dkittell/robotics-code-library/CAD/FTC-FRC/Thingiverse/NotUsing/Aluminiumprofile_Slider___linear_guide_2572864/images/nut8_60x30_100.jpg

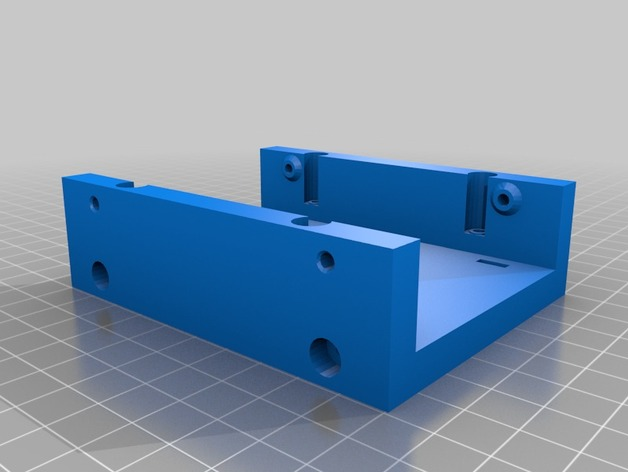
CAD/FTC-FRC/Thingiverse/NotUsing/Aluminiumprofile_Slider___linear_guide_2572864/images/nut8_60x30_100.jpg
