dkittell/robotics-code-library/README.md

# robotics-code-library
Library of code from various years of projects.
