dkittell/robotics-code-library/CAD/FRC/stl/FRC Air Tank Mount - 685037/README.txt

FRC Air Tank Mount by team375 on Thingiverse: https://www.thingiverse.com/thing:685037
