dkittell/robotics-code-library/CAD/FTC-FRC/Thingiverse/NotUsing/8020-1010_M5_T-Nut_2125093/README.txt

8020-1010 M5 T-Nut by dsl145 on Thingiverse: https://www.thingiverse.com/thing:2125093
