dkittell/robotics-code-library/CAD/FTC-FRC/Thingiverse/NotUsing/8020_15-series_bracket_collection_3669194/README.txt

8020 15-series bracket collection by charmed_electron on Thingiverse: https://www.thingiverse.com/thing:3669194
