dkittell/robotics-code-library/CAD/FTC-FRC/Thingiverse/NotUsing/M3_screw_8020_1010_t-slot_109272/README.txt

M3 screw 8020 1010 t-slot by LorenIPSVM on Thingiverse: https://www.thingiverse.com/thing:109272
