dkittell/robotics-code-library/CAD/FTC-FRC/Thingiverse/NotUsing/Parametric_8020_cable_clip_134506/README.txt

Parametric 8020 cable clip by mgx on Thingiverse: https://www.thingiverse.com/thing:134506
