dkittell/robotics-code-library/CAD/FTC-FRC/Thingiverse/Using/8020_Linear_Bearing_1905754/README.txt

8020 Linear Bearing by melwade on Thingiverse: https://www.thingiverse.com/thing:1905754
