dkittell/robotics-code-library/OtherTeams/FRC3535/Java/2021/DriverStation/PowerShell/README.md

# 2021 - Driver Station - PowerShell

## Firewall.ps1
This script has snippets to make it easier to disable the firewall completely or to open ports per the manual.

## FRCTest.ps1
Connect to the robot then run this script to test connectivity to the LimeLight
