dkittell/robotics-code-library/OtherTeams/FRC3535/Java/2021/DriverStation/SmartDashboard/README.md

# 2021 - Driver Station - Smart Dashboard
