dkittell/robotics-code-library/OtherTeams/FRC3535/Java/2021/RobotCode/src/main/java/frc/robot/subsystems/RobotGyro.md

# Robot Subsystems - Gyroscope Documentation
