dkittell/robotics-code-library/CAD/FRC/stl/frc-reefscape-mini-field-model_files/1152199-frc-reefscape-mini-field-b32ba041-0827-4db9-b9d2-5b79e0f91ed6.pdf

## FRC Reefscape Mini Field

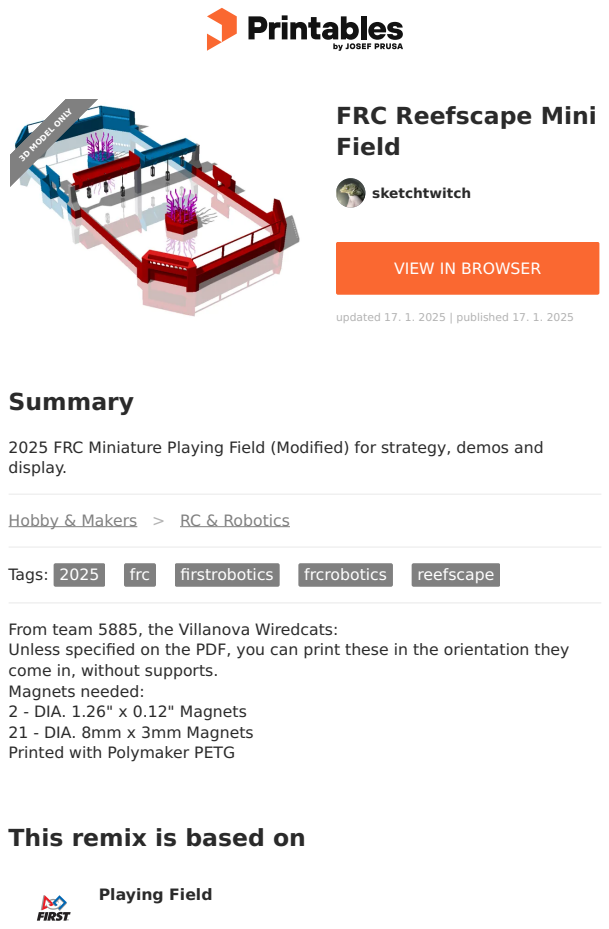
[picture p3: page 1]
Summary; Tags:; frc; firstrobotics; frcrobotics; reefscape; Playing Field; sketchtwitch; updated 17. 1. 2025 | published 17. 1. 2025; 3D MODEL ONLY

VIEW IN BROWSER (https://printables.com/model/1152199-frc-reefscape-mini-field)

2025 FRC Miniature Playing Field (Modified) for strategy, demos and
display.

Hobby & Makers (https://printables.com/model?categoryId=48) > RC & Robotics (https://printables.com/model?categoryId=64)

From team 5885, the Villanova Wiredcats:
Unless specified on the PDF, you can print these in the orientation they
come in, without supports.
Magnets needed:
2 - DIA. 1.26" x 0.12" Magnets
21 - DIA. 8mm x 3mm Magnets
Printed with Polymaker PETG

This remix is based on

## Model files

center-post.stl

plain-wall.stl

reef-structure.stl

deep-climb.stl

shallow-climb.stl

processor-wall.stl

driver-station-top.stl

cage.stl

reef-base.stl

## Other files

## License

This work is licensed under a
Creative Commons (4.0 International License)

Attribution (http://creativecommons.org/licenses/by/4.0/)

outer-post.stl

driver-human-station.stl

barge.stl

2025frc-fullfield.stp

algae.step

coral.stp

frc-2025-3dp-field-parts-bom.pdf

✖ | Sharing without ATTRIBUTION
✔ | Remix Culture allowed
✔ | Commercial Use
✔ | Free Cultural Works
✔ | Meets Open Definition
