dkittell/robotics-code-library/CAD/Fusion3/Documentation/Fusion3 730 Day (2 Year) Warranty (International - excluding US & Canada).pdf

### Fusion3 730 Day (2 Year) Limited Warranty (International – excluding US & Canada)

Fusion3 Design (“Fusion3”) manufactures its hardware products from parts and components that are new or equivalent to new in accordance with industry-standard practices. Fusion3 warrants that the hardware products it manufactures will be free from defects in materials and workmanship. The limited warranty term is 730-days beginning on the date of invoice, as further described in the following text.

Damage due to shipping the products to you is covered under this limited warranty, but only when Fusion3 is shipping the item under its own account. The buyer or its agents are responsible for any damage for orders that are ‘picked up’ from Fusion3 using your own method of shipment, including employee vehicle or under the buyer or its agent’s own shipping accounts.

Otherwise, this limited warranty does not cover damage due to external causes, including accident, abuse, misuse, problems with electrical power, servicing not authorized by Fusion3, usage not in accordance with product instructions, failure to perform required preventive maintenance, and problems caused by use of parts and components not supplied by Fusion3.

Due to wide variations in quality and performance of 3rd party filaments, customer agrees to only use certified materials supplies sold / provided by Fusion3 or Fusion3 approved 3rd parties as designated at (http://www.fusion3design.com/). Failure to use approved supplies may void this Limited Warranty at Fusion3’s discretion.

This limited warranty does not cover any items that are in one or more of the following categories: software; external devices (except as specifically noted); accessories or parts added to a Fusion3 system after the system is shipped from Fusion3; accessories or parts added to a Fusion3 system through Fusion3's system integration department; accessories or parts that are not installed in the Fusion3 factory.

During the seven-hundred and thirty (730) day period beginning on the invoice date, Fusion3 will provide replacement parts or in the event of complete failure, replace products covered under this limited warranty that are returned to Fusion3's facility. To request limited warranty service, you must contact Fusion3's Customer Technical Support within the limited warranty period. Refer to the chapter titled "Getting Help" or "Contacting Fusion3" in your documentation to find the appropriate telephone number or email address for obtaining customer assistance. While contacting Fusion3’s Customer Technical Support, you must assist our representatives in diagnosing the nature of the problems you have encountered.

If limited warranty repair of a component(s) is/are warranted, Fusion3 will issue a Return Material Authorization. You must ship the component(s) back to Fusion3, prepay shipping charges, and insure the shipment or accept the risk of loss or damage during shipment. Fusion3 will ship the repaired or replacement components to you freight prepaid to your address, where applicable.

This limited warranty does not cover replacement of the entire printer, due to the excessive cost and time. If your 3D printer is inoperable and you think it may require repair and/or replacement, please contact Fusion3 Technical Support to discuss youroptions.

THIS LIMITED WARRANTY GIVES YOU SPECIFIC LEGAL RIGHTS, AND YOU MAY ALSO HAVE OTHER RIGHTS THAT VARY FROM STATE TO STATE (OR JURISDICTION TO JURISDICTION). FUSION3'S RESPONSIBILITY FOR MALFUNCTIONS AND DEFECTS IN HARDWARE IS LIMITED TO REPAIR AND REPLACEMENT AS SET FORTH IN THIS LIMITED WARRANTY STATEMENT. ALL EXPRESS AND IMPLIED WARRANTIES FOR THE PRODUCT,

INCLUDING BUT NOT LIMITED TO ANY IMPLIED WARRANTIES OF AND CONDITIONS OF MERCHANTABILITY AND FITNESS FOR A PARTICULAR PURPOSE, ARE LIMITED IN DURATION TO THE LIMITED WARRANTY PERIOD SET FORTH ABOVE AND NO WARRANTIES, WHETHER EXPRESS OR IMPLIED, WILL APPLY AFTER SUCH PERIOD. SOME STATES (OR JURISDICTIONS) DO NOT ALLOW LIMITATIONS ON HOW LONG AN IMPLIED WARRANTY LASTS, SO THE ABOVE LIMITATION MAY NOT APPLY TO YOU.

FUSION3 DOES NOT ACCEPT LIABILITY BEYOND THE REMEDIES SET FORTH IN THIS LIMITED WARRANTY STATEMENT OR LIABILITY FOR INCIDENTAL OR CONSEQUENTIAL DAMAGES, INCLUDING WITHOUT LIMITATION ANY LIABILITY FOR PRODUCTS NOT BEING AVAILABLE FOR USE OR FOR LOST DATA OR SOFTWARE. SOME STATES (OR JURISDICTIONS) DO NOT ALLOW THE EXCLUSION OR LIMITATION OF INCIDENTAL OR CONSEQUENTIAL DAMAGES, SO THE ABOVE EXCLUSION OR LIMITATION MAY NOT APPLY TO YOU.

These provisions apply to Fusion3's 730-day limited warranty only. For provisions of any on-site service contract covering your system, refer to the separate on-site service contract that you will receive.
