dkittell/robotics-code-library/CAD/FLL/First Lego League/images/5d23d9d94773eebba6f74a4968ead99a.png

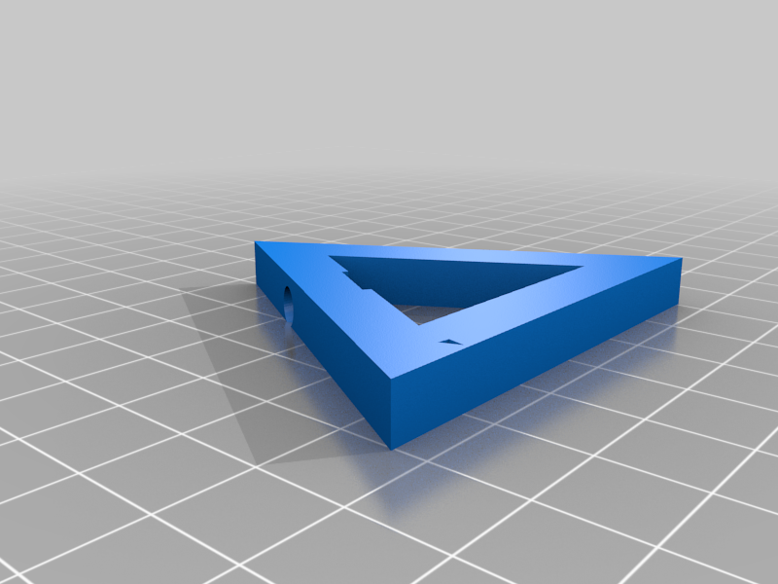
CAD/FLL/First Lego League/images/5d23d9d94773eebba6f74a4968ead99a.png
