dkittell/robotics-code-library/CAD/FLL/First Lego League/images/5281b6386f19d4964084c459d251a975.png

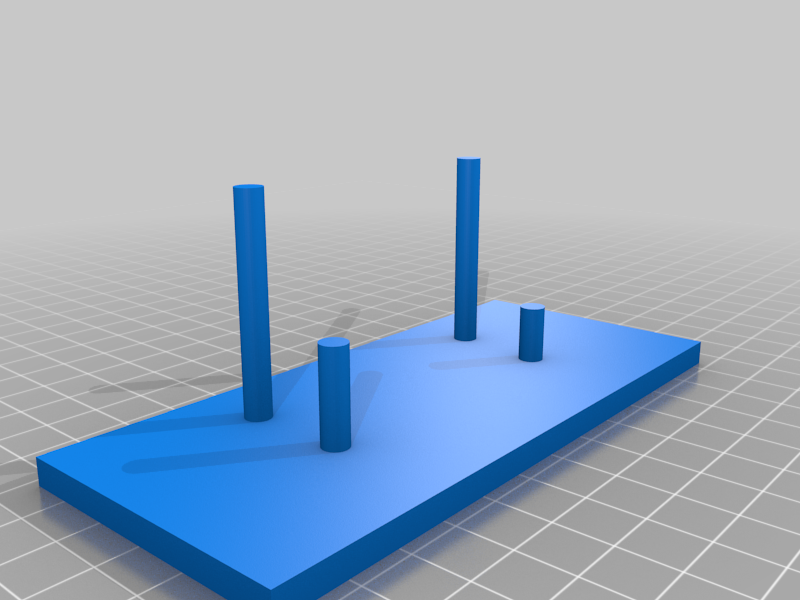
CAD/FLL/First Lego League/images/5281b6386f19d4964084c459d251a975.png
