dkittell/robotics-code-library/CAD/FLL/First Lego League/images/9974fa4f326412b617aa970d340b4837.png

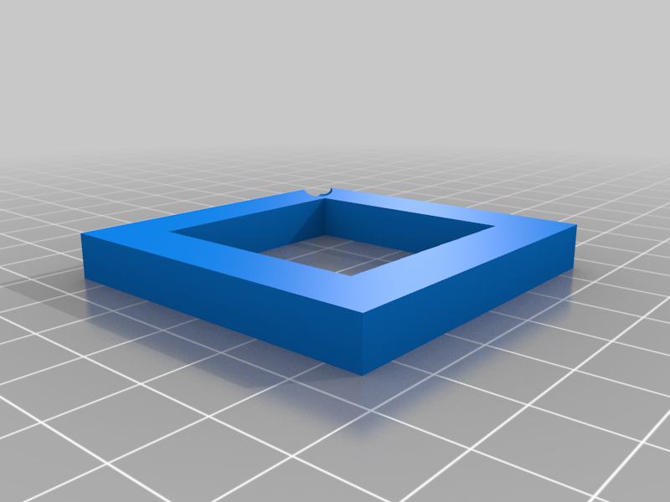
CAD/FLL/First Lego League/images/9974fa4f326412b617aa970d340b4837.png
