dkittell/robotics-code-library/CAD/FLL/First Lego League/images/85277ac9e323428b7418d7512f78a58d.png

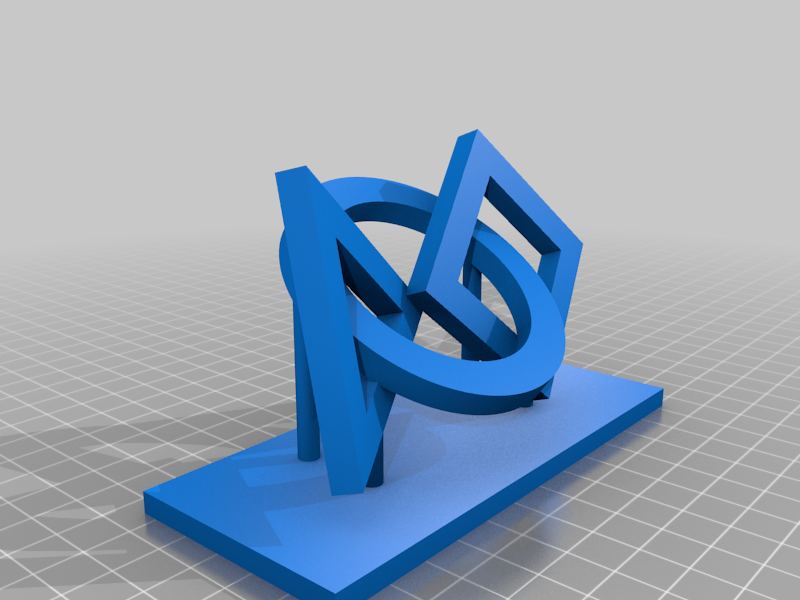
CAD/FLL/First Lego League/images/85277ac9e323428b7418d7512f78a58d.png
