dkittell/robotics-code-library/CAD/FLL/First Lego League/images/ab05e862658e3efc641332ba58ae61dd.png

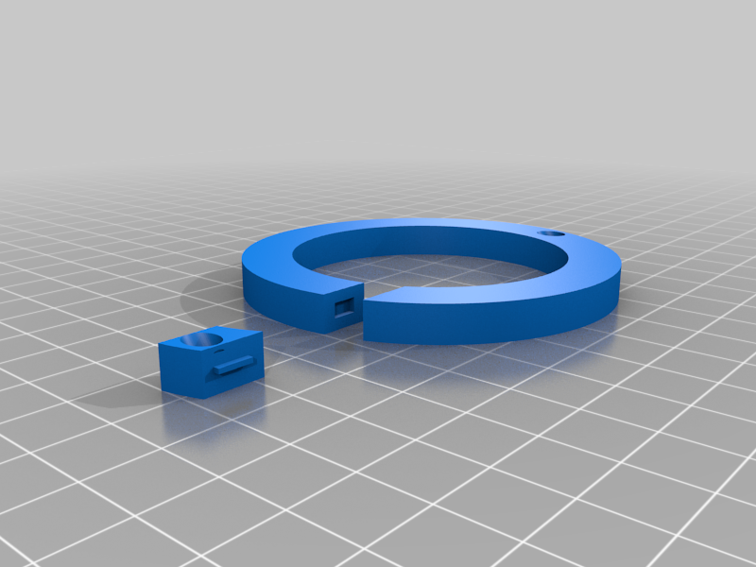
CAD/FLL/First Lego League/images/ab05e862658e3efc641332ba58ae61dd.png
