dkittell/robotics-code-library/CAD/FLL/First Lego League/images/FLL-3D.png

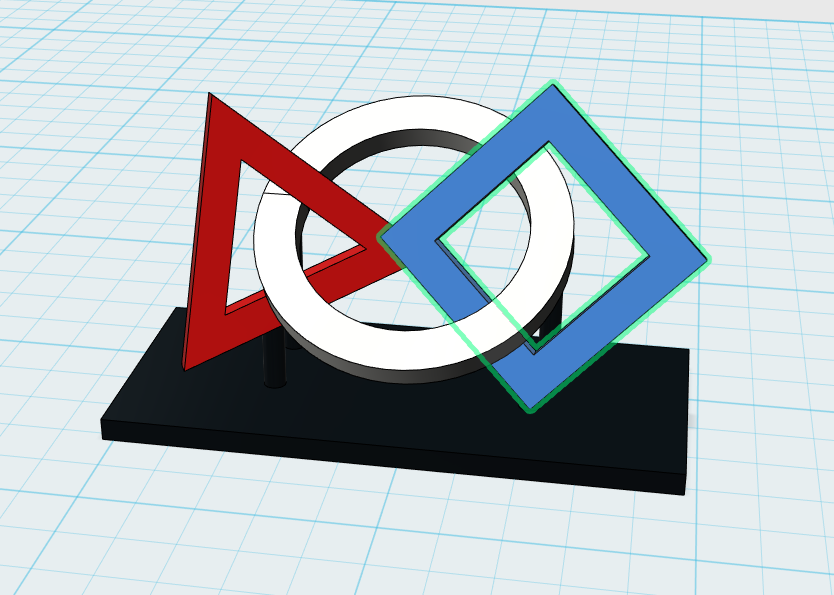
CAD/FLL/First Lego League/images/FLL-3D.png
