dkittell/robotics-code-library/CAD/FRC/stl/FRC Air Tank Mount - 685037/images/IMG_3710.JPG

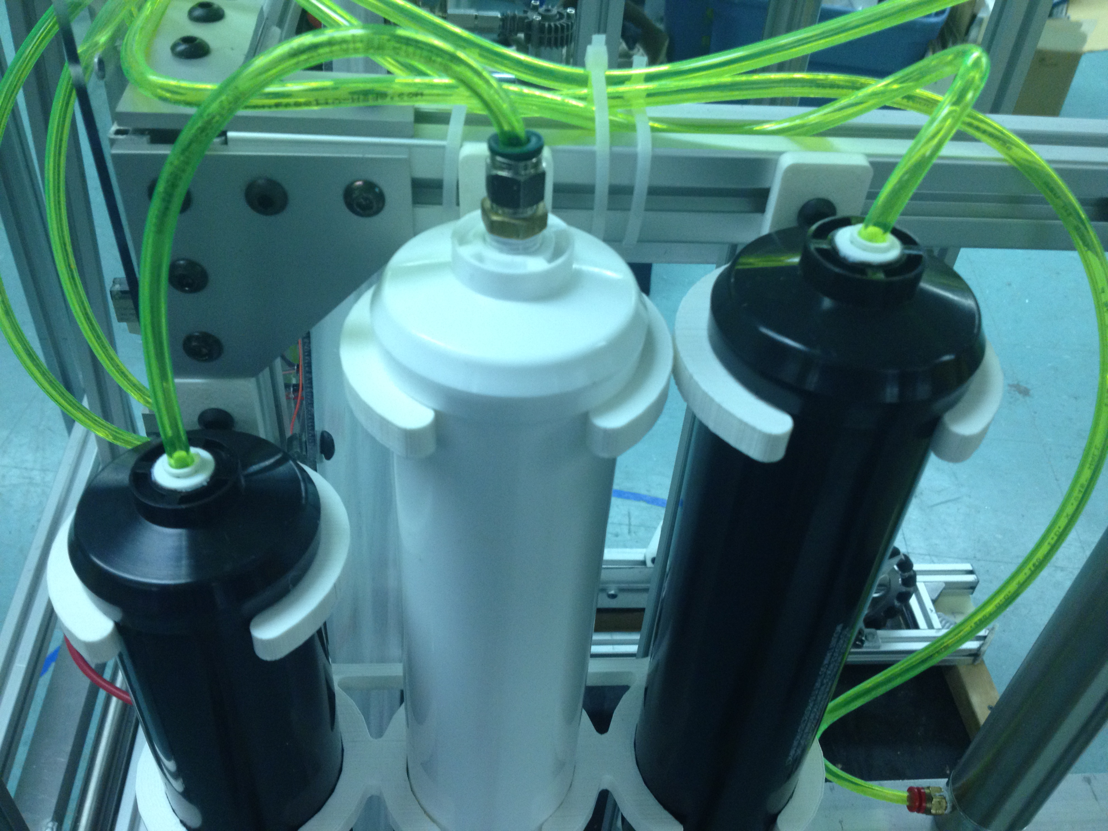
CAD/FRC/stl/FRC Air Tank Mount - 685037/images/IMG_3710.JPG
