dkittell/robotics-code-library/CAD/FRC/stl/FRC Air Tank Mount - 685037/images/Tank_Mount_Triple.png

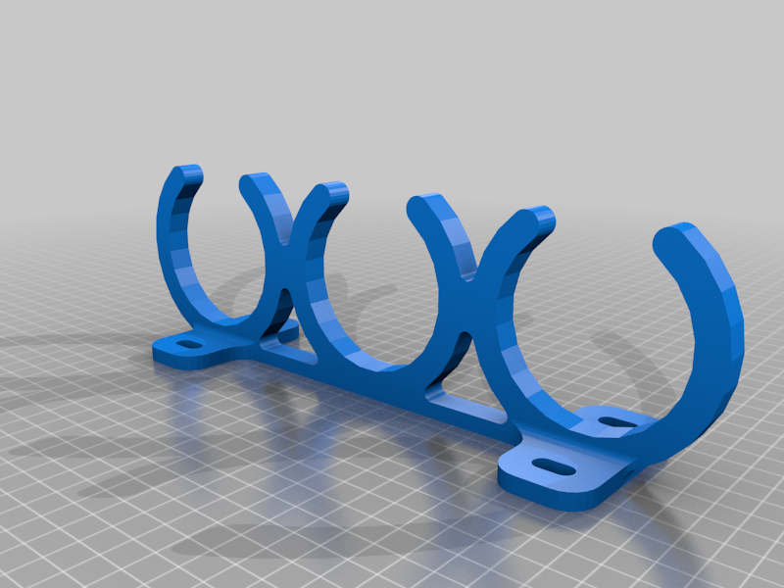
CAD/FRC/stl/FRC Air Tank Mount - 685037/images/Tank_Mount_Triple.png
