dkittell/robotics-code-library/CAD/FRC/stl/Frc Breaker Shroud V2 - 6515696/images/6f026f2f-a37d-400d-a171-c4336e513012.png

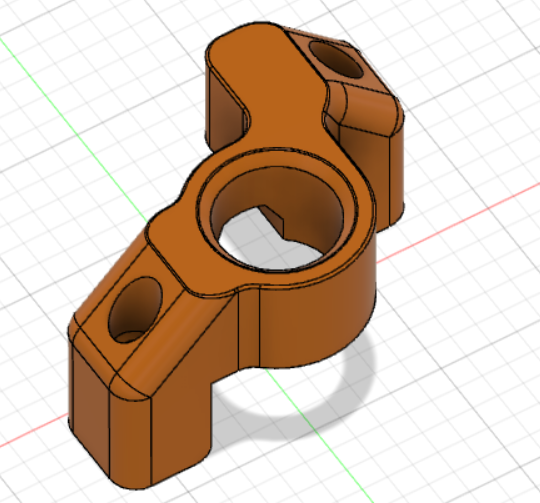
CAD/FRC/stl/Frc Breaker Shroud V2 - 6515696/images/6f026f2f-a37d-400d-a171-c4336e513012.png
