dkittell/robotics-code-library/CAD/FRC/stl/Frc Breaker Shroud V2 - 6515696/images/30ba9aaa-a176-4fdd-935f-7f784fa1dd0f.png

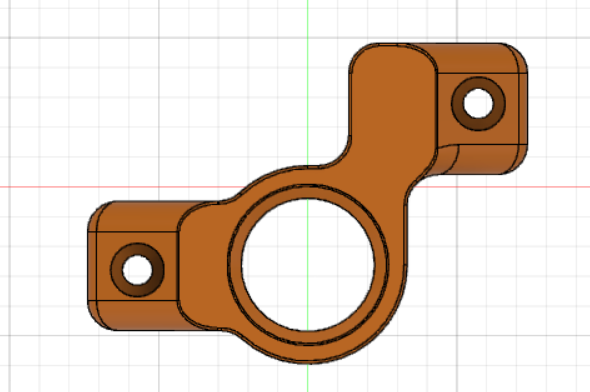
CAD/FRC/stl/Frc Breaker Shroud V2 - 6515696/images/30ba9aaa-a176-4fdd-935f-7f784fa1dd0f.png
