dkittell/robotics-code-library/CAD/FRC/stl/Frc Breaker Shroud V2 - 6515696/images/c0bd5061-7573-4192-95d4-70345174beeb.png

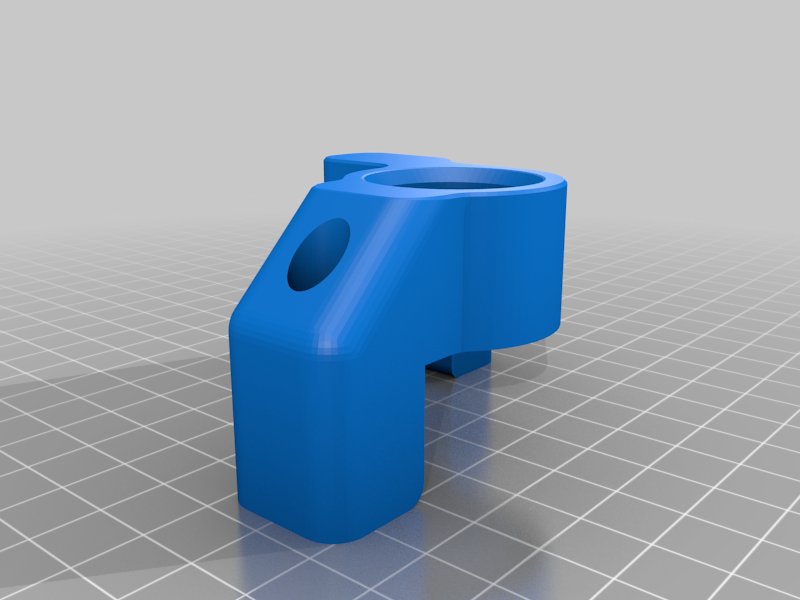
CAD/FRC/stl/Frc Breaker Shroud V2 - 6515696/images/c0bd5061-7573-4192-95d4-70345174beeb.png
