dkittell/robotics-code-library/CAD/FRC/stl/Frc Breaker Shroud V2 - 6515696/images/df26487e-1ffa-40cd-b413-dfab75303f88.png

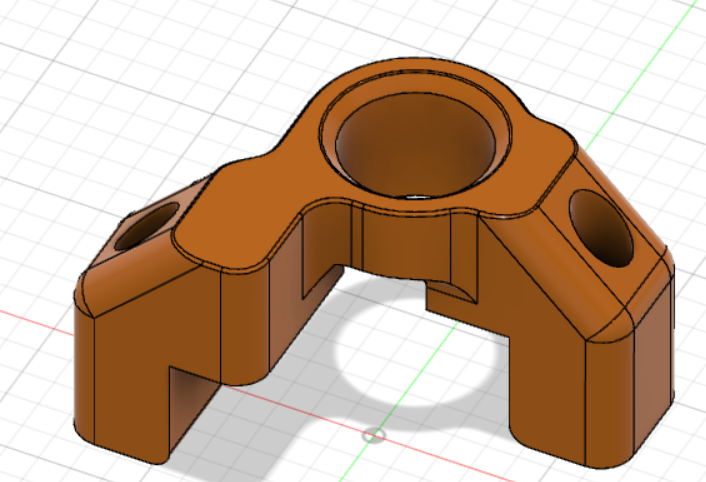
CAD/FRC/stl/Frc Breaker Shroud V2 - 6515696/images/df26487e-1ffa-40cd-b413-dfab75303f88.png
