dkittell/robotics-code-library/CAD/FTC-FRC/GrabCAD/NotUsing/ftc-hanging-mechanism-1.snapshot.1/Linear Actuator2.jpg

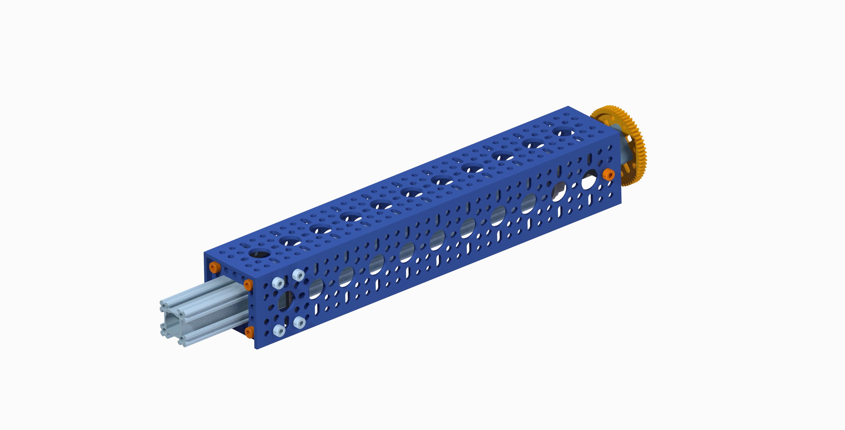
CAD/FTC-FRC/GrabCAD/NotUsing/ftc-hanging-mechanism-1.snapshot.1/Linear Actuator2.jpg
