dkittell/robotics-code-library/CAD/FTC-FRC/GrabCAD/NotUsing/linear-belt-slider-2gt-1.snapshot.2/Cattura5.PNG

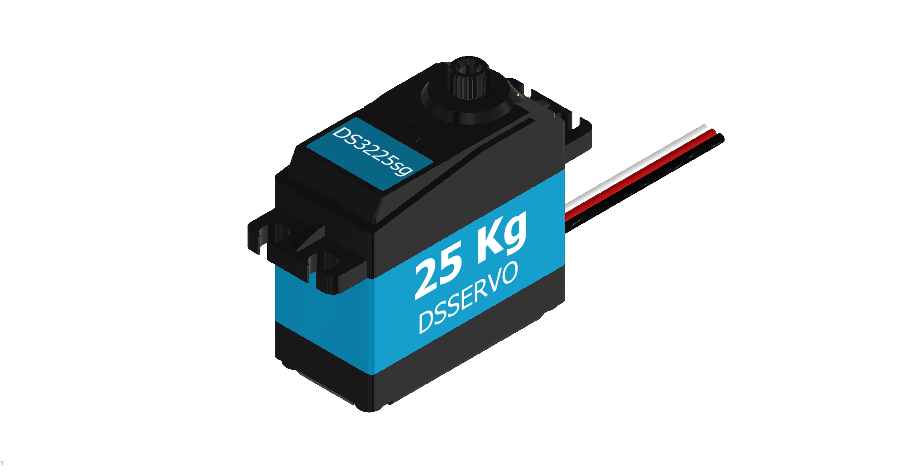
CAD/FTC-FRC/GrabCAD/NotUsing/linear-belt-slider-2gt-1.snapshot.2/Cattura5.PNG
