dkittell/robotics-code-library/CAD/FTC-FRC/Thingiverse/NotUsing/8020-1010_M5_T-Nut_2125093/images/44d64007e2b00da8af8de5ab1d44dde8.JPG

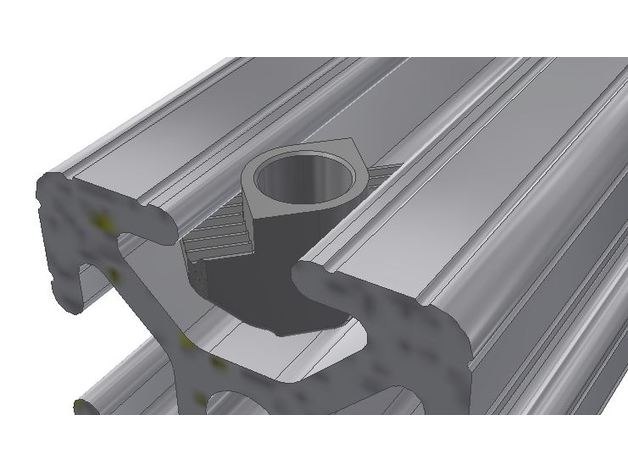
CAD/FTC-FRC/Thingiverse/NotUsing/8020-1010_M5_T-Nut_2125093/images/44d64007e2b00da8af8de5ab1d44dde8.JPG
