dkittell/robotics-code-library/CAD/FTC-FRC/Thingiverse/NotUsing/8020-1010_M5_T-Nut_2125093/images/70d130d58ec38eb446afbb33c705d904.JPG

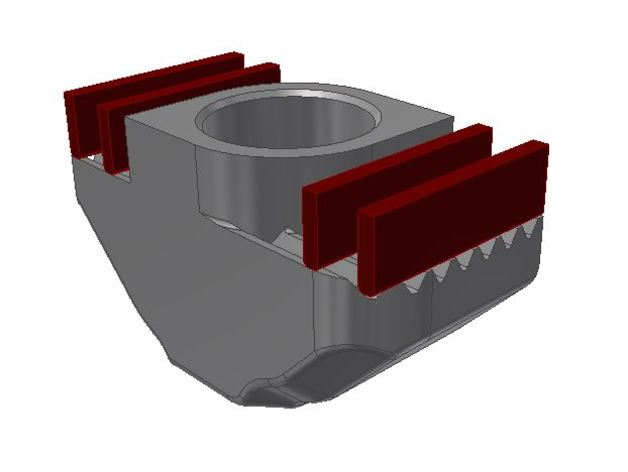
CAD/FTC-FRC/Thingiverse/NotUsing/8020-1010_M5_T-Nut_2125093/images/70d130d58ec38eb446afbb33c705d904.JPG
