dkittell/robotics-code-library/CAD/FTC-FRC/Thingiverse/NotUsing/8020-1010_M5_T-Nut_2125093/images/c87f8d69f561422b637c0812f996990a.JPG

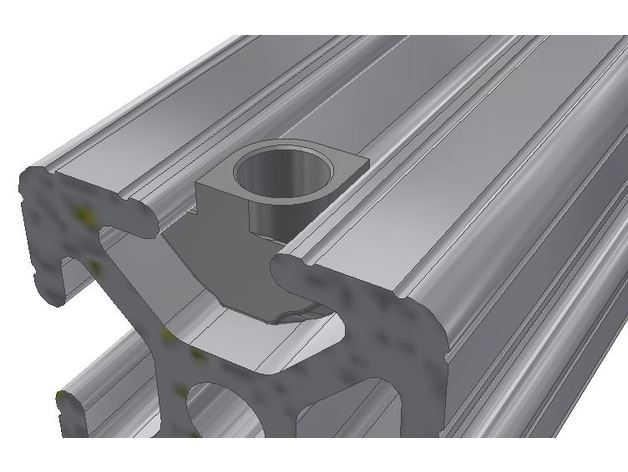
CAD/FTC-FRC/Thingiverse/NotUsing/8020-1010_M5_T-Nut_2125093/images/c87f8d69f561422b637c0812f996990a.JPG
