dkittell/robotics-code-library/CAD/FTC-FRC/Thingiverse/NotUsing/8020-1010_M5_T-Nut_2125093/images/fac44cfc86bc34edb703755a5642ca65.JPG

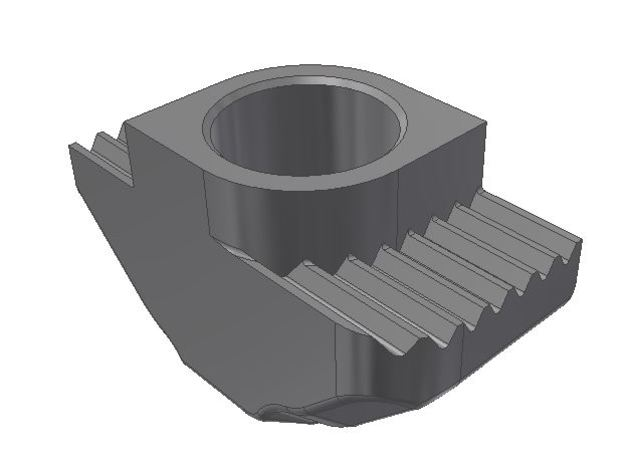
CAD/FTC-FRC/Thingiverse/NotUsing/8020-1010_M5_T-Nut_2125093/images/fac44cfc86bc34edb703755a5642ca65.JPG
