dkittell/robotics-code-library/CAD/FTC-FRC/Thingiverse/NotUsing/8020-1010_M5_T-Nut_2125093/images/T-Nut.jpg

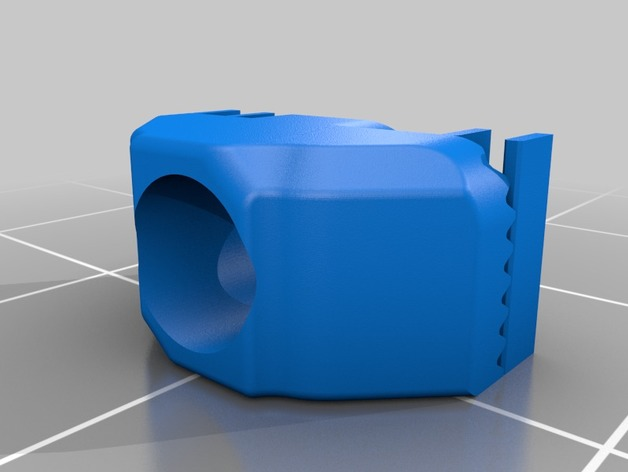
CAD/FTC-FRC/Thingiverse/NotUsing/8020-1010_M5_T-Nut_2125093/images/T-Nut.jpg
