dkittell/robotics-code-library/CAD/FTC-FRC/Thingiverse/NotUsing/8020_15-series_bracket_collection_3669194/images/8020_15-series_2-hole_T-nut_1_4-20_tap.jpg

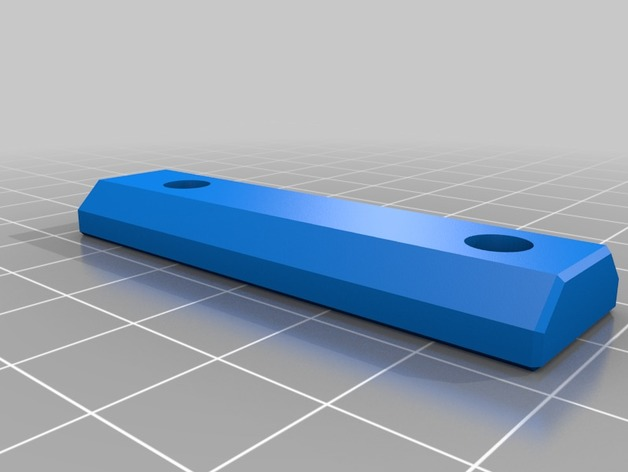
CAD/FTC-FRC/Thingiverse/NotUsing/8020_15-series_bracket_collection_3669194/images/8020_15-series_2-hole_T-nut_1_4-20_tap.jpg
