dkittell/robotics-code-library/CAD/FTC-FRC/Thingiverse/NotUsing/8020_15-series_bracket_collection_3669194/images/8020_4302_2-hole_corner_bracket.jpg

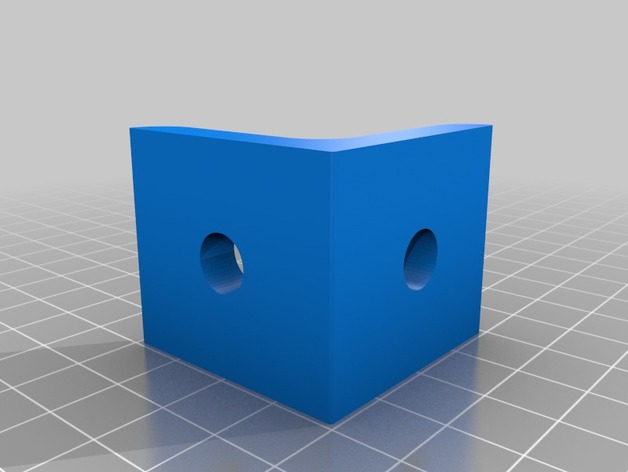
CAD/FTC-FRC/Thingiverse/NotUsing/8020_15-series_bracket_collection_3669194/images/8020_4302_2-hole_corner_bracket.jpg
