dkittell/robotics-code-library/CAD/FTC-FRC/Thingiverse/NotUsing/8020_1515_bar_3663471/images/8020_1515_1in.jpg

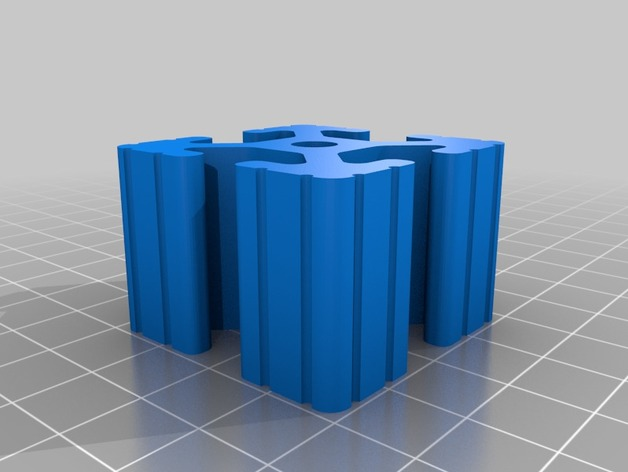
CAD/FTC-FRC/Thingiverse/NotUsing/8020_1515_bar_3663471/images/8020_1515_1in.jpg
