dkittell/robotics-code-library/CAD/FTC-FRC/Thingiverse/NotUsing/8020_1515_bar_3663471/images/103701b55f6ffdc8077760f1c2976403.jpg

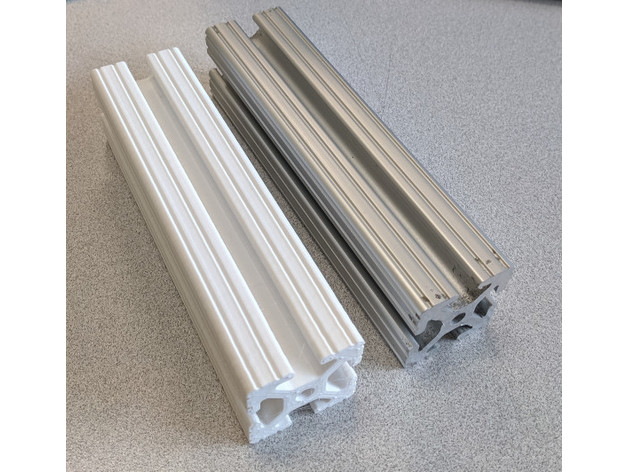
CAD/FTC-FRC/Thingiverse/NotUsing/8020_1515_bar_3663471/images/103701b55f6ffdc8077760f1c2976403.jpg
