dkittell/robotics-code-library/CAD/FTC-FRC/Thingiverse/NotUsing/Adjustable_2020_PTFE_Slider_1721338/images/6ae47d87494f0d213c3a8c3767289d0c.JPG

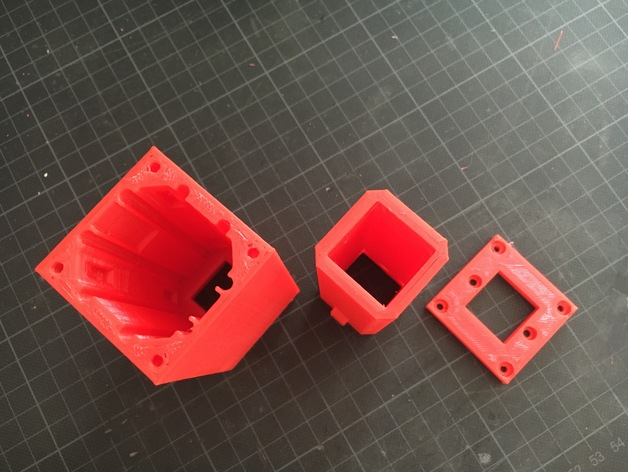
CAD/FTC-FRC/Thingiverse/NotUsing/Adjustable_2020_PTFE_Slider_1721338/images/6ae47d87494f0d213c3a8c3767289d0c.JPG
