dkittell/robotics-code-library/CAD/FTC-FRC/Thingiverse/NotUsing/Adjustable_2020_PTFE_Slider_1721338/images/6c0c1f076c5430cb3cd3e4b6a44aee47.JPG

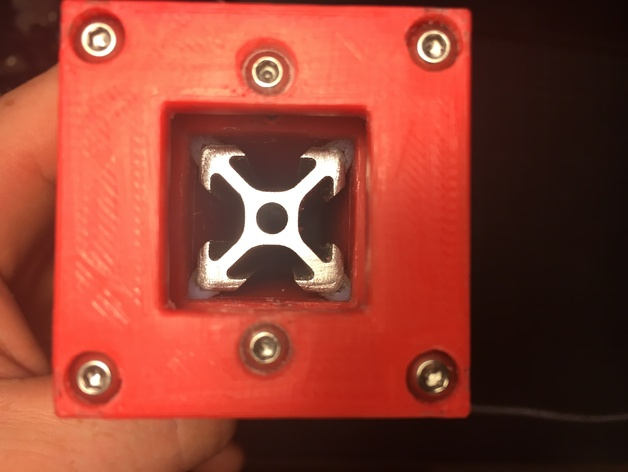
CAD/FTC-FRC/Thingiverse/NotUsing/Adjustable_2020_PTFE_Slider_1721338/images/6c0c1f076c5430cb3cd3e4b6a44aee47.JPG
