dkittell/robotics-code-library/CAD/FTC-FRC/Thingiverse/NotUsing/Adjustable_2020_PTFE_Slider_1721338/images/58a619c154c79a5835e57646d32341c2.JPG

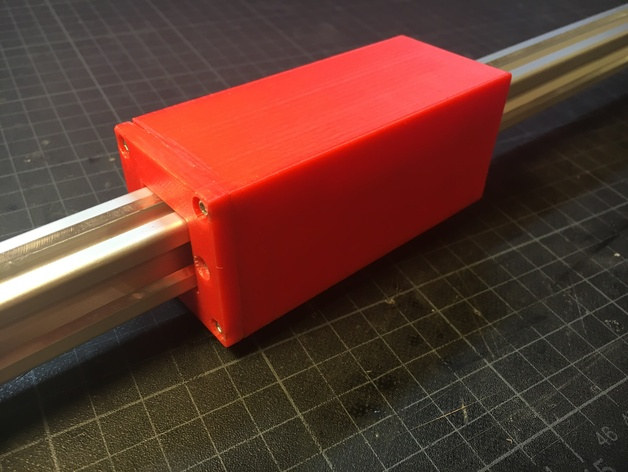
CAD/FTC-FRC/Thingiverse/NotUsing/Adjustable_2020_PTFE_Slider_1721338/images/58a619c154c79a5835e57646d32341c2.JPG
