dkittell/robotics-code-library/CAD/FTC-FRC/Thingiverse/NotUsing/Adjustable_2020_PTFE_Slider_1721338/images/2020_Adj._Slider_Body.jpg

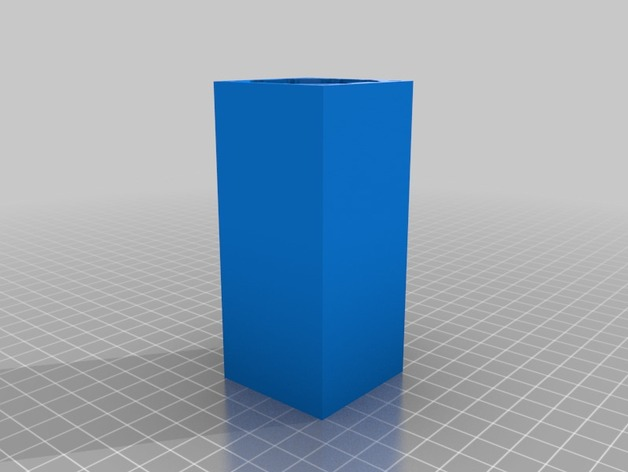
CAD/FTC-FRC/Thingiverse/NotUsing/Adjustable_2020_PTFE_Slider_1721338/images/2020_Adj._Slider_Body.jpg
