dkittell/robotics-code-library/CAD/FTC-FRC/Thingiverse/NotUsing/Adjustable_2020_PTFE_Slider_1721338/images/9581af6f71dcad13848133bcf8244c9f.JPG

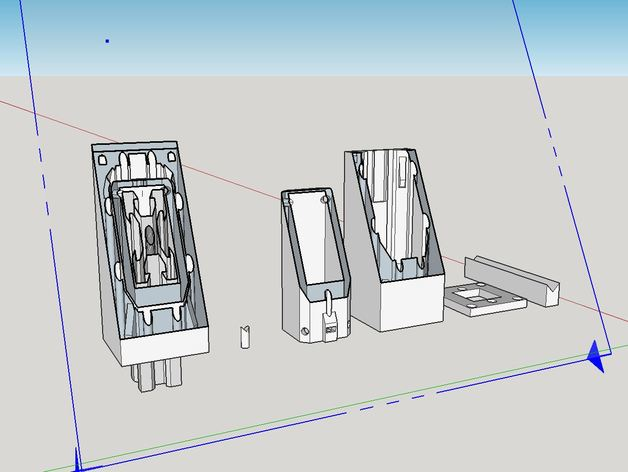
CAD/FTC-FRC/Thingiverse/NotUsing/Adjustable_2020_PTFE_Slider_1721338/images/9581af6f71dcad13848133bcf8244c9f.JPG
