dkittell/robotics-code-library/CAD/FTC-FRC/Thingiverse/NotUsing/Adjustable_2020_PTFE_Slider_1721338/images/c2787cb6a22ec8be3afefe8b3c8b1c9d.JPG

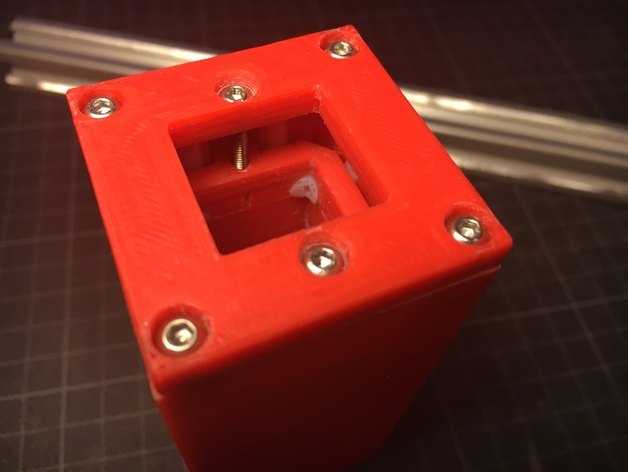
CAD/FTC-FRC/Thingiverse/NotUsing/Adjustable_2020_PTFE_Slider_1721338/images/c2787cb6a22ec8be3afefe8b3c8b1c9d.JPG
