dkittell/robotics-code-library/CAD/FTC-FRC/Thingiverse/NotUsing/M3_screw_8020_1010_t-slot_109272/images/tslot_profile_2.jpg

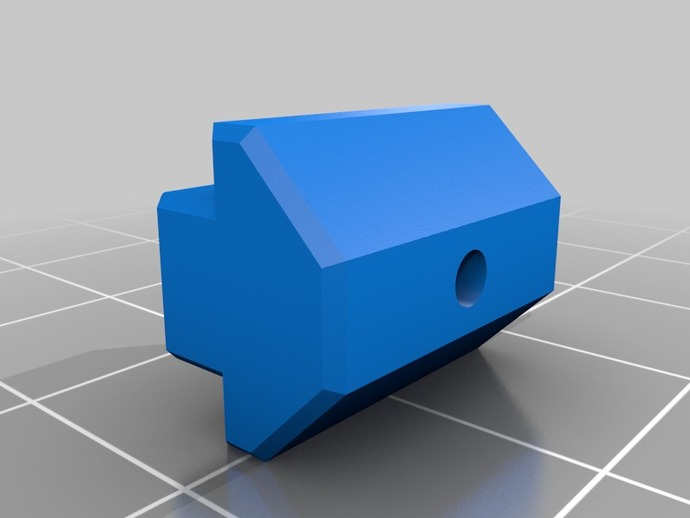
CAD/FTC-FRC/Thingiverse/NotUsing/M3_screw_8020_1010_t-slot_109272/images/tslot_profile_2.jpg
