dkittell/robotics-code-library/CAD/FTC-FRC/Thingiverse/NotUsing/Parametric_8020_cable_clip_134506/images/8020_cable_cover.jpg

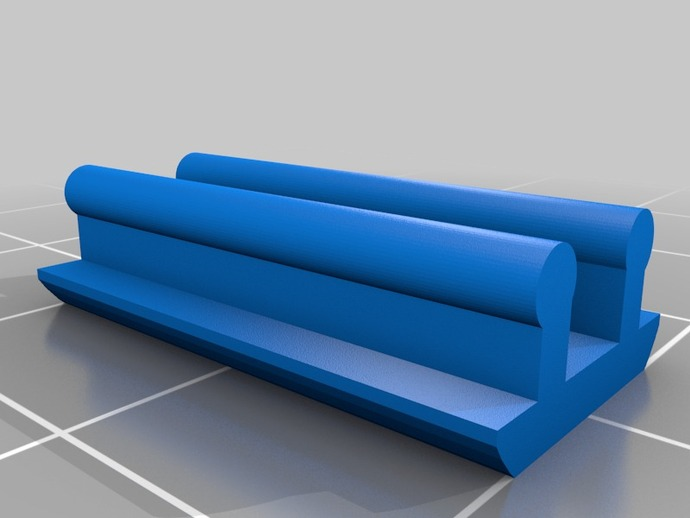
CAD/FTC-FRC/Thingiverse/NotUsing/Parametric_8020_cable_clip_134506/images/8020_cable_cover.jpg
