dkittell/robotics-code-library/CAD/FTC-FRC/Thingiverse/NotUsing/Parametric_8020_cable_clip_134506/images/_MG_9214.jpg

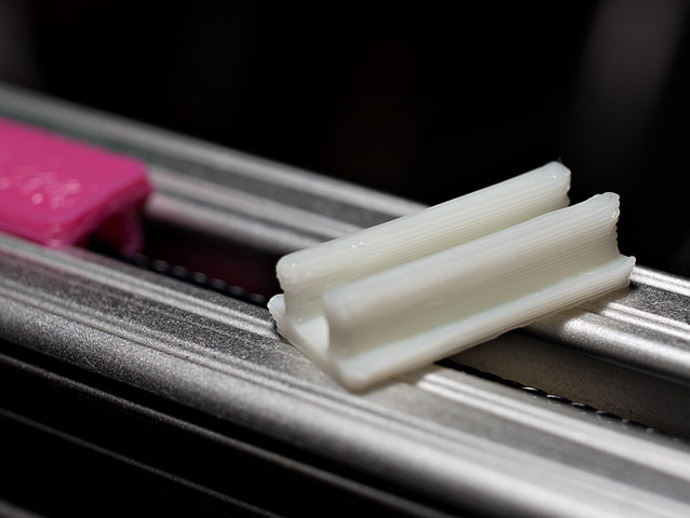
CAD/FTC-FRC/Thingiverse/NotUsing/Parametric_8020_cable_clip_134506/images/_MG_9214.jpg
