dkittell/robotics-code-library/CAD/FTC-FRC/Thingiverse/NotUsing/Snap-in_Spool_Holder_for_8020__604530/images/_MG_2045.jpg

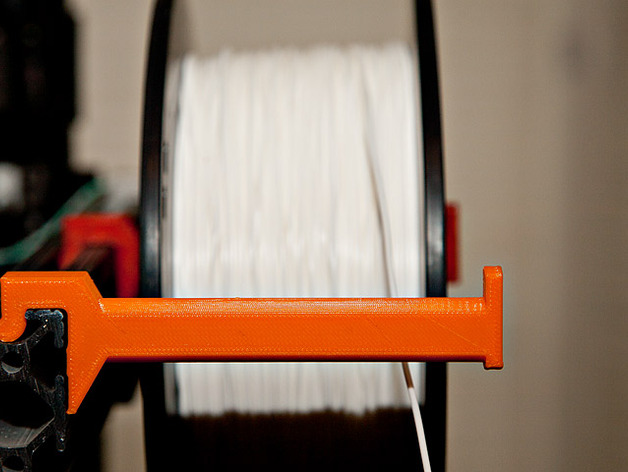
CAD/FTC-FRC/Thingiverse/NotUsing/Snap-in_Spool_Holder_for_8020__604530/images/_MG_2045.jpg
