dkittell/robotics-code-library/CAD/FTC-FRC/Thingiverse/Using/8020_Linear_Bearing_1905754/images/4dc14e7df4de29eaa03d17af7f6bb963.jpg

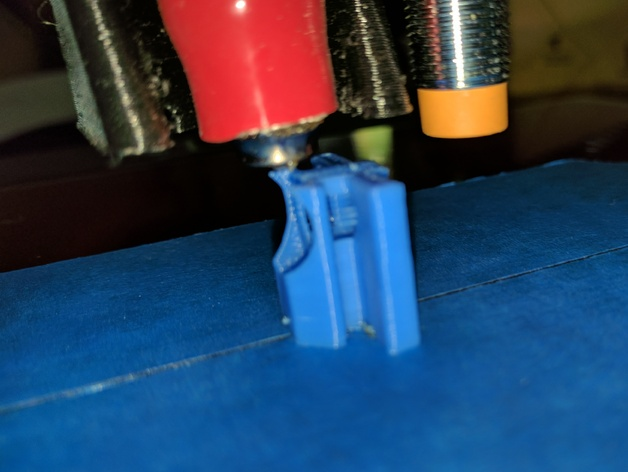
CAD/FTC-FRC/Thingiverse/Using/8020_Linear_Bearing_1905754/images/4dc14e7df4de29eaa03d17af7f6bb963.jpg
