dkittell/robotics-code-library/CAD/FTC-FRC/Thingiverse/Using/8020_Linear_Bearing_1905754/images/25bd65da722becac48c226834ec730f9.jpg

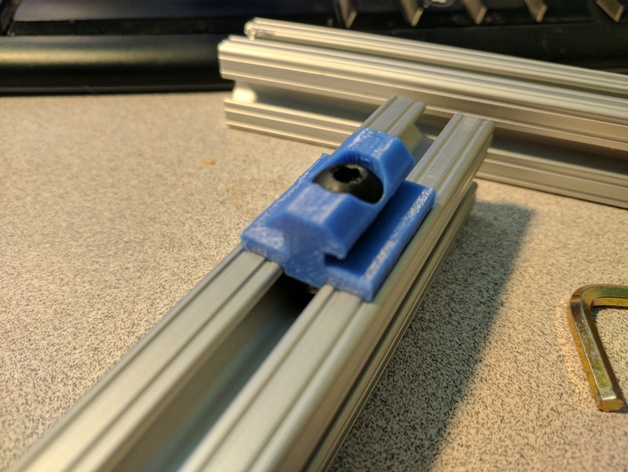
CAD/FTC-FRC/Thingiverse/Using/8020_Linear_Bearing_1905754/images/25bd65da722becac48c226834ec730f9.jpg
