dkittell/robotics-code-library/CAD/FTC-FRC/Thingiverse/Using/8020_Linear_Bearing_1905754/images/610ae7847e2564625efd09eab077c368.jpg

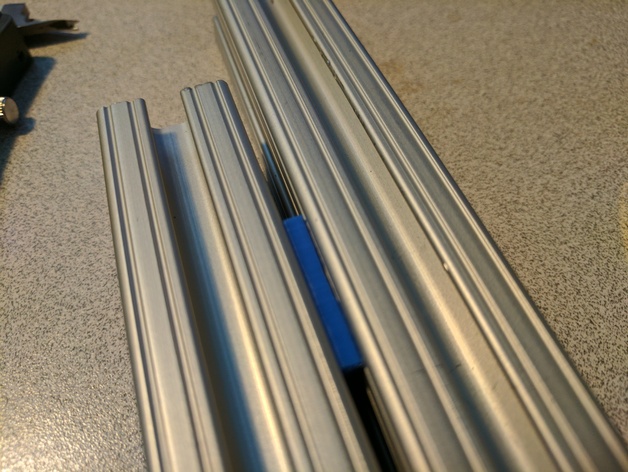
CAD/FTC-FRC/Thingiverse/Using/8020_Linear_Bearing_1905754/images/610ae7847e2564625efd09eab077c368.jpg
