dkittell/robotics-code-library/CAD/FTC-FRC/Thingiverse/Using/8020_Linear_Bearing_1905754/images/607906f5f797d9295f83f39d39363275.jpg

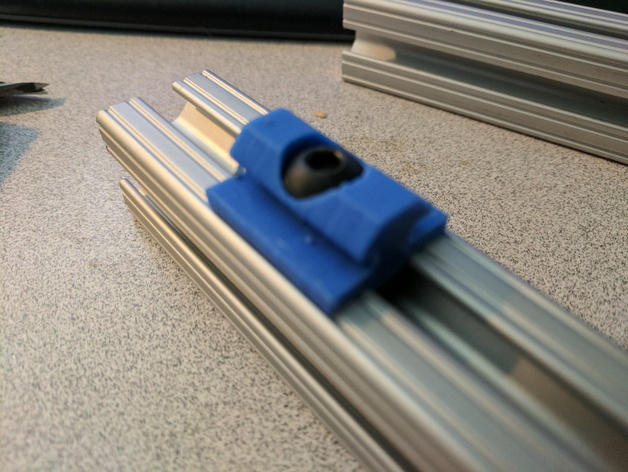
CAD/FTC-FRC/Thingiverse/Using/8020_Linear_Bearing_1905754/images/607906f5f797d9295f83f39d39363275.jpg
