dkittell/robotics-code-library/CAD/FTC-FRC/Thingiverse/Using/8020_Linear_Bearing_1905754/images/ae649a4cd68434b1f316651b4a3b1a8d.jpg

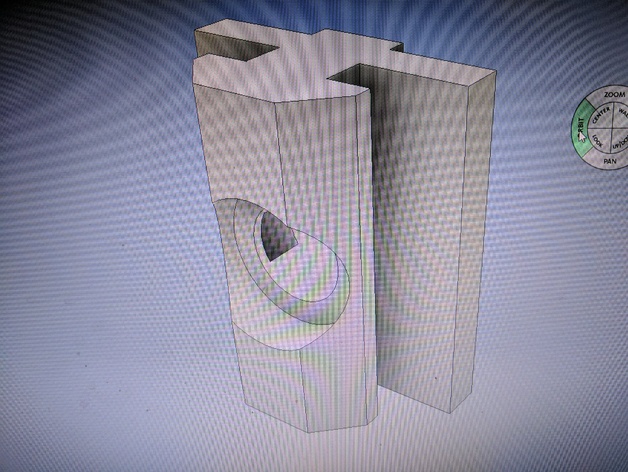
CAD/FTC-FRC/Thingiverse/Using/8020_Linear_Bearing_1905754/images/ae649a4cd68434b1f316651b4a3b1a8d.jpg
