dkittell/robotics-code-library/FRC/Cura_Profiles/MACHINE SETTINGS.jpg

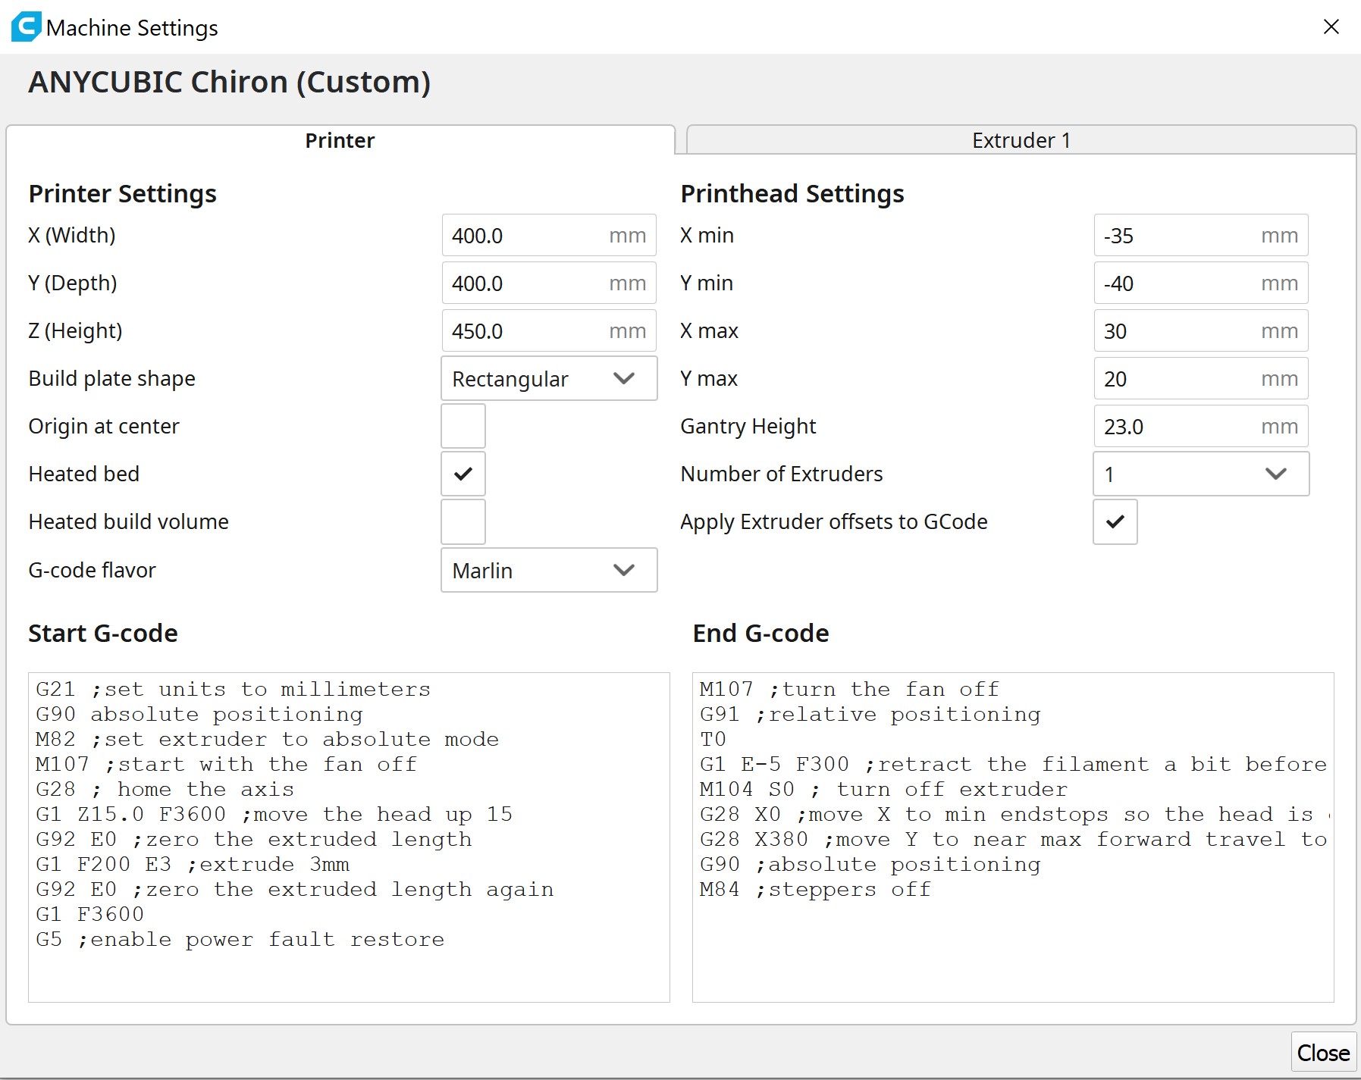
FRC/Cura_Profiles/MACHINE SETTINGS.jpg
