dkittell/robotics-code-library/FTC/2021/Block/Auton/5Motors1Servo.png

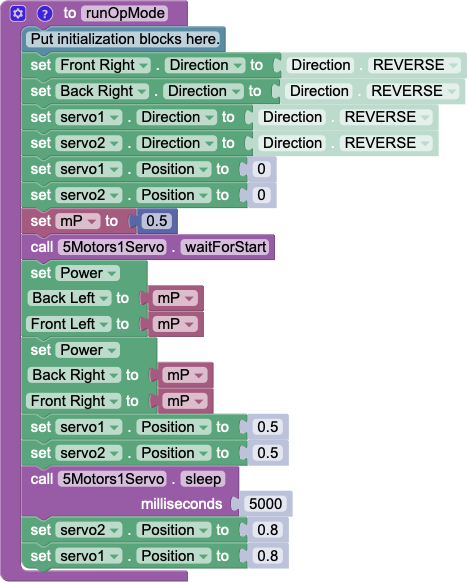
FTC/2021/Block/Auton/5Motors1Servo.png
