dkittell/robotics-code-library/FTC/2021/Block/Auton/5Motors2Servos.png

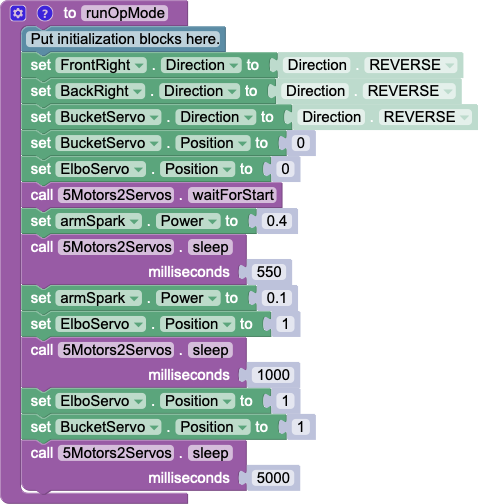
FTC/2021/Block/Auton/5Motors2Servos.png
