dkittell/robotics-code-library/FTC/2021/Block/Auton/Auton-Red-Warehouse.png

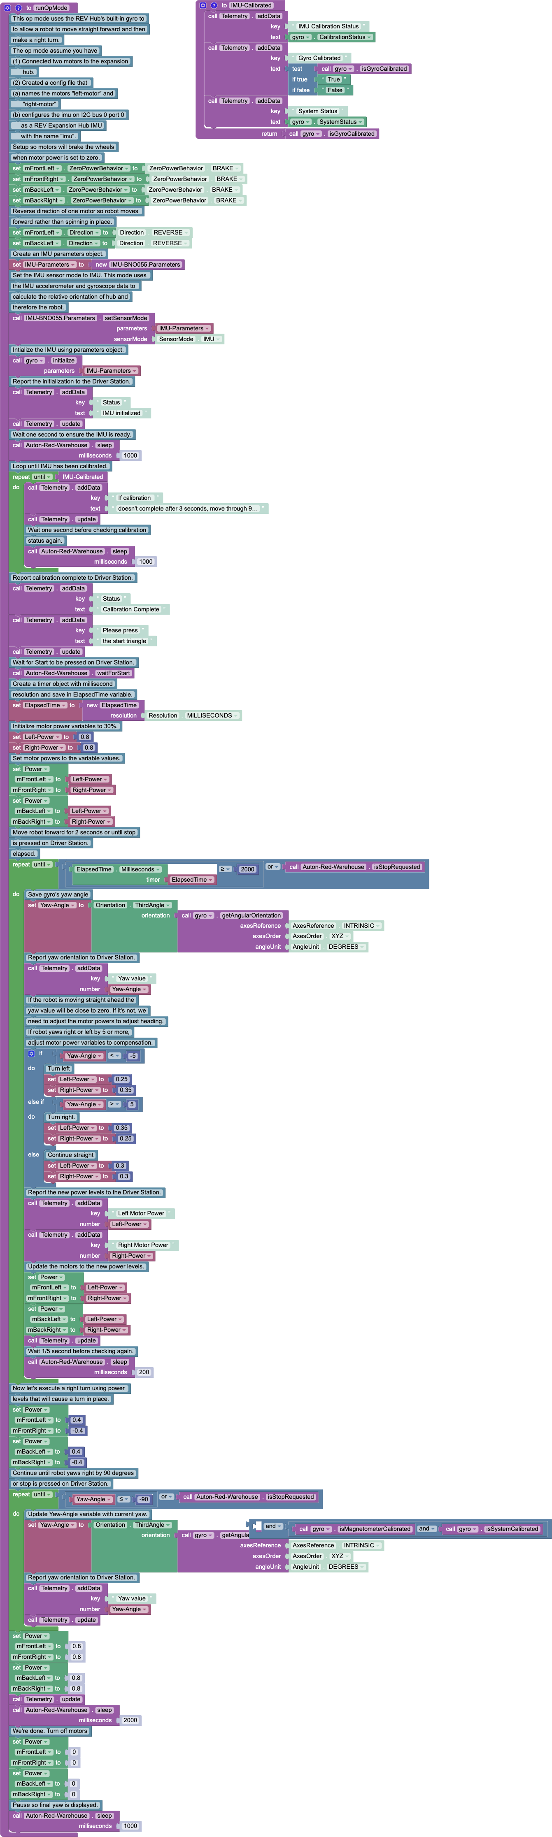
FTC/2021/Block/Auton/Auton-Red-Warehouse.png
