dkittell/robotics-code-library/FTC/2021/Block/Auton/David - Encoder Count Drive.png

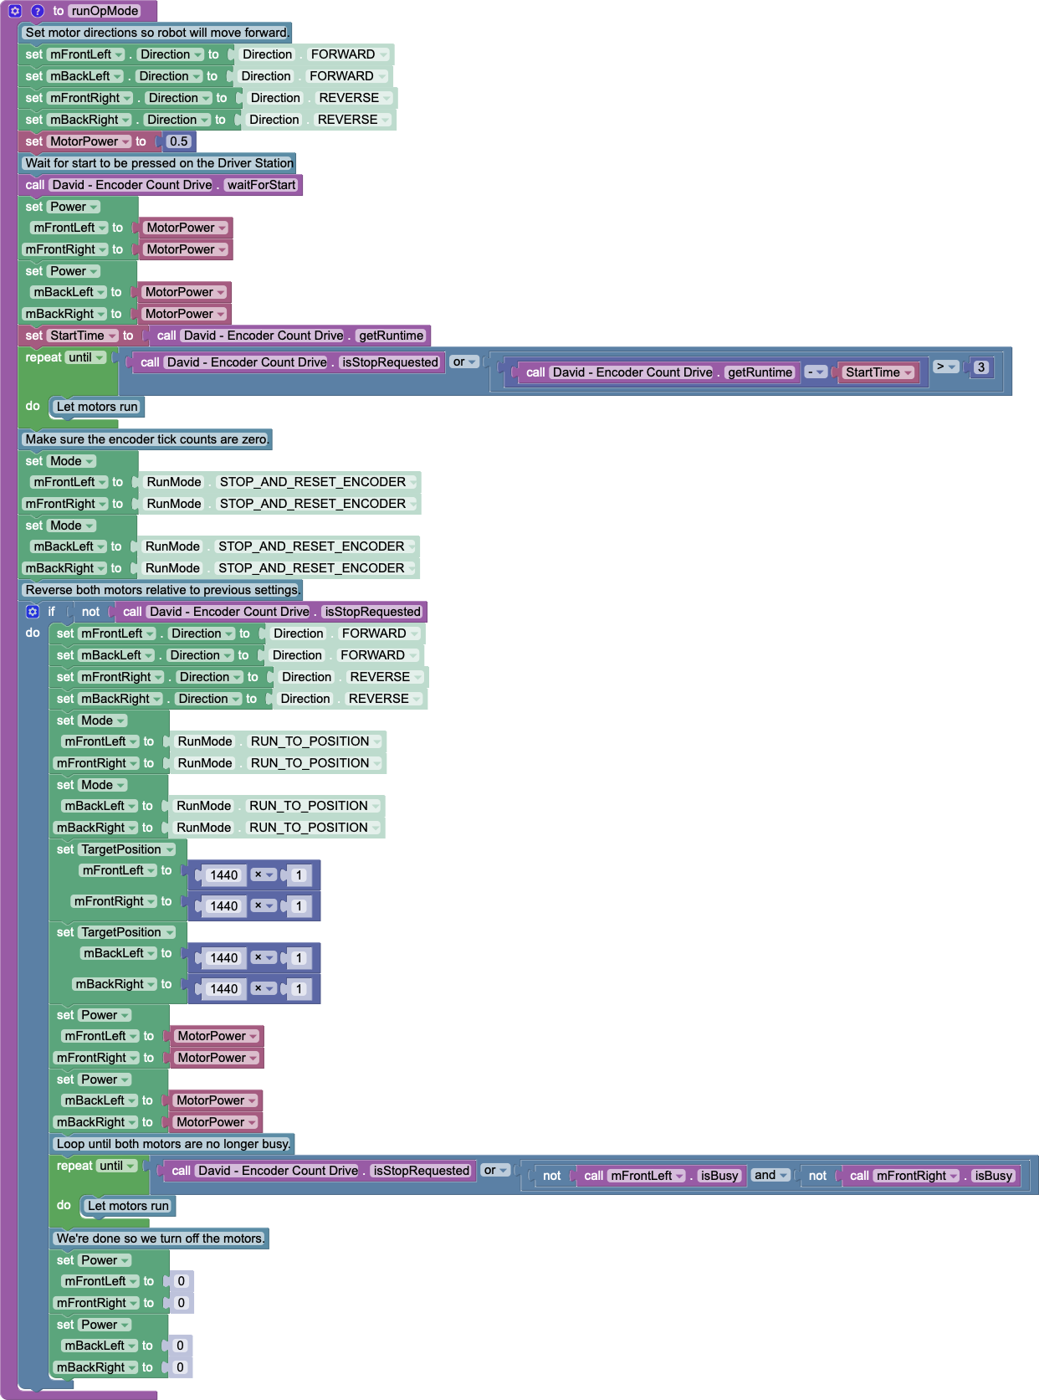
FTC/2021/Block/Auton/David - Encoder Count Drive.png
