dkittell/robotics-code-library/FTC/2021/Block/Auton/EncoderDrive.png

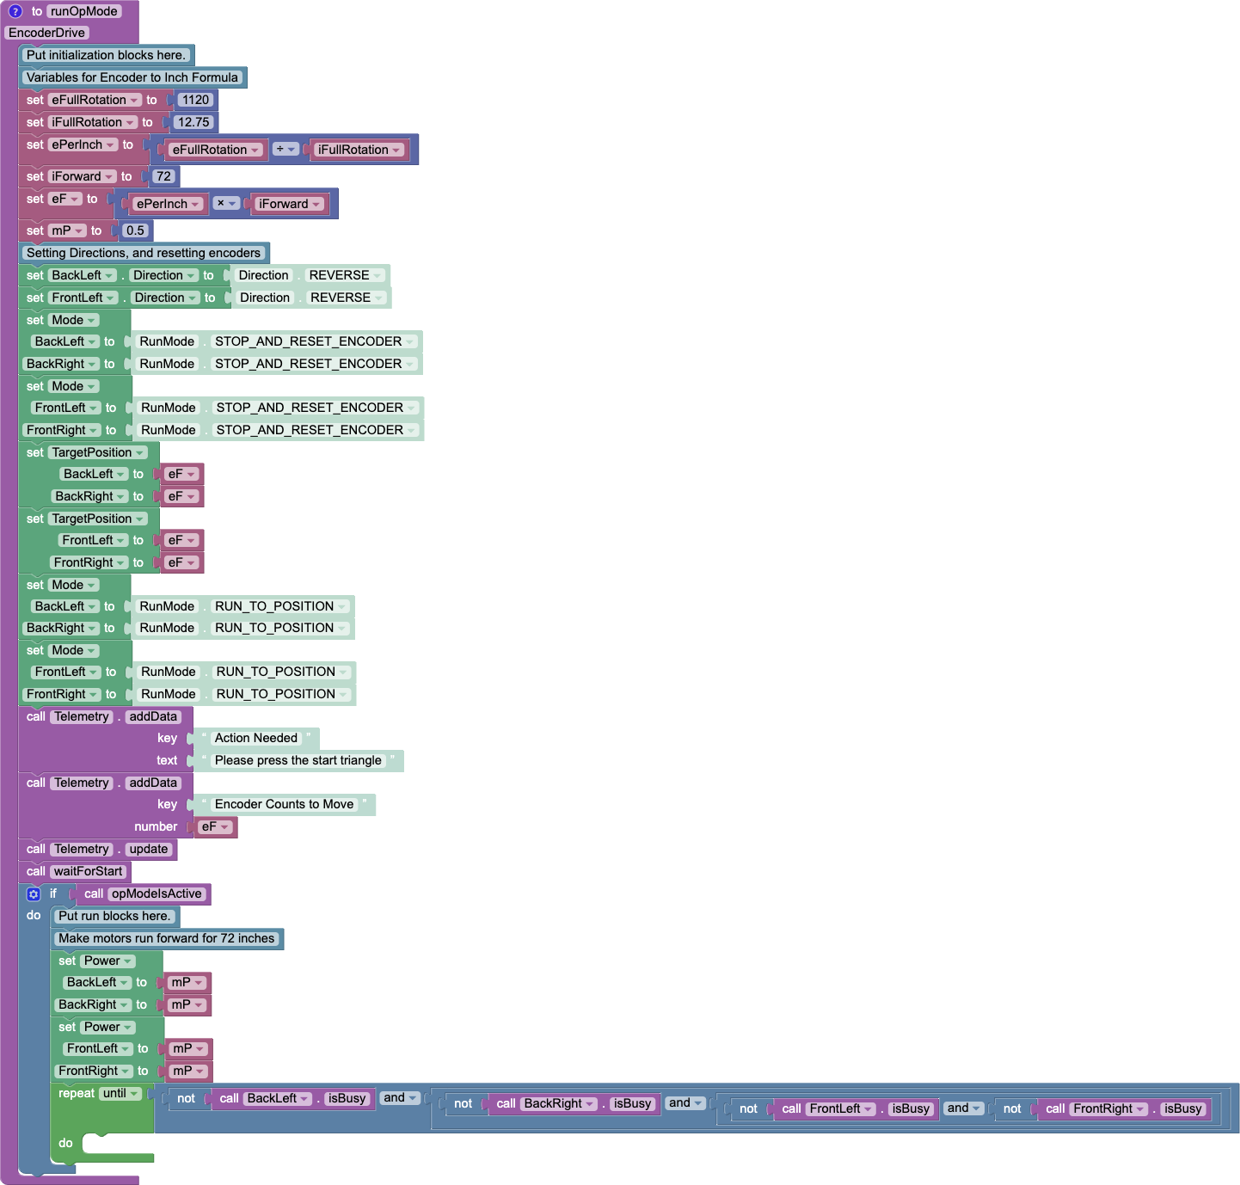
FTC/2021/Block/Auton/EncoderDrive.png
