dkittell/robotics-code-library/FTC/2021/Block/Auton/GyroYouTubeExample.png

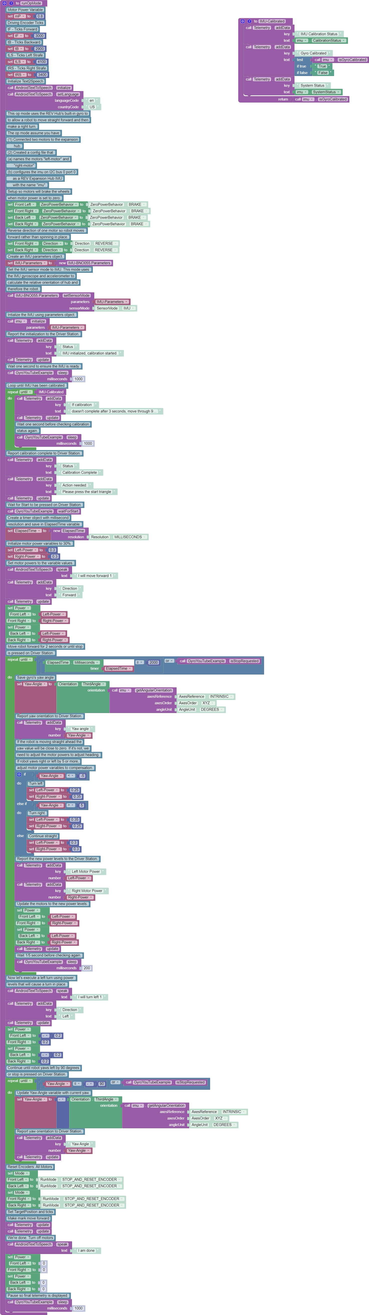
FTC/2021/Block/Auton/GyroYouTubeExample.png
