dkittell/robotics-code-library/FTC/2021/Block/Auton/Mark Auton Square.png

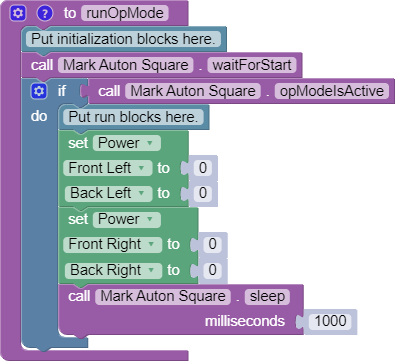
FTC/2021/Block/Auton/Mark Auton Square.png
