dkittell/robotics-code-library/FTC/2021/Block/Auton/Mark_M Closed Loop.png

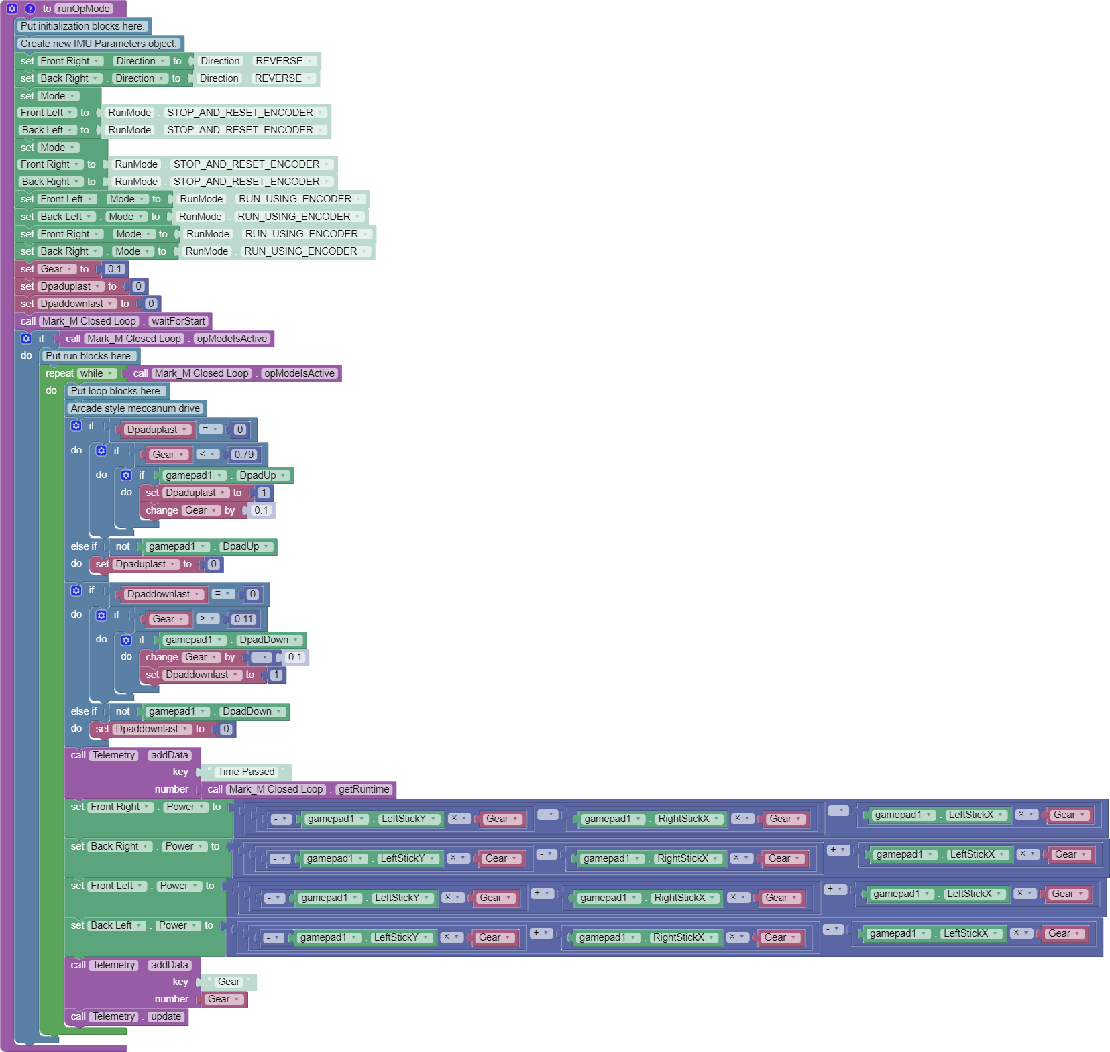
FTC/2021/Block/Auton/Mark_M Closed Loop.png
