dkittell/robotics-code-library/FTC/2021/Block/Auton/Mark_M..png

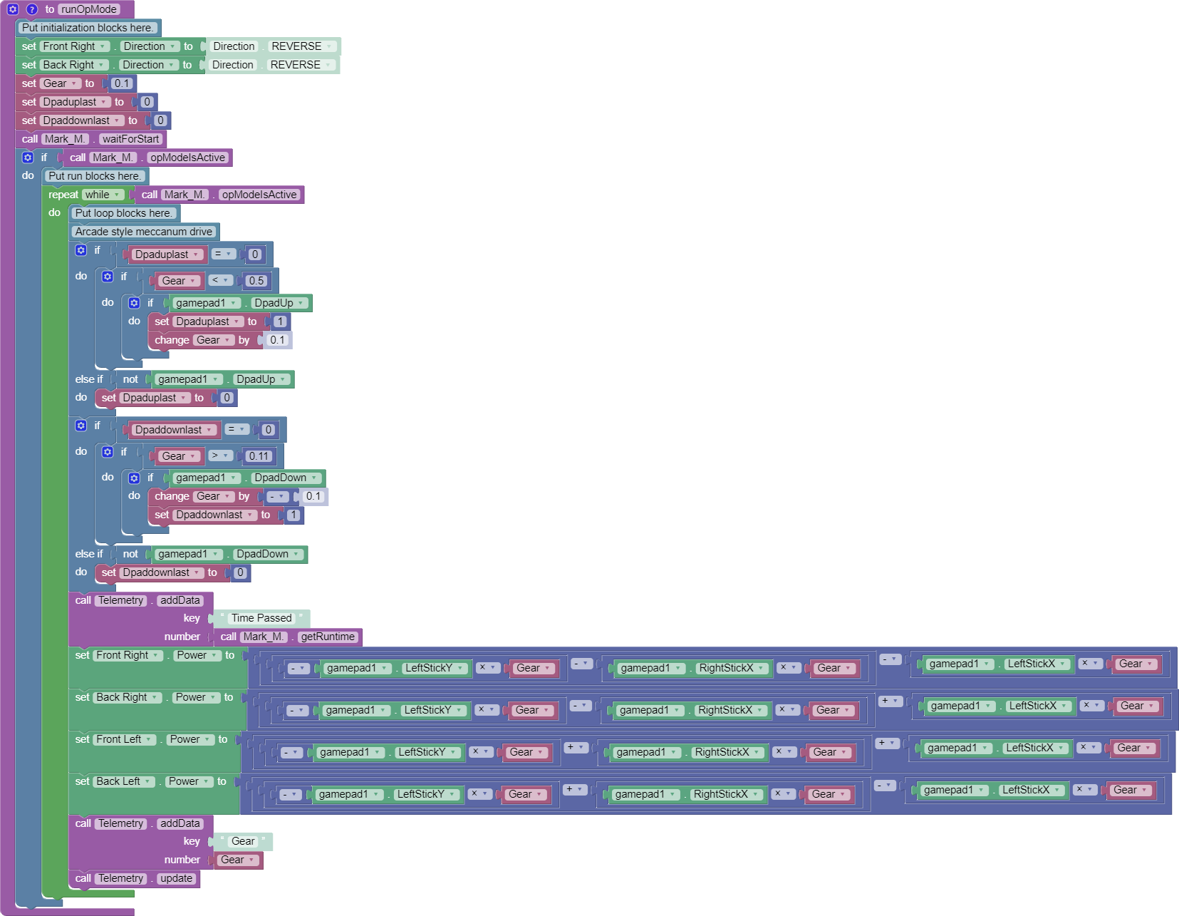
FTC/2021/Block/Auton/Mark_M..png
