dkittell/robotics-code-library/FTC/2021/Block/Auton/SAMPLE - DriveForwardBackWithEncodersFixed.png

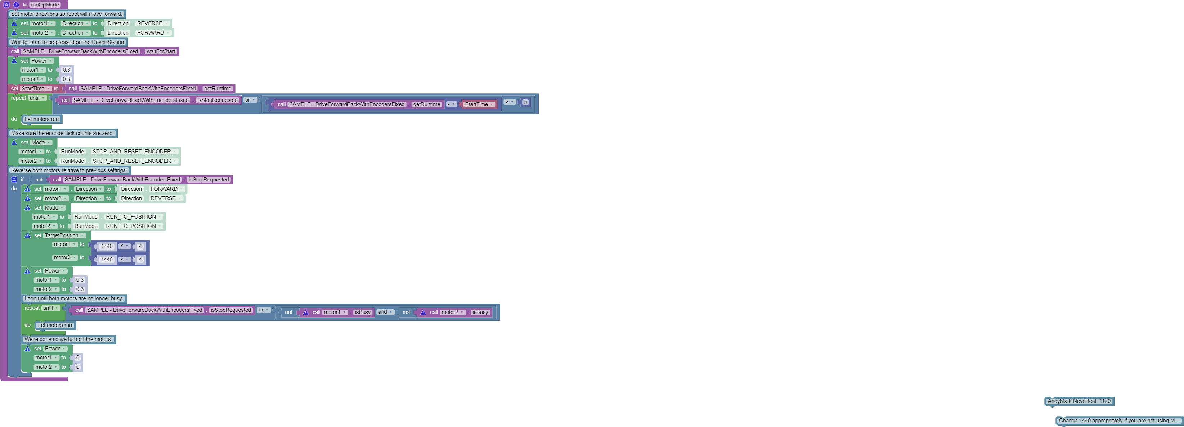
FTC/2021/Block/Auton/SAMPLE - DriveForwardBackWithEncodersFixed.png
