dkittell/robotics-code-library/FTC/2021/Block/Auton/SAMPLE - GyroYouTube.png

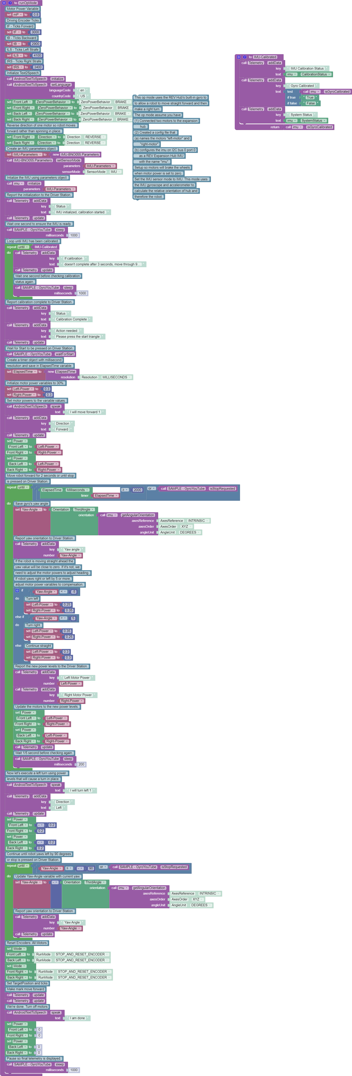
FTC/2021/Block/Auton/SAMPLE - GyroYouTube.png
