dkittell/robotics-code-library/FTC/2021/Block/Auton/SAMPLE - ParallelProgramming.png

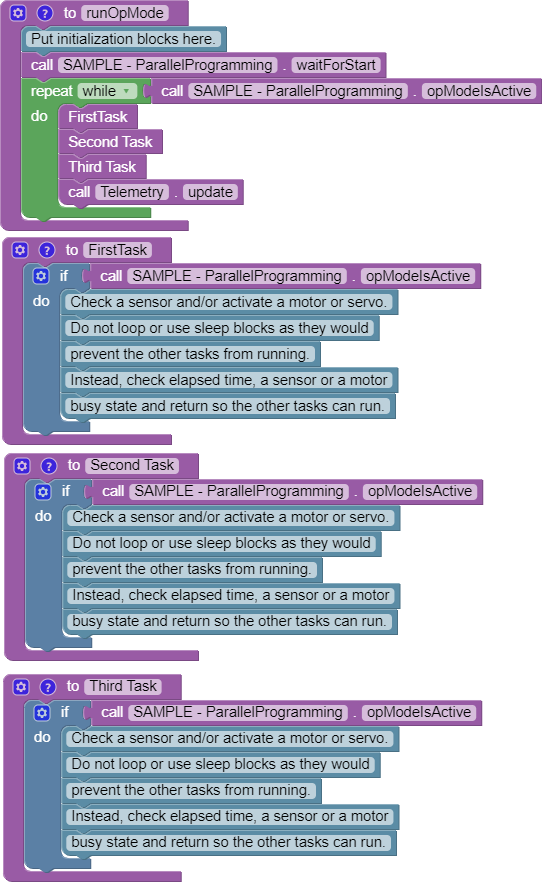
FTC/2021/Block/Auton/SAMPLE - ParallelProgramming.png
