dkittell/robotics-code-library/FTC/2021/Block/Auton/SAMPLE - REV-Gyro-Nav-Full.png

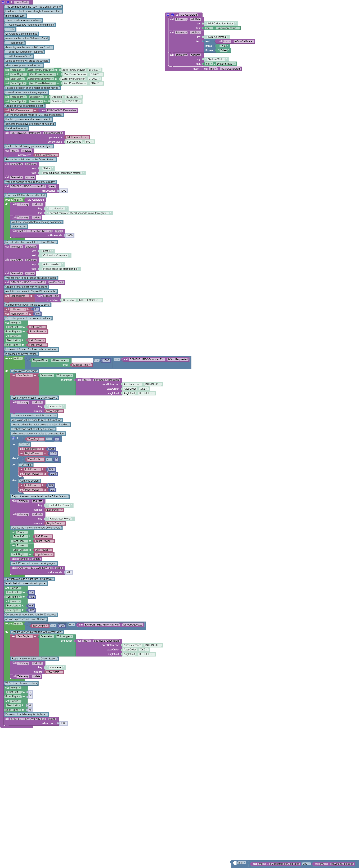
FTC/2021/Block/Auton/SAMPLE - REV-Gyro-Nav-Full.png
