dkittell/robotics-code-library/FTC/2021/Block/Auton/SAMPLE - Use Encoders.png

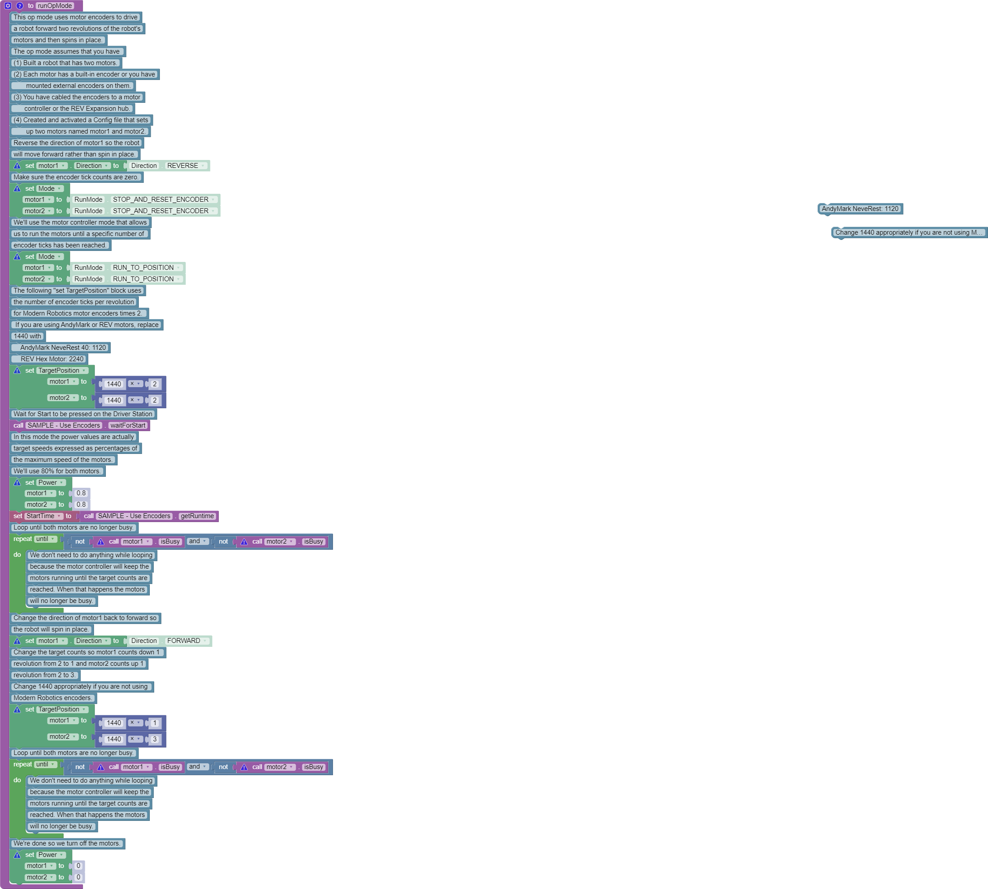
FTC/2021/Block/Auton/SAMPLE - Use Encoders.png
