dkittell/robotics-code-library/FTC/2021/Block/Auton/TankColorSensorCode_Joe.png

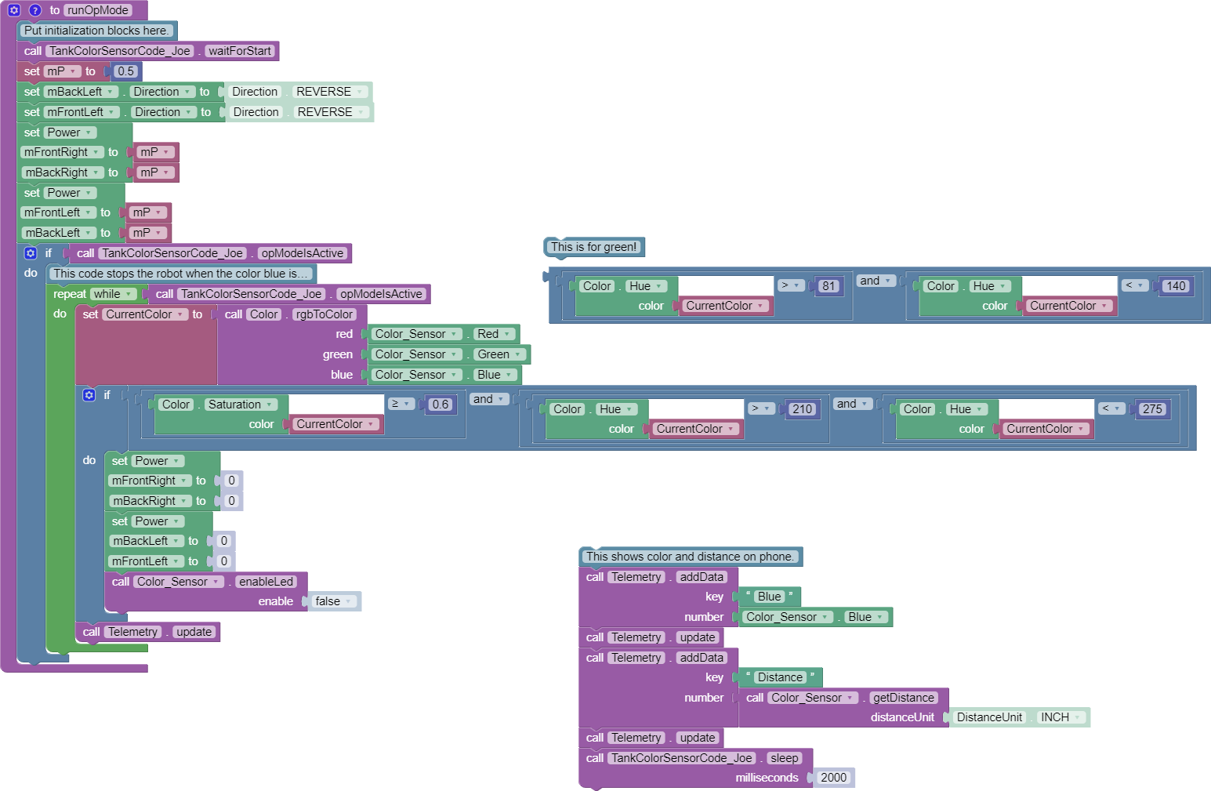
FTC/2021/Block/Auton/TankColorSensorCode_Joe.png
