dkittell/robotics-code-library/FTC/2021/Block/Auton/WebCamBlock.png

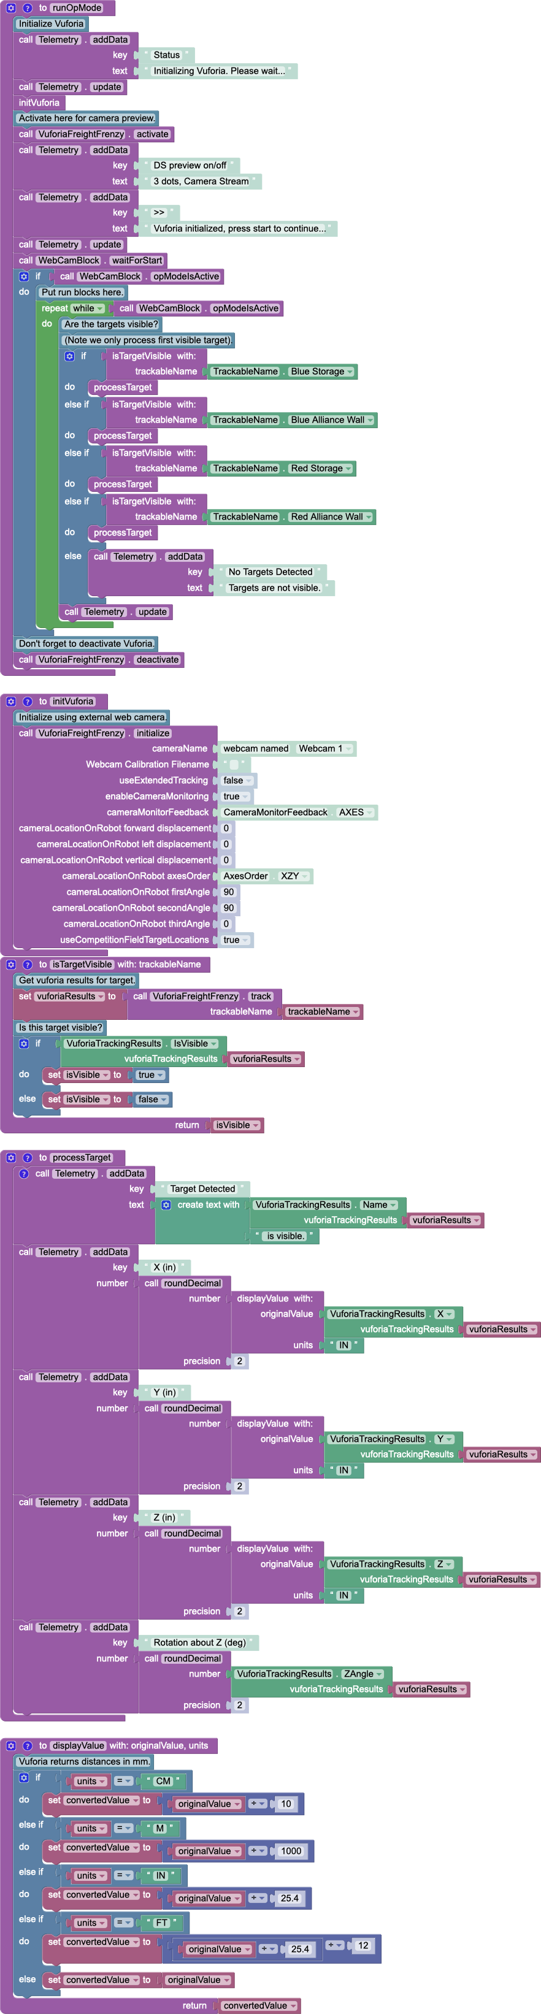
FTC/2021/Block/Auton/WebCamBlock.png
