dkittell/robotics-code-library/FTC/2021/Block/Auton/WheelDirection.png

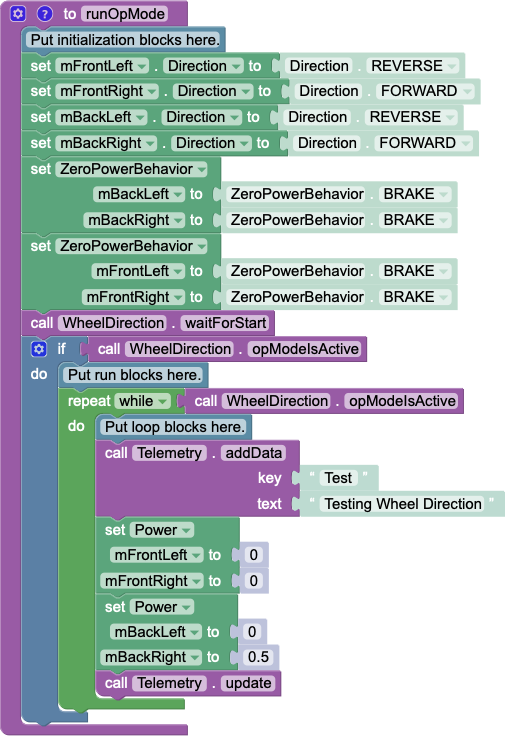
FTC/2021/Block/Auton/WheelDirection.png
