dkittell/robotics-code-library/FTC/2021/Images/Expansion_Hub_Three__36297.1525989036.png

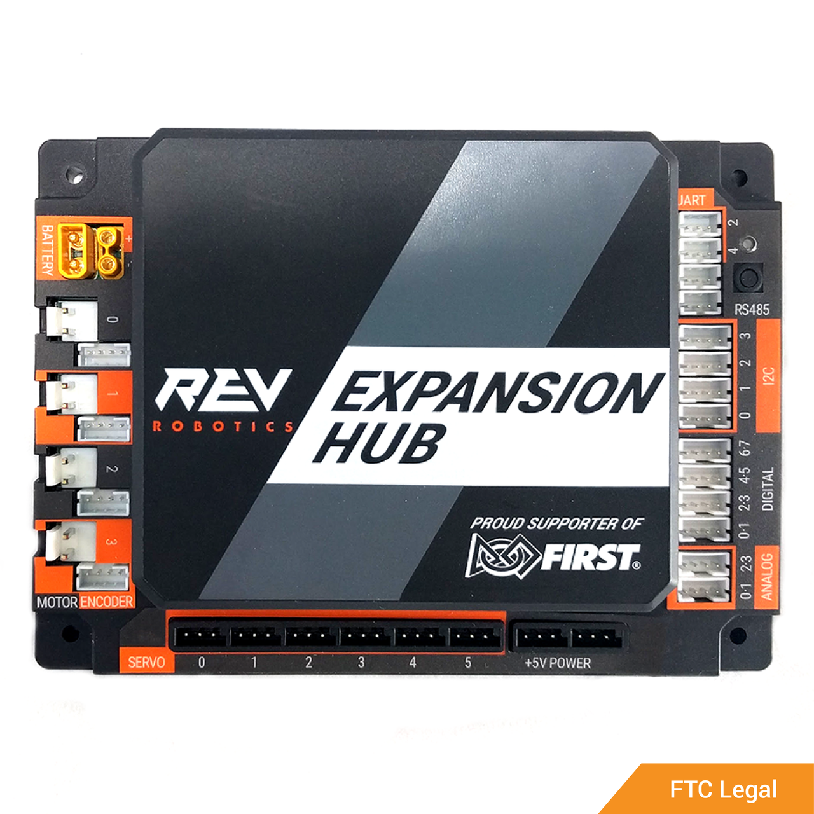
FTC/2021/Images/Expansion_Hub_Three__36297.1525989036.png
