dkittell/robotics-code-library/FTC/2023/7065/Block/Diagnostic/ColorDistance_Sample.png

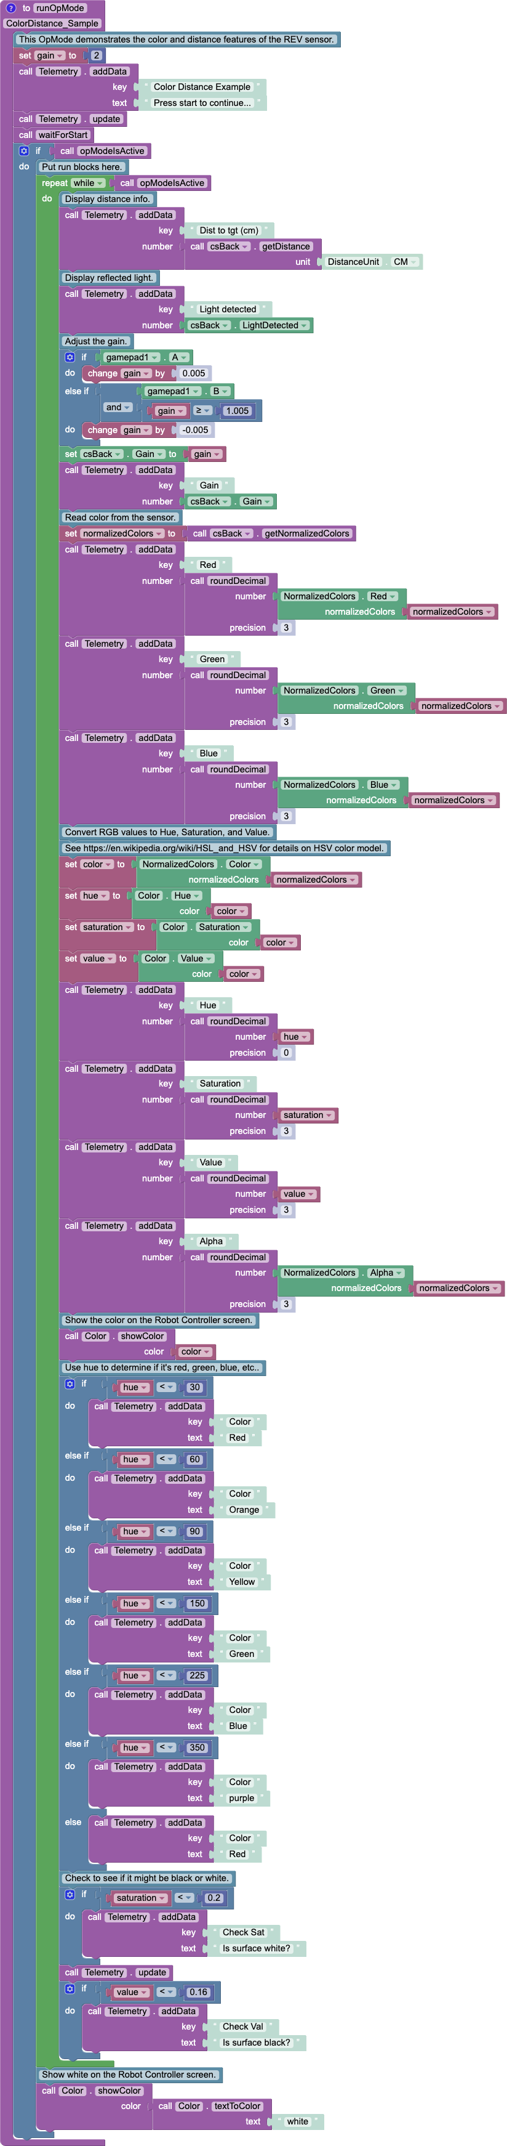
FTC/2023/7065/Block/Diagnostic/ColorDistance_Sample.png
