dkittell/robotics-code-library/FTC/2023/7065/Block/Diagnostic/PivotMotor_Encoder.png

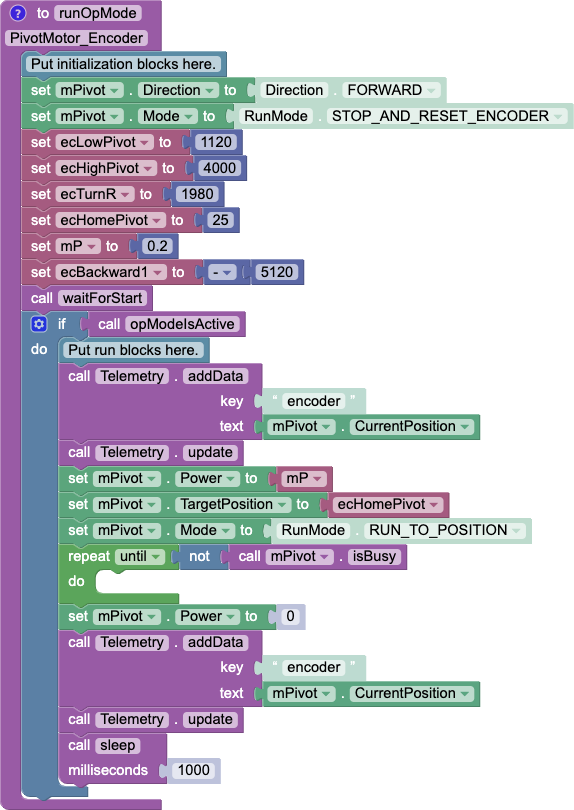
FTC/2023/7065/Block/Diagnostic/PivotMotor_Encoder.png
