dkittell/robotics-code-library/FTC/2023/7065/Block/Diagnostic/Tank/ColorDistance.png

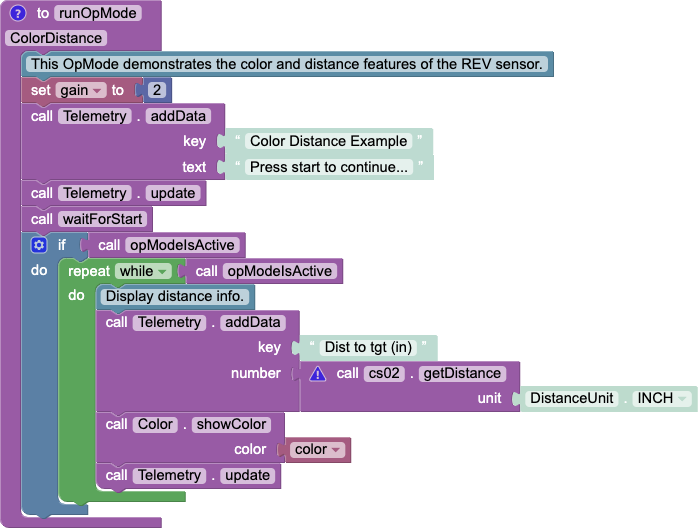
FTC/2023/7065/Block/Diagnostic/Tank/ColorDistance.png
