dkittell/robotics-code-library/FTC/2023/7065/Java/Auton/Scooter/Autonomous-2.png

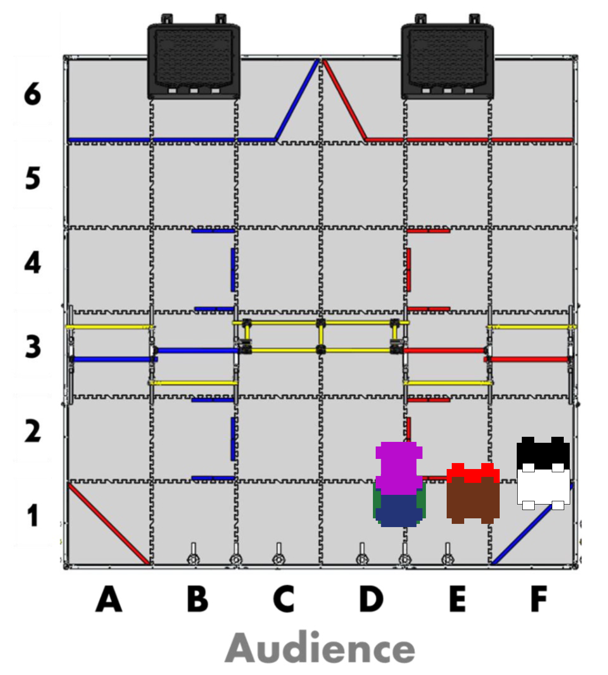
FTC/2023/7065/Java/Auton/Scooter/Autonomous-2.png
