dkittell/robotics-code-library/FTC/2023/19436/blocks/2021starterbotblocks.png

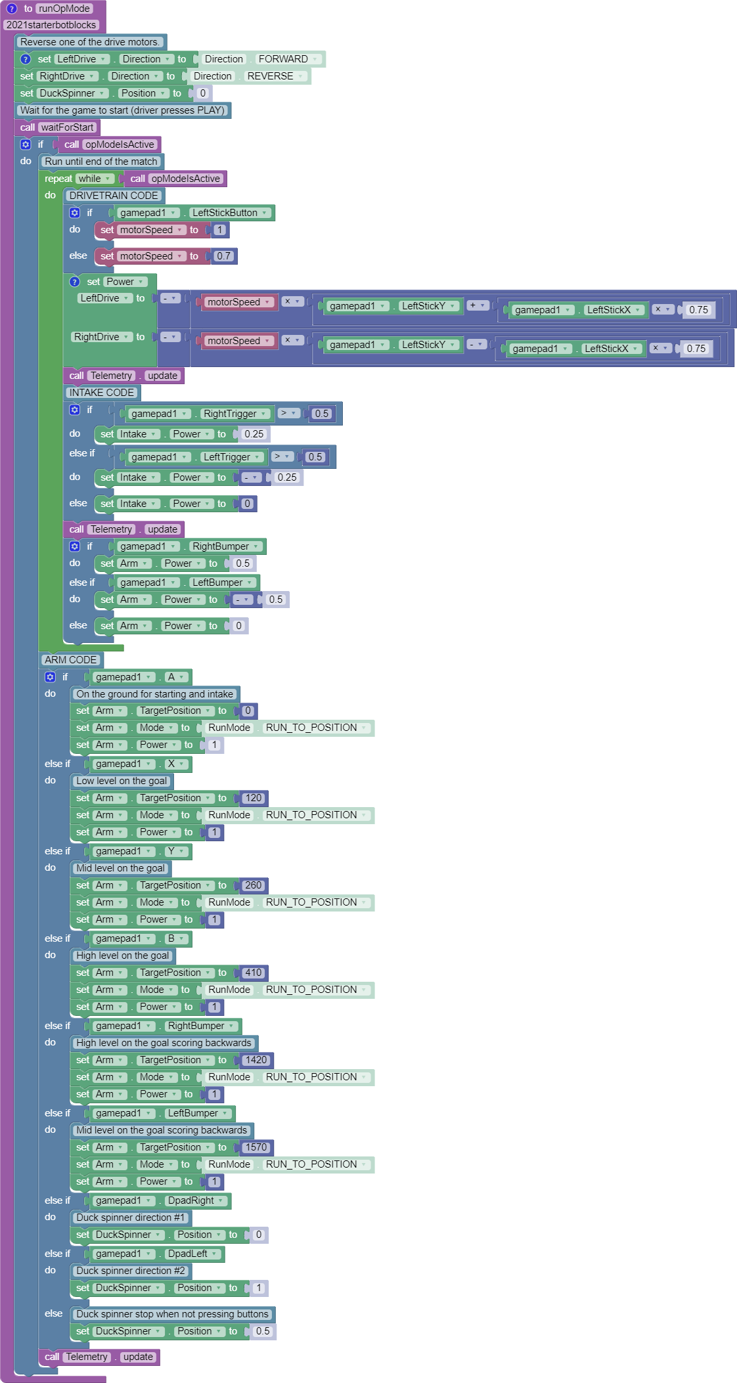
FTC/2023/19436/blocks/2021starterbotblocks.png
