dkittell/robotics-code-library/FTC/2023/19436/blocks/2022 ironbot 1 auton.png

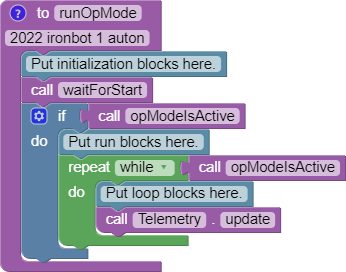
FTC/2023/19436/blocks/2022 ironbot 1 auton.png
