dkittell/robotics-code-library/FTC/2023/19436/blocks/color sensor wat u doin.png

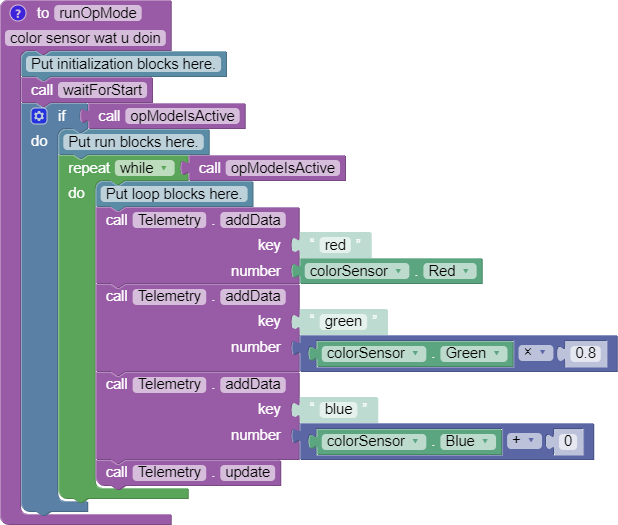
FTC/2023/19436/blocks/color sensor wat u doin.png
