dkittell/robotics-code-library/FTC/2023/19436/blocks/Driver Code.png

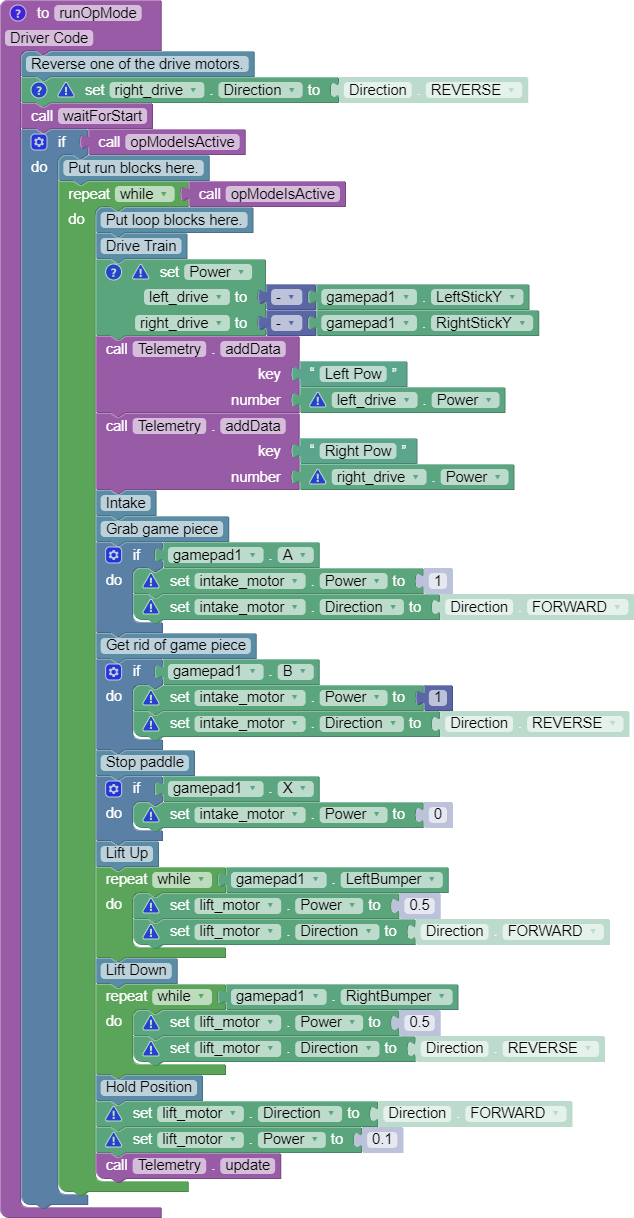
FTC/2023/19436/blocks/Driver Code.png
