dkittell/robotics-code-library/FTC/2023/22364/blocks/2022-2023 auton.png

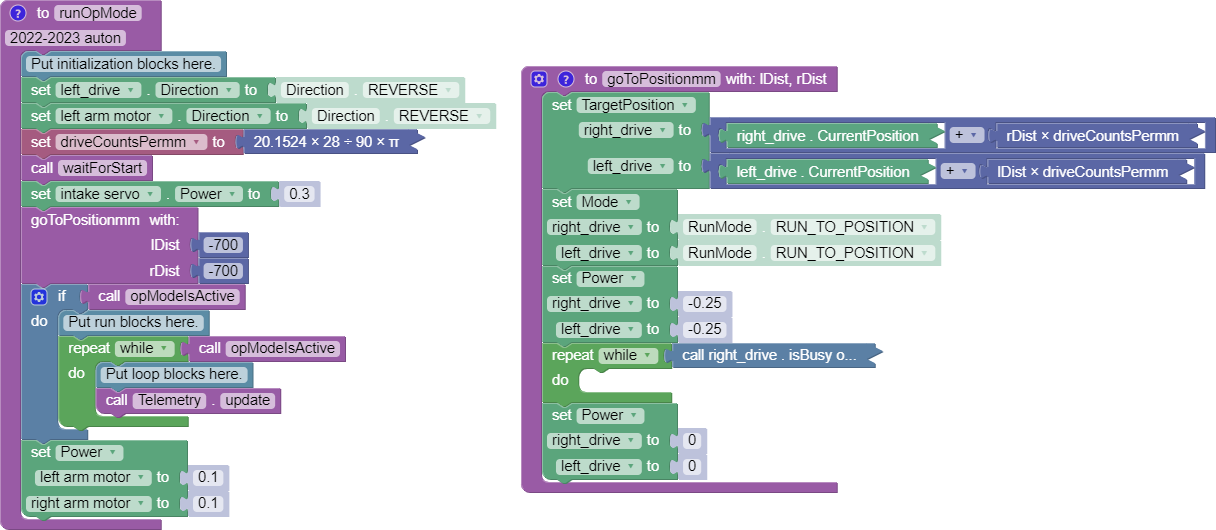
FTC/2023/22364/blocks/2022-2023 auton.png
