dkittell/robotics-code-library/FTC/2023/22364/blocks/POWERPLAY-Starter-Bot-Teleop.png

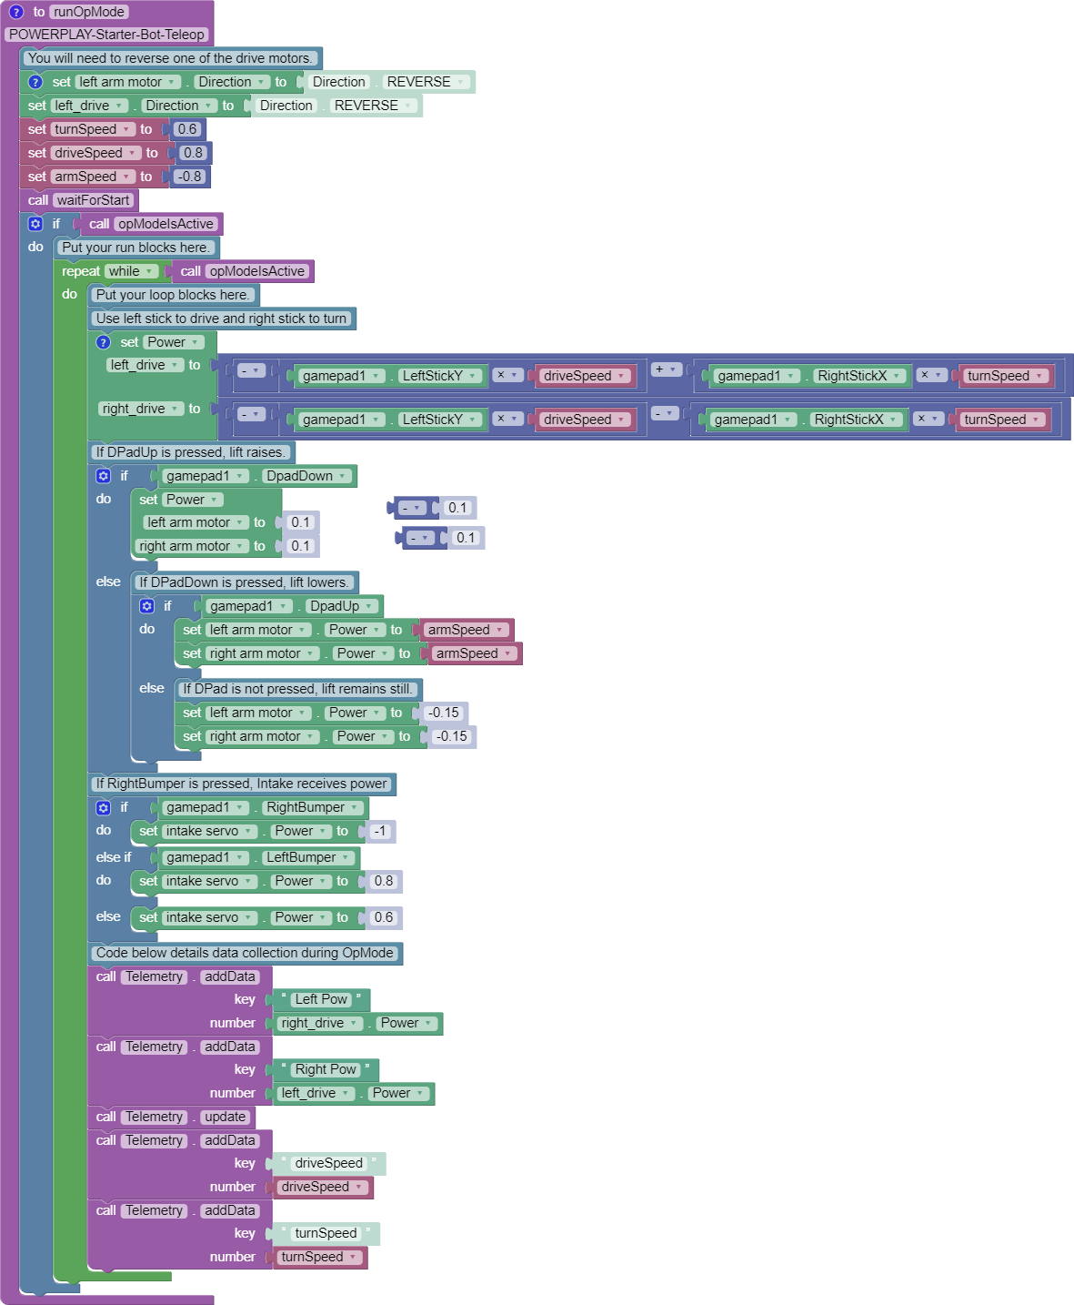
FTC/2023/22364/blocks/POWERPLAY-Starter-Bot-Teleop.png
