dkittell/robotics-code-library/FTC/2023/22364/blocks/teaching logan.png

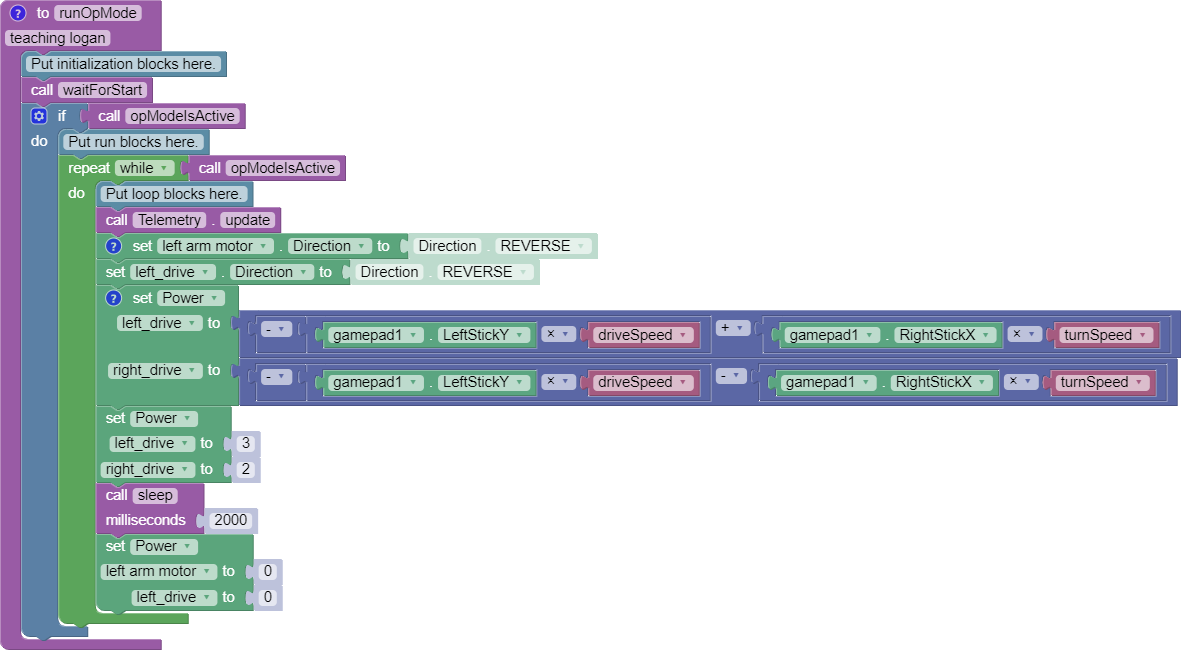
FTC/2023/22364/blocks/teaching logan.png
