dkittell/robotics-code-library/FTC/2024/Block/Billy-Telop-ArcadeDrive.png

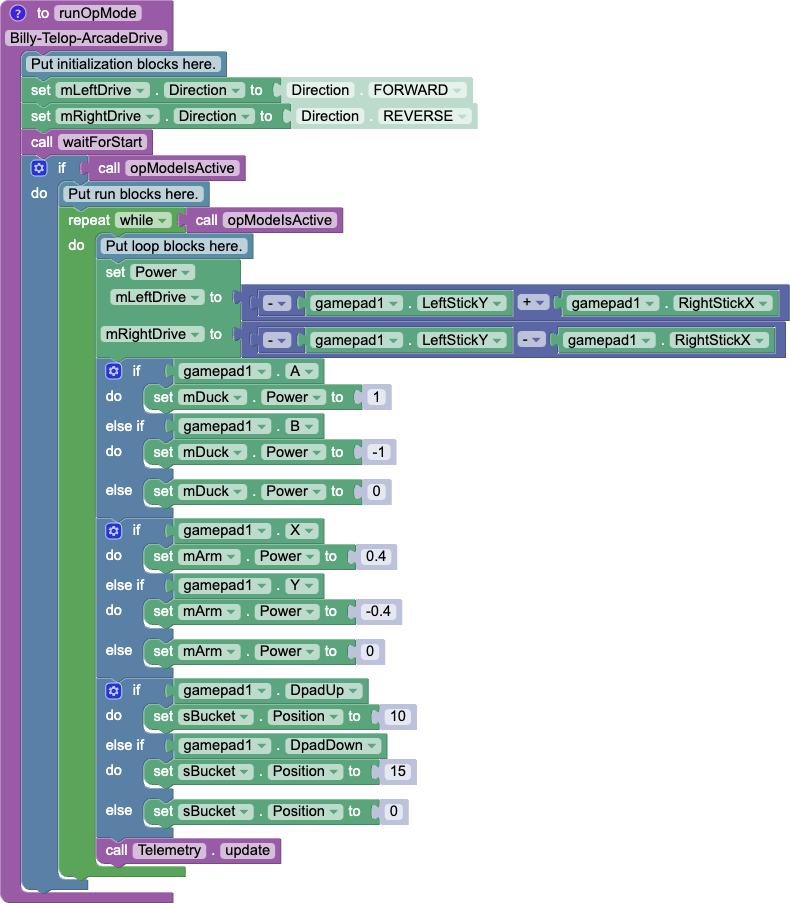
FTC/2024/Block/Billy-Telop-ArcadeDrive.png
