dkittell/robotics-code-library/FTC/2024/Block/Billy-Telop-TankDrive.png

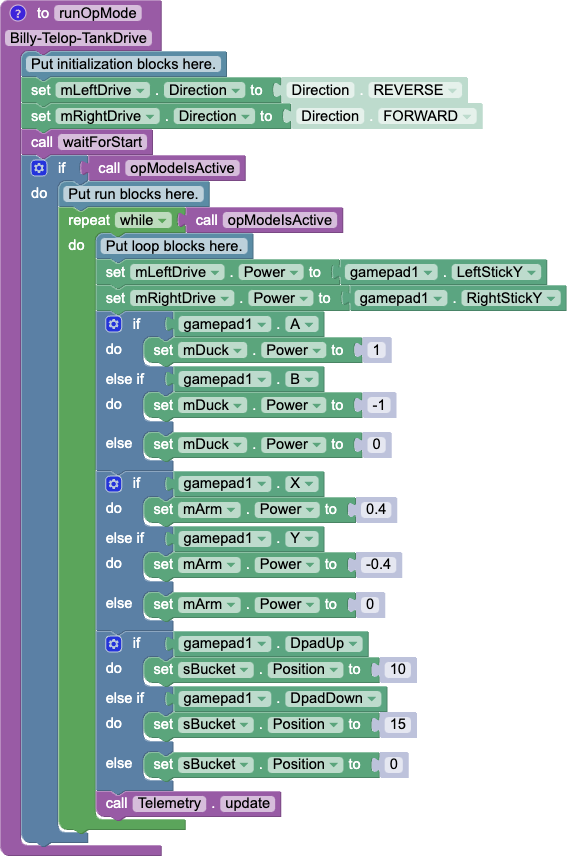
FTC/2024/Block/Billy-Telop-TankDrive.png
