dkittell/robotics-code-library/FTC/2024/Block/Phil-Talks.png

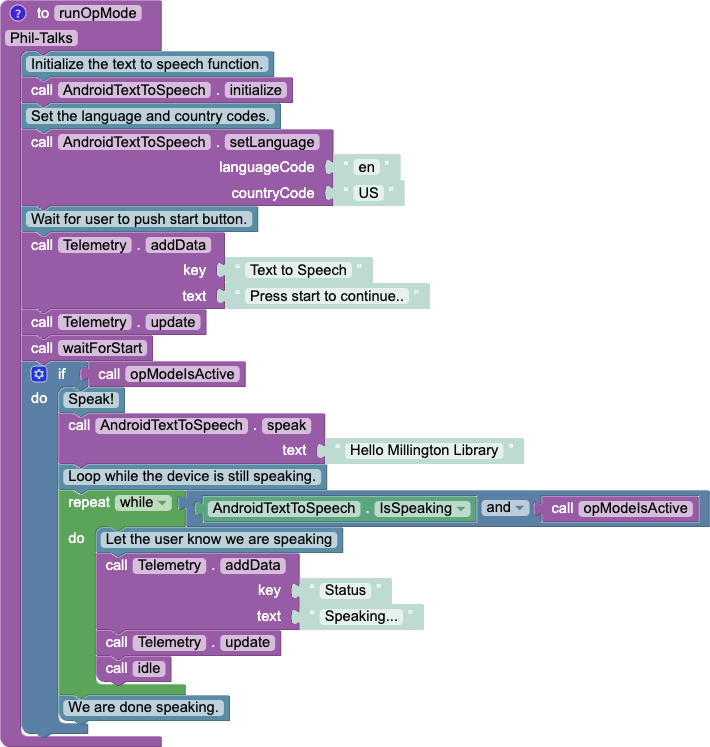
FTC/2024/Block/Phil-Talks.png
