dkittell/robotics-code-library/FTC/2024/Block/Phil-Telop-Drive.png

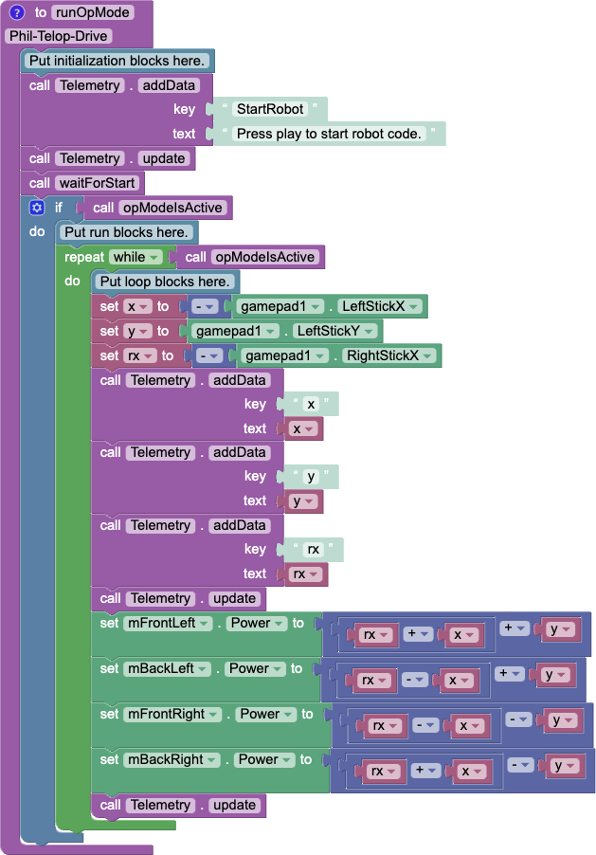
FTC/2024/Block/Phil-Telop-Drive.png
