dkittell/robotics-code-library/FTC/David - Encoder Count Drive.png

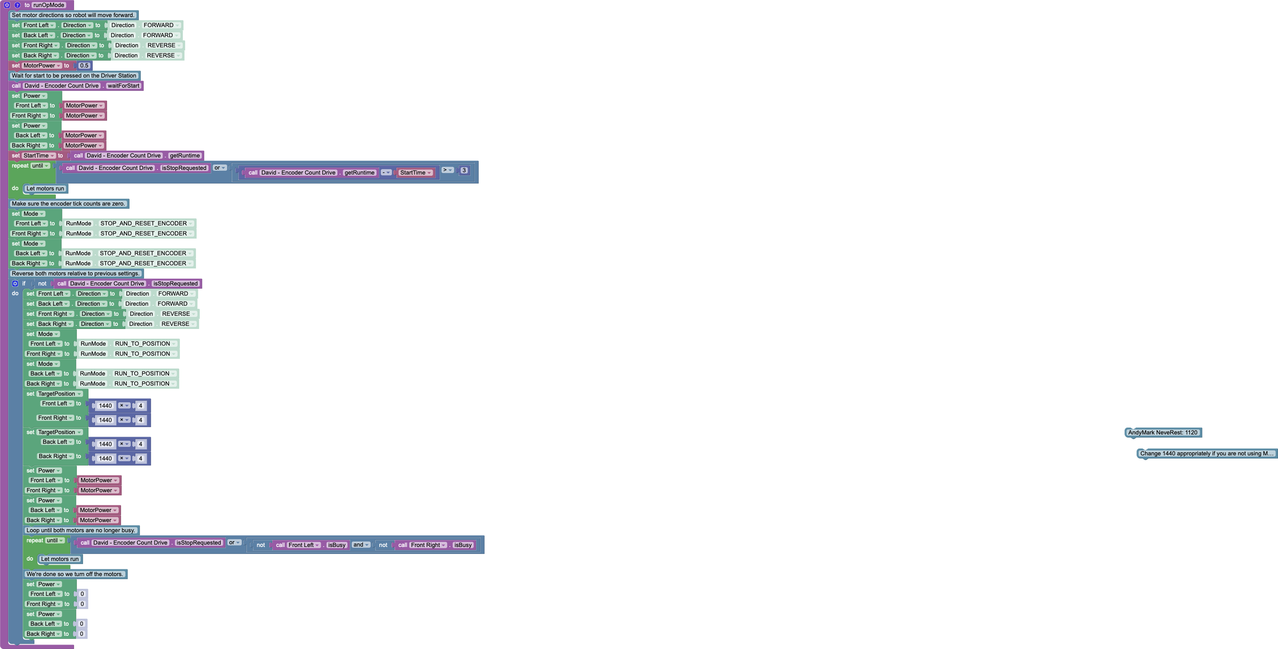
FTC/David - Encoder Count Drive.png
