dkittell/robotics-code-library/OtherTeams/FRC3535/artwork/FRC3535.png

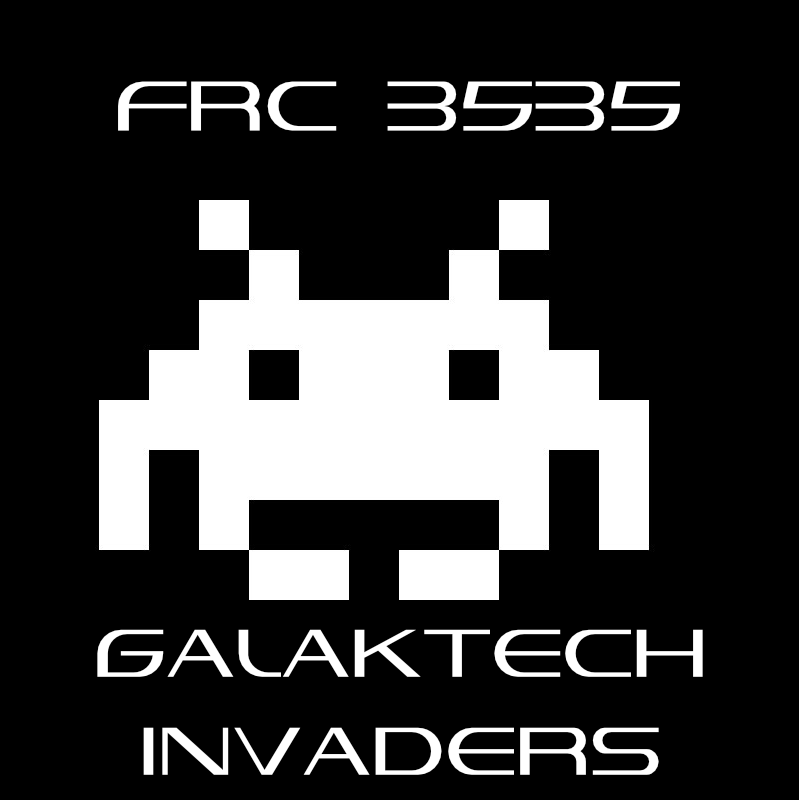
OtherTeams/FRC3535/artwork/FRC3535.png
