dkittell/robotics-code-library/OtherTeams/FRC3535/artwork/FRC3535_400x400.jpeg

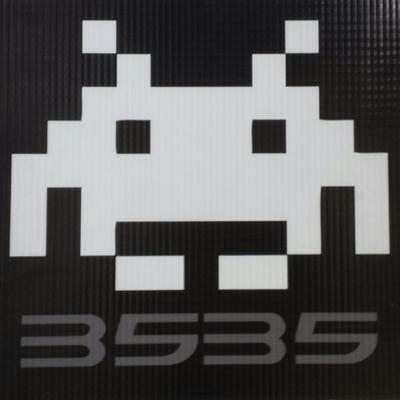
OtherTeams/FRC3535/artwork/FRC3535_400x400.jpeg
