dkittell/robotics-code-library/OtherTeams/FRC3535/artwork/invader-2400px.png

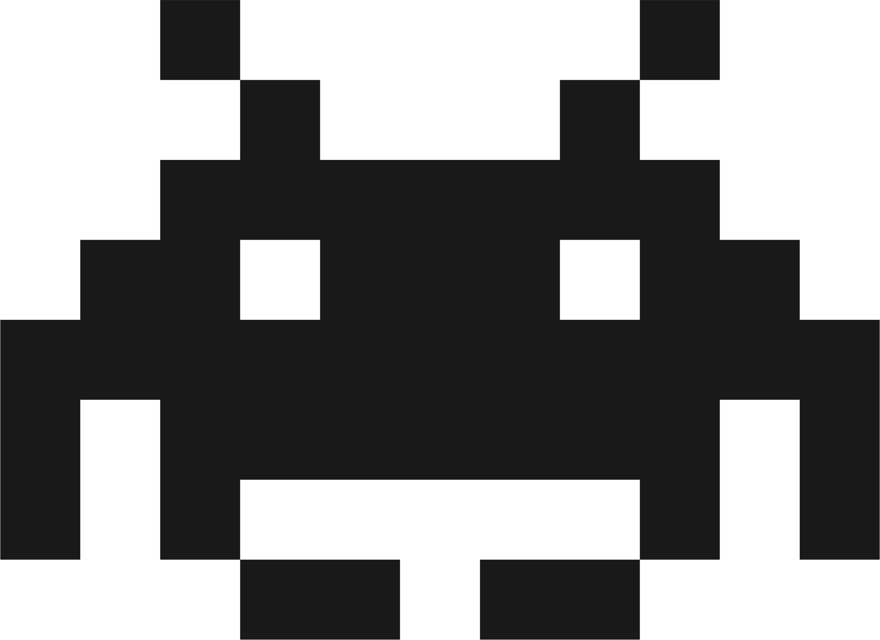
OtherTeams/FRC3535/artwork/invader-2400px.png
