dkittell/robotics-code-library/OtherTeams/FRC3535/artwork/invader_bw.jpg

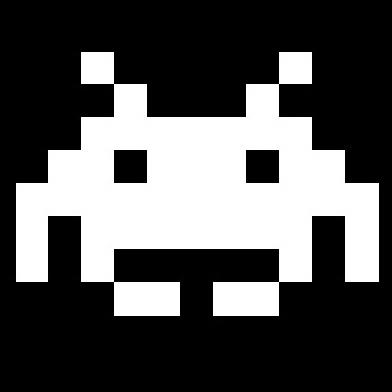
OtherTeams/FRC3535/artwork/invader_bw.jpg
