dkittell/robotics-code-library/OtherTeams/FRC3535/artwork/YouTubeCover.jpg

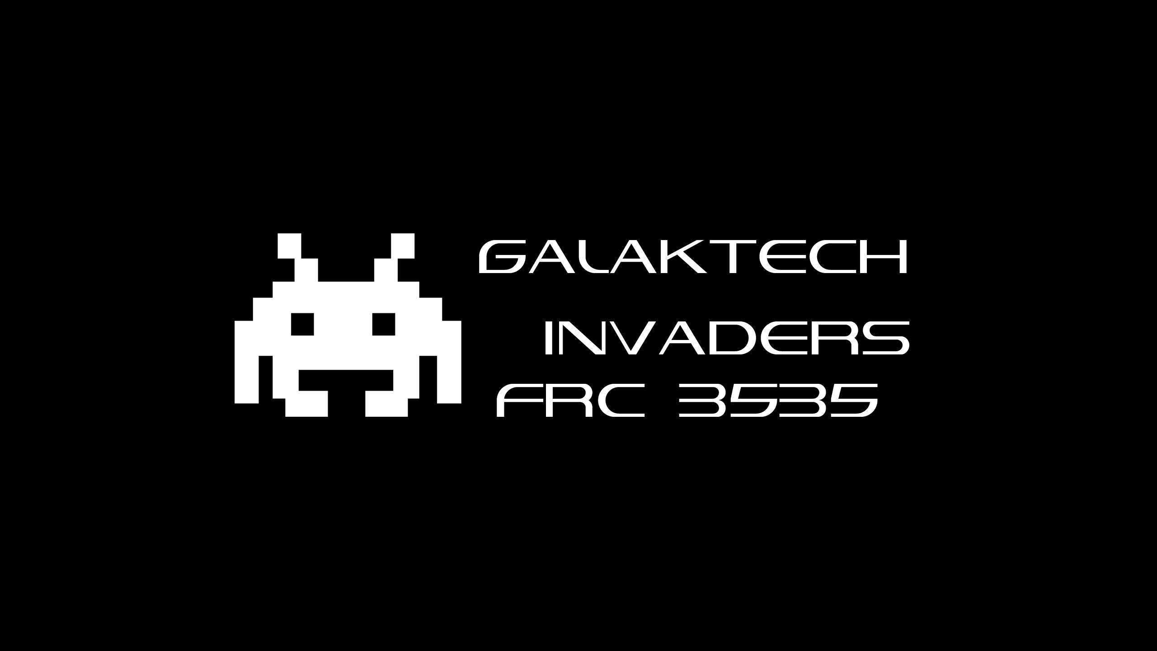
OtherTeams/FRC3535/artwork/YouTubeCover.jpg
