dkittell/robotics-code-library/CAD/FRC/Graham/Solidworks Assembled/SwerveDrive Assembly.SLDASM

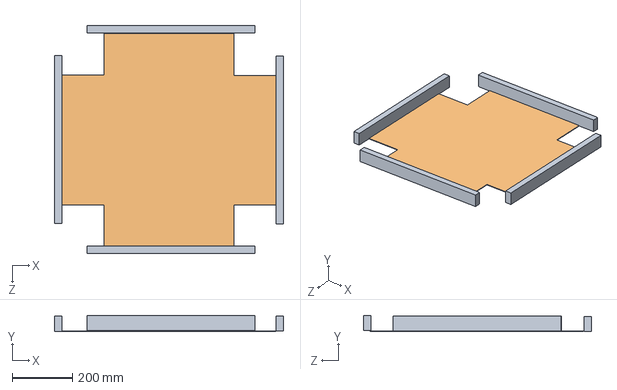
[picture p113: CAD file, 2025-03-22]
CAD/FRC/Graham/Solidworks Assembled/SwerveDrive Assembly.SLDASM
761.8 x 53.6 x 757.8 mm
Swerve Drive Bellypan
22x2x1 Beam x 4
