dkittell/robotics-code-library/CAD/FLL/First Lego League/files/assembled-do-not-print.stl

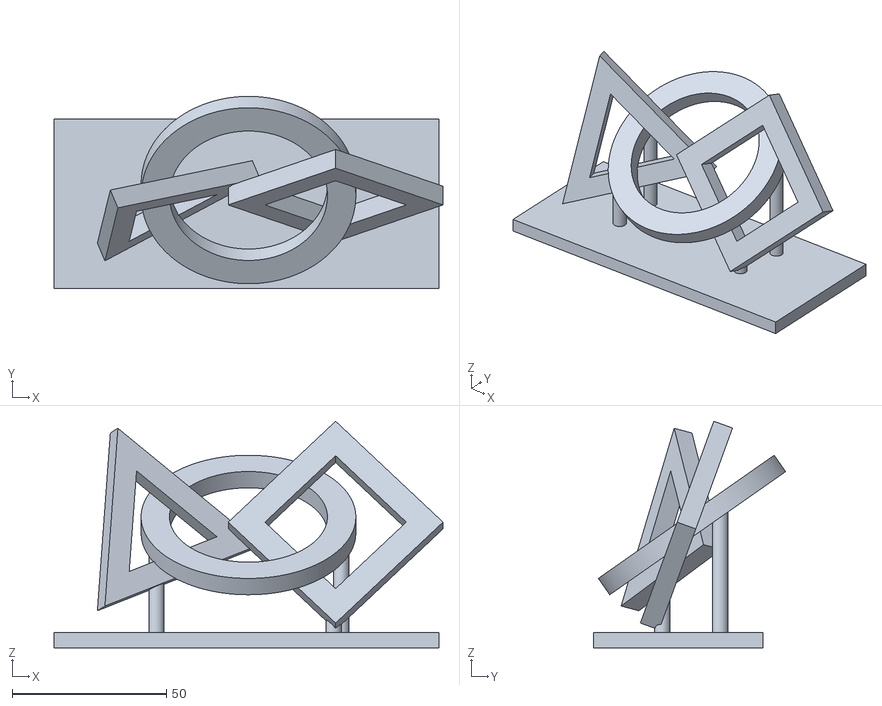
[picture p114: CAD file, 2025-03-22]
CAD/FLL/First Lego League/files/assembled-do-not-print.stl
126.3 x 62.4 x 73.5
