dkittell/robotics-code-library/CAD/FLL/First Lego League/files/triangle.stl

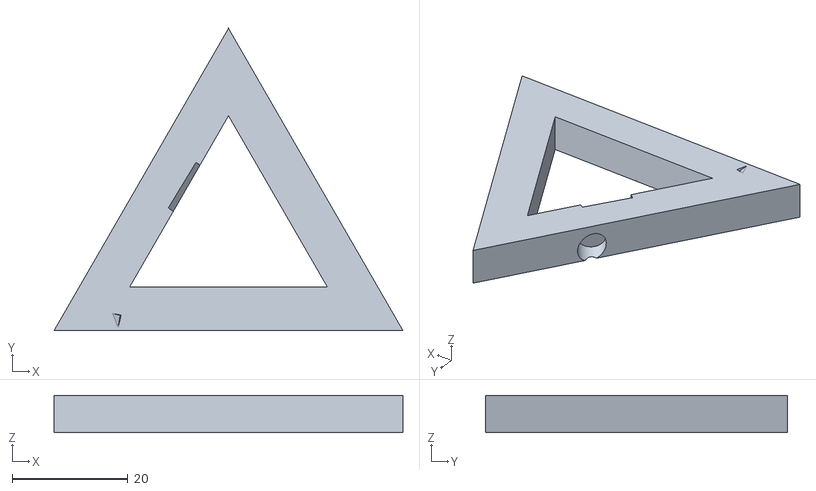
[picture p115: CAD file, 2025-03-22]
CAD/FLL/First Lego League/files/triangle.stl
60.4 x 52.3 x 6.47
