dkittell/robotics-code-library/CAD/FRC/3mf/FF_Original_Base.3mf

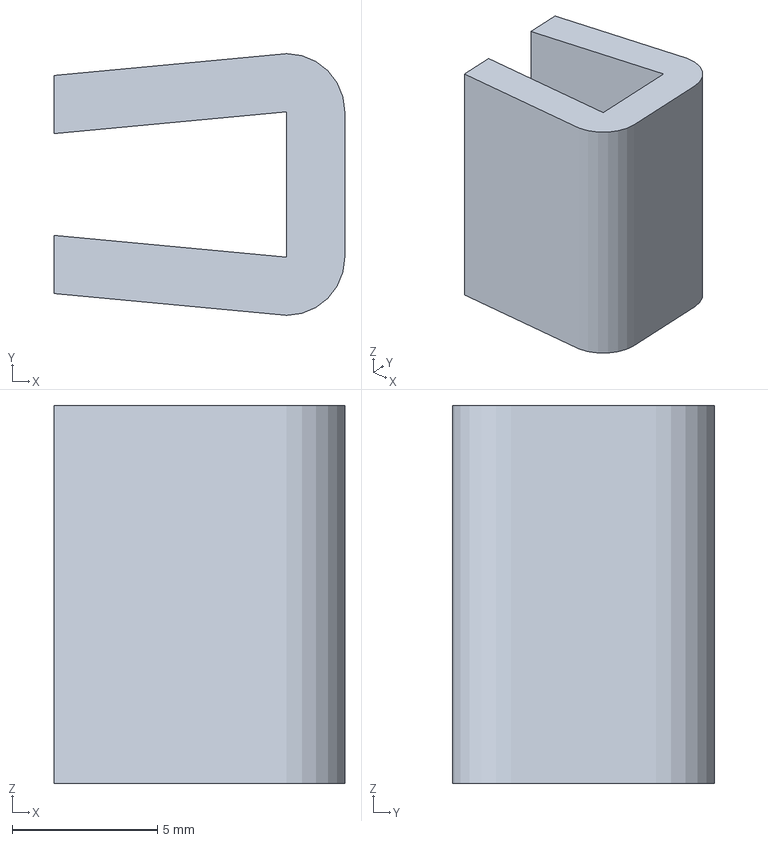
[picture p116: CAD file, 2025-03-22]
CAD/FRC/3mf/FF_Original_Base.3mf
10.0 x 9.00 x 13.0 mm
