dkittell/robotics-code-library/CAD/FRC/Gabe/part.STL

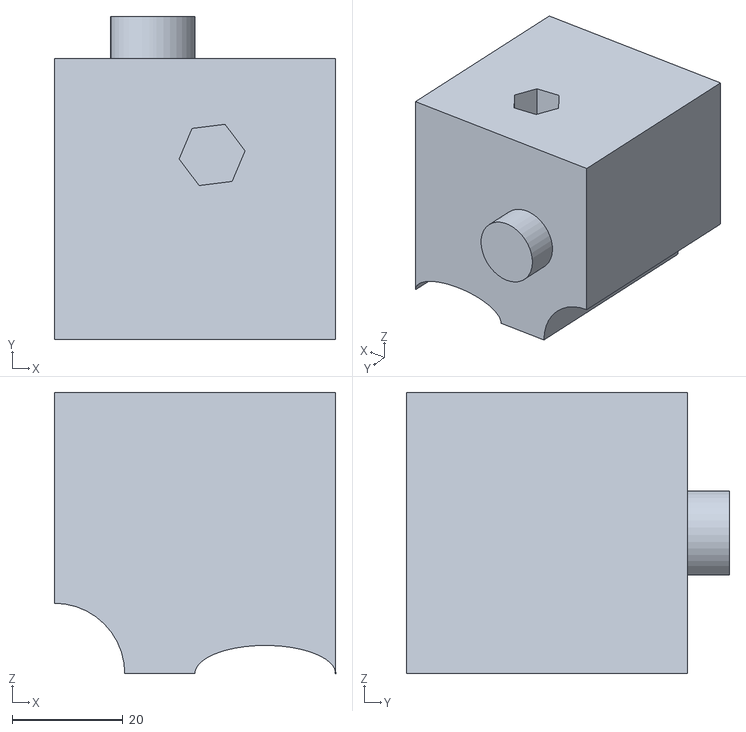
[picture p117: CAD file, 2025-03-22]
CAD/FRC/Gabe/part.STL
50.8 x 58.4 x 50.8
