dkittell/robotics-code-library/CAD/FRC/Graham/Solidworks Parts/22x2x1 Beam.SLDPRT

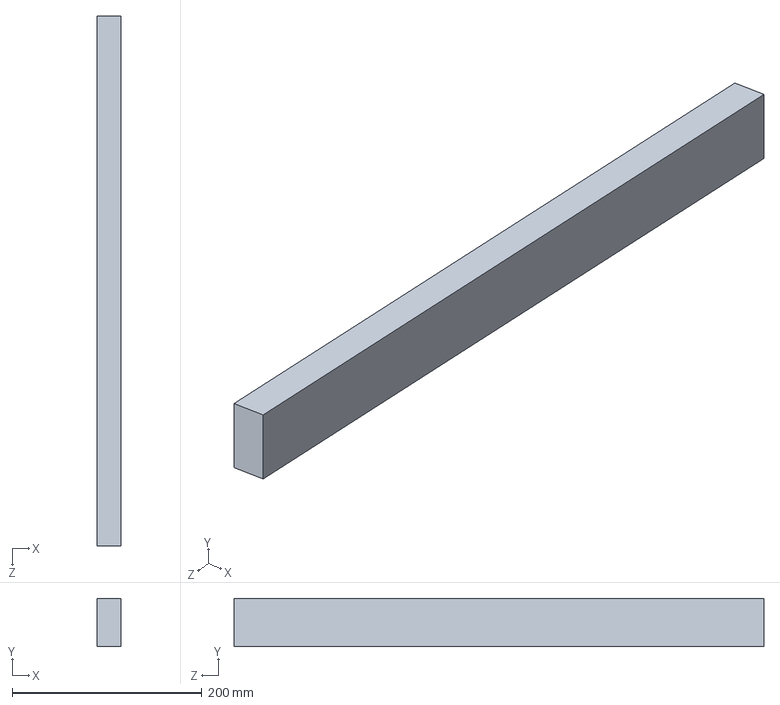
[picture p118: CAD file, 2025-03-22]
CAD/FRC/Graham/Solidworks Parts/22x2x1 Beam.SLDPRT
25.4 x 50.8 x 558.8 mm
