dkittell/robotics-code-library/CAD/FRC/Graham/Solidworks Parts/Bellypans/Swerve Drive Bellypan.SLDPRT

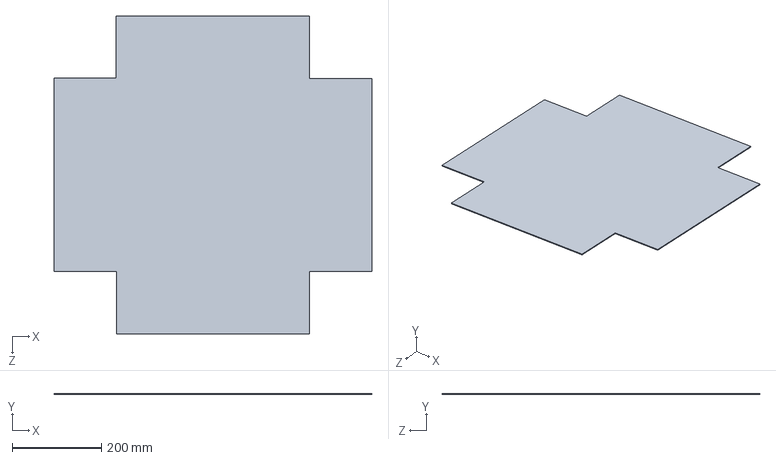
[picture p119: CAD file, 2025-03-22]
CAD/FRC/Graham/Solidworks Parts/Bellypans/Swerve Drive Bellypan.SLDPRT
711.2 x 2.25 x 711.2 mm
