dkittell/robotics-code-library/CAD/FRC/Isaiah/2024 robot idea 2.0.SLDPRT

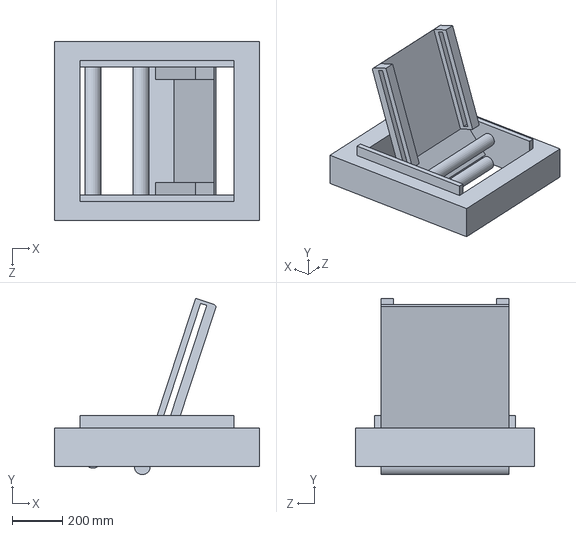
[picture p120: CAD file, 2025-03-22]
CAD/FRC/Isaiah/2024 robot idea 2.0.SLDPRT
812.8 x 698.9 x 711.2 mm
