dkittell/robotics-code-library/CAD/FRC/Liz/Assem1.sparkbox-Part2-1.STL

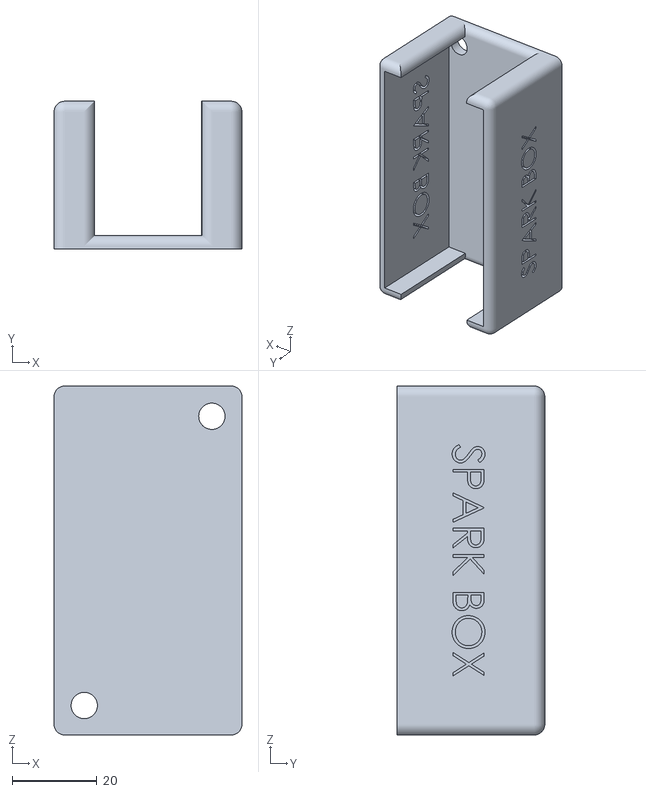
[picture p121: CAD file, 2025-03-22]
CAD/FRC/Liz/Assem1.sparkbox-Part2-1.STL
44.5 x 34.9 x 82.6
