dkittell/robotics-code-library/CAD/FRC/solidworks/swerve block.SLDPRT

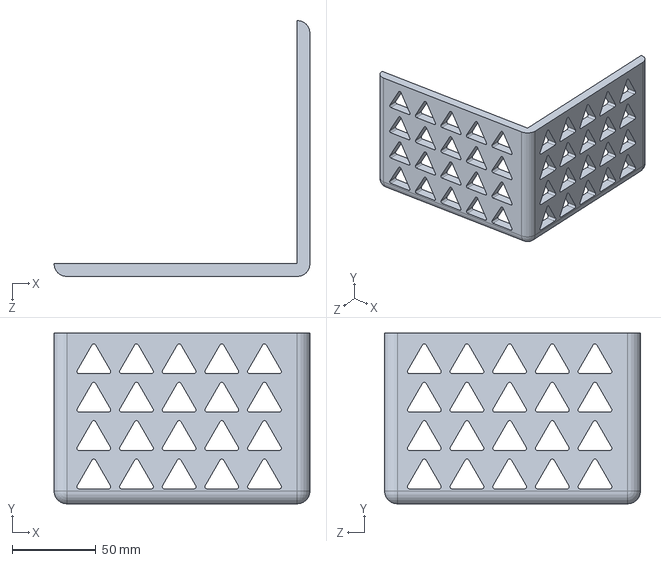
[picture p122: CAD file, 2025-03-22]
CAD/FRC/solidworks/swerve block.SLDPRT
152.4 x 101.6 x 152.4 mm
