dkittell/robotics-code-library/CAD/FRC/step/am-120AShield_AM.STEP

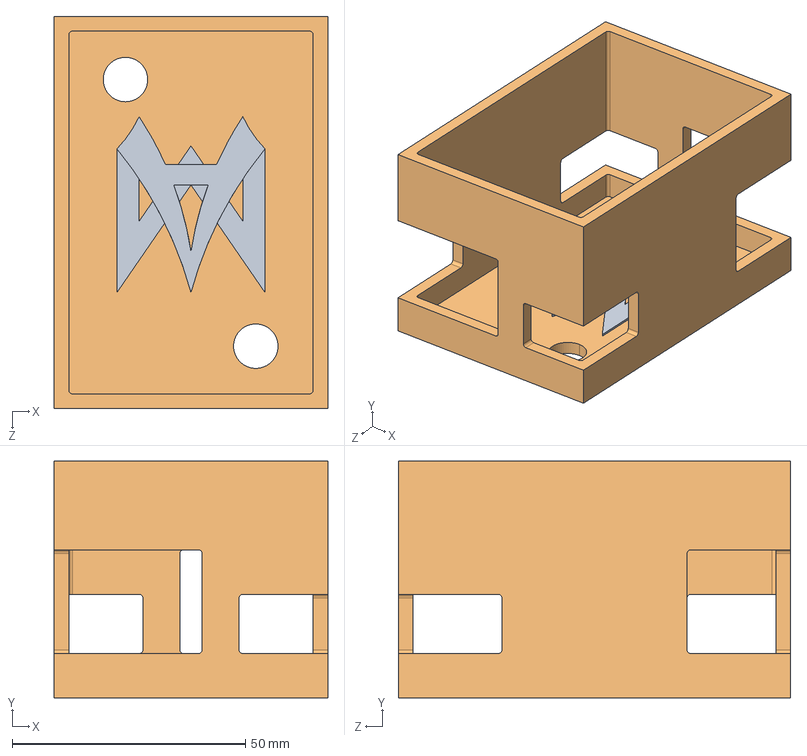
[picture p123: CAD file, 2025-03-22]
CAD/FRC/step/am-120AShield_AM.STEP
58.7 x 50.8 x 84.1 mm
