dkittell/robotics-code-library/CAD/FRC/stl/FRC Air Tank Mount - 685037/files/Tank_Mount_Triple.stl

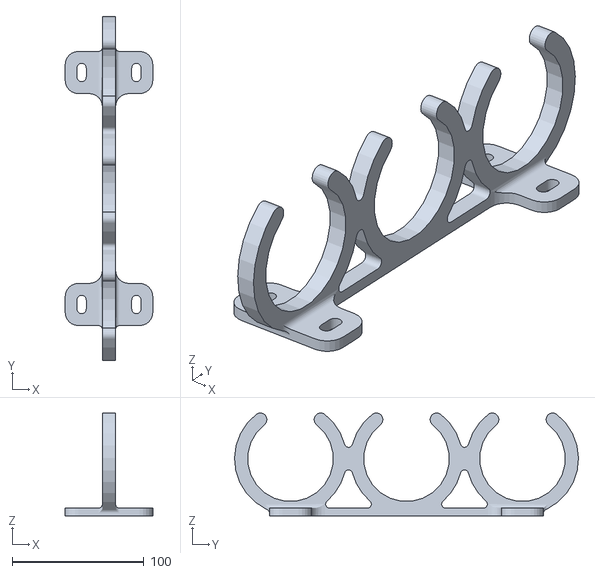
[picture p124: CAD file, 2025-03-22]
CAD/FRC/stl/FRC Air Tank Mount - 685037/files/Tank_Mount_Triple.stl
66.5 x 261.0 x 78.1
