dkittell/robotics-code-library/CAD/FRC/stl/Frc Breaker Shroud V2 - 6515696/files/Breaker_shroud_v2_bigger_set-ins.stl

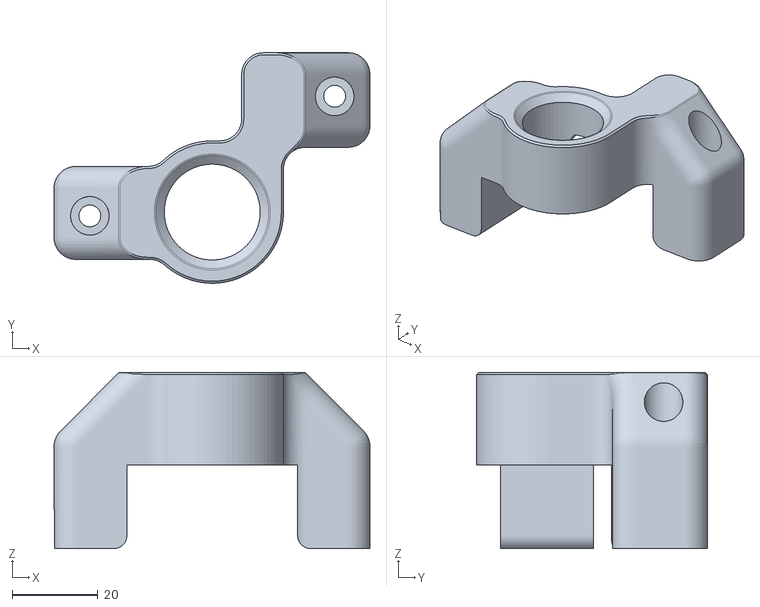
[picture p125: CAD file, 2025-03-22]
CAD/FRC/stl/Frc Breaker Shroud V2 - 6515696/files/Breaker_shroud_v2_bigger_set-ins.stl
73.8 x 53.8 x 41.1
