dkittell/robotics-code-library/CAD/FRC/stl/frc-reefscape-mini-field-model_files/barge.stl

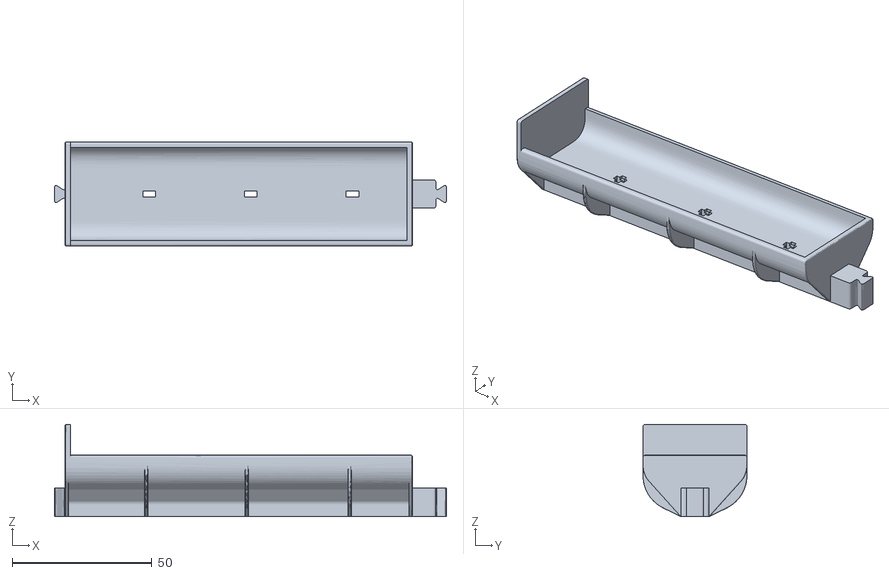
[picture p126: CAD file, 2025-03-22]
CAD/FRC/stl/frc-reefscape-mini-field-model_files/barge.stl
140.3 x 37.3 x 33.0
