dkittell/robotics-code-library/CAD/FRC/stl/FrontV4.stl

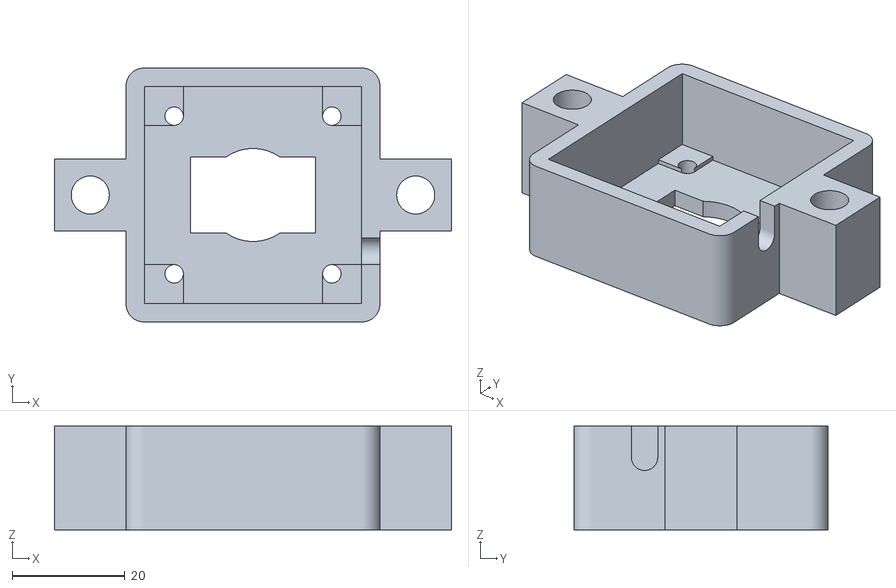
[picture p127: CAD file, 2025-03-22]
CAD/FRC/stl/FrontV4.stl
70.5 x 45.1 x 18.4
