dkittell/robotics-code-library/CAD/FRC/wheel2.0.AMF

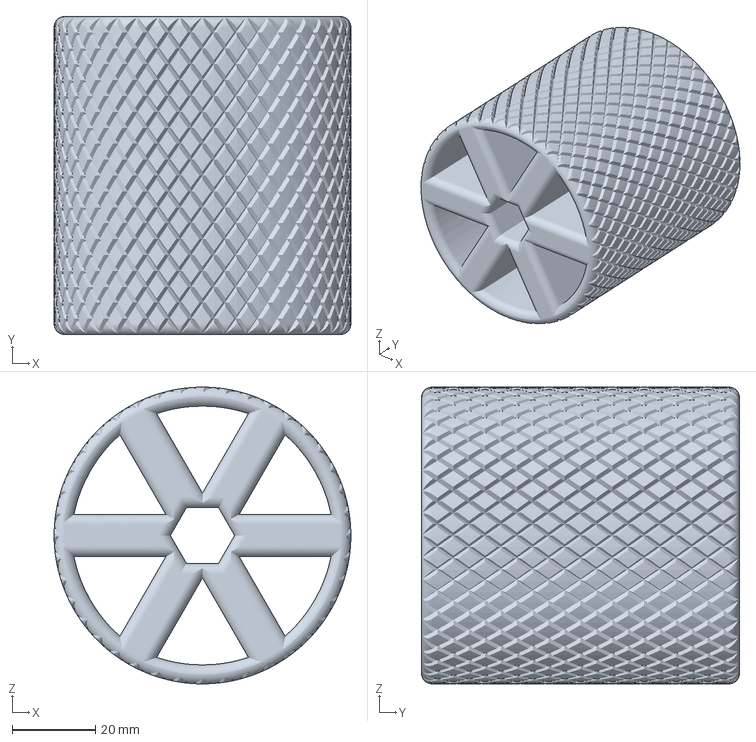
[picture p128: CAD file, 2025-03-22]
CAD/FRC/wheel2.0.AMF
71.1 x 76.2 x 71.1 mm
