dkittell/robotics-code-library/CAD/FTC-FRC/team_prop_big_basse_amr_down_right_numbers.stl

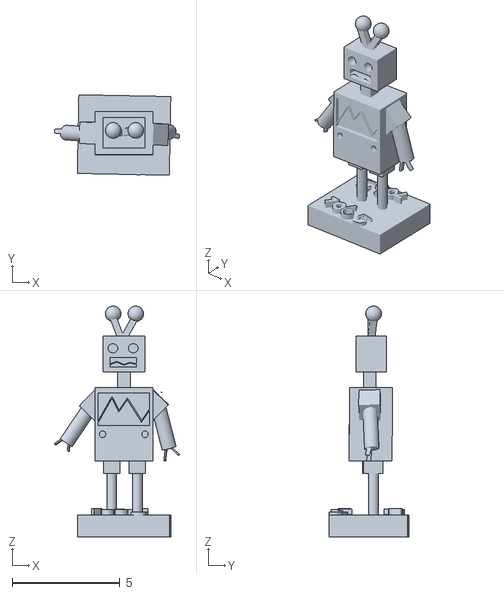
[picture p129: CAD file, 2025-03-22]
CAD/FTC-FRC/team_prop_big_basse_amr_down_right_numbers.stl
5.83 x 3.74 x 10.7
