dkittell/robotics-code-library/CAD/FTC-FRC/Thingiverse/Linear_Servo_Actuators_3170748/files/Pusher_100mm_Long.STL

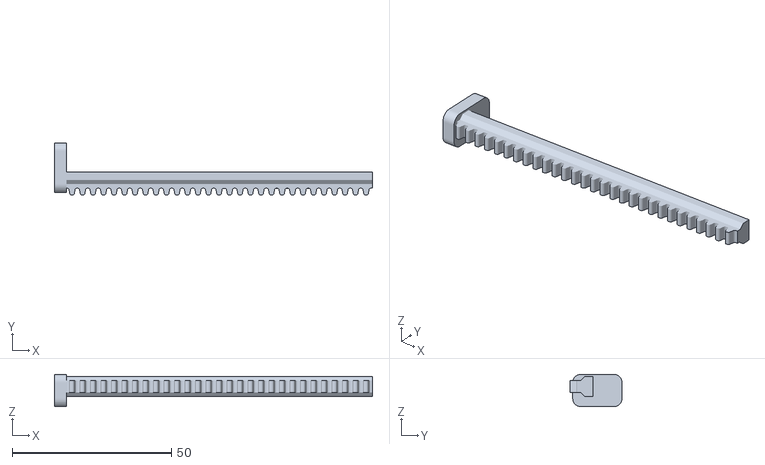
[picture p130: CAD file, 2025-03-22]
CAD/FTC-FRC/Thingiverse/Linear_Servo_Actuators_3170748/files/Pusher_100mm_Long.STL
100.0 x 16.3 x 10.2
