dkittell/robotics-code-library/CAD/FTC-FRC/Thingiverse/Linear_Servo_Actuators_3170748/files/Step Files- DIY Linear Servo/Pinion Gear, Mini Version.STEP

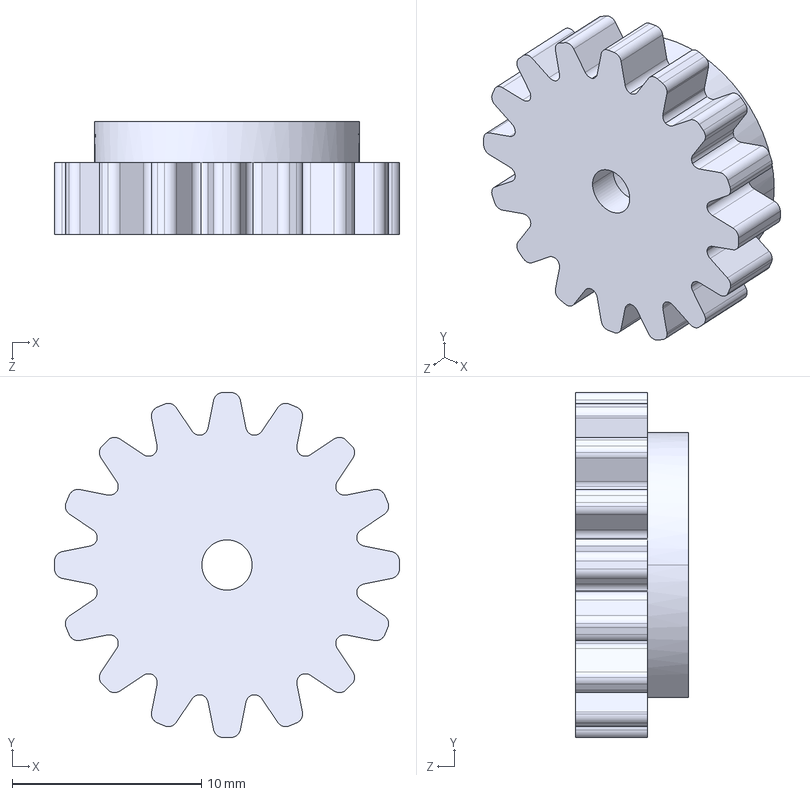
[picture p131: CAD file, 2025-03-22]
CAD/FTC-FRC/Thingiverse/Linear_Servo_Actuators_3170748/files/Step Files- DIY Linear Servo/Pinion Gear, Mini Version.STEP
18.2 x 18.2 x 5.97 mm
