dkittell/robotics-code-library/CAD/FTC-FRC/Thingiverse/NotUsing/8020_1515_bar_3663471/files/8020_1515_1in.stl

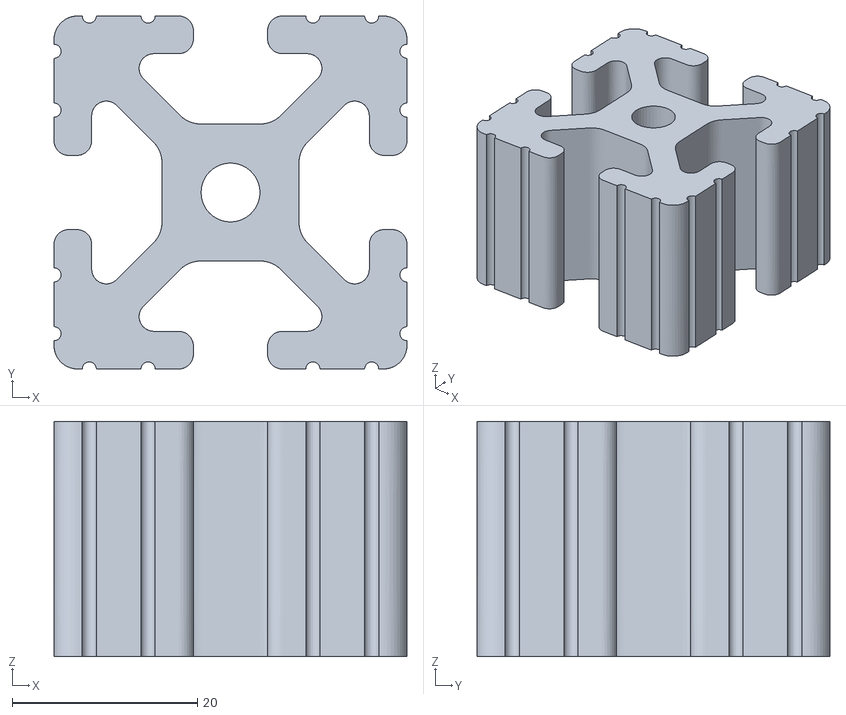
[picture p132: CAD file, 2025-03-22]
CAD/FTC-FRC/Thingiverse/NotUsing/8020_1515_bar_3663471/files/8020_1515_1in.stl
38.1 x 38.1 x 25.4
