dkittell/robotics-code-library/CAD/FTC-FRC/Thingiverse/NotUsing/Adjustable_2020_PTFE_Slider_1721338/files/2020_Adj._Slider_Inner.stl

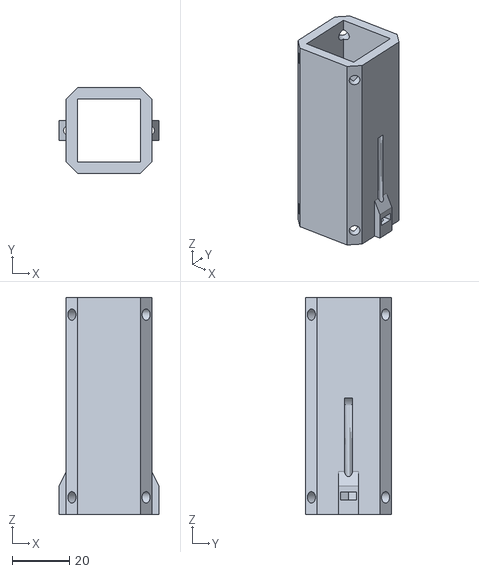
[picture p133: CAD file, 2025-03-22]
CAD/FTC-FRC/Thingiverse/NotUsing/Adjustable_2020_PTFE_Slider_1721338/files/2020_Adj._Slider_Inner.stl
35.0 x 30.0 x 76.0
