dkittell/robotics-code-library/CAD/FTC-FRC/Thingiverse/NotUsing/Aluminiumprofile_Slider___linear_guide_2572864/files/nut10_40_80.stl

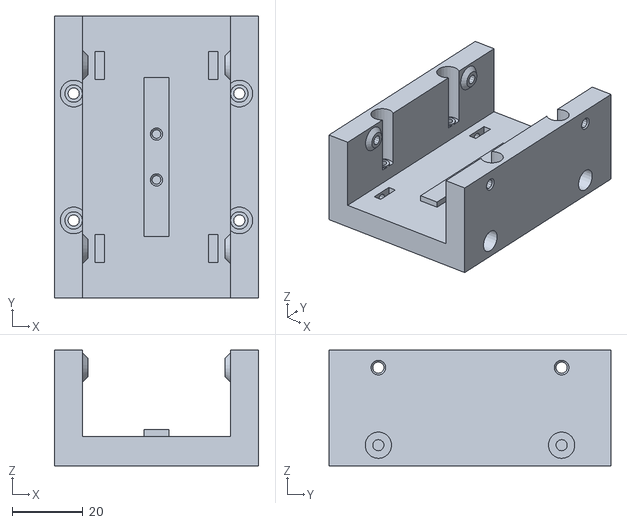
[picture p134: CAD file, 2025-03-22]
CAD/FTC-FRC/Thingiverse/NotUsing/Aluminiumprofile_Slider___linear_guide_2572864/files/nut10_40_80.stl
58.0 x 80.0 x 32.9
