dkittell/robotics-code-library/CAD/FTC-FRC/Thingiverse/NotUsing/Parametric_8020_cable_clip_134506/files/8020_cable_cover.stl

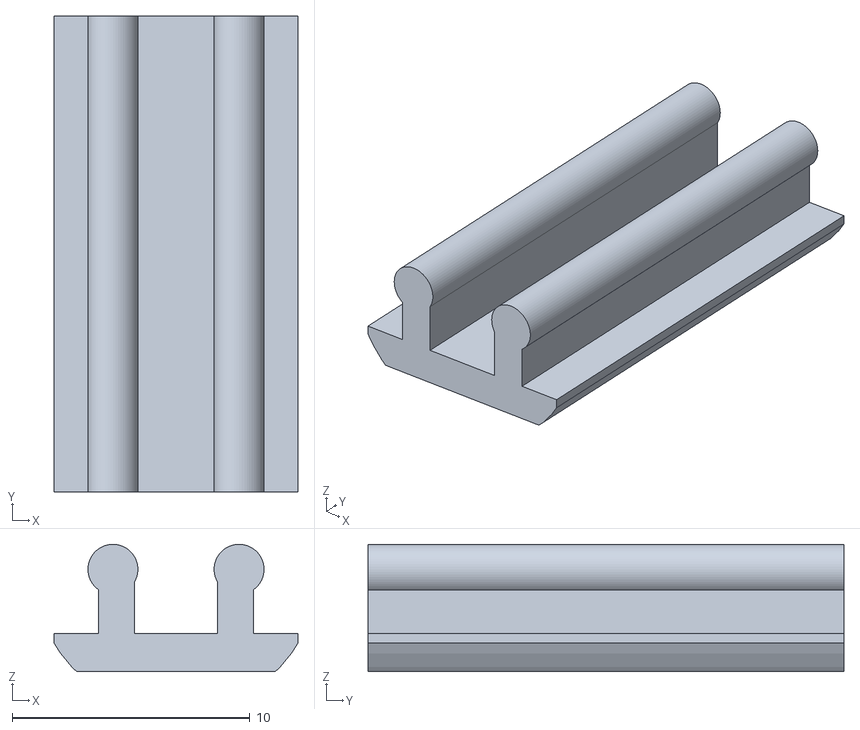
[picture p135: CAD file, 2025-03-22]
CAD/FTC-FRC/Thingiverse/NotUsing/Parametric_8020_cable_clip_134506/files/8020_cable_cover.stl
10.2 x 20.0 x 5.35
