dkittell/robotics-code-library/CAD/FTC-FRC/Thingiverse/NotUsing/Snap-in_Spool_Holder_for_8020__604530/files/extrusion_spool_holder.stl

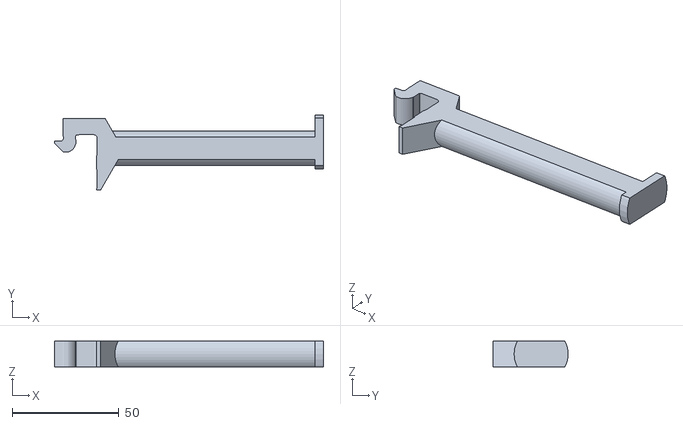
[picture p136: CAD file, 2025-03-22]
CAD/FTC-FRC/Thingiverse/NotUsing/Snap-in_Spool_Holder_for_8020__604530/files/extrusion_spool_holder.stl
126.2 x 35.4 x 12.0
