dkittell/robotics-code-library/CAD/FTC-FRC/Thingiverse/Using/8020_Linear_Bearing_1905754/files/LinearBearing.stl

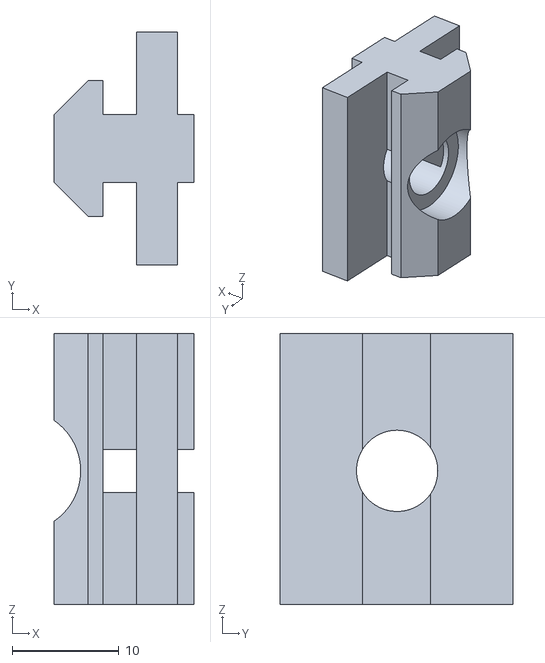
[picture p137: CAD file, 2025-03-22]
CAD/FTC-FRC/Thingiverse/Using/8020_Linear_Bearing_1905754/files/LinearBearing.stl
13.1 x 21.8 x 25.4
