dkittell/robotics-code-library/CAD/Fusion3/STL & Factory Files/Dropped spool holder 024 - R4.STL

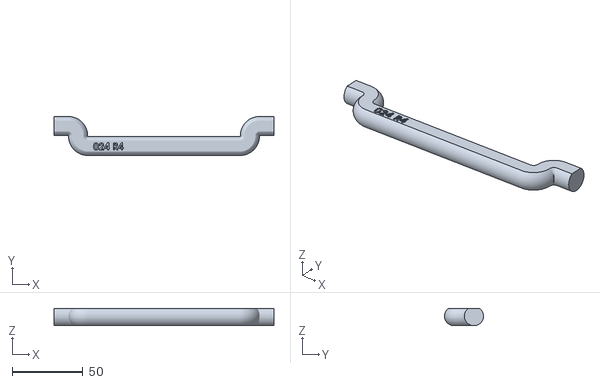
[picture p139: CAD file, 2025-03-22]
CAD/Fusion3/STL & Factory Files/Dropped spool holder 024 - R4.STL
155.0 x 27.5 x 12.3
