dkittell/robotics-code-library/FTC/2022/CONE_EOAT v2.STL

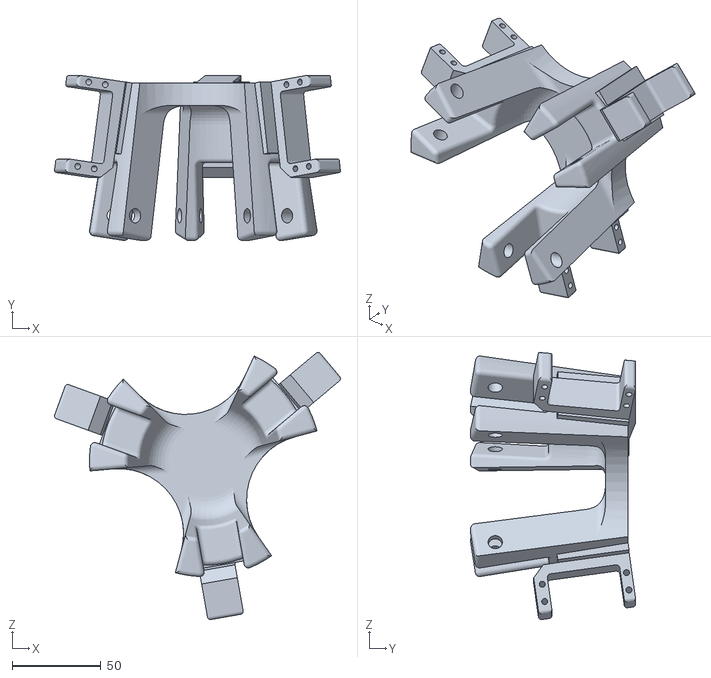
[picture p140: CAD file, 2025-03-22]
FTC/2022/CONE_EOAT v2.STL
161.4 x 93.1 x 150.8
