dkittell/robotics-code-library/CAD/FLL/First Lego League/files/square.stl

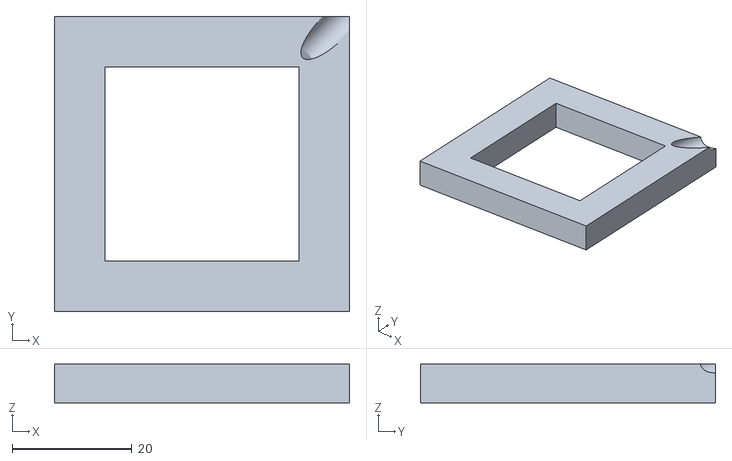
[picture p141: CAD file, 2025-03-22]
CAD/FLL/First Lego League/files/square.stl
49.3 x 49.3 x 6.47
