dkittell/robotics-code-library/CAD/FRC/3mf/FF_cableclip-large.3mf

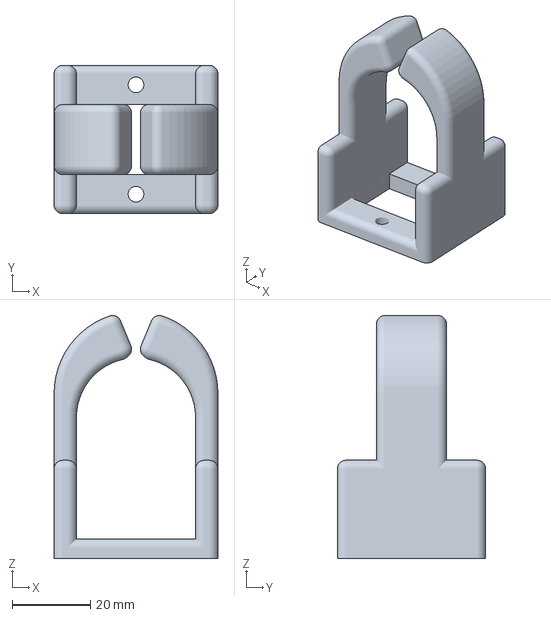
[picture p142: CAD file, 2025-03-22]
CAD/FRC/3mf/FF_cableclip-large.3mf
42.0 x 38.0 x 62.2 mm
