dkittell/robotics-code-library/CAD/FRC/Isaiah/baering chassis.SLDPRT

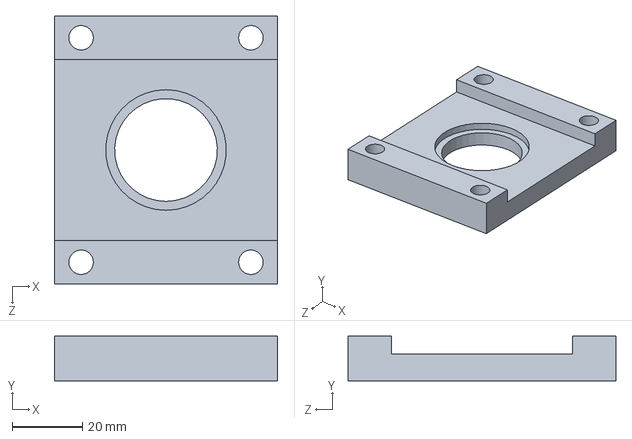
[picture p143: CAD file, 2025-03-22]
CAD/FRC/Isaiah/baering chassis.SLDPRT
63.5 x 12.7 x 76.2 mm
