dkittell/robotics-code-library/CAD/FRC/Liz/ralliht.0.01.STL

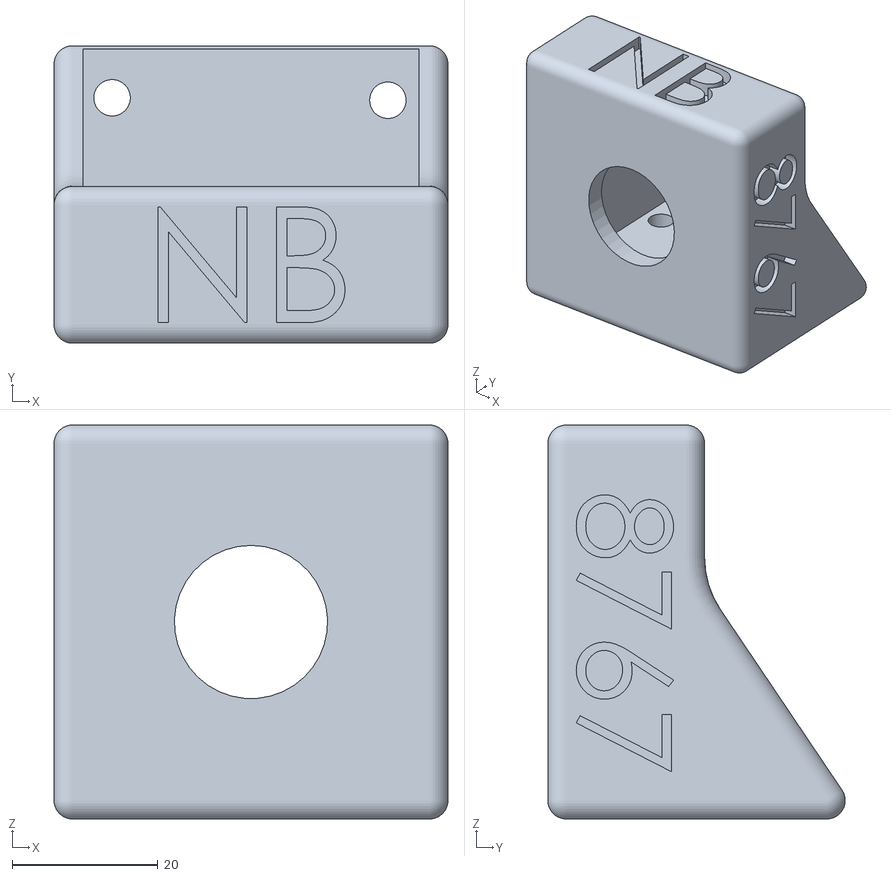
[picture p144: CAD file, 2025-03-22]
CAD/FRC/Liz/ralliht.0.01.STL
54.0 x 40.8 x 54.0
