dkittell/robotics-code-library/CAD/FRC/solidworks/tpuwheele.SLDPRT

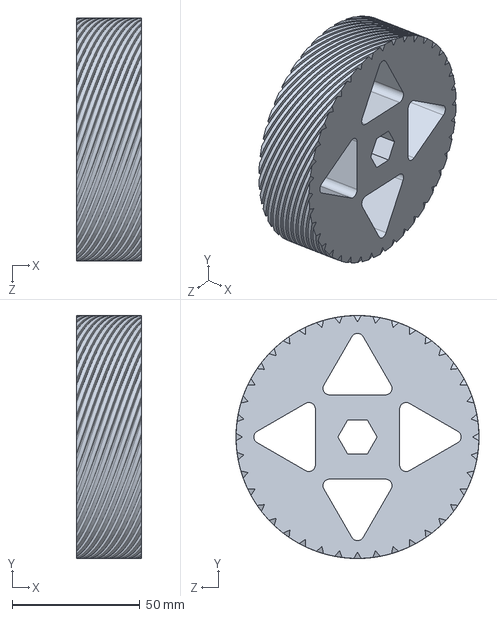
[picture p145: CAD file, 2025-03-22]
CAD/FRC/solidworks/tpuwheele.SLDPRT
25.4 x 95.2 x 95.2 mm
