dkittell/robotics-code-library/CAD/FRC/step/am-0588_short 8mm 500 Hex Adapter Shaft 500 long.STEP

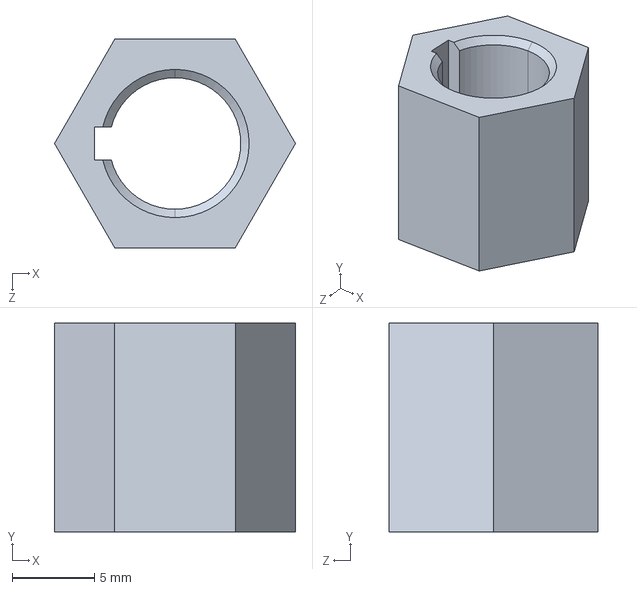
[picture p146: CAD file, 2025-03-22]
CAD/FRC/step/am-0588_short 8mm 500 Hex Adapter Shaft 500 long.STEP
14.7 x 12.7 x 12.7 mm
