dkittell/robotics-code-library/CAD/FRC/stl/BackV3.stl

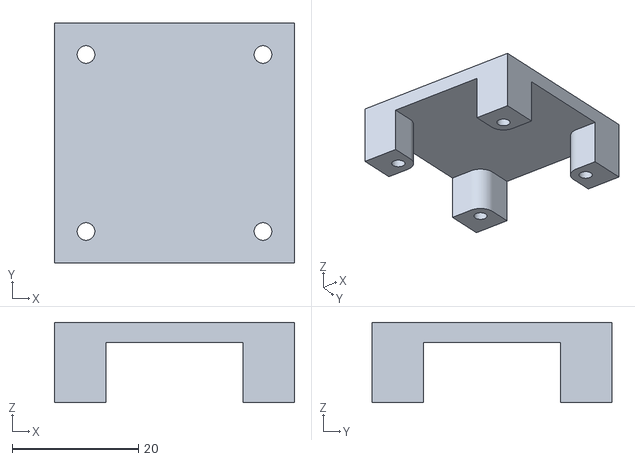
[picture p147: CAD file, 2025-03-22]
CAD/FRC/stl/BackV3.stl
38.0 x 38.0 x 12.7
