dkittell/robotics-code-library/CAD/FRC/stl/FRC Air Tank Mount - 685037/files/Tank_Mount_holes.stl

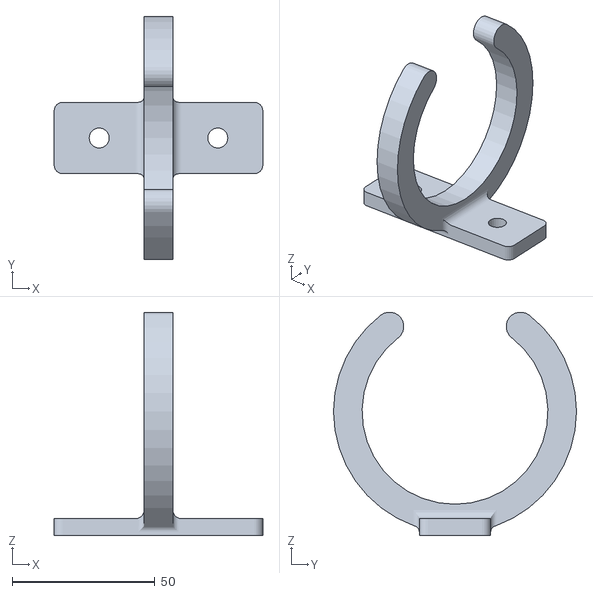
[picture p148: CAD file, 2025-03-22]
CAD/FRC/stl/FRC Air Tank Mount - 685037/files/Tank_Mount_holes.stl
73.0 x 85.0 x 78.1
