dkittell/robotics-code-library/CAD/FRC/stl/Frc Breaker Shroud V2 - 6515696/files/Breaker+shroud+v2.stl

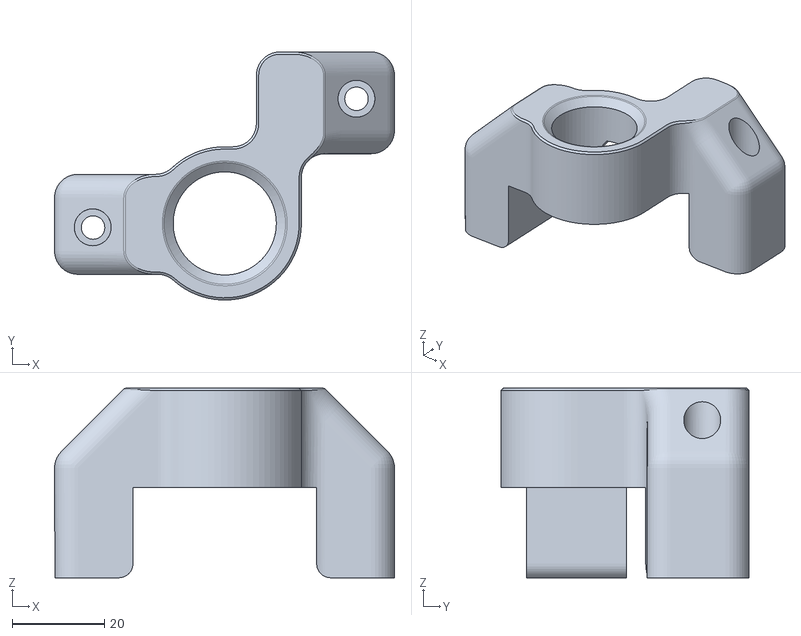
[picture p149: CAD file, 2025-03-22]
CAD/FRC/stl/Frc Breaker Shroud V2 - 6515696/files/Breaker+shroud+v2.stl
73.8 x 53.8 x 41.1
