dkittell/robotics-code-library/CAD/FRC/stl/frc-reefscape-mini-field-model_files/shallow-climb.stl

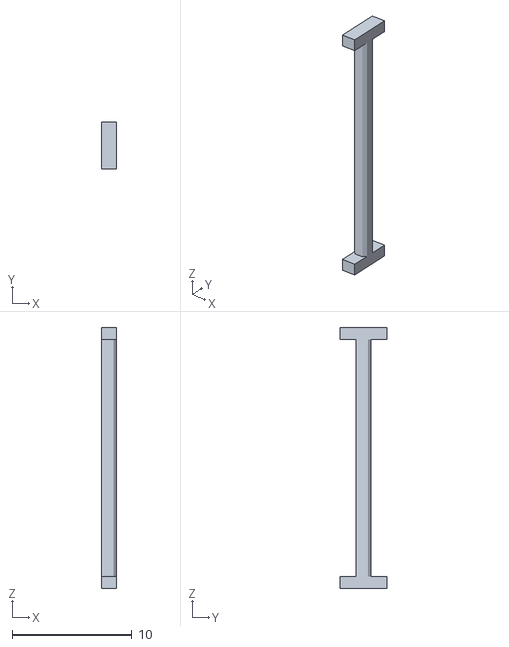
[picture p150: CAD file, 2025-03-22]
CAD/FRC/stl/frc-reefscape-mini-field-model_files/shallow-climb.stl
1.25 x 3.90 x 21.8
