dkittell/robotics-code-library/CAD/FTC-FRC/Thingiverse/Linear_Servo_Actuators_3170748/files/Step Files- DIY Linear Servo/Pusher, 75mm Long.STEP

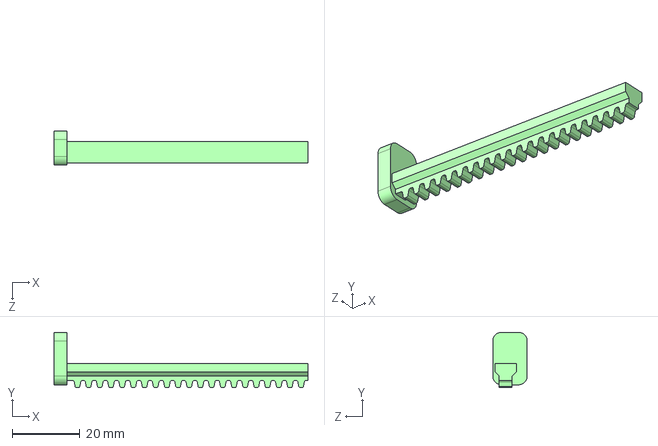
[picture p151: CAD file, 2025-03-22]
CAD/FTC-FRC/Thingiverse/Linear_Servo_Actuators_3170748/files/Step Files- DIY Linear Servo/Pusher, 75mm Long.STEP
75.0 x 16.3 x 10.2 mm
