dkittell/robotics-code-library/CAD/FTC-FRC/Thingiverse/NotUsing/8020_15-series_bracket_collection_3669194/files/8020_4332_2-hole_gusseted_inside_corner_bracket.stl

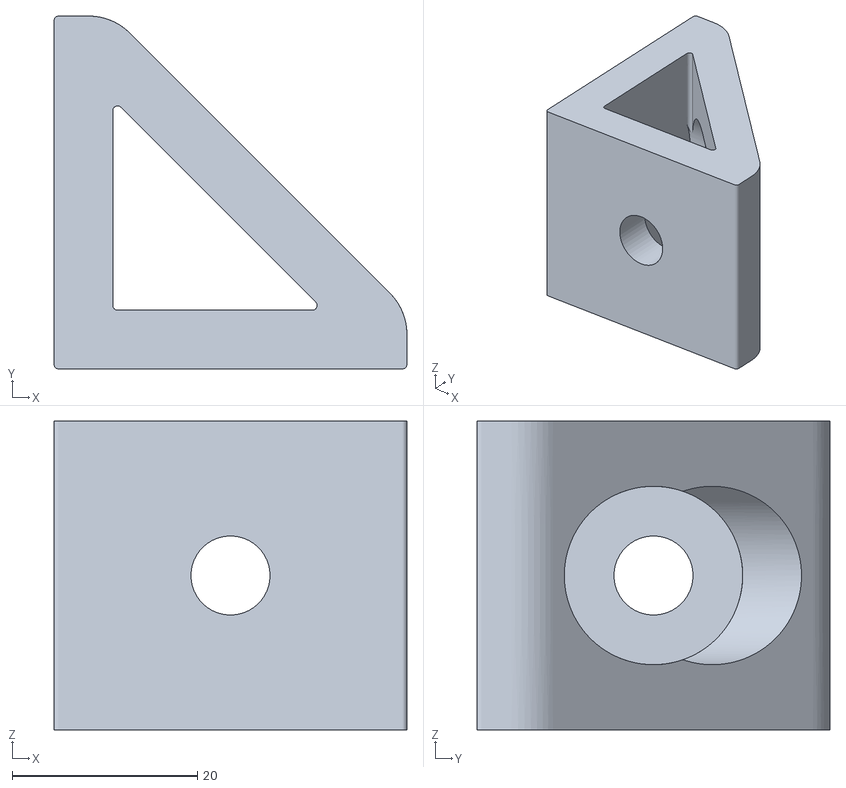
[picture p152: CAD file, 2025-03-22]
CAD/FTC-FRC/Thingiverse/NotUsing/8020_15-series_bracket_collection_3669194/files/8020_4332_2-hole_gusseted_inside_corner_bracket.stl
38.1 x 38.1 x 33.3
