dkittell/robotics-code-library/CAD/FTC-FRC/Thingiverse/NotUsing/Adjustable_2020_PTFE_Slider_1721338/files/2020_Adj._Slider_Body.stl

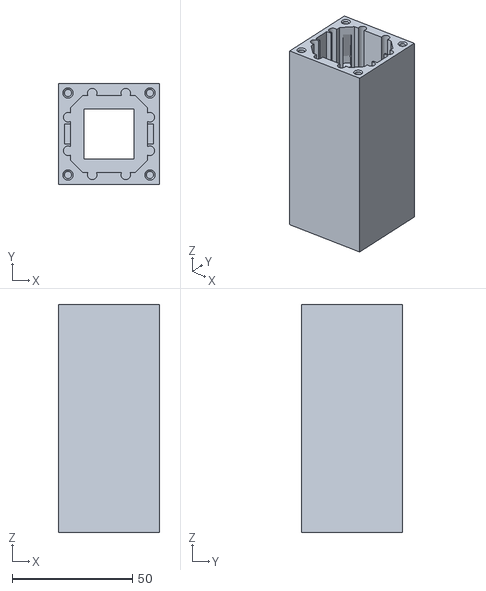
[picture p153: CAD file, 2025-03-22]
CAD/FTC-FRC/Thingiverse/NotUsing/Adjustable_2020_PTFE_Slider_1721338/files/2020_Adj._Slider_Body.stl
42.0 x 42.0 x 95.0
