dkittell/robotics-code-library/CAD/FTC/Battery_Holder.stl

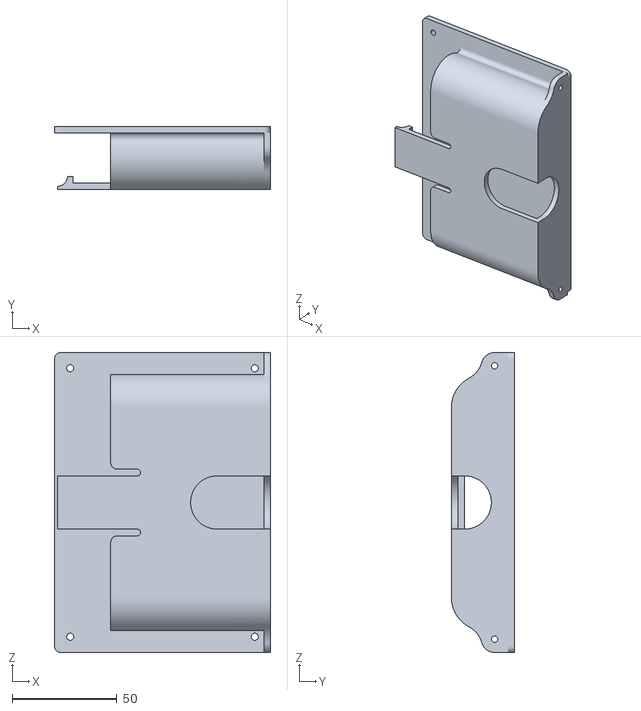
[picture p155: CAD file, 2025-03-22]
CAD/FTC/Battery_Holder.stl
103.0 x 30.2 x 143.0
