dkittell/robotics-code-library/FTC/2022/am-4018_Stone.STEP

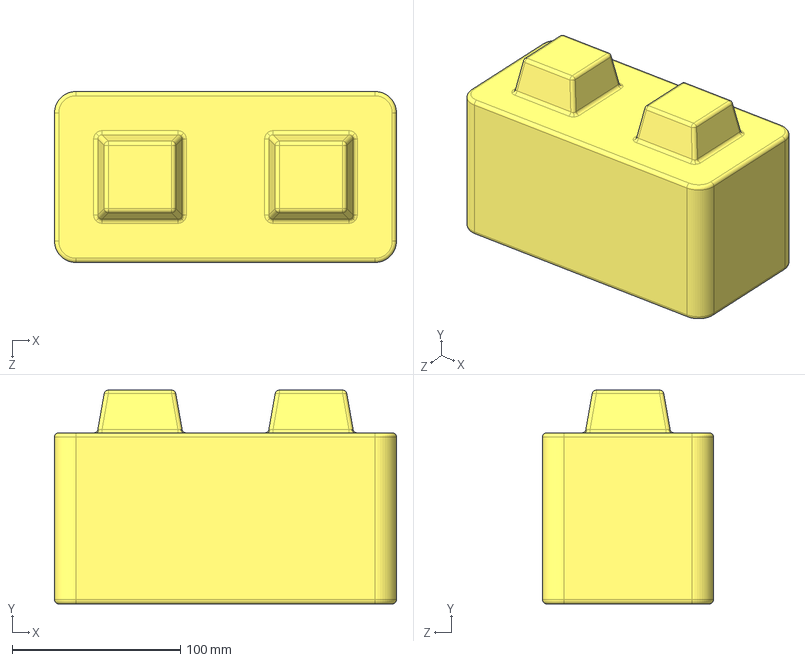
[picture p156: CAD file, 2025-03-22]
FTC/2022/am-4018_Stone.STEP
203.2 x 127.0 x 101.6 mm
