dkittell/robotics-code-library/CAD/FLL/First Lego League/files/circle.stl

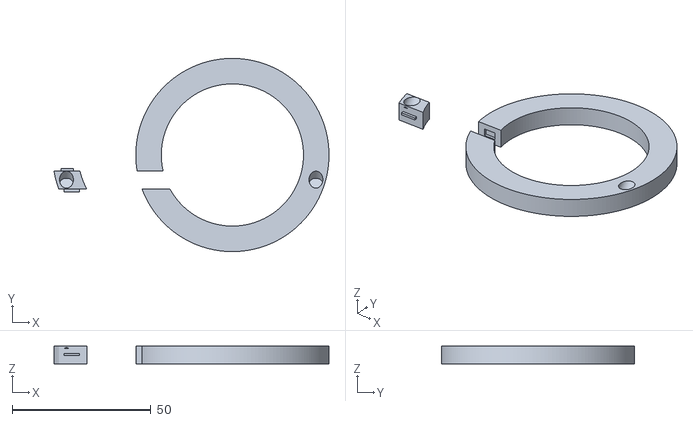
[picture p157: CAD file, 2025-03-22]
CAD/FLL/First Lego League/files/circle.stl
99.2 x 69.7 x 6.47
