dkittell/robotics-code-library/CAD/FRC/3mf/FF_RoboRioExtraPinPlug.3mf

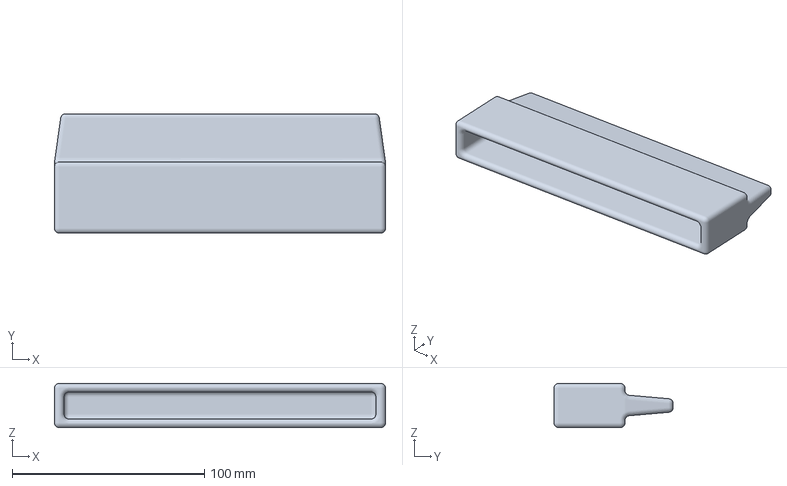
[picture p158: CAD file, 2025-03-22]
CAD/FRC/3mf/FF_RoboRioExtraPinPlug.3mf
172.0 x 62.0 x 23.0 mm
