dkittell/robotics-code-library/CAD/FRC/Isaiah/2024 robot idea.SLDPRT

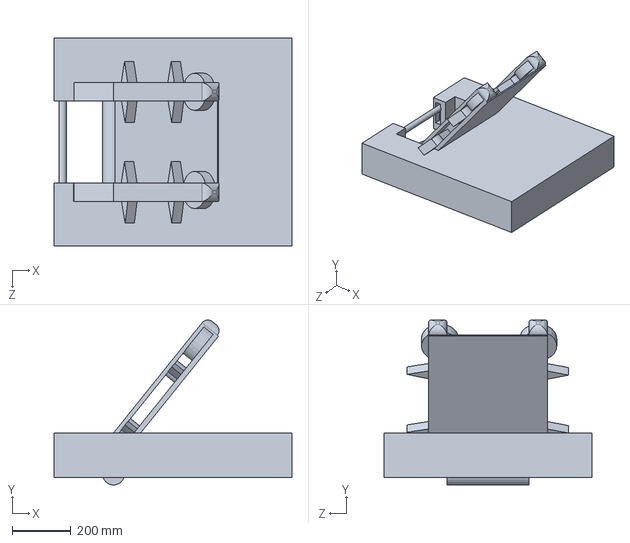
[picture p159: CAD file, 2025-03-22]
CAD/FRC/Isaiah/2024 robot idea.SLDPRT
812.8 x 563.4 x 711.2 mm
