dkittell/robotics-code-library/CAD/FRC/solidworks/twopartcoller.SLDPRT

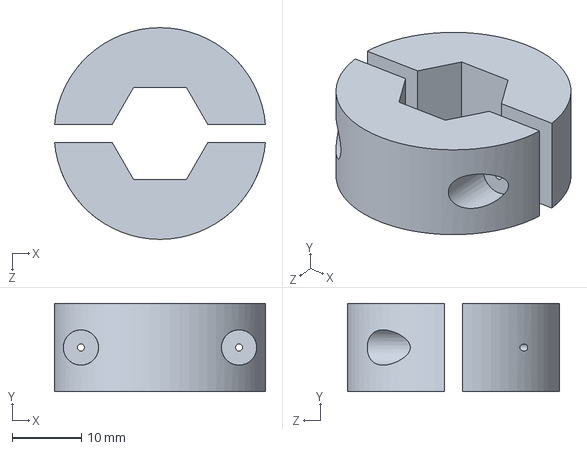
[picture p160: CAD file, 2025-03-22]
CAD/FRC/solidworks/twopartcoller.SLDPRT
30.4 x 12.7 x 30.5 mm
