dkittell/robotics-code-library/CAD/FRC/step/RSL Bracket - 8711.step

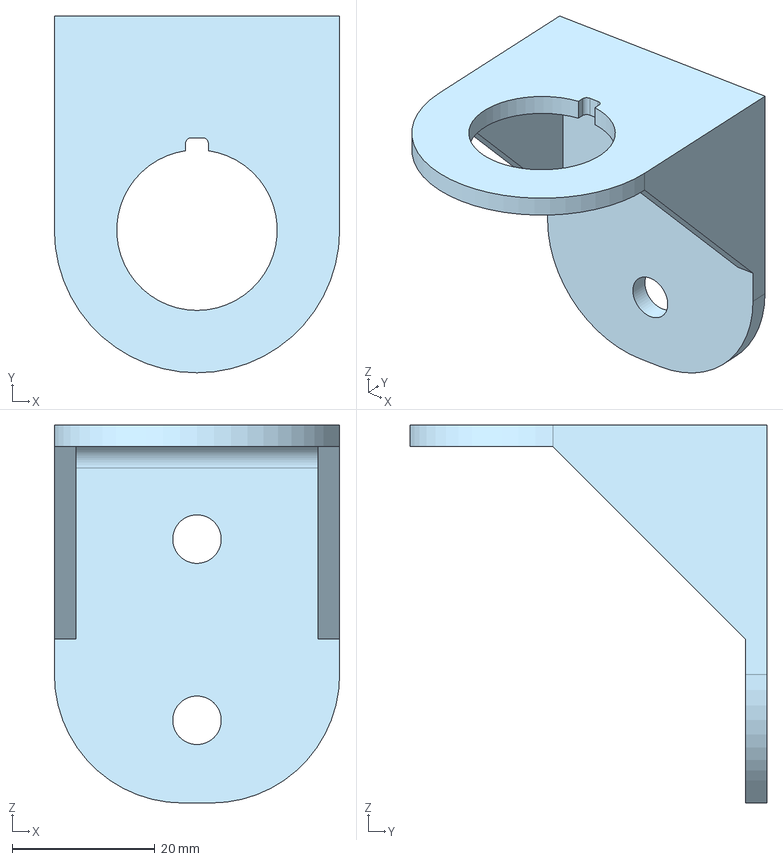
[picture p161: CAD file, 2025-03-22]
CAD/FRC/step/RSL Bracket - 8711.step
40.0 x 50.0 x 53.0 mm
