dkittell/robotics-code-library/CAD/FRC/stl/elevatorShim2.stl

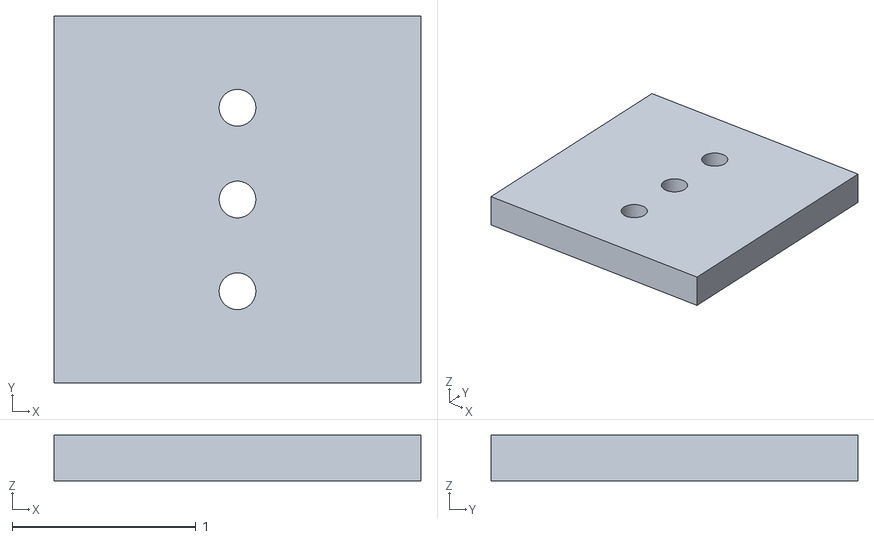
[picture p162: CAD file, 2025-03-22]
CAD/FRC/stl/elevatorShim2.stl
2.00 x 2.00 x 0.25
