dkittell/robotics-code-library/CAD/FRC/stl/frc-reefscape-mini-field-model_files/center-post.stl

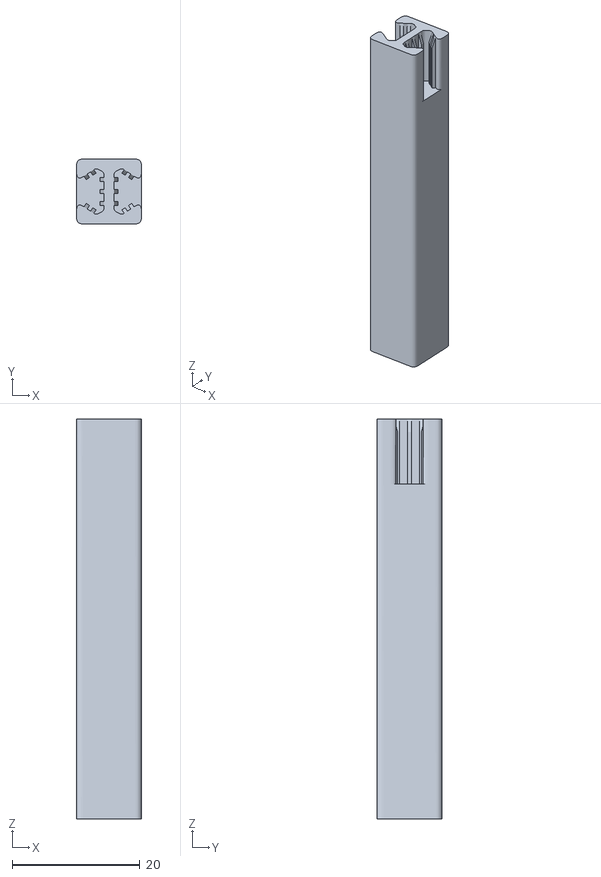
[picture p163: CAD file, 2025-03-22]
CAD/FRC/stl/frc-reefscape-mini-field-model_files/center-post.stl
10.2 x 10.2 x 62.7
