dkittell/robotics-code-library/CAD/FTC-FRC/Thingiverse/Linear_Servo_Actuators_3170748/files/Step Files- DIY Linear Servo/Pinion Gear, Large Version.STEP

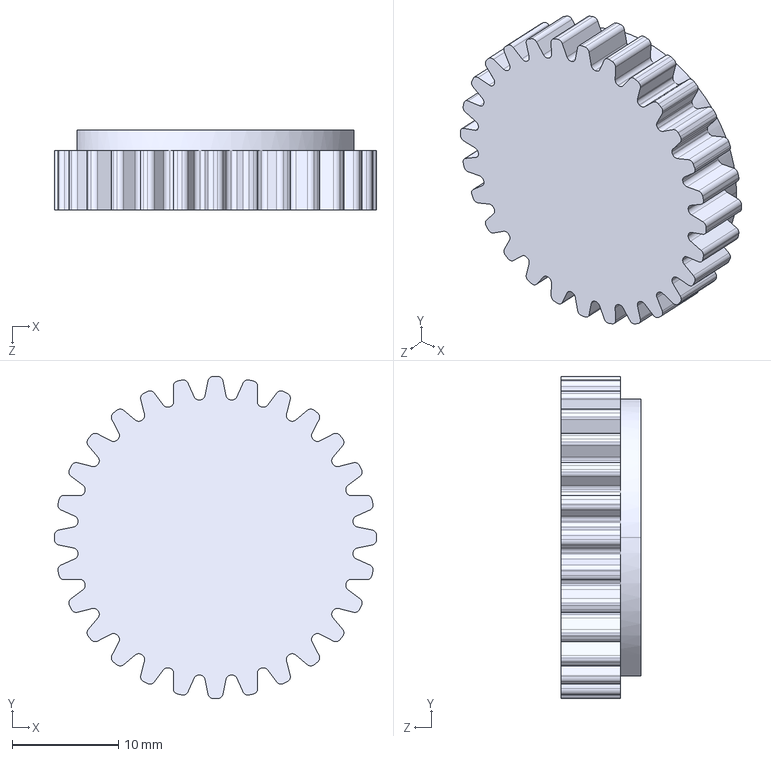
[picture p164: CAD file, 2025-03-22]
CAD/FTC-FRC/Thingiverse/Linear_Servo_Actuators_3170748/files/Step Files- DIY Linear Servo/Pinion Gear, Large Version.STEP
30.2 x 30.2 x 7.51 mm
