dkittell/robotics-code-library/CAD/FTC-FRC/Thingiverse/NotUsing/Aluminiumprofile_Slider___linear_guide_2572864/files/nut8_30_80.stl

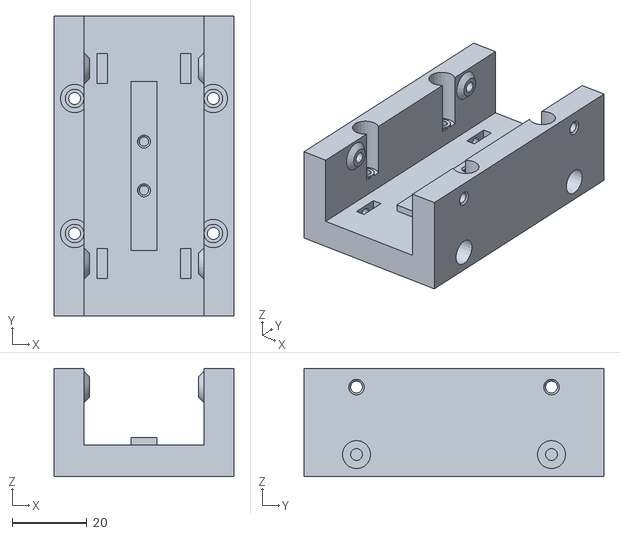
[picture p167: CAD file, 2025-03-22]
CAD/FTC-FRC/Thingiverse/NotUsing/Aluminiumprofile_Slider___linear_guide_2572864/files/nut8_30_80.stl
48.0 x 80.0 x 28.9
