dkittell/robotics-code-library/CAD/FTC/Battery_Holder_Side_Load.stl

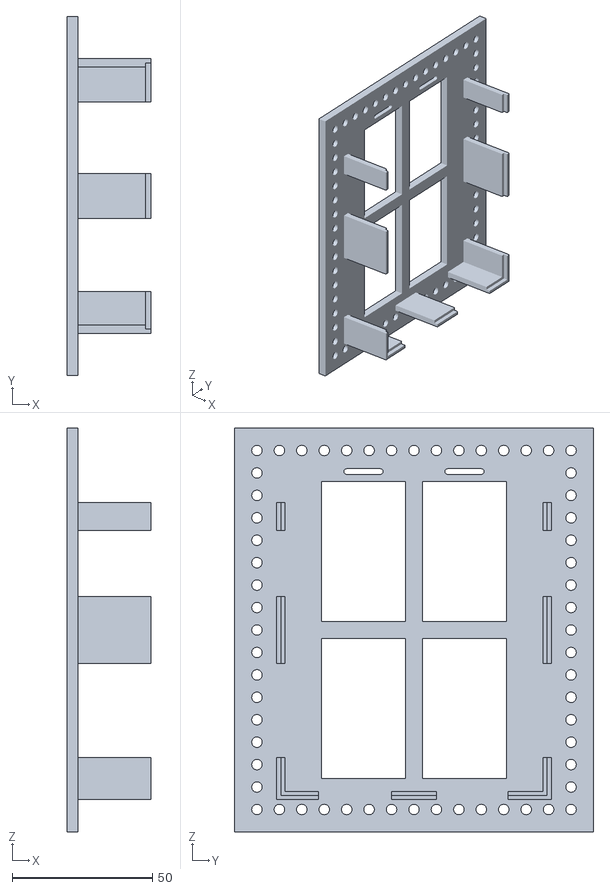
[picture p168: CAD file, 2025-03-22]
CAD/FTC/Battery_Holder_Side_Load.stl
30.0 x 128.0 x 144.0
