dkittell/robotics-code-library/CAD/FRC/3mf/pillow blocks elevator.3mf

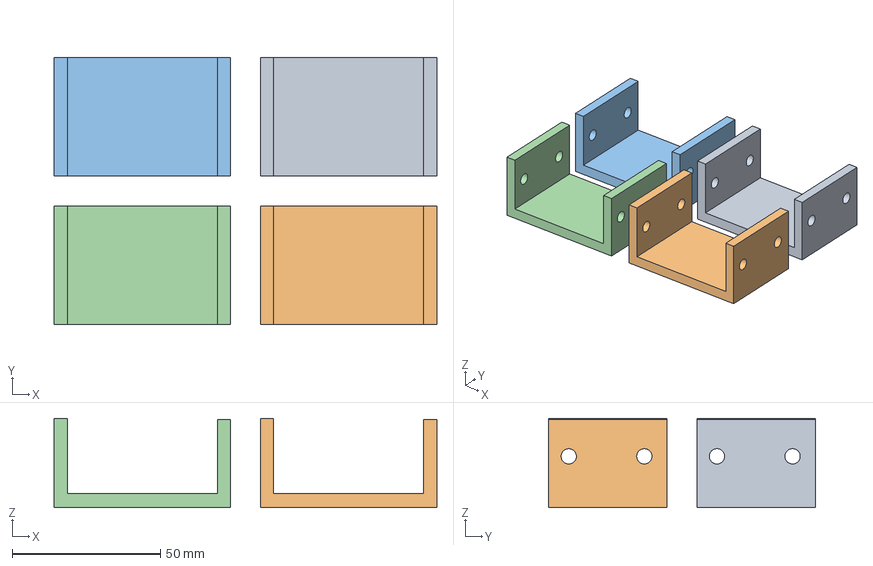
[picture p169: CAD file, 2025-03-22]
CAD/FRC/3mf/pillow blocks elevator.3mf
129.2 x 90.0 x 30.1 mm
Untitled.stl x 4
