dkittell/robotics-code-library/CAD/FRC/Isaiah/intake wheel test.SLDPRT

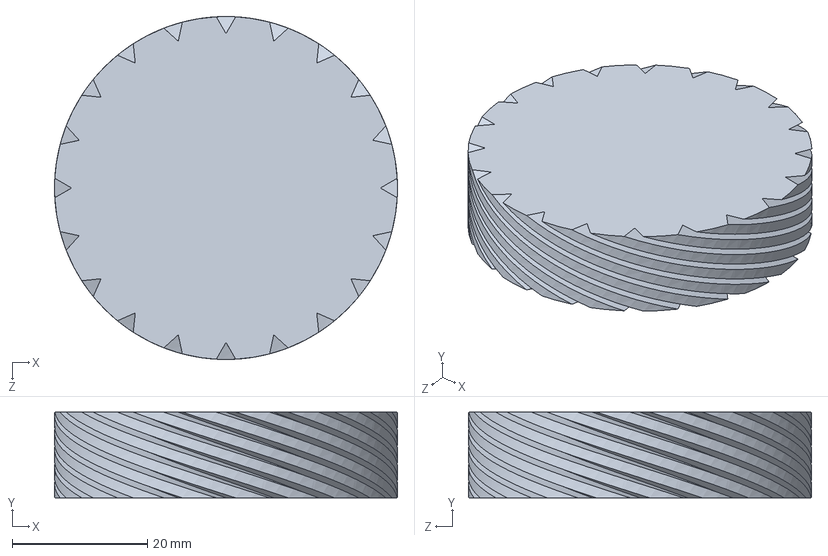
[picture p170: CAD file, 2025-03-22]
CAD/FRC/Isaiah/intake wheel test.SLDPRT
50.8 x 12.7 x 50.8 mm
