dkittell/robotics-code-library/CAD/FRC/Liz/horse8767.STL

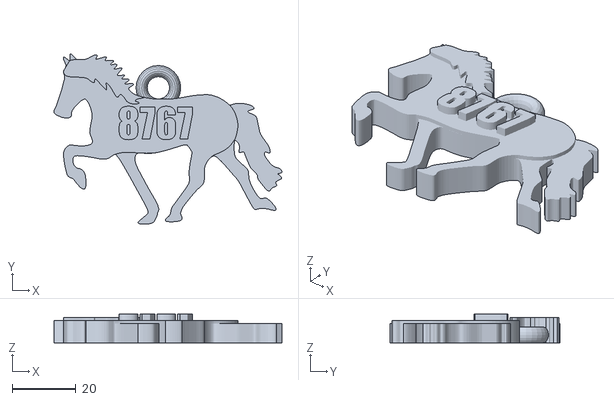
[picture p171: CAD file, 2025-03-22]
CAD/FRC/Liz/horse8767.STL
71.4 x 53.4 x 9.00
