dkittell/robotics-code-library/CAD/FRC/solidworks/shooterpanel1.0.SLDPRT

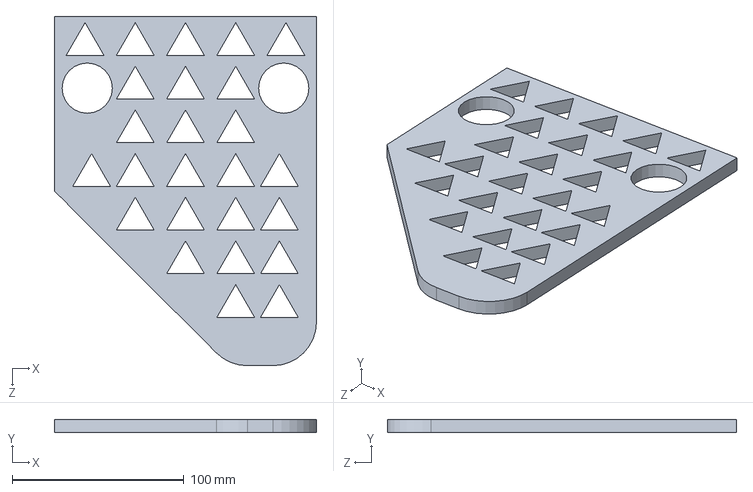
[picture p172: CAD file, 2025-03-22]
CAD/FRC/solidworks/shooterpanel1.0.SLDPRT
152.4 x 7.62 x 203.2 mm
