dkittell/robotics-code-library/CAD/FRC/step/3DPrintedBracketforOpenMeshRadio.STEP

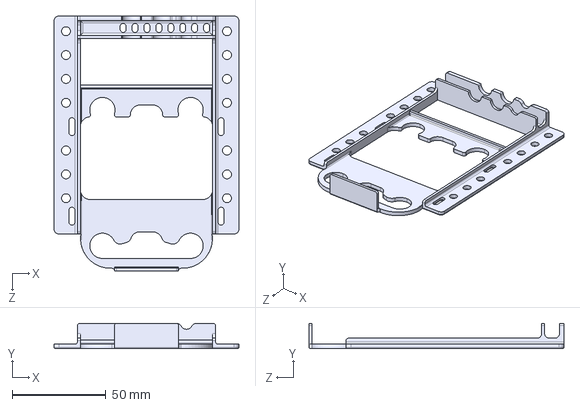
[picture p173: CAD file, 2025-03-22]
CAD/FRC/step/3DPrintedBracketforOpenMeshRadio.STEP
98.4 x 13.5 x 135.7 mm
