dkittell/robotics-code-library/CAD/FRC/stl/frc-reefscape-mini-field-model_files/reef-base.stl

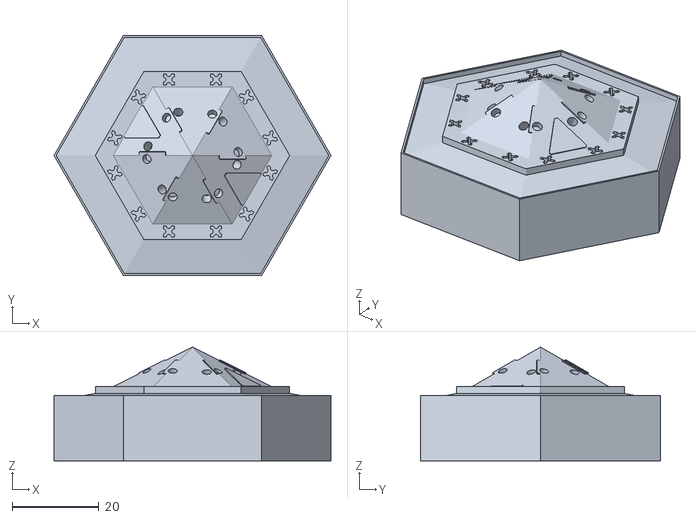
[picture p174: CAD file, 2025-03-22]
CAD/FRC/stl/frc-reefscape-mini-field-model_files/reef-base.stl
64.0 x 55.4 x 26.3
