dkittell/robotics-code-library/CAD/FTC-FRC/Thingiverse/Linear_Servo_Actuators_3170748/files/Motor_Bracket_Mini_Version.STL

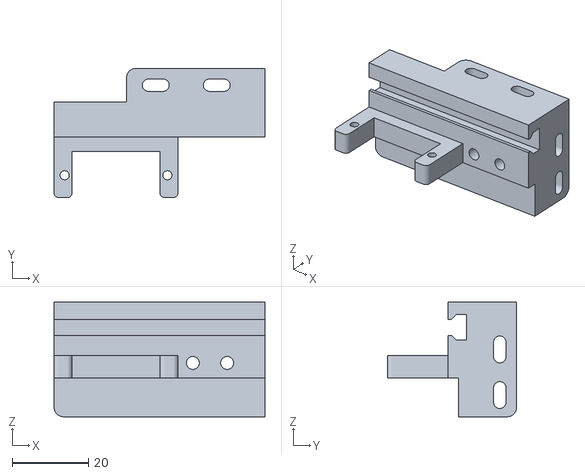
[picture p175: CAD file, 2025-03-22]
CAD/FTC-FRC/Thingiverse/Linear_Servo_Actuators_3170748/files/Motor_Bracket_Mini_Version.STL
55.5 x 34.0 x 30.1
