dkittell/robotics-code-library/CAD/FTC-FRC/Thingiverse/NotUsing/Adjustable_2020_PTFE_Slider_1721338/files/2020_Adj._Slider_Cutter.stl

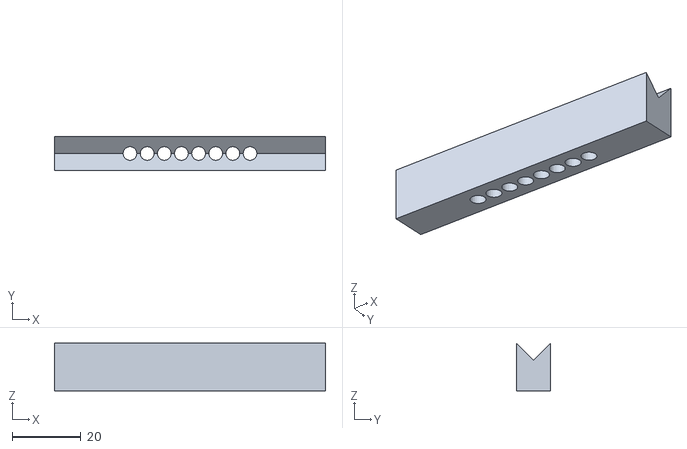
[picture p177: CAD file, 2025-03-22]
CAD/FTC-FRC/Thingiverse/NotUsing/Adjustable_2020_PTFE_Slider_1721338/files/2020_Adj._Slider_Cutter.stl
79.0 x 10.00 x 14.0
