dkittell/robotics-code-library/CAD/FTC-FRC/Thingiverse/NotUsing/Aluminiumprofile_Slider___linear_guide_2572864/files/nut8_40_60.stl

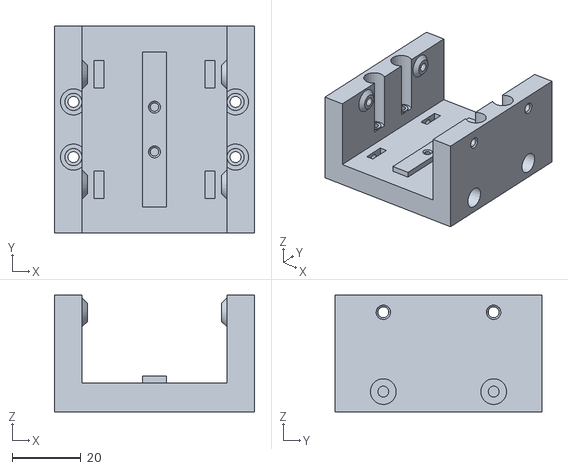
[picture p178: CAD file, 2025-03-22]
CAD/FTC-FRC/Thingiverse/NotUsing/Aluminiumprofile_Slider___linear_guide_2572864/files/nut8_40_60.stl
58.0 x 60.0 x 33.9
