dkittell/robotics-code-library/CAD/FTC/minn_Bill_2.stl

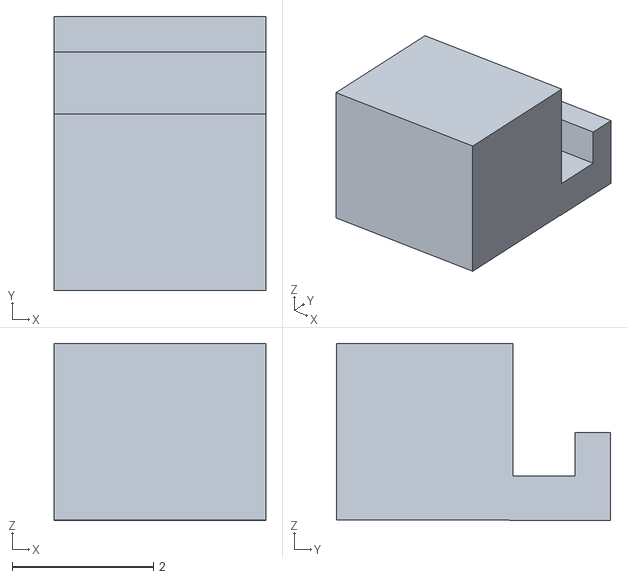
[picture p179: CAD file, 2025-03-22]
CAD/FTC/minn_Bill_2.stl
3.00 x 3.88 x 2.51
