dkittell/robotics-code-library/CAD/FLL/First Lego League/files/support.stl

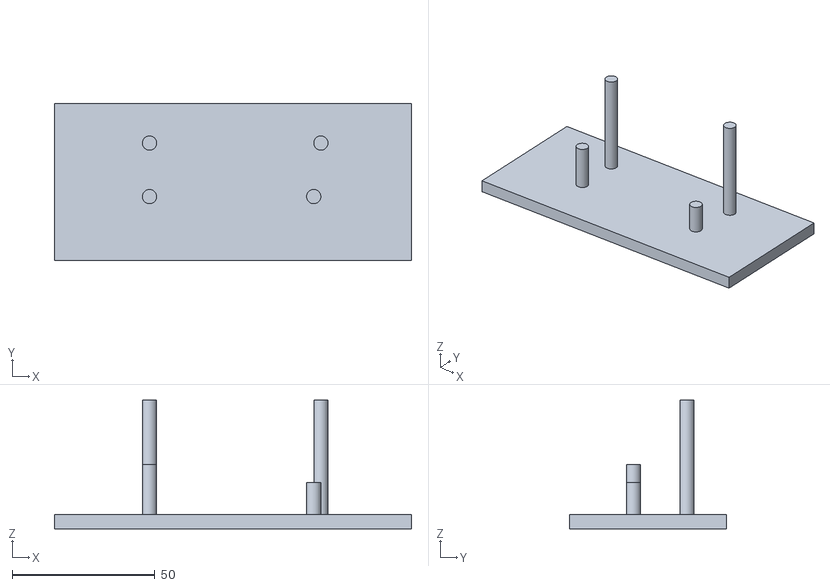
[picture p180: CAD file, 2025-03-22]
CAD/FLL/First Lego League/files/support.stl
125.0 x 55.0 x 45.0
