dkittell/robotics-code-library/CAD/FRC/3mf/FF_Improved_Base.3mf

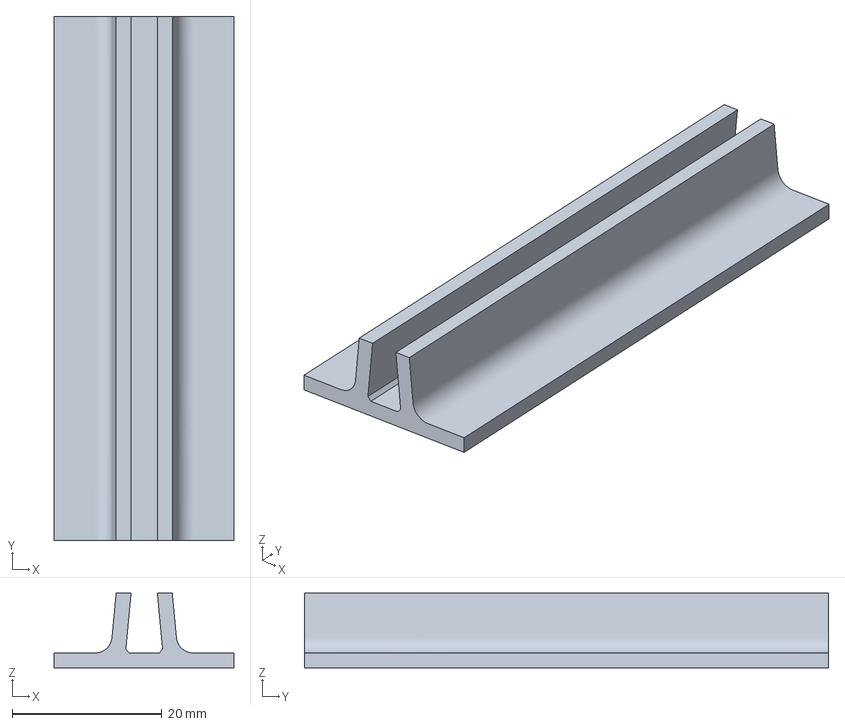
[picture p181: CAD file, 2025-03-22]
CAD/FRC/3mf/FF_Improved_Base.3mf
24.0 x 70.0 x 10.0 mm
