dkittell/robotics-code-library/CAD/FRC/Isaiah/arm.STL

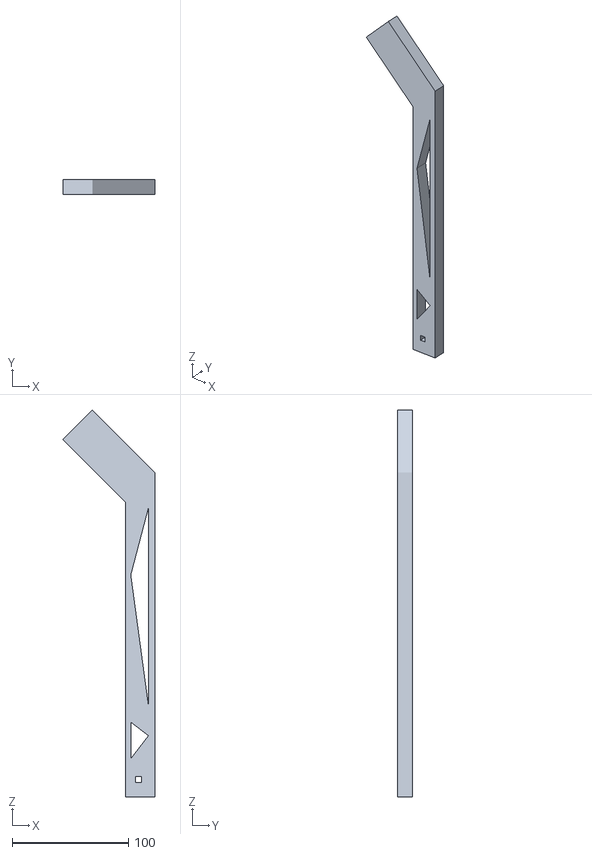
[picture p182: CAD file, 2025-03-22]
CAD/FRC/Isaiah/arm.STL
79.3 x 12.7 x 333.3
