dkittell/robotics-code-library/CAD/FRC/Liz/SPARKBOX.STL

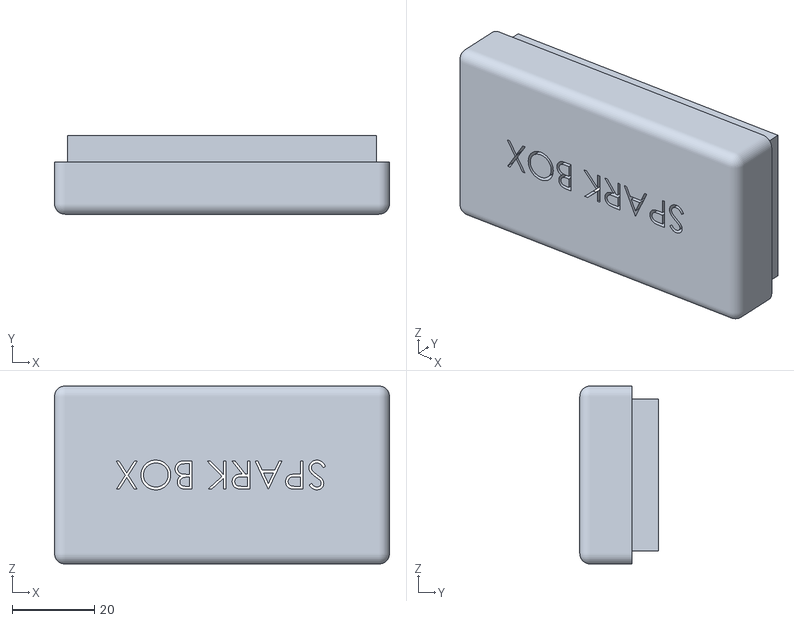
[picture p183: CAD file, 2025-03-22]
CAD/FRC/Liz/SPARKBOX.STL
81.3 x 19.1 x 43.2
