dkittell/robotics-code-library/CAD/FRC/solidworks/wheel3.0.SLDPRT

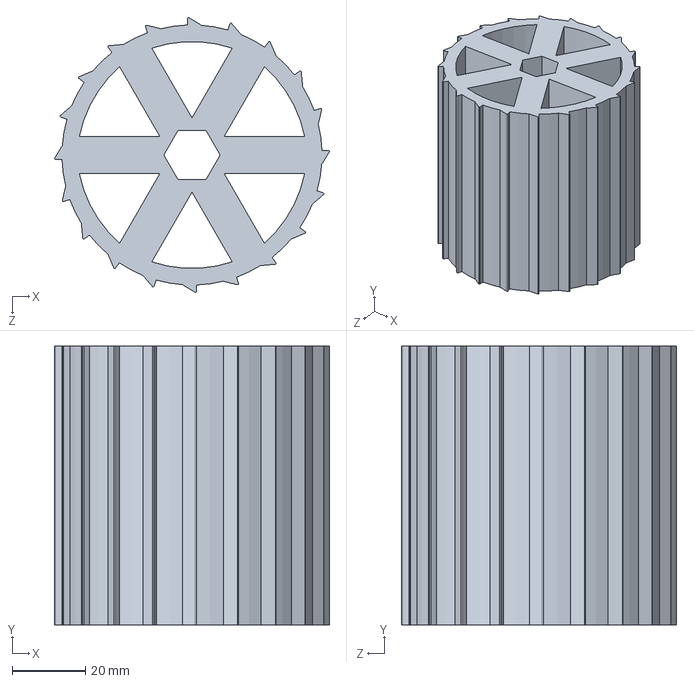
[picture p184: CAD file, 2025-03-22]
CAD/FRC/solidworks/wheel3.0.SLDPRT
75.2 x 76.2 x 75.2 mm
