dkittell/robotics-code-library/CAD/FRC/step/am-1526 500Hex HD Collar Clamp.STEP

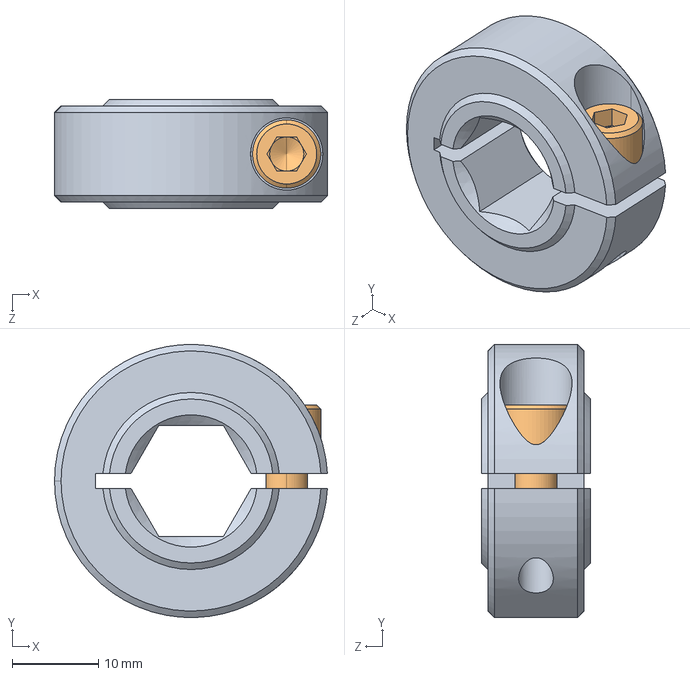
[picture p185: CAD file, 2025-03-22]
CAD/FRC/step/am-1526 500Hex HD Collar Clamp.STEP
31.7 x 31.7 x 12.7 mm
am-1238a 500Hex Collar Clamp Body
10-32x0500_shcs_HX-SHCS 0.19-32x1.375x1-C
