dkittell/robotics-code-library/CAD/FRC/stl/frc-reefscape-mini-field-model_files/driver-station-top.stl

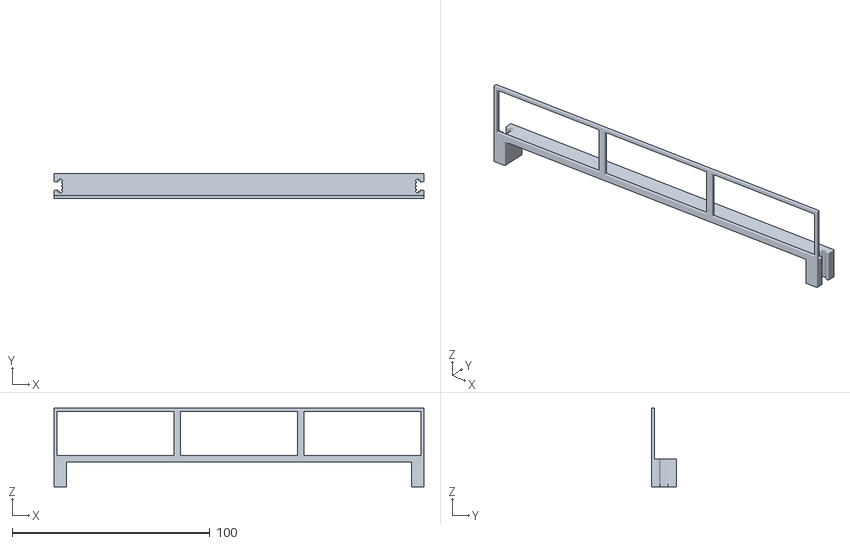
[picture p186: CAD file, 2025-03-22]
CAD/FRC/stl/frc-reefscape-mini-field-model_files/driver-station-top.stl
187.3 x 12.6 x 39.9
