dkittell/robotics-code-library/CAD/FTC-FRC/Thingiverse/NotUsing/Aluminiumprofile_Slider___linear_guide_2572864/files/nut8_30_100.stl

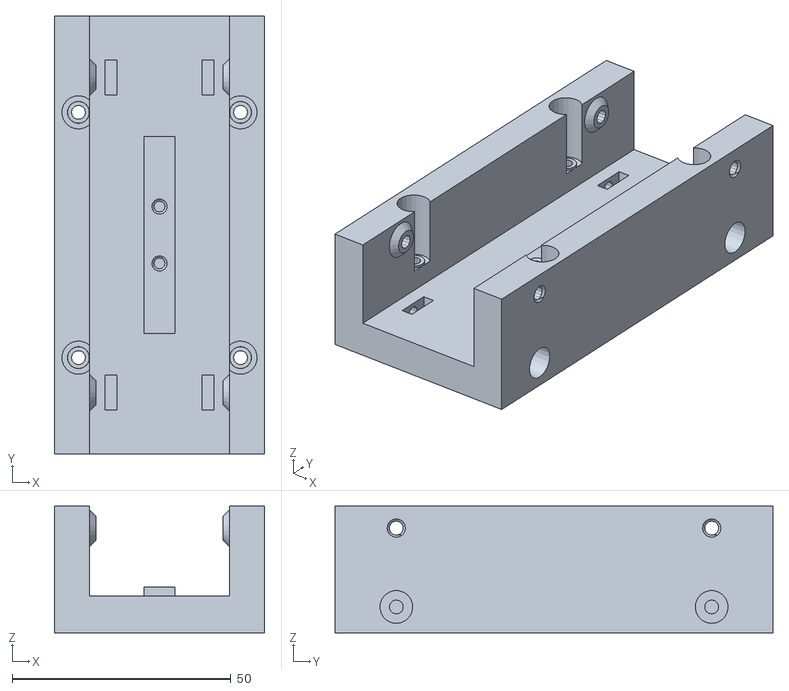
[picture p188: CAD file, 2025-03-22]
CAD/FTC-FRC/Thingiverse/NotUsing/Aluminiumprofile_Slider___linear_guide_2572864/files/nut8_30_100.stl
48.0 x 100.0 x 28.9
