dkittell/robotics-code-library/CAD/FTC/minn_Bill.stl

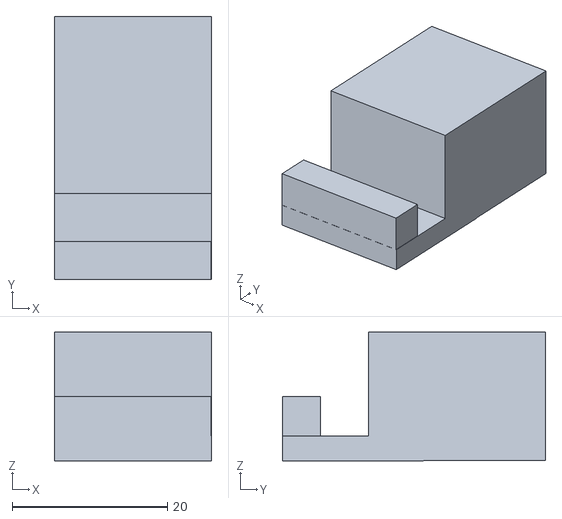
[picture p189: CAD file, 2025-03-22]
CAD/FTC/minn_Bill.stl
20.3 x 34.0 x 16.6
