dkittell/robotics-code-library/CAD/FRC/3mf/FF_Spark_Max_Mounting_Bracket.3mf

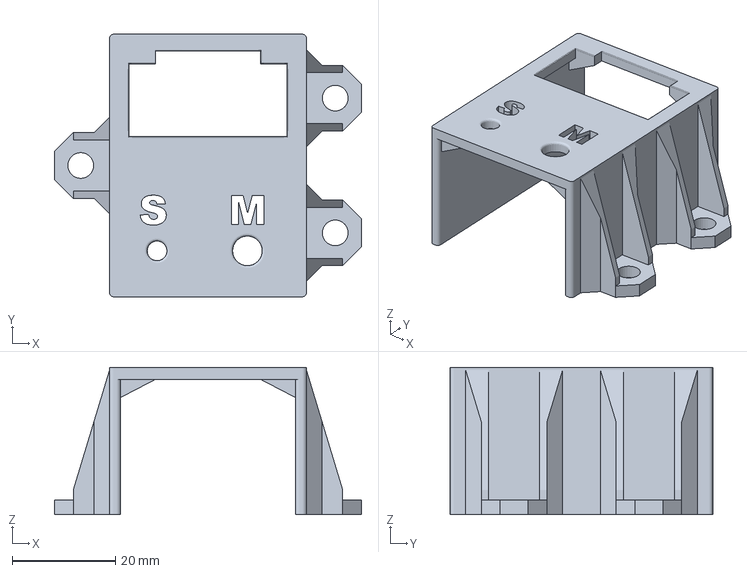
[picture p190: CAD file, 2025-03-22]
CAD/FRC/3mf/FF_Spark_Max_Mounting_Bracket.3mf
59.4 x 50.8 x 28.4 mm
