dkittell/robotics-code-library/CAD/FRC/Isaiah/SLIDE PLATE.SLDPRT

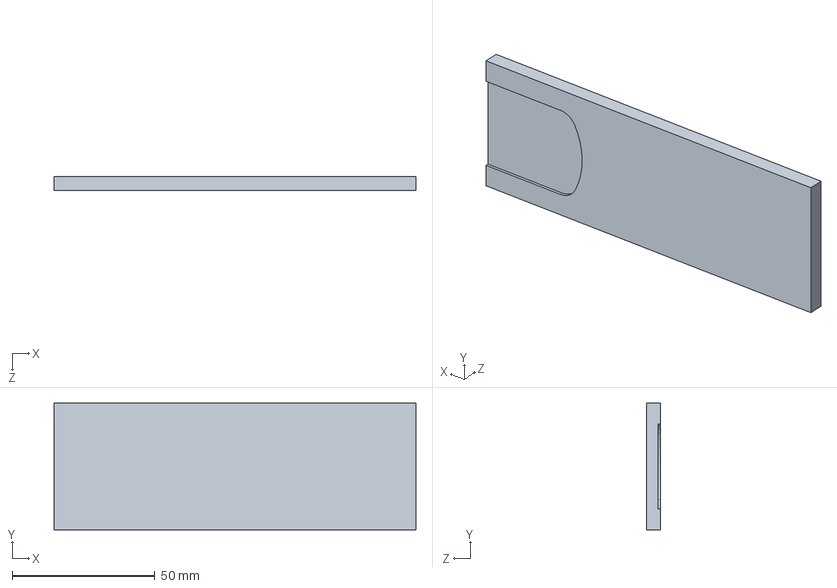
[picture p191: CAD file, 2025-03-22]
CAD/FRC/Isaiah/SLIDE PLATE.SLDPRT
127.0 x 44.5 x 5.08 mm
