dkittell/robotics-code-library/CAD/FRC/solidworks/shooterwheel.SLDPRT

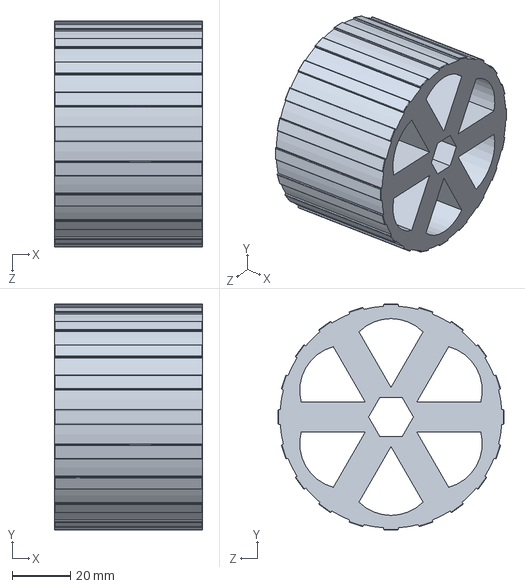
[picture p192: CAD file, 2025-03-22]
CAD/FRC/solidworks/shooterwheel.SLDPRT
50.8 x 77.6 x 77.6 mm
