dkittell/robotics-code-library/CAD/FRC/step/am-2986 FR8ZZ Hex Bearing.STEP

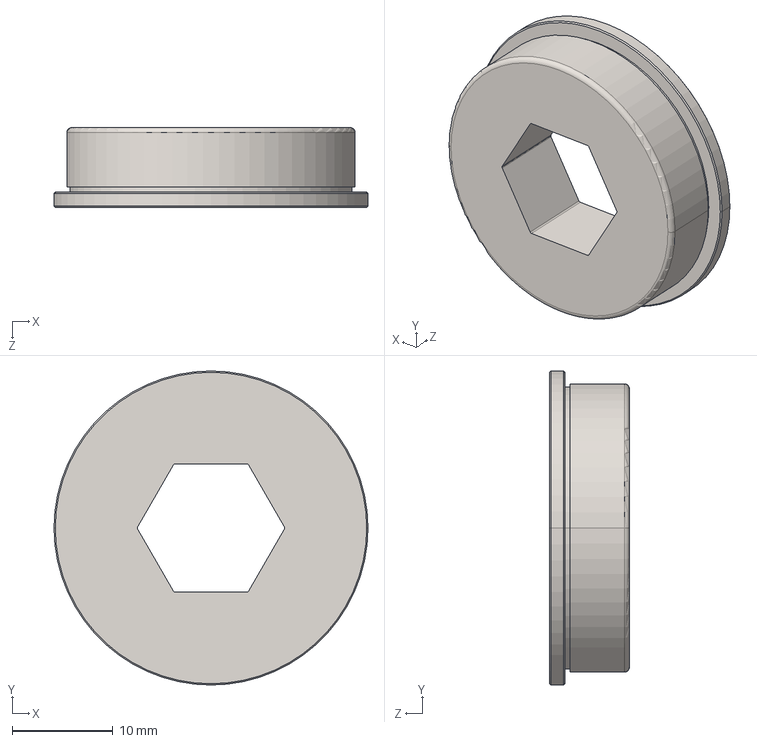
[picture p193: CAD file, 2025-03-22]
CAD/FRC/step/am-2986 FR8ZZ Hex Bearing.STEP
31.1 x 31.1 x 7.93 mm
