dkittell/robotics-code-library/CAD/FRC/stl/frc-reefscape-mini-field-model_files/plain-wall.stl

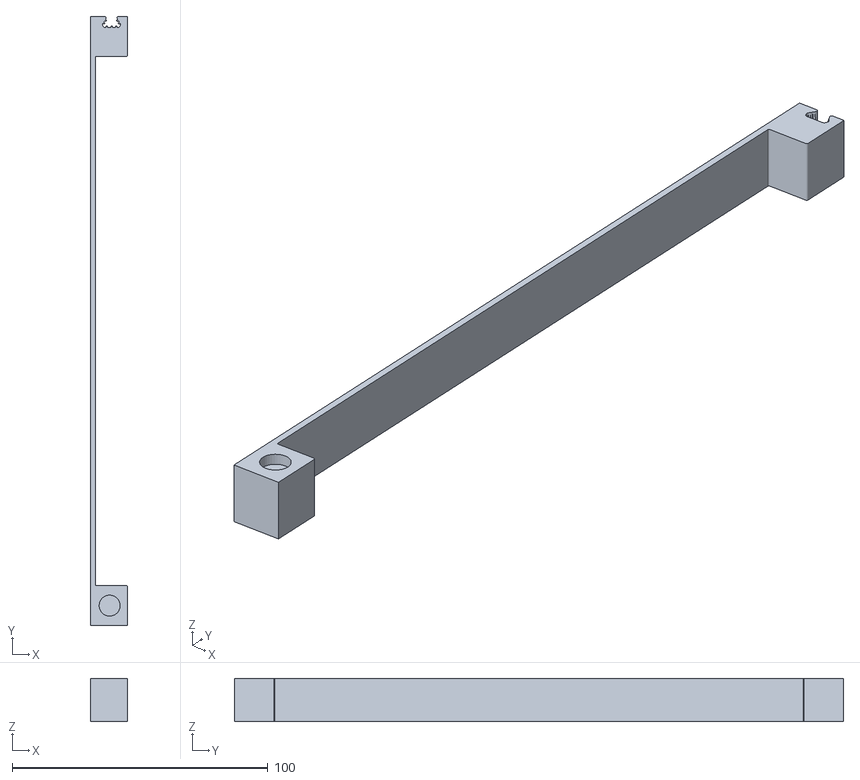
[picture p194: CAD file, 2025-03-22]
CAD/FRC/stl/frc-reefscape-mini-field-model_files/plain-wall.stl
14.6 x 237.9 x 16.9
