dkittell/robotics-code-library/CAD/FRC/stl/rsllight.STL

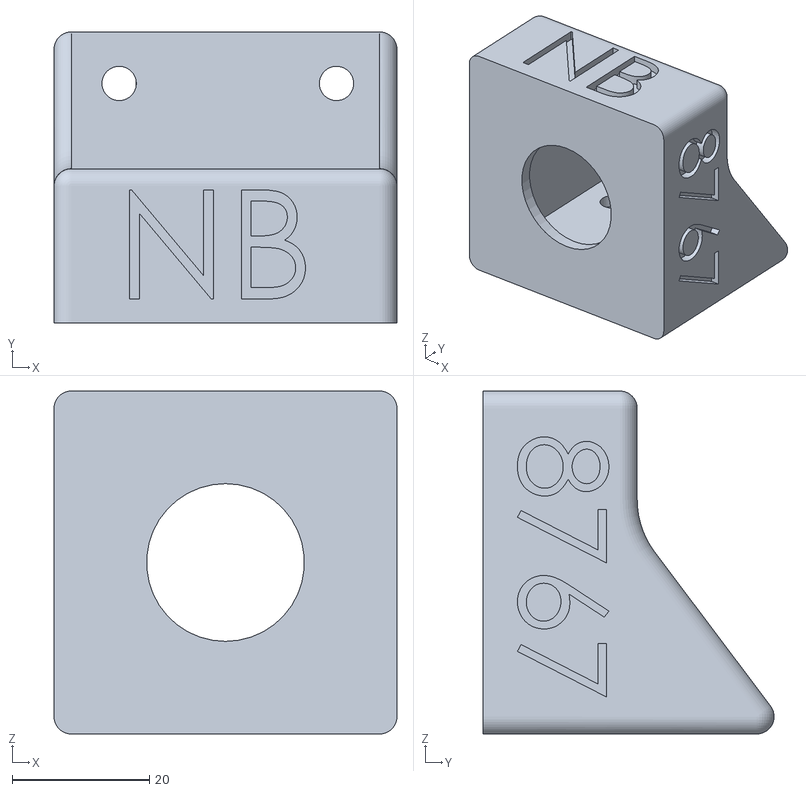
[picture p195: CAD file, 2025-03-22]
CAD/FRC/stl/rsllight.STL
50.0 x 42.5 x 50.0
