dkittell/robotics-code-library/CAD/FTC-FRC/Thingiverse/Linear_Servo_Actuators_3170748/files/Step Files- DIY Linear Servo/Pusher, 150mm Long.STEP

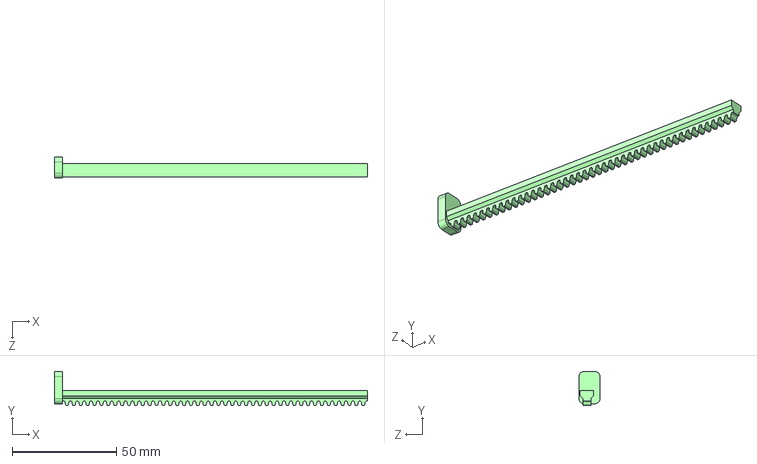
[picture p196: CAD file, 2025-03-22]
CAD/FTC-FRC/Thingiverse/Linear_Servo_Actuators_3170748/files/Step Files- DIY Linear Servo/Pusher, 150mm Long.STEP
150.0 x 16.3 x 10.2 mm
