dkittell/robotics-code-library/CAD/FTC-FRC/Thingiverse/NotUsing/8020_15-series_bracket_collection_3669194/files/8020_4307_2-hole_flat_plate.stl

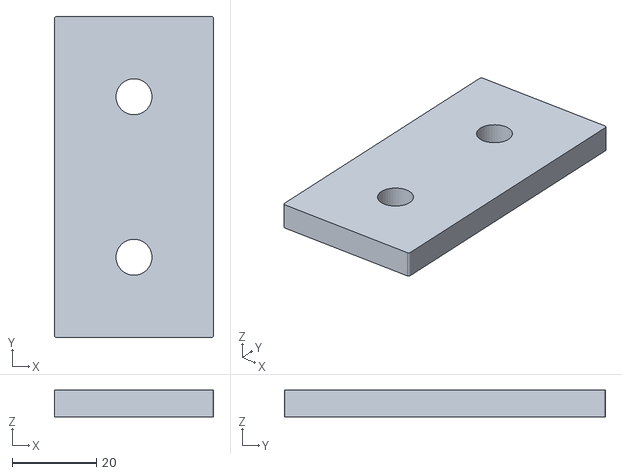
[picture p197: CAD file, 2025-03-22]
CAD/FTC-FRC/Thingiverse/NotUsing/8020_15-series_bracket_collection_3669194/files/8020_4307_2-hole_flat_plate.stl
37.8 x 76.2 x 6.35
