dkittell/robotics-code-library/CAD/FTC/Battery_Holder_Lid.stl

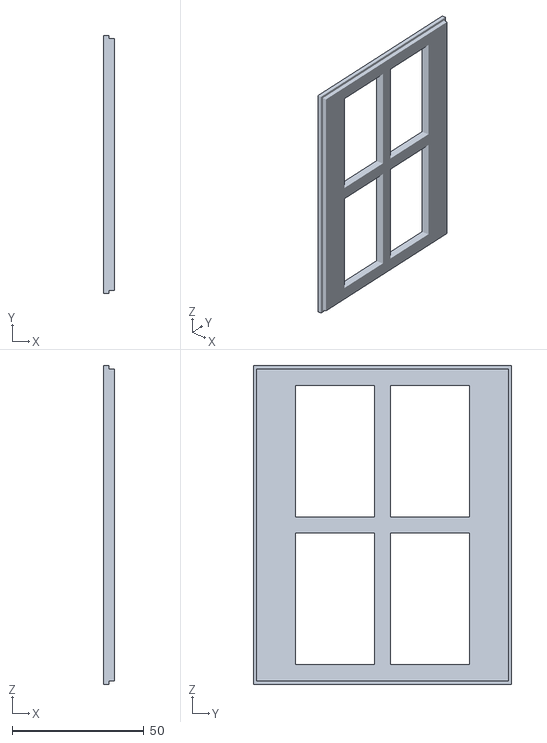
[picture p199: CAD file, 2025-03-22]
CAD/FTC/Battery_Holder_Lid.stl
4.00 x 98.0 x 121.0
