dkittell/robotics-code-library/CAD/FRC/Isaiah/baring bottom holder.SLDPRT

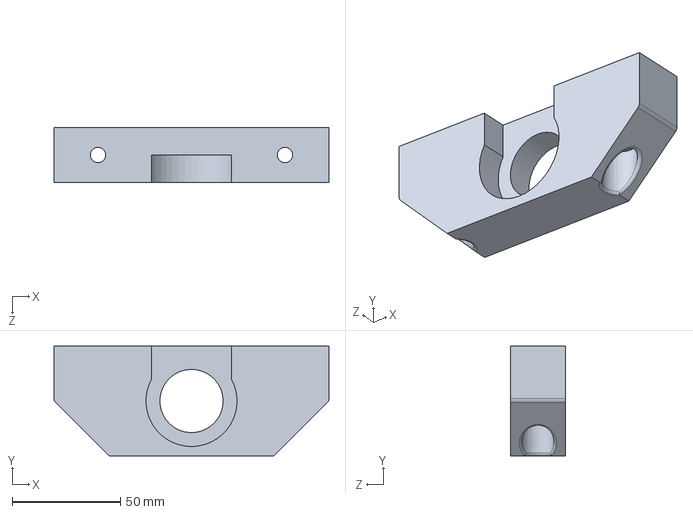
[picture p200: CAD file, 2025-03-22]
CAD/FRC/Isaiah/baring bottom holder.SLDPRT
127.0 x 50.8 x 25.4 mm
