dkittell/robotics-code-library/CAD/FRC/solidworks/shaft.SLDPRT

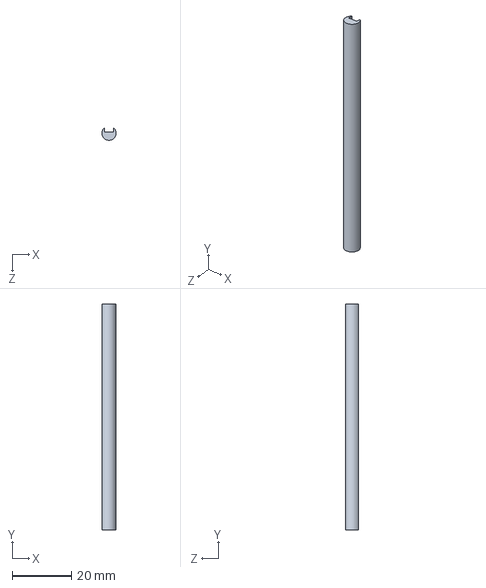
[picture p201: CAD file, 2025-03-22]
CAD/FRC/solidworks/shaft.SLDPRT
4.81 x 76.2 x 4.28 mm
