dkittell/robotics-code-library/CAD/FRC/stl/frc-reefscape-mini-field-model_files/outer-post.stl

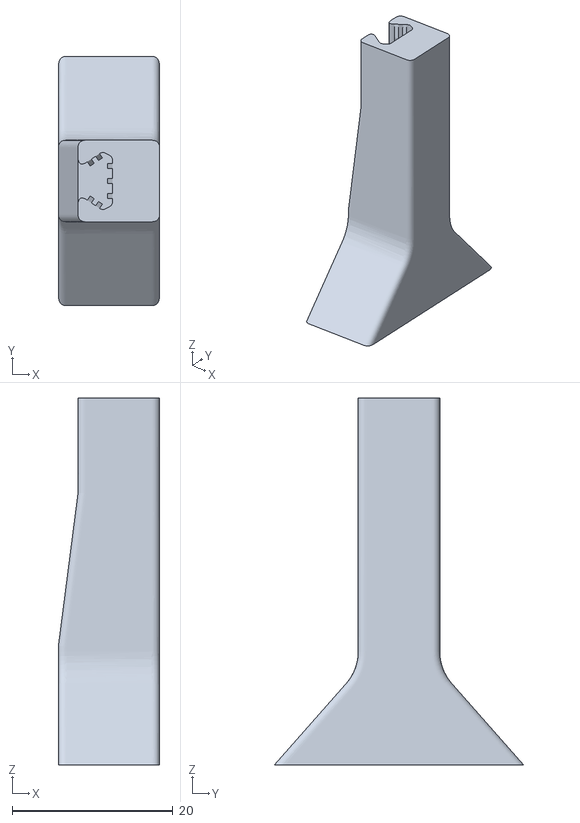
[picture p202: CAD file, 2025-03-22]
CAD/FRC/stl/frc-reefscape-mini-field-model_files/outer-post.stl
12.6 x 31.1 x 45.7
