dkittell/robotics-code-library/CAD/FTC-FRC/Thingiverse/Linear_Servo_Actuators_3170748/files/Motor_Bracket_Large_Version.STL

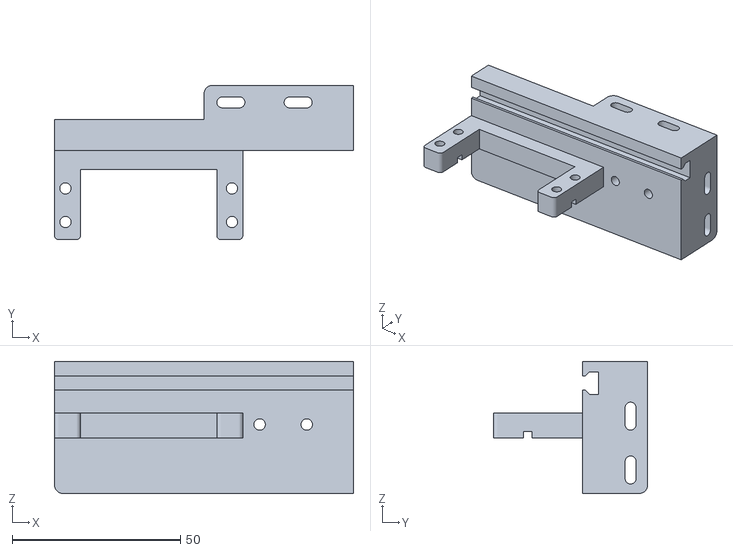
[picture p203: CAD file, 2025-03-22]
CAD/FTC-FRC/Thingiverse/Linear_Servo_Actuators_3170748/files/Motor_Bracket_Large_Version.STL
88.9 x 45.9 x 39.2
