dkittell/robotics-code-library/CAD/FTC-FRC/Thingiverse/NotUsing/8020_15-series_bracket_collection_3669194/files/8020_4336_4-hole_gusseted_inside_corner_bracket.stl

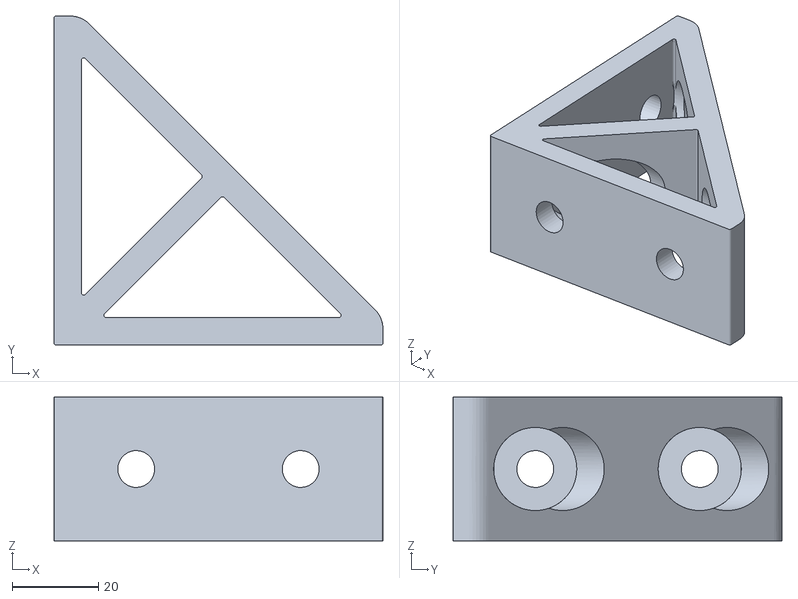
[picture p204: CAD file, 2025-03-22]
CAD/FTC-FRC/Thingiverse/NotUsing/8020_15-series_bracket_collection_3669194/files/8020_4336_4-hole_gusseted_inside_corner_bracket.stl
76.2 x 76.2 x 33.3
