dkittell/robotics-code-library/CAD/FTC/Batterypack.stl

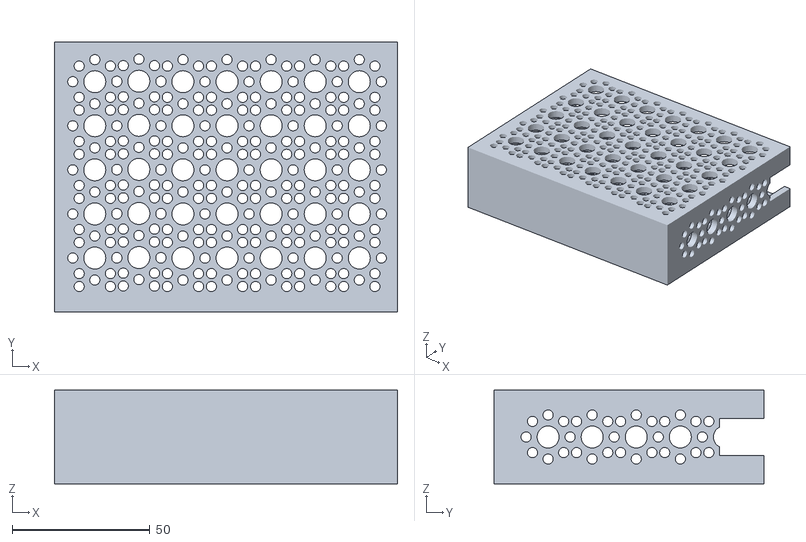
[picture p206: CAD file, 2025-03-22]
CAD/FTC/Batterypack.stl
124.5 x 98.0 x 34.0
