dkittell/robotics-code-library/CAD/FRC/3mf/Body1 v2.3mf

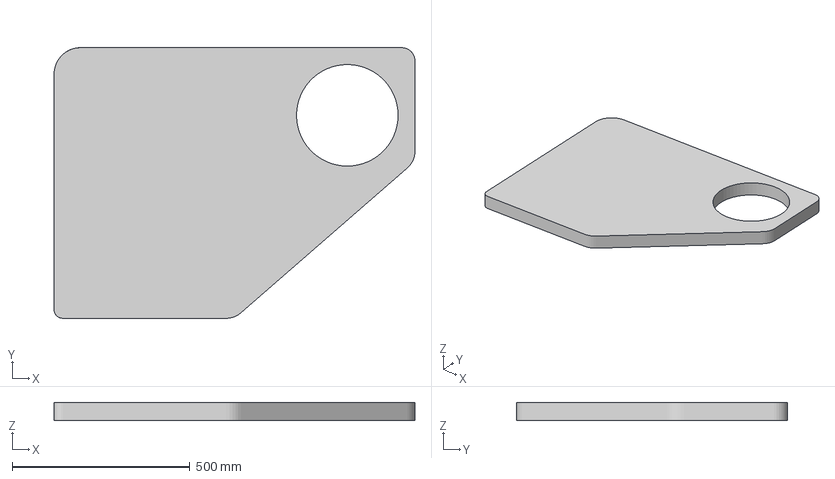
[picture p207: CAD file, 2025-03-22]
CAD/FRC/3mf/Body1 v2.3mf
1016.0 x 762.0 x 52.0 mm
