dkittell/robotics-code-library/CAD/FRC/Isaiah/bareing hub.STL

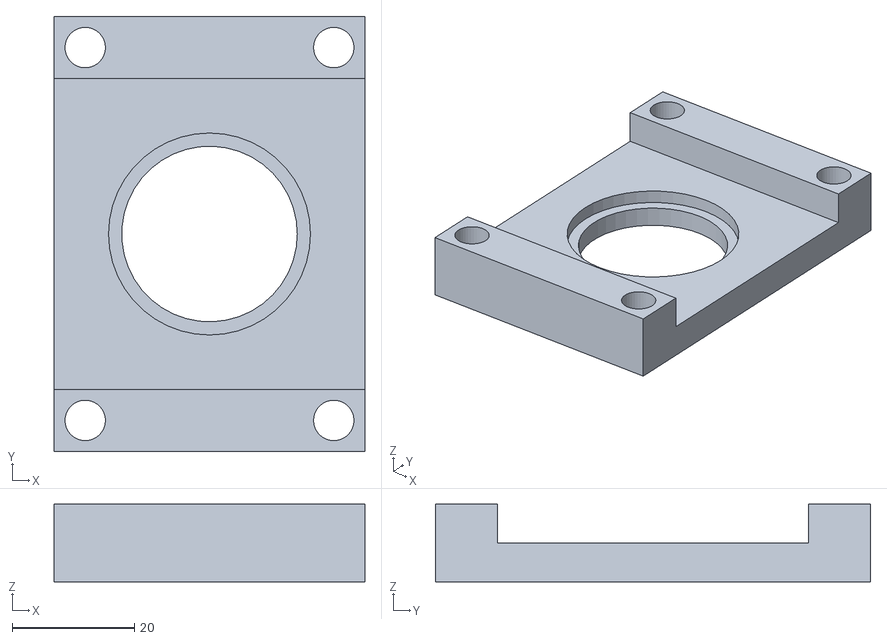
[picture p208: CAD file, 2025-03-22]
CAD/FRC/Isaiah/bareing hub.STL
50.8 x 71.1 x 12.7
