dkittell/robotics-code-library/CAD/FRC/step/am-1305 500 Hex Spacer REV2.STEP

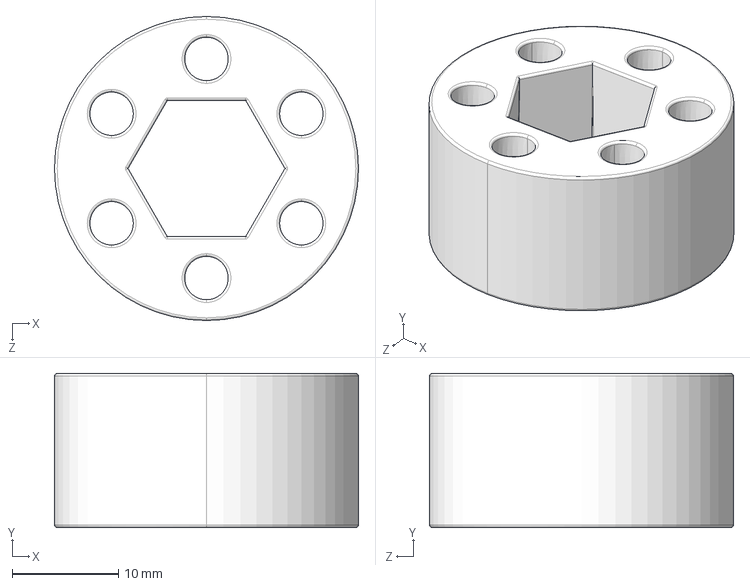
[picture p209: CAD file, 2025-03-22]
CAD/FRC/step/am-1305 500 Hex Spacer REV2.STEP
28.5 x 14.5 x 28.5 mm
