dkittell/robotics-code-library/CAD/FRC/stl/frc-reefscape-mini-field-model_files/processor-wall.stl

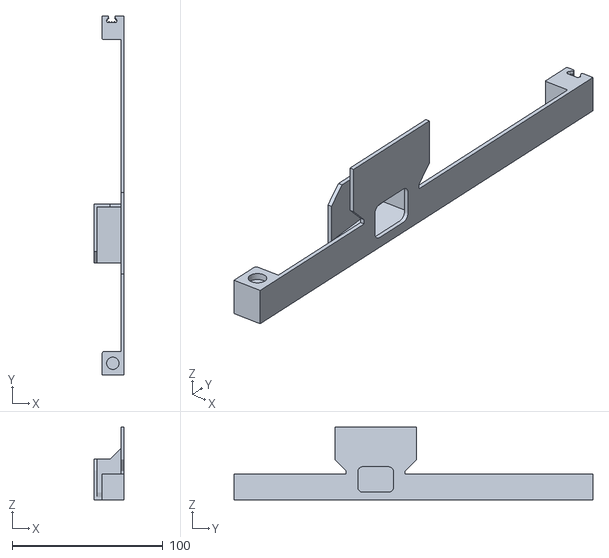
[picture p210: CAD file, 2025-03-22]
CAD/FRC/stl/frc-reefscape-mini-field-model_files/processor-wall.stl
20.2 x 237.9 x 48.0
