dkittell/robotics-code-library/CAD/FRC/3mf/FF_RoboRioI2CPinPlug.3mf

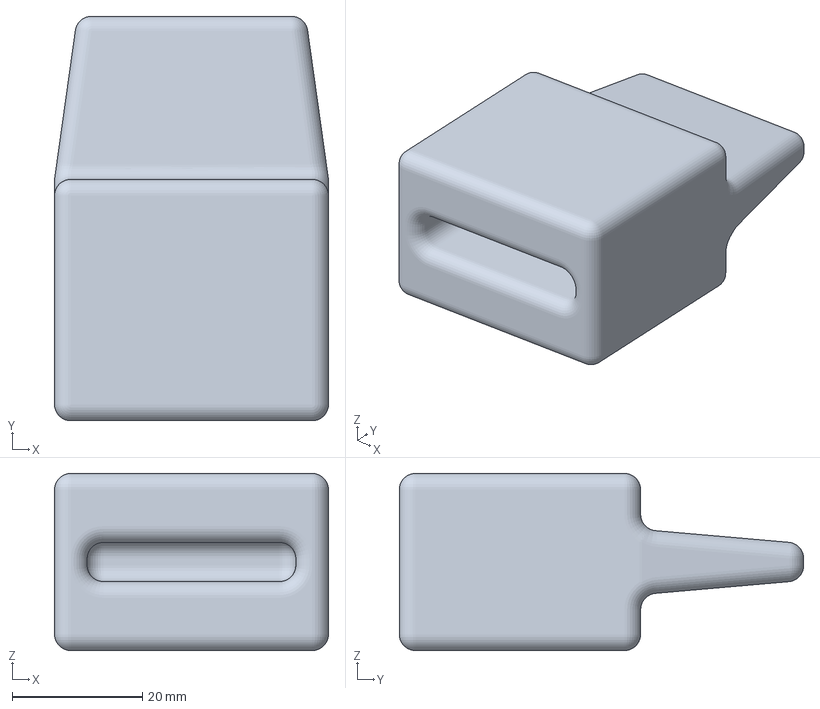
[picture p212: CAD file, 2025-03-22]
CAD/FRC/3mf/FF_RoboRioI2CPinPlug.3mf
42.0 x 62.0 x 27.2 mm
