dkittell/robotics-code-library/CAD/FRC/Liz/horse-thingyverse.STL

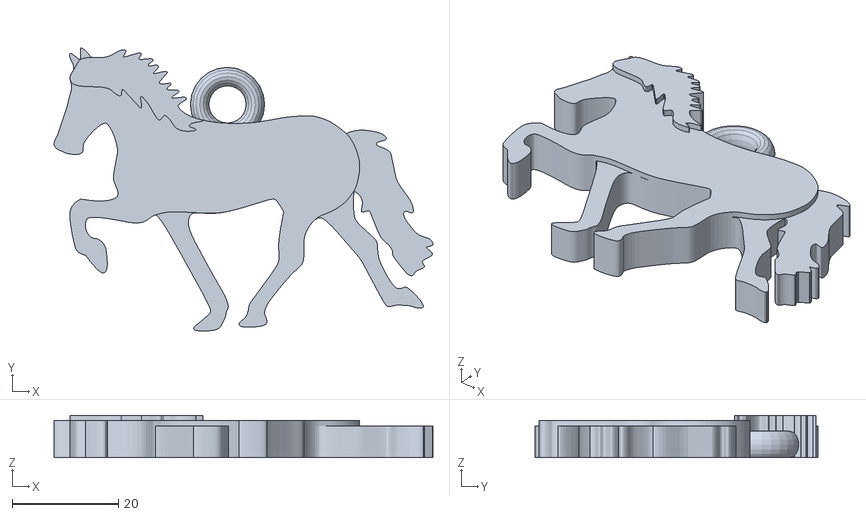
[picture p213: CAD file, 2025-03-22]
CAD/FRC/Liz/horse-thingyverse.STL
71.4 x 53.4 x 8.00
