dkittell/robotics-code-library/CAD/FRC/stl/frc-reefscape-mini-field-model_files/driver-human-station.stl

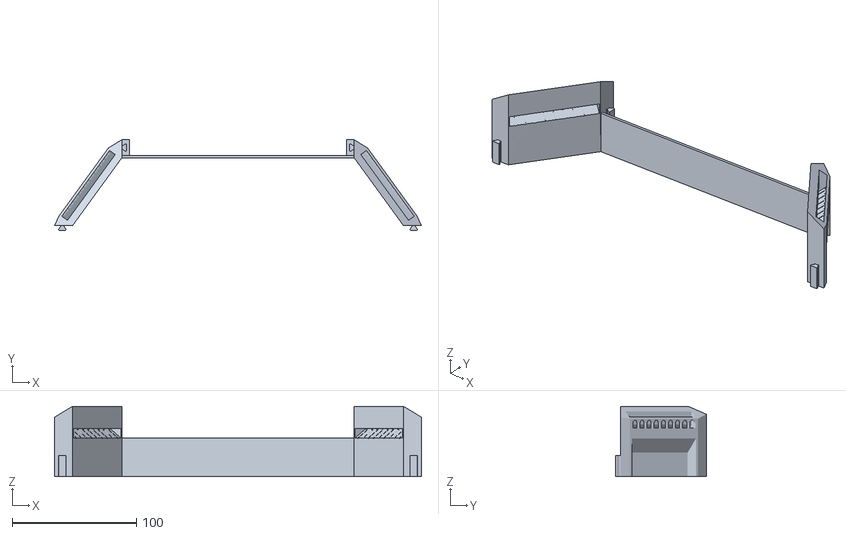
[picture p214: CAD file, 2025-03-22]
CAD/FRC/stl/frc-reefscape-mini-field-model_files/driver-human-station.stl
295.9 x 73.0 x 56.8
