dkittell/robotics-code-library/CAD/FRC/stl/Good_Shims.stl

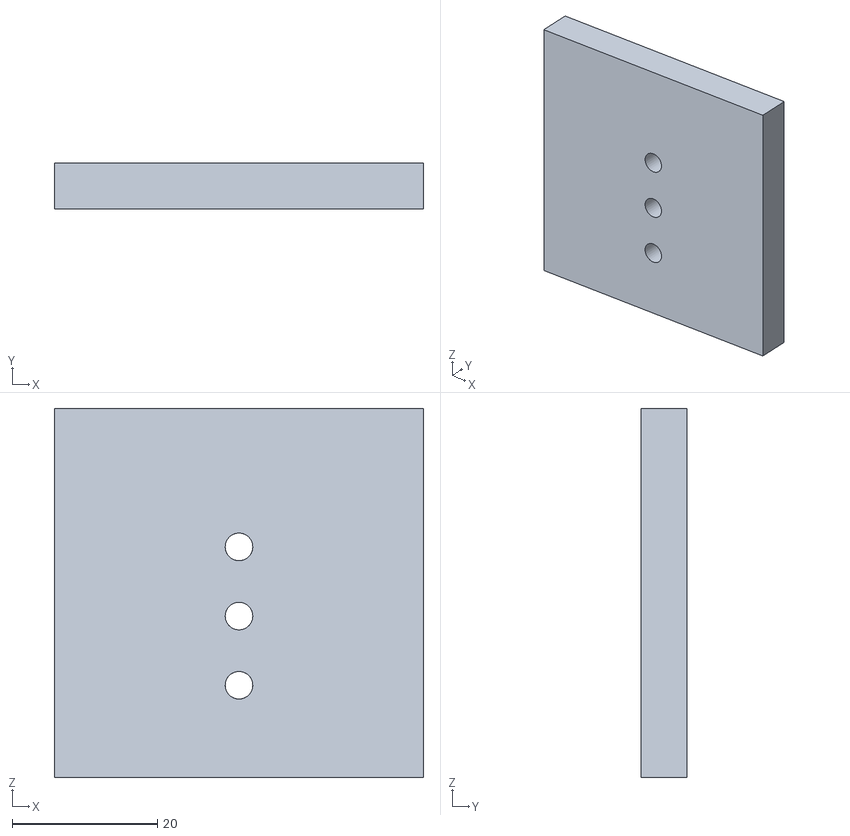
[picture p215: CAD file, 2025-03-22]
CAD/FRC/stl/Good_Shims.stl
50.8 x 6.35 x 50.8
