dkittell/robotics-code-library/CAD/FRC/3mf/FF_All_Pieces.3mf

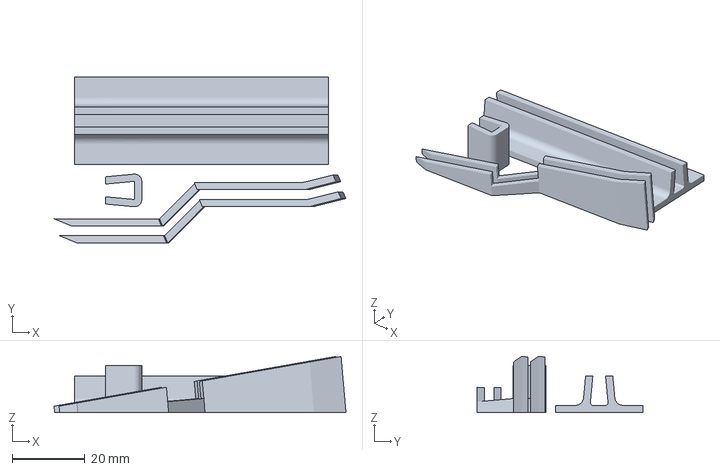
[picture p217: CAD file, 2025-03-22]
CAD/FRC/3mf/FF_All_Pieces.3mf
80.4 x 45.6 x 15.4 mm
