dkittell/robotics-code-library/CAD/FRC/Liz/ftcrobot.SLDPRT

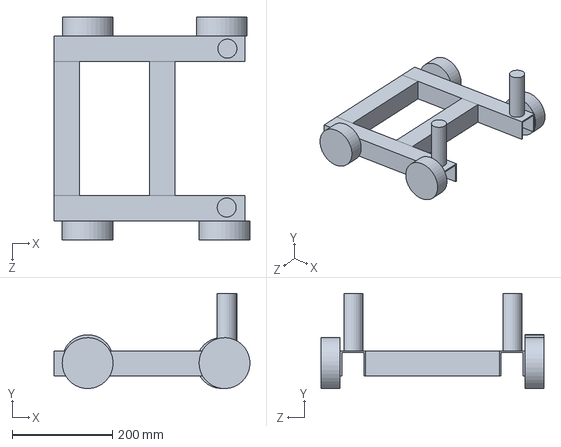
[picture p218: CAD file, 2025-03-22]
CAD/FRC/Liz/ftcrobot.SLDPRT
390.9 x 189.7 x 444.6 mm
