dkittell/robotics-code-library/CAD/FRC/stl/frc-reefscape-mini-field-model_files/cage.stl

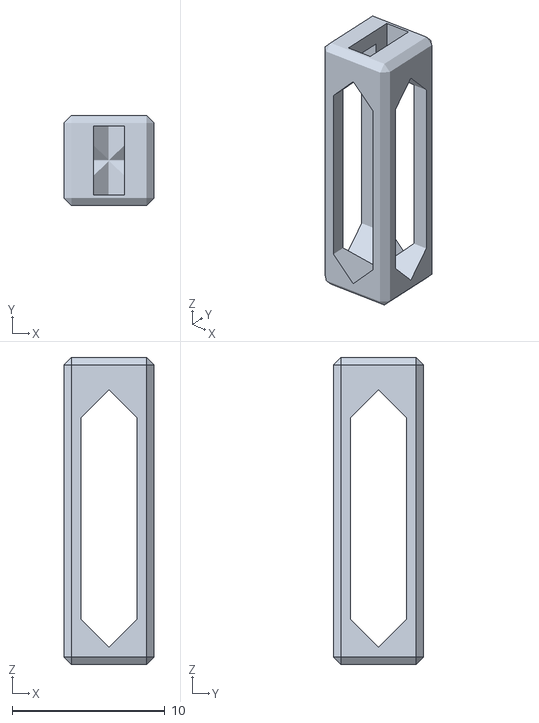
[picture p219: CAD file, 2025-03-22]
CAD/FRC/stl/frc-reefscape-mini-field-model_files/cage.stl
5.93 x 5.93 x 20.1
