dkittell/robotics-code-library/CAD/FRC/stl/Offset Pivot - Carriage Plate Mirror.stl

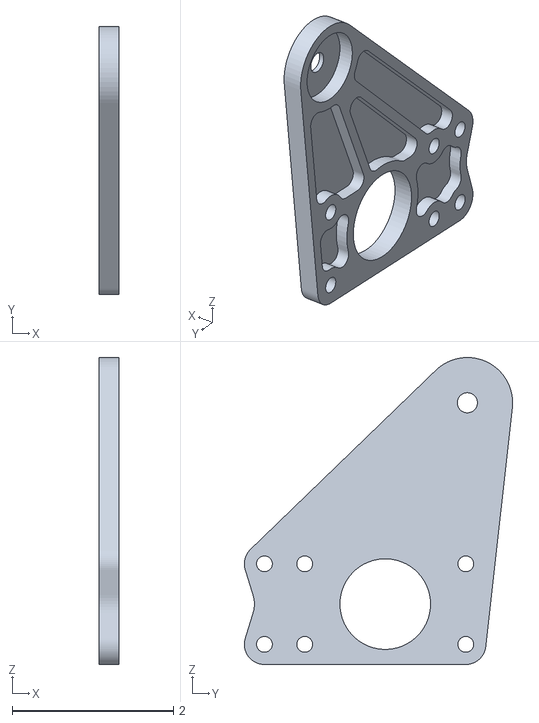
[picture p220: CAD file, 2025-03-22]
CAD/FRC/stl/Offset Pivot - Carriage Plate Mirror.stl
0.25 x 3.33 x 3.81
