dkittell/robotics-code-library/CAD/FRC/3mf/coralIntake2.3mf

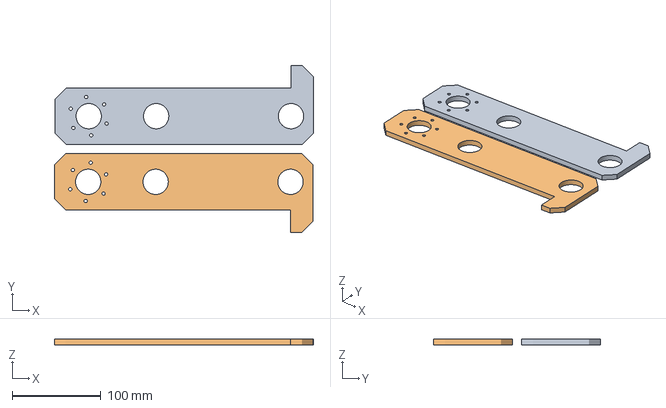
[picture p223: CAD file, 2025-03-22]
CAD/FRC/3mf/coralIntake2.3mf
292.7 x 188.5 x 6.35 mm
coralIntake2.stl x 2
