dkittell/robotics-code-library/CAD/FRC/stl/20T 20DP Steel - 1-2- Hex Bore Gear (REV-21-1921) (1).stl

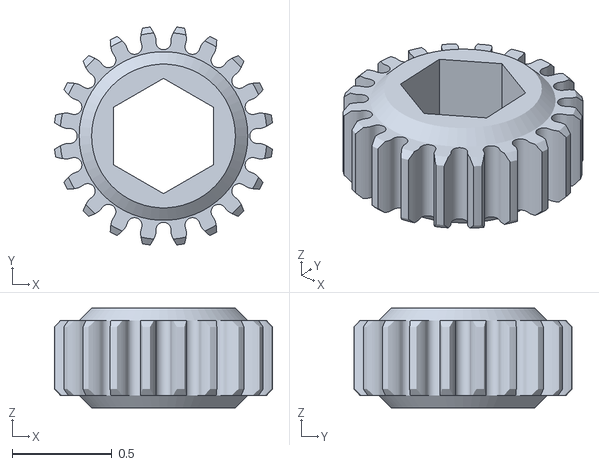
[picture p224: CAD file, 2025-03-22]
CAD/FRC/stl/20T 20DP Steel - 1-2- Hex Bore Gear (REV-21-1921) (1).stl
1.09 x 1.09 x 0.5
