dkittell/robotics-code-library/CAD/FRC/stl/frc-reefscape-mini-field-model_files/algae.step

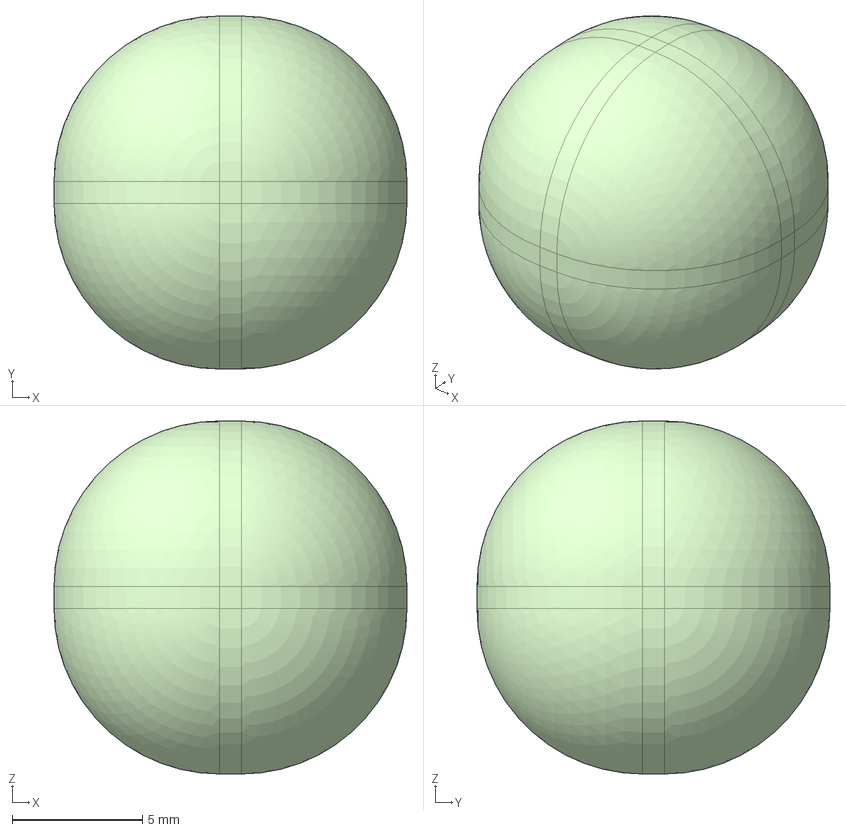
[picture p225: CAD file, 2025-03-22]
CAD/FRC/stl/frc-reefscape-mini-field-model_files/algae.step
13.5 x 13.5 x 13.5 mm
