dkittell/robotics-code-library/CAD/FRC/3mf/FF_USBBPortCover.3mf

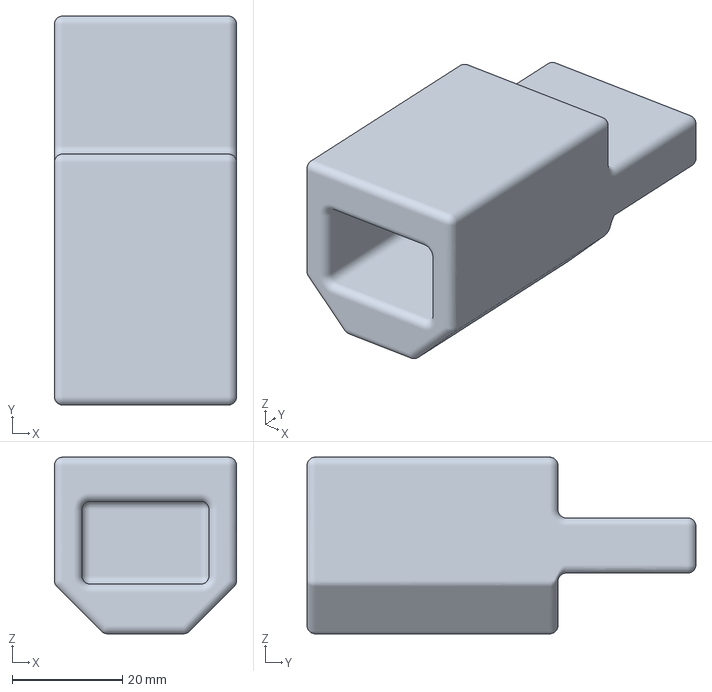
[picture p226: CAD file, 2025-03-22]
CAD/FRC/3mf/FF_USBBPortCover.3mf
33.0 x 70.4 x 32.0 mm
