dkittell/robotics-code-library/CAD/FRC/stl/frc-reefscape-mini-field-model_files/coral.stp

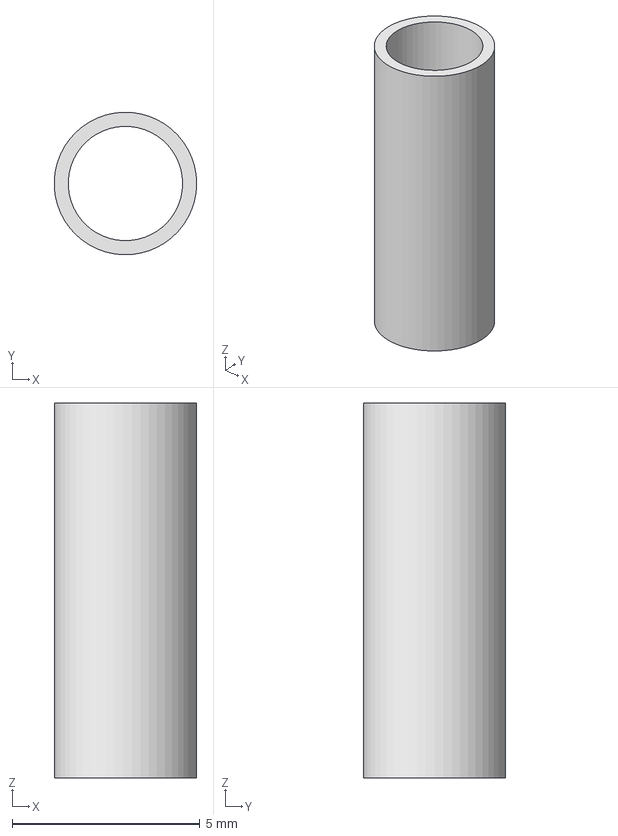
[picture p227: CAD file, 2025-03-22]
CAD/FRC/stl/frc-reefscape-mini-field-model_files/coral.stp
3.80 x 3.80 x 10.00 mm
