dkittell/robotics-code-library/CAD/FRC/3mf/FF_cableclip-medium.3mf

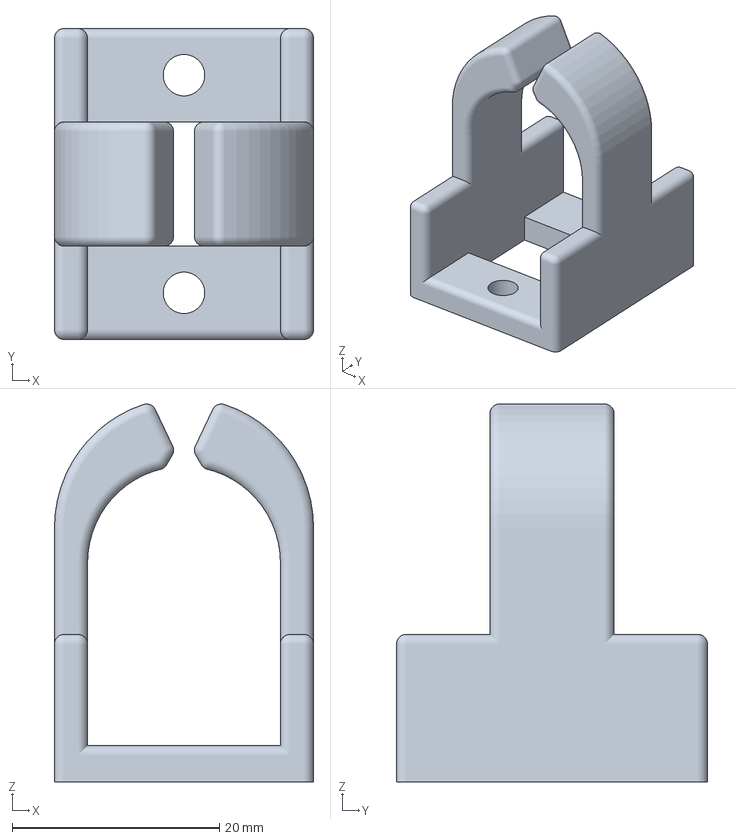
[picture p228: CAD file, 2025-03-22]
CAD/FRC/3mf/FF_cableclip-medium.3mf
25.0 x 30.0 x 36.5 mm
