dkittell/robotics-code-library/CAD/FRC/stl/frc-reefscape-mini-field-model_files/reef-structure.stl

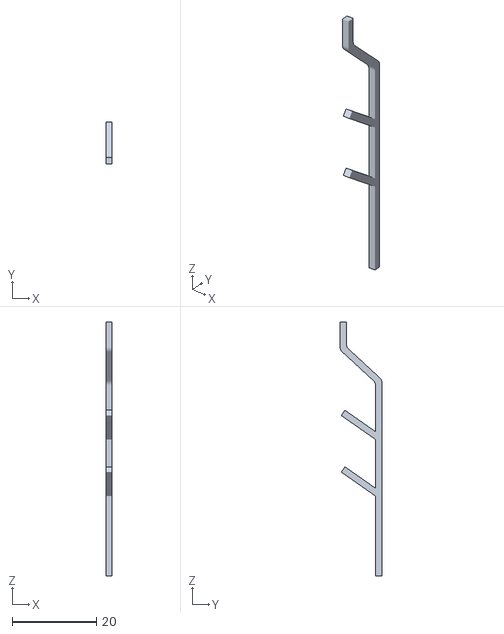
[picture p229: CAD file, 2025-03-22]
CAD/FRC/stl/frc-reefscape-mini-field-model_files/reef-structure.stl
1.52 x 9.99 x 60.3
