dkittell/robotics-code-library/CAD/FRC/stl/lidNO3.STL

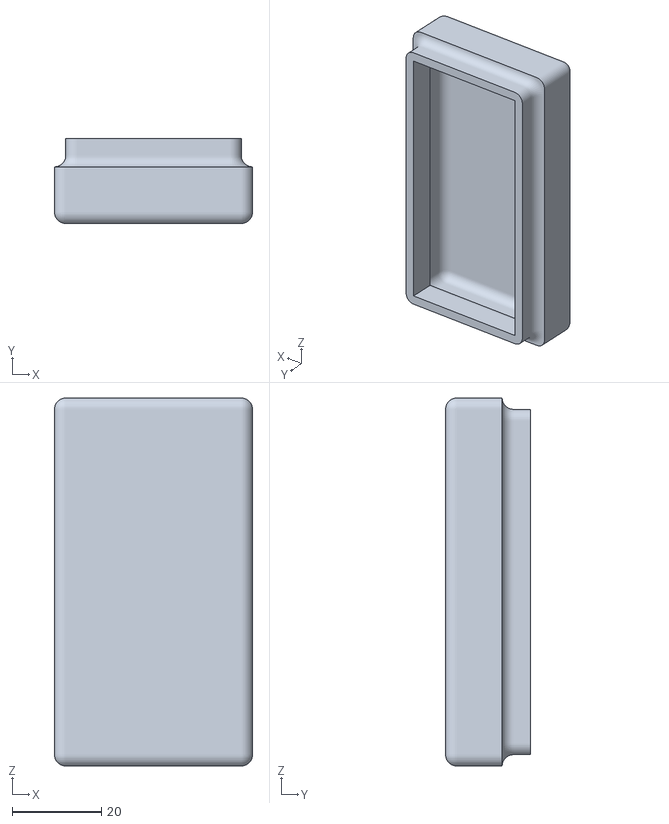
[picture p230: CAD file, 2025-03-22]
CAD/FRC/stl/lidNO3.STL
44.5 x 19.1 x 82.5
