dkittell/robotics-code-library/CAD/FRC/3mf/M_horse8767.3mf

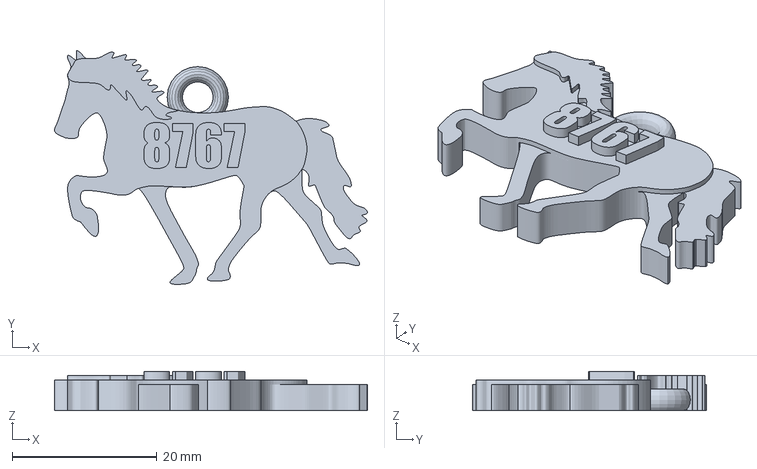
[picture p231: CAD file, 2025-03-22]
CAD/FRC/3mf/M_horse8767.3mf
43.3 x 32.3 x 5.45 mm
