dkittell/robotics-code-library/CAD/FRC/stl/60T 20DP Steel - 1-2- Hex Bore Gear (REV-21-1941) (1).stl

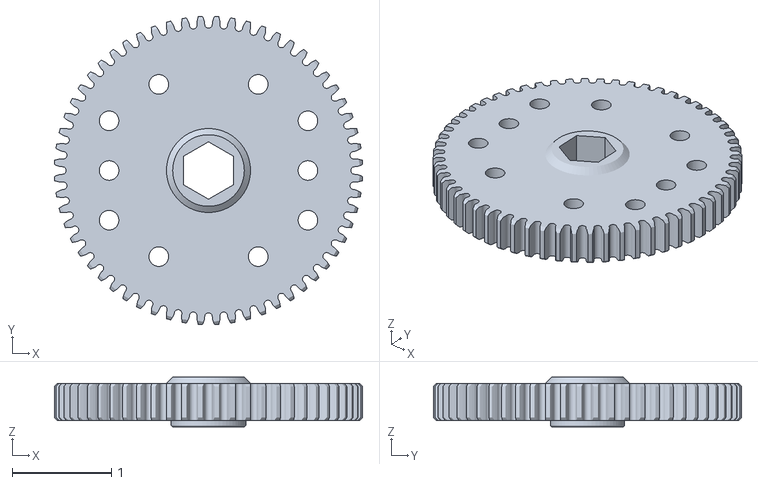
[picture p232: CAD file, 2025-03-22]
CAD/FRC/stl/60T 20DP Steel - 1-2- Hex Bore Gear (REV-21-1941) (1).stl
3.10 x 3.10 x 0.5
