dkittell/robotics-code-library/CAD/FRC/stl/frc-reefscape-mini-field-model_files/deep-climb.stl

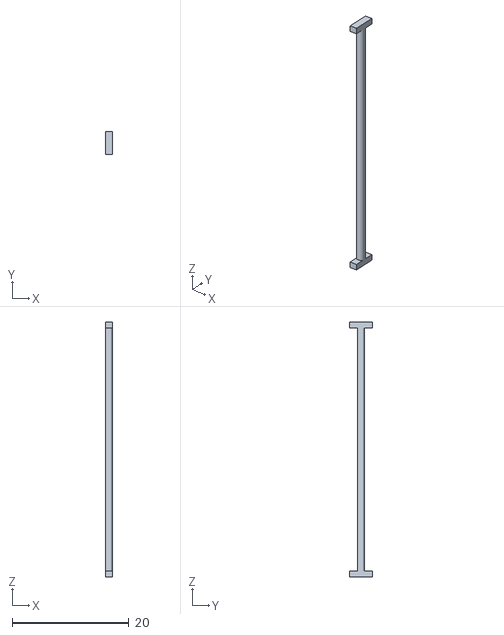
[picture p233: CAD file, 2025-03-22]
CAD/FRC/stl/frc-reefscape-mini-field-model_files/deep-climb.stl
1.25 x 3.90 x 43.6
