dkittell/robotics-code-library/CAD/FRC/3mf/FF_cableclip-small.3mf

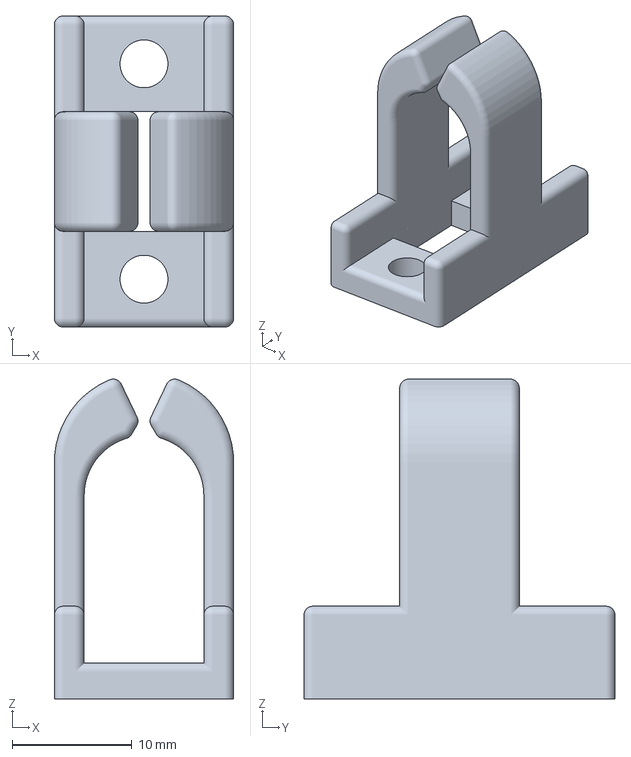
[picture p234: CAD file, 2025-03-22]
CAD/FRC/3mf/FF_cableclip-small.3mf
15.0 x 26.0 x 26.7 mm
