dkittell/robotics-code-library/CAD/FRC/stl/Part4LID.STL

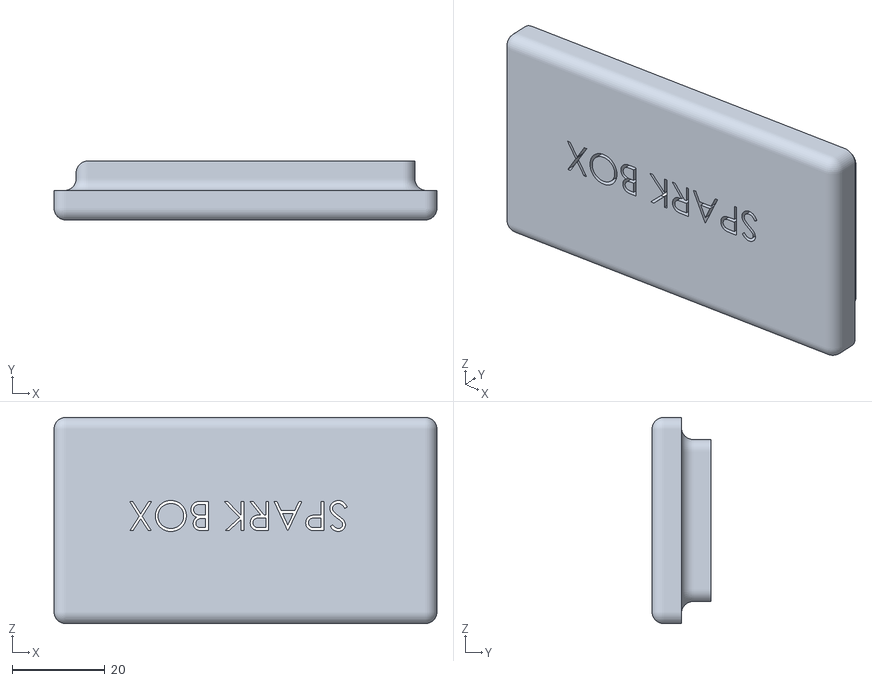
[picture p235: CAD file, 2025-03-22]
CAD/FRC/stl/Part4LID.STL
82.6 x 12.7 x 44.5
