dkittell/robotics-code-library/CAD/FRC/3mf/FF_Tweezer_Handle.3mf

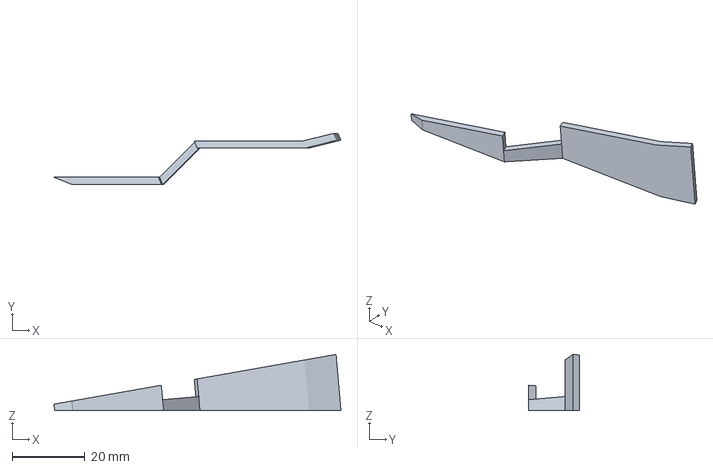
[picture p236: CAD file, 2025-03-22]
CAD/FRC/3mf/FF_Tweezer_Handle.3mf
79.0 x 14.0 x 15.4 mm
