dkittell/robotics-code-library/CAD/FRC/stl/8767 2022 BOT.STL

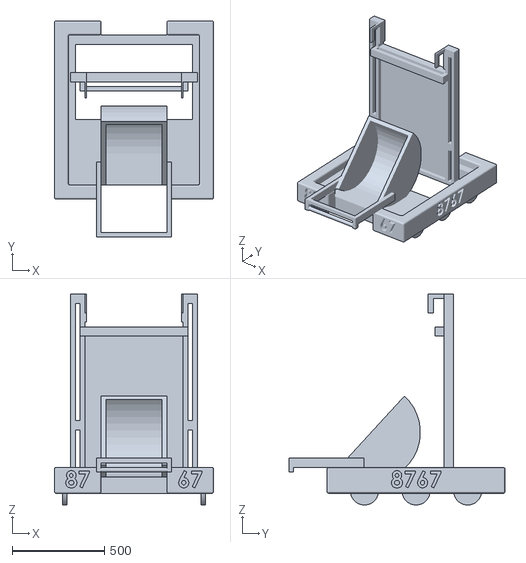
[picture p237: CAD file, 2025-03-22]
CAD/FRC/stl/8767 2022 BOT.STL
863.6 x 1171.6 x 1142.7
