dkittell/robotics-code-library/CAD/FRC/3mf/FF_Improved_Tweezer_Set.3mf

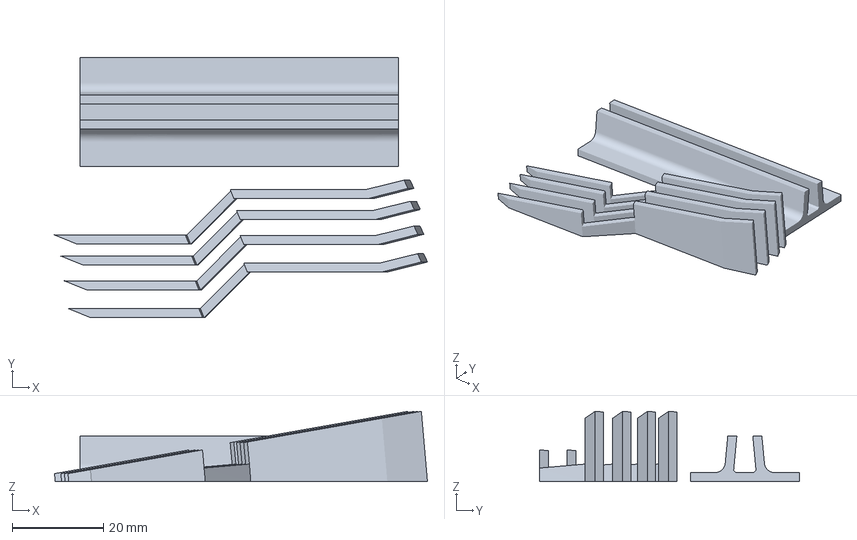
[picture p238: CAD file, 2025-03-22]
CAD/FRC/3mf/FF_Improved_Tweezer_Set.3mf
81.9 x 57.1 x 15.4 mm
