dkittell/robotics-code-library/CAD/FRC/stl/large spacer.STL

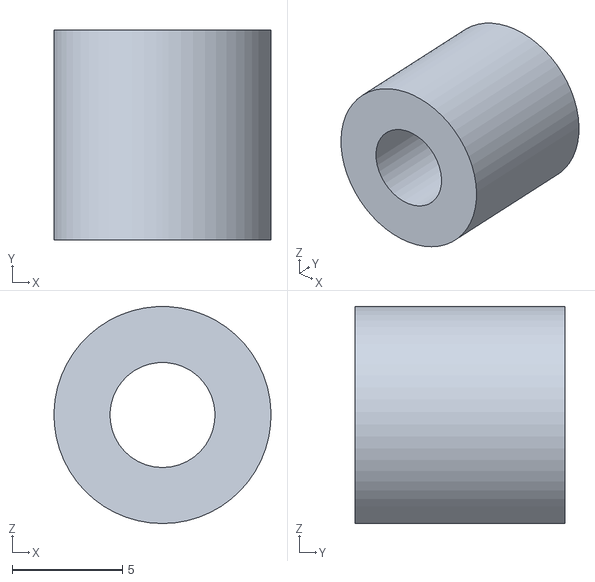
[picture p239: CAD file, 2025-03-22]
CAD/FRC/stl/large spacer.STL
9.84 x 9.53 x 9.84
