dkittell/robotics-code-library/CAD/FRC/3mf/FF_RoboRioSPIPinPlug.3mf

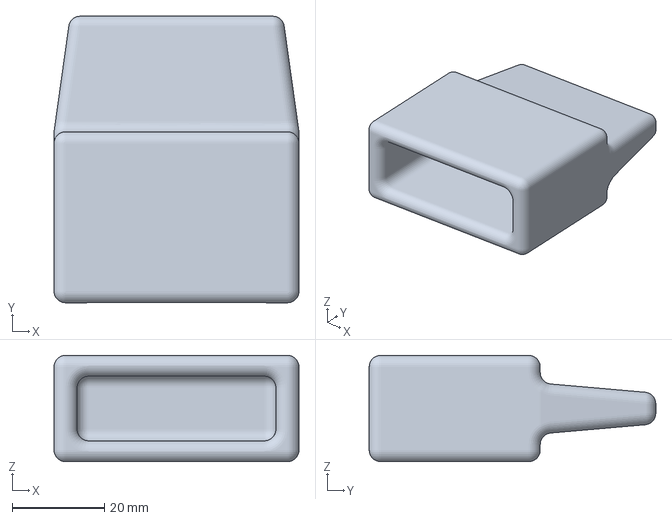
[picture p240: CAD file, 2025-03-22]
CAD/FRC/3mf/FF_RoboRioSPIPinPlug.3mf
53.0 x 62.0 x 23.0 mm
