dkittell/robotics-code-library/CAD/FRC/stl/6.stl

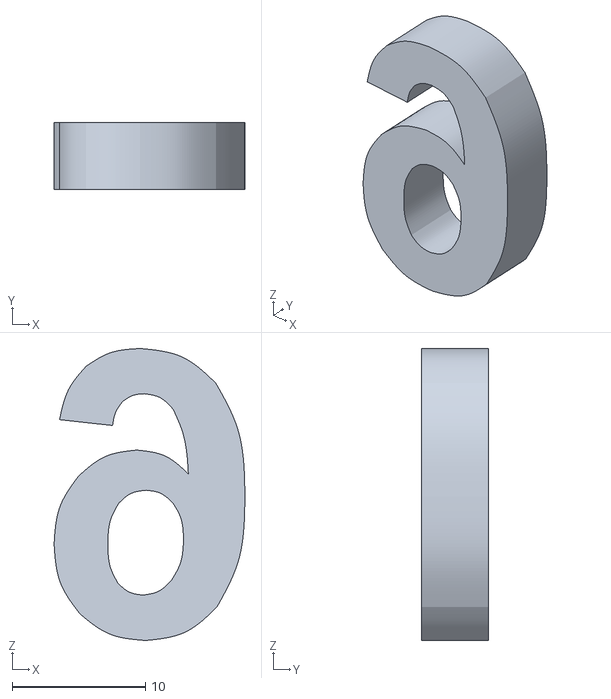
[picture p241: CAD file, 2025-03-22]
CAD/FRC/stl/6.stl
14.3 x 5.00 x 21.9
