dkittell/robotics-code-library/CAD/FRC/3mf/FF_cableclip-small-tall.3mf

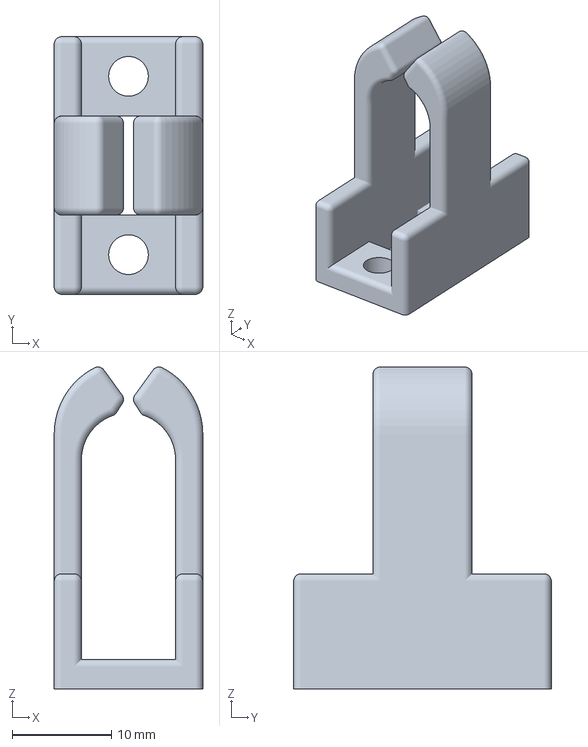
[picture p242: CAD file, 2025-03-22]
CAD/FRC/3mf/FF_cableclip-small-tall.3mf
15.0 x 26.0 x 32.5 mm
