dkittell/robotics-code-library/CAD/FRC/stl/boreforchassis.STL

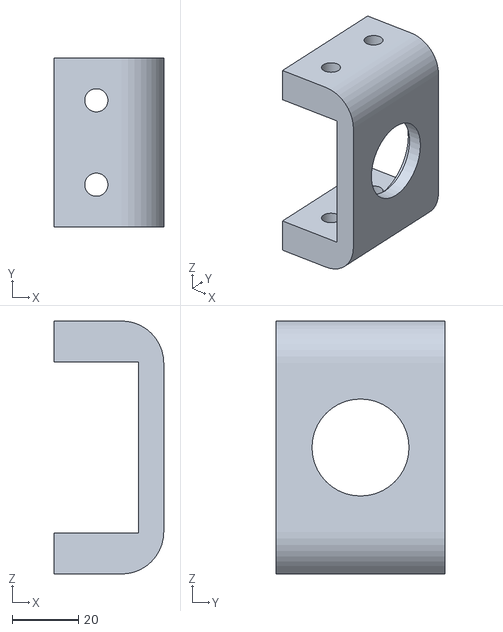
[picture p243: CAD file, 2025-03-22]
CAD/FRC/stl/boreforchassis.STL
33.0 x 50.8 x 76.2
