dkittell/robotics-code-library/CAD/FRC/3mf/Body1.3mf

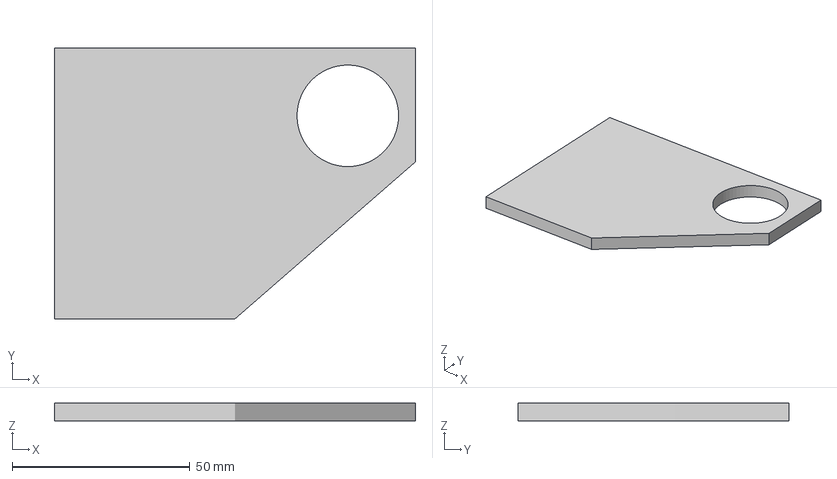
[picture p244: CAD file, 2025-03-22]
CAD/FRC/3mf/Body1.3mf
101.6 x 76.2 x 5.00 mm
