dkittell/robotics-code-library/CAD/FRC/stl/arm test.stl

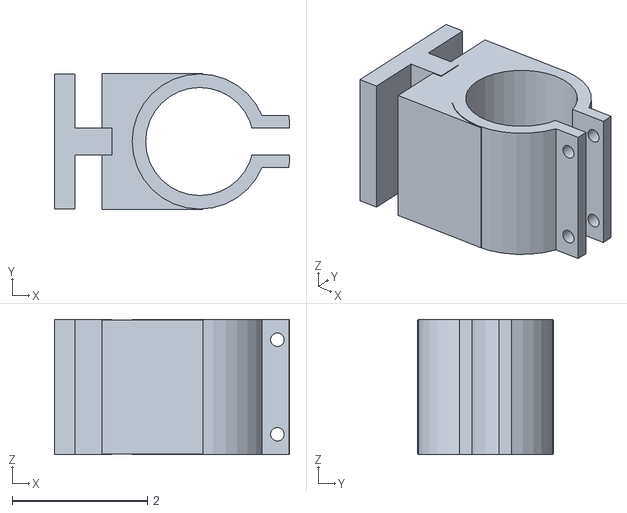
[picture p245: CAD file, 2025-03-22]
CAD/FRC/stl/arm test.stl
3.48 x 2.02 x 2.00
