dkittell/robotics-code-library/(list of files, cad)

Other CAD files:
CAD/FTC-FRC/Thingiverse/Linear_Servo_Actuators_3170748/files/Pinion_Gear_Mini_Version.STL
CAD/FRC/Liz/SPARKBOXX.STL
CAD/FTC-FRC/Thingiverse/Linear_Servo_Actuators_3170748/files/Pusher_75mm_Long.STL
CAD/FTC-FRC/Thingiverse/Linear_Servo_Actuators_3170748/files/Pusher_125mm_Long.STL
CAD/FTC-FRC/Thingiverse/Linear_Servo_Actuators_3170748/files/Step Files- DIY Linear Servo/Motor Bracket, Mini Version.STEP
CAD/FRC/Liz/rsllight0.03.STL
CAD/FTC-FRC/Thingiverse/Linear_Servo_Actuators_3170748/files/Pinion_Gear_Large_Version.STL
CAD/FRC/3mf/spark box.3mf
CAD/FRC/Liz/rsllight.SLDPRT
CAD/FRC/stl/elevatorShim.stl
CAD/FTC-FRC/Thingiverse/Linear_Servo_Actuators_3170748/files/Step Files- DIY Linear Servo/Pusher, 100mm Long.STEP
CAD/FRC/Liz/Assem1.sparkbox-Part1-1.STL
CAD/FRC/stl/rsllight0.03.STL
CAD/FTC-FRC/Thingiverse/Linear_Servo_Actuators_3170748/files/Pusher_150mm_Long.STL
CAD/FTC-FRC/Thingiverse/Linear_Servo_Actuators_3170748/files/Step Files- DIY Linear Servo/Motor Bracket, Large Version.STEP
CAD/FRC/stl/Shims.stl
CAD/FTC-FRC/Thingiverse/NotUsing/Parametric_8020_cable_clip_134506/files/8020_cable_cover.scad
CAD/FRC/3mf/FF_Blank_Spark_Max_Mounting_Bracket.3mf
CAD/FRC/3mf/FF_RoboRioPinPlug.3mf
CAD/FRC/3mf/Shape-Box.3mf
CAD/FRC/Isaiah/SLIDE PLATE.STL
CAD/FRC/shooterwheel.AMF
CAD/FRC/stl/7.stl
CAD/FRC/stl/8.stl
CAD/FRC/stl/8767 number print.stl
CAD/FRC/stl/Cable_organizer.stl
CAD/FRC/stl/Cable_organizer_.75.stl
CAD/FRC/stl/RSL Bracket - 8711.stl
CAD/FRC/stl/am-120AShield_AM.STL
CAD/FRC/stl/baering chassis.STL
CAD/FRC/stl/baring bottom holder.STL
CAD/FRC/stl/baring house.STL
CAD/FRC/stl/cales part for chassis.STL
CAD/FRC/stl/chassis.stl
CAD/FRC/stl/coralIntake2.stl
CAD/FRC/stl/hex coller.STL
CAD/FRC/stl/horse.stl
CAD/FRC/stl/neo hex key.STL
CAD/FRC/stl/offset part.STL
CAD/FRC/stl/shaft.STL
CAD/FRC/stl/shooterpanel1.0.STL
CAD/FRC/stl/tpuwheele.STL
CAD/FRC/stl/twopartcoller.STL
CAD/FRC/stl/wheel3.0.STL
CAD/FTC-FRC/GrabCAD/NotUsing/80-20-shaft-connector.stl
CAD/FTC-FRC/GrabCAD/NotUsing/FTC 4mm Adapter.stl
CAD/FTC-FRC/GrabCAD/NotUsing/Lift Mech/8020 1010 Extrusion.ipt
CAD/FTC-FRC/GrabCAD/NotUsing/Lift Mech/Extrusion1010V1.ipt
CAD/FTC-FRC/GrabCAD/NotUsing/Lift Mech/Extrusion1010V2.ipt
CAD/FTC-FRC/GrabCAD/NotUsing/Lift Mech/Extrusion1010V2.stl
CAD/FTC-FRC/GrabCAD/NotUsing/Lift Mech/Extrusion1010V3.ipt
CAD/FTC-FRC/GrabCAD/NotUsing/Lift Mech/OldVersions/Actual.0004.ipt
CAD/FTC-FRC/GrabCAD/NotUsing/Lift Mech/OldVersions/Extrusion1010V2.0007.ipt
CAD/FTC-FRC/GrabCAD/NotUsing/Lift Mech/OldVersions/Slider Prototype.0003.ipt
CAD/FTC-FRC/GrabCAD/NotUsing/Lift Mech/OldVersions/SliderWrap.0001.ipt
CAD/FTC-FRC/GrabCAD/NotUsing/Lift Mech/SliderPrototypeV1.stl
CAD/FTC-FRC/GrabCAD/NotUsing/gripper-claw-1.snapshot.2/stepfiles/40 toothed rev gear.STEP
CAD/FTC-FRC/GrabCAD/NotUsing/gripper-claw-1.snapshot.2/stepfiles/gripper 2.0.STEP
CAD/FTC-FRC/GrabCAD/NotUsing/gripper-claw-1.snapshot.2/stepfiles/gripper. Axel holder.STEP
CAD/FTC-FRC/GrabCAD/NotUsing/gripper-claw-1.snapshot.2/stepfiles/grippler base bottom.STEP
CAD/FTC-FRC/GrabCAD/NotUsing/gripper-claw-1.snapshot.2/stepfiles/grippler base.STEP
CAD/FTC-FRC/GrabCAD/NotUsing/slider-t-nut-for-2020-and-3030-aluminium-profile-1.snapshot.18/2020/Slider T-Nut for 2020 - M3.f3d
CAD/FTC-FRC/GrabCAD/NotUsing/slider-t-nut-for-2020-and-3030-aluminium-profile-1.snapshot.18/2020/Slider T-Nut for 2020 - M3.iges
CAD/FTC-FRC/GrabCAD/NotUsing/slider-t-nut-for-2020-and-3030-aluminium-profile-1.snapshot.18/2020/Slider T-Nut for 2020 - M3.step
CAD/FTC-FRC/GrabCAD/NotUsing/slider-t-nut-for-2020-and-3030-aluminium-profile-1.snapshot.18/2020/Slider T-Nut for 2020 - M4.f3d
CAD/FTC-FRC/GrabCAD/NotUsing/slider-t-nut-for-2020-and-3030-aluminium-profile-1.snapshot.18/2020/Slider T-Nut for 2020 - M4.iges
CAD/FTC-FRC/GrabCAD/NotUsing/slider-t-nut-for-2020-and-3030-aluminium-profile-1.snapshot.18/2020/Slider T-Nut for 2020 - M4.step
CAD/FTC-FRC/GrabCAD/NotUsing/slider-t-nut-for-2020-and-3030-aluminium-profile-1.snapshot.18/2020/Slider T-Nut for 2020 - M5.f3d
CAD/FTC-FRC/GrabCAD/NotUsing/slider-t-nut-for-2020-and-3030-aluminium-profile-1.snapshot.18/2020/Slider T-Nut for 2020 - M5.iges
CAD/FTC-FRC/GrabCAD/NotUsing/slider-t-nut-for-2020-and-3030-aluminium-profile-1.snapshot.18/2020/Slider T-Nut for 2020 - M5.step
CAD/FTC-FRC/GrabCAD/NotUsing/slider-t-nut-for-2020-and-3030-aluminium-profile-1.snapshot.18/3030/Slider T-Nut for 3030 - M3.f3d
CAD/FTC-FRC/GrabCAD/NotUsing/slider-t-nut-for-2020-and-3030-aluminium-profile-1.snapshot.18/3030/Slider T-Nut for 3030 - M3.iges
CAD/FTC-FRC/GrabCAD/NotUsing/slider-t-nut-for-2020-and-3030-aluminium-profile-1.snapshot.18/3030/Slider T-Nut for 3030 - M3.step
CAD/FTC-FRC/GrabCAD/NotUsing/slider-t-nut-for-2020-and-3030-aluminium-profile-1.snapshot.18/3030/Slider T-Nut for 3030 - M4.f3d
CAD/FTC-FRC/GrabCAD/NotUsing/slider-t-nut-for-2020-and-3030-aluminium-profile-1.snapshot.18/3030/Slider T-Nut for 3030 - M4.iges
CAD/FTC-FRC/GrabCAD/NotUsing/slider-t-nut-for-2020-and-3030-aluminium-profile-1.snapshot.18/3030/Slider T-Nut for 3030 - M4.step
CAD/FTC-FRC/GrabCAD/NotUsing/slider-t-nut-for-2020-and-3030-aluminium-profile-1.snapshot.18/3030/Slider T-Nut for 3030 - M5.f3d
CAD/FTC-FRC/GrabCAD/NotUsing/slider-t-nut-for-2020-and-3030-aluminium-profile-1.snapshot.18/3030/Slider T-Nut for 3030 - M5.iges
CAD/FTC-FRC/GrabCAD/NotUsing/slider-t-nut-for-2020-and-3030-aluminium-profile-1.snapshot.18/3030/Slider T-Nut for 3030 - M5.step
CAD/FTC-FRC/GrabCAD/NotUsing/slider-t-nut-for-2020-and-3030-aluminium-profile-1.snapshot.18/3030/Slider T-Nut for 3030 - M6.f3d
CAD/FTC-FRC/GrabCAD/NotUsing/slider-t-nut-for-2020-and-3030-aluminium-profile-1.snapshot.18/3030/Slider T-Nut for 3030 - M6.iges
CAD/FTC-FRC/GrabCAD/NotUsing/slider-t-nut-for-2020-and-3030-aluminium-profile-1.snapshot.18/3030/Slider T-Nut for 3030 - M6.step
CAD/FTC-FRC/GrabCAD/centerstage-pixel-2022-23-ftc-1.snapshot.2/Centerstage Pixel.3mf
CAD/FTC-FRC/GrabCAD/centerstage-pixel-2022-23-ftc-1.snapshot.2/Centerstage Pixel.stl
CAD/FTC-FRC/Thingiverse/NotUsing/8020-1010_M5_T-Nut_2125093/files/T-Nut.stl
CAD/FTC-FRC/Thingiverse/NotUsing/8020_15-series_bracket_collection_3669194/files/8020_15-series_2-hole_T-nut_1_4-20_tap.stl
CAD/FTC-FRC/Thingiverse/NotUsing/8020_15-series_bracket_collection_3669194/files/8020_15-series_2-hole_T-nut_5_16-18_tap.stl
CAD/FTC-FRC/Thingiverse/NotUsing/8020_15-series_bracket_collection_3669194/files/8020_15-series_T-nut_1_4-20_tap.stl
CAD/FTC-FRC/Thingiverse/NotUsing/8020_15-series_bracket_collection_3669194/files/8020_15-series_T-nut_5_16-18_tap.stl
CAD/FTC-FRC/Thingiverse/NotUsing/Adjustable_2020_PTFE_Slider_1721338/files/2020_Adj_Slider2.skp
CAD/FTC-FRC/Thingiverse/NotUsing/M3_screw_8020_1010_t-slot_109272/files/tslot_profile_2.STL
