dkittell/robotics-code-library/OtherTeams/FRC3535/LabView/robot_code/wiring_ref_2013.xls

Sheet: Analog_Digital_Solenoid
 | Version 10 – 10 Mar 2013
Interface / Port Number | Hardware Name | Software Reference | Wire Name | Notes
cRIO
Ethernet #1 | Robot Router | N/A
Robot Router
LAN 1 | cRIO Ethernet | N/A
LAN 2 | IMU
LAN 3 | CoProcessor
LAN 4 | Pit Jack
cRIO Slot 1 Analog Bumper | Analog Breakout #1
1 | Turn Gyro | turnGyro | turn_gyro
2 | Climb Motor Current | climbMotorCurrent | climb_current
3 | Shooter Elevator Encoder | elevatorEncoder | ele_encoder | 0.04879040455
4 | Sonar | Sonar
5
6
7
8
cRIO Slot 4 Analog Bumper | Analog Breakout #2
1
2
3
4
5
6
7
8
cRIO Slot 2 Digital Side Car | DI/DO Ports
1 | Left Wheel encoder channel A | leftWheelEncoder | l_encoder_a
2 | Left Wheel encoder channel B |  | l_encoder_b
3 | Right Wheel encoder channel A | rightWheelEncoder | r_encoder_a
4 | Right Wheel encoder channel B |  | r_encoder_b
5 | Shooter halleffect | shooterRpm | rpm
6 | Demodulated Breack Beam prime disk | breakBeamPrime | prime
7 | Sky Hook Home | skyHookHome
8 | Demodulated Break Beam on deck disk | breakBeamOnDeck | on_deck
9 | Demodulated Break Beam first disk | breakBeam_1
10 | Climb Arm (winch) channel A | climbSensor | climb_encoder_a
11 | Climb Arm (winch) channel B |  | climb_encoder_b
12 | Alignment Limit Switch (left) | alignSwitchLeft | align_left
13 | Alignment Limit Switch (right) | alignSwitchRight | align_right
14 | Pneumatic Pressure | compressorSwitch | pressure
cRIO Slot 2 Digital Side Car | Relay Ports
1 | Compressor | compressor | compressor
2 | Agitator / Disc Drive | conveyor
3 | Floor Pickup | floorPickup
4
5 | Floor conveyor | floorConveyor
6
7
8
cRIO Slot 2 Digital Side Car | PWM Ports
1 | Left Drive | robotDrive | l_drive | Talon, Invert=True
2 | Right Drive |  | r_drive | Talon, Invert=False
3 | Shooter Thrust | shooterThrust | shooter | Talon, Invert=True
4 | Shooter Elevator | shooterElevator | elevator | Talon, Invert=True
5 | Load Servo, Front | loadServoFront | load_1
6 | Saftey Servo | safetyServo | saftey
7 | Load Servo, Back | loadServoBack | load_2
8 | Climb Motor | climbMotor | climb | Victor
9 | Break Servo | breakServo | break
10
cRIO Slot 2 Digital Side Car | I2C Ports
1
2
3
4
cRIO Slot 3 Solenoid | Solenoid Bumper
1 | Fire | fireSolenoid | fire_engage
2 | Fire Reload |  | fire_disengage
3 | Pullup extend | pullup | pullup_engage
4 | Pullup retract |  | pullup_disengage
5 | Slapper Engage | slapper | slapper_engage
6 | Slapper Disengage |  | slapper_disengage
7 | Pusher out | outPush
8
Control Station | USB
1 | Driver Gamepad | driverGamepad
2 | Operator Gamepad | operatorGamepad

Sheet: Power_Board
 |  |  | WIRE |  |  |  |  | WIRE
Number Ref | CONNECTOR | BREAKER | GAUGE | COLOR | SIDE | HARDWARE NAME | SIDE | COLOR | GAUGE | BREAKER | CONNECTOR | Number Ref
 |  |  |  |  |  |  | → |  |  | 40 | 40
 | 40 |  |  |  | ←
 |  |  |  |  |  |  | → |  |  | 40 | 40
 | 40 |  |  |  | ←
 |  |  |  |  |  |  | → |  |  | 40 | 40
 | 40 |  |  |  | ←
 |  |  |  |  |  |  | → |  |  | 40 | 40
 | 40 |  |  |  | ←
 |  |  |  |  |  |  | → |  |  |  | 30
 | 30 |  |  |  | ←
 |  |  |  |  |  |  | → |  |  |  | 30
 | 30 |  |  |  | ←
 |  |  |  |  |  |  | → |  |  |  | 30
 | 30 |  |  |  | ←
 |  |  |  |  |  |  | → |  |  |  | 30
 | 30 |  |  |  | ←
 |  |  |  |  |  |  | → |  |  |  | 30
 | 30 |  |  |  | ←
 |  |  |  |  |  |  | → |  |  |  | 30
 | 30 |  |  |  | ←
 |  |  |  |  |  | CRIO POWER
 |  |  |  | - | + | |+|-|N|N| | - | +

Sheet: Gamepad_Mapping
Gamepad1 | Driver | Action | Global Variables
Joystick1 x | not used | -
Joystick1 y | Drive | Hold to Enable
Joystick2 x | Turn | Hold to Enable
Joystick2 y | not used | -
button 1 | Start climb | Initiate | button1_Dr
button 2 | Auto Align (to Tower) | Hold to Enable | button2_Dr
button 3 | Slapper engage / disengage | Toggle | button3_Dr
button 4 | Pull up bar extend / retract | Toggle | button4_Dr
button 5 | Sky Hook extend | Hold to Enable | button5_Dr
button 6 | Sky Hook retract | Hold to Enable | button6_Dr
button 7 | Slow - Drive and Sky Hook | Hold to Enable | button7_Dr
button 8 | Quick turn (cheesy drive) | Hold to Enable | button8_Dr
button 9 | Change Climb Mode | Toggle Sequence | button9_Dr
button 10 | Abort climb | Initiate | button10_Dr
button 11 | not used | -
button 12 | not used | -
Gamepad2 | Operator
Joystick1 x | not used | -
Joystick1 y | Bump RPM down / Bump RPM up | Bump |  | Log
Joystick2 x | not used | -
Joystick2 y | Bump shooter pitch down / Bump shooter pitch up | Bump |  | Log
button 1 | Level 1 Tower Shot | Hold to Enable | button1_Op
button 2 | Level 2 Tower Shot | Hold to Enable | button2_Op
button 3 | Level 3 Tower Shot | Hold to Enable | button3_Op | Log
button 4 | Load | Toggle | button4_Op | Log
button 5 | not used | - | button5_Op
button 6 | Shoot | Initiate | button6_Op | Log
button 7 | not used | - | button7_Op
button 8 | Pelican Maneuver | Initiate | button8_Op
button 9 | Indexer to Queue | Hold to Enable | button9_Op
button 10 | Indexer to Prime | Hold to Enable | button10_Op | Log
button 11 | not used | -
button 12 | not used | -
D Pad Up | Wish (RPM Override) | Hold to Enable
D Pad Down | Corner Tower Shot (affects elevator pitch only) | Hold to Enable

Sheet: Code_Proc
Initial conditions
 | Bot on
 | Comm on
Run FRC 2012 cRIO Imaging Tool |  | Match Config | Develop Config
 | Put No App in Lit position (Inconsistent with all other switches) | No App UN-LIT | No App LIT
 | On Robot Code Project, select Build Specifications
 | Right Click 'FRC Robot Boot-up Deployment'
 | Select 'Build'
 | Wait for completion
 | Right Click 'FRC Robot Boot-up Deployment'
 | Select 'Run as Startup'
 | Yes to Reboot
 | Wait to re-establish Comm, then
 | Flip the No App switch to Un-Lit position (consistent with all other switches)
 | Wait for curser, then Apply
 | Wait for Robot Code

Sheet: Competition Bot
Palmetto | DC
Personality … | Confirm BW Servos connected properly
Confirm Elevator Calibration |  | PWM 5 is FRONT
Confirm Asym Elevator settings |  | PWM 7 is BACK
Hardware Personality to Bot A |  | Test by temp increase BW delay on Collector tab of PT
Measure Bot A Elevator Actual Angle |  | Archive Odometer file
Shoot and Load
Charactrize over full range |  | Confirm SkyHook Encoder DIO positions
Starting Configuratiom |  | MOVE PARAMETER FILE ONTO cRIO !!!!
Elevator Up
Bat Wings Blocking |  | Confirm Slapper plumbed the same, test is TeleOp upon should be UnSlapped
Ascent Correct
 |  | Take PT off of Auto-Detect
Confirm Slapper and Chin-Up commanded direction is correct
 |  | Remove Demo Mode
 |  | Remove Ratchet Brake Release from Ascent VI / Manual case
 |  | Remove Slapper diagnostic contol from Auto Ascent / Climb First Rung 3

Sheet: Time Budget
Loop | Avg Duration (ms) | Max Duration (ms) | Period (ms) | CPU %
Fire Control | 0.3 | 1 | 16 | 1.9%
Shooter | 0.3 | 0.4 | 11 | 2.7%
Elevator | 0.2 | 0.3 | 21 | 1.0%
Drive | 0.1 | 0.1 | 41 | 0.2%
Climb | 0.3 | 36.1 | 50 | 0.6%
Tele-Op | 1.4 | 28.4 | 20 | 7.0%
 |  |  |  | 13.4%
