dkittell/robotics-code-library/CAD/FTC-FRC/Thingiverse/NotUsing/Aluminiumprofile_Slider___linear_guide_2572864/README.txt

Aluminiumprofile Slider / linear guide by Psyqjo on Thingiverse: https://www.thingiverse.com/thing:2572864
