dkittell/robotics-code-library/CAD/FLL/First Lego League/images/3D-print-FLL-cut.jpg

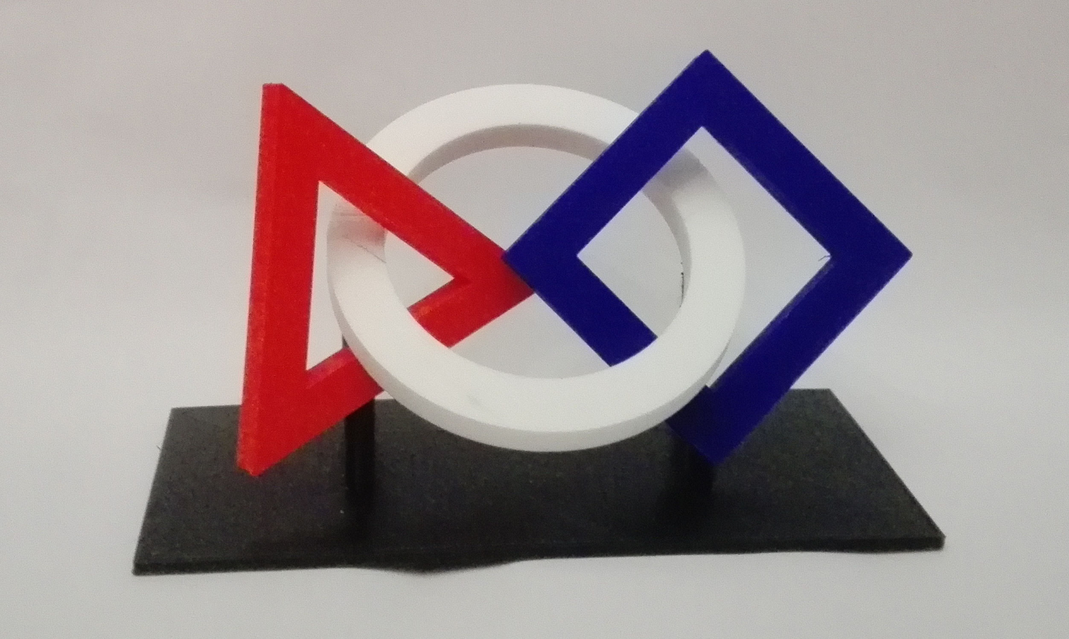
CAD/FLL/First Lego League/images/3D-print-FLL-cut.jpg
