dkittell/robotics-code-library/CAD/FTC-FRC/Thingiverse/NotUsing/Aluminiumprofile_Slider___linear_guide_2572864/images/1f90ea11c367b9f7b1f043fc56660e1b.jpg

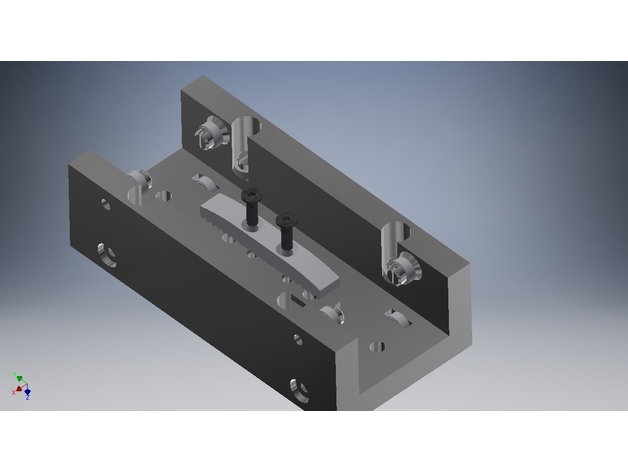
CAD/FTC-FRC/Thingiverse/NotUsing/Aluminiumprofile_Slider___linear_guide_2572864/images/1f90ea11c367b9f7b1f043fc56660e1b.jpg
