dkittell/robotics-code-library/CAD/FTC-FRC/Thingiverse/NotUsing/Aluminiumprofile_Slider___linear_guide_2572864/images/07f93c65642e22f2cfd955e652372da7.jpg

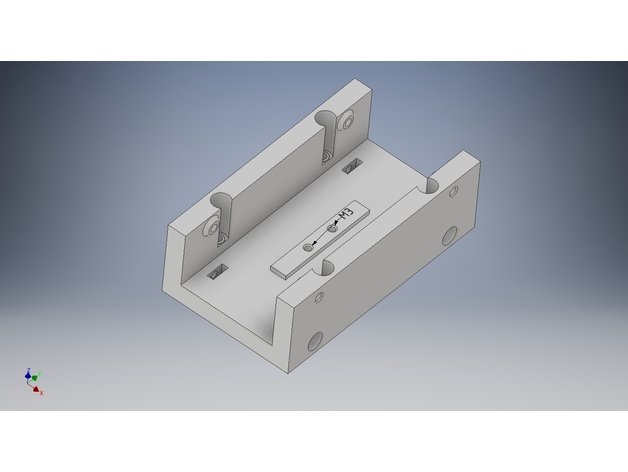
CAD/FTC-FRC/Thingiverse/NotUsing/Aluminiumprofile_Slider___linear_guide_2572864/images/07f93c65642e22f2cfd955e652372da7.jpg
