dkittell/robotics-code-library/CAD/FTC-FRC/Thingiverse/NotUsing/Aluminiumprofile_Slider___linear_guide_2572864/images/8b09edea15f8a9dc9fc1c9ee7117163e.jpg

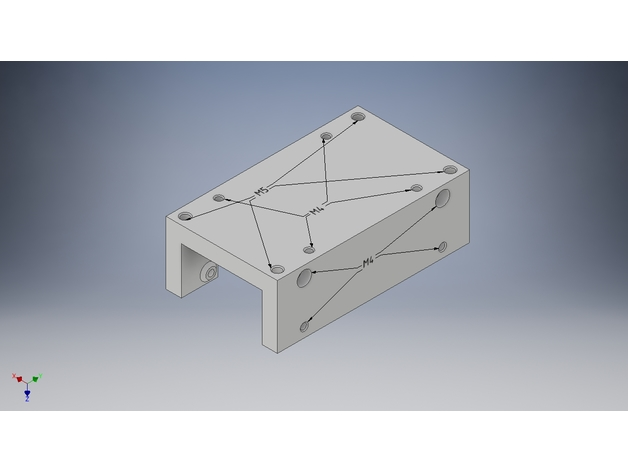
CAD/FTC-FRC/Thingiverse/NotUsing/Aluminiumprofile_Slider___linear_guide_2572864/images/8b09edea15f8a9dc9fc1c9ee7117163e.jpg
