dkittell/robotics-code-library/CAD/FTC-FRC/Thingiverse/NotUsing/Aluminiumprofile_Slider___linear_guide_2572864/images/9f29e5ed843b435fcc8ed7b83e3977c3.jpg

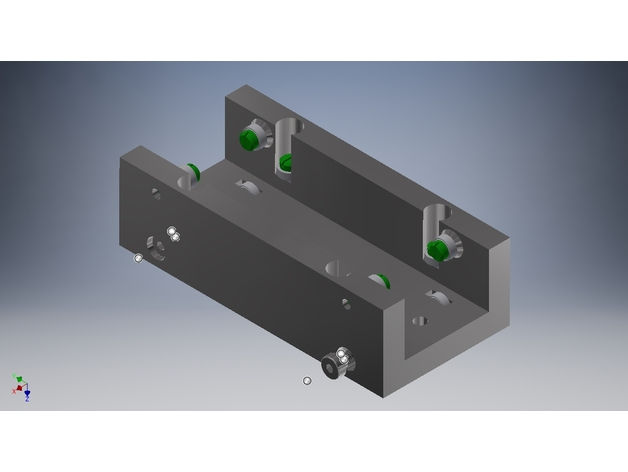
CAD/FTC-FRC/Thingiverse/NotUsing/Aluminiumprofile_Slider___linear_guide_2572864/images/9f29e5ed843b435fcc8ed7b83e3977c3.jpg
