dkittell/robotics-code-library/FTC/2021/Block/Auton/BasicMotorTest.png

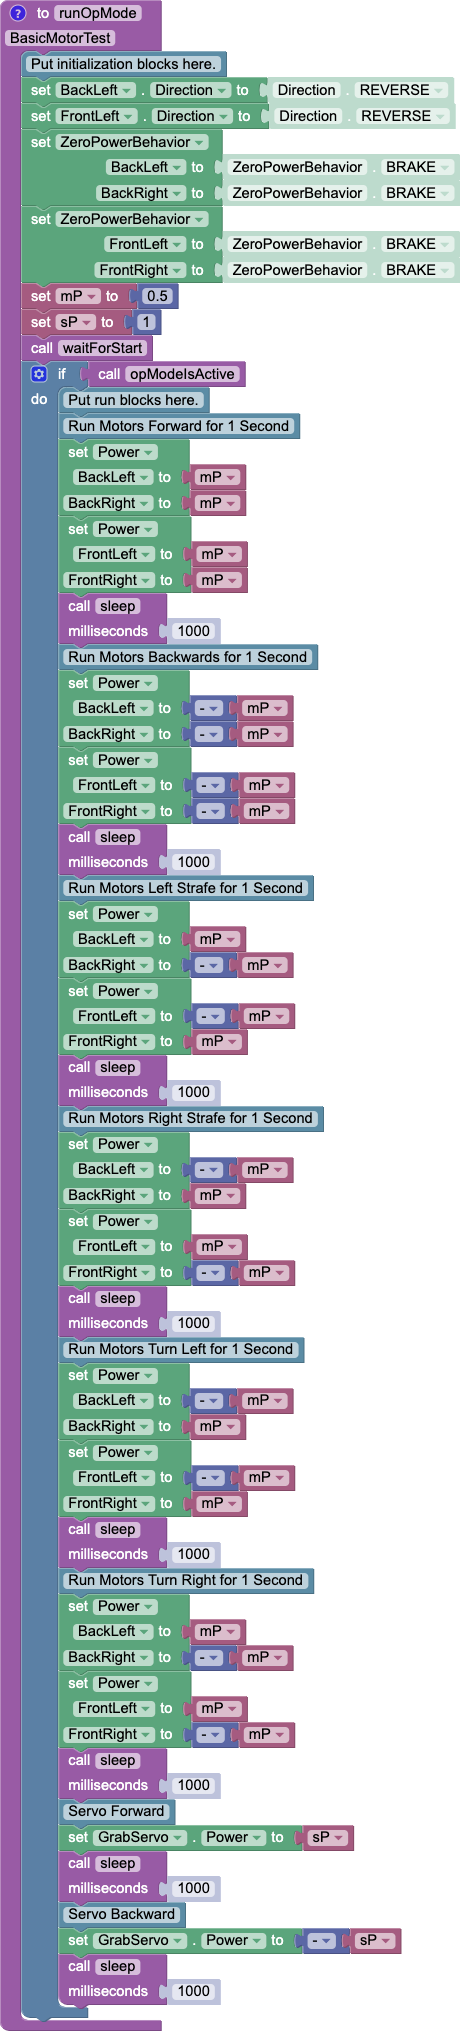
FTC/2021/Block/Auton/BasicMotorTest.png
