dkittell/robotics-code-library/FTC/2021/Block/Auton/GoBildaEncoderTest.png

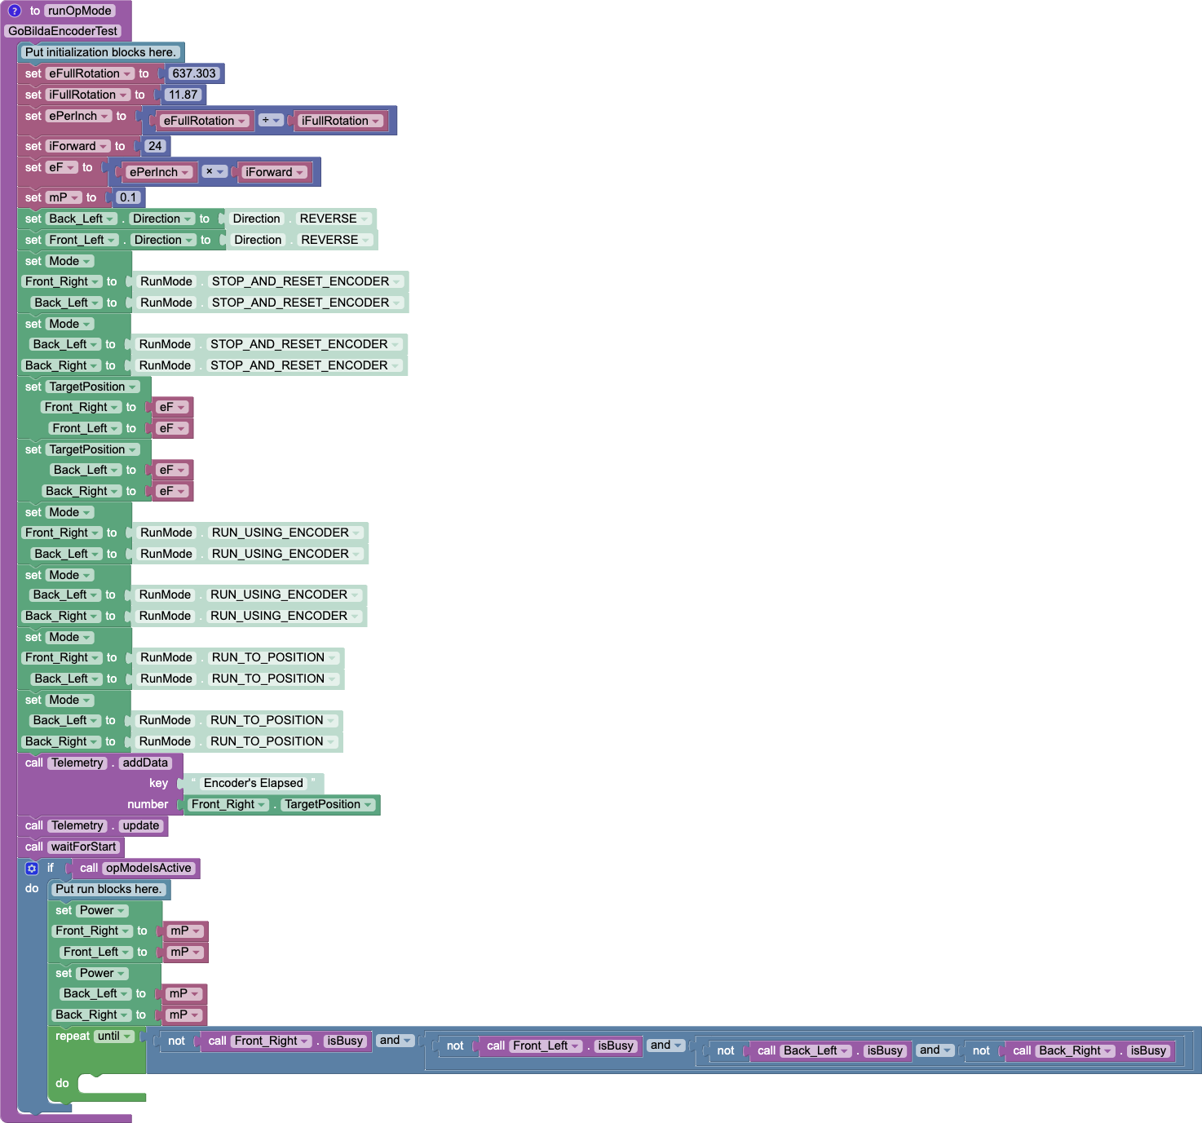
FTC/2021/Block/Auton/GoBildaEncoderTest.png
