dkittell/robotics-code-library/FTC/2021/Block/Telop/Servo_Tester.png

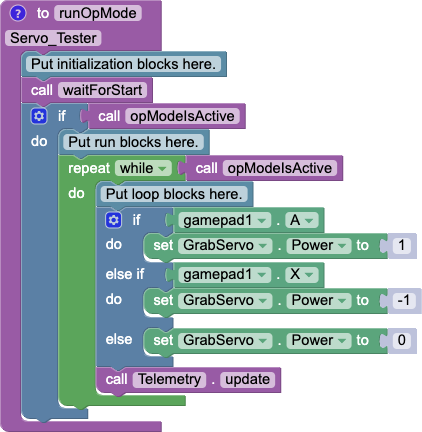
FTC/2021/Block/Telop/Servo_Tester.png
