dkittell/robotics-code-library/FTC/2022/Block/Auton/Diagnostic/Test_Wheel_Direction.png

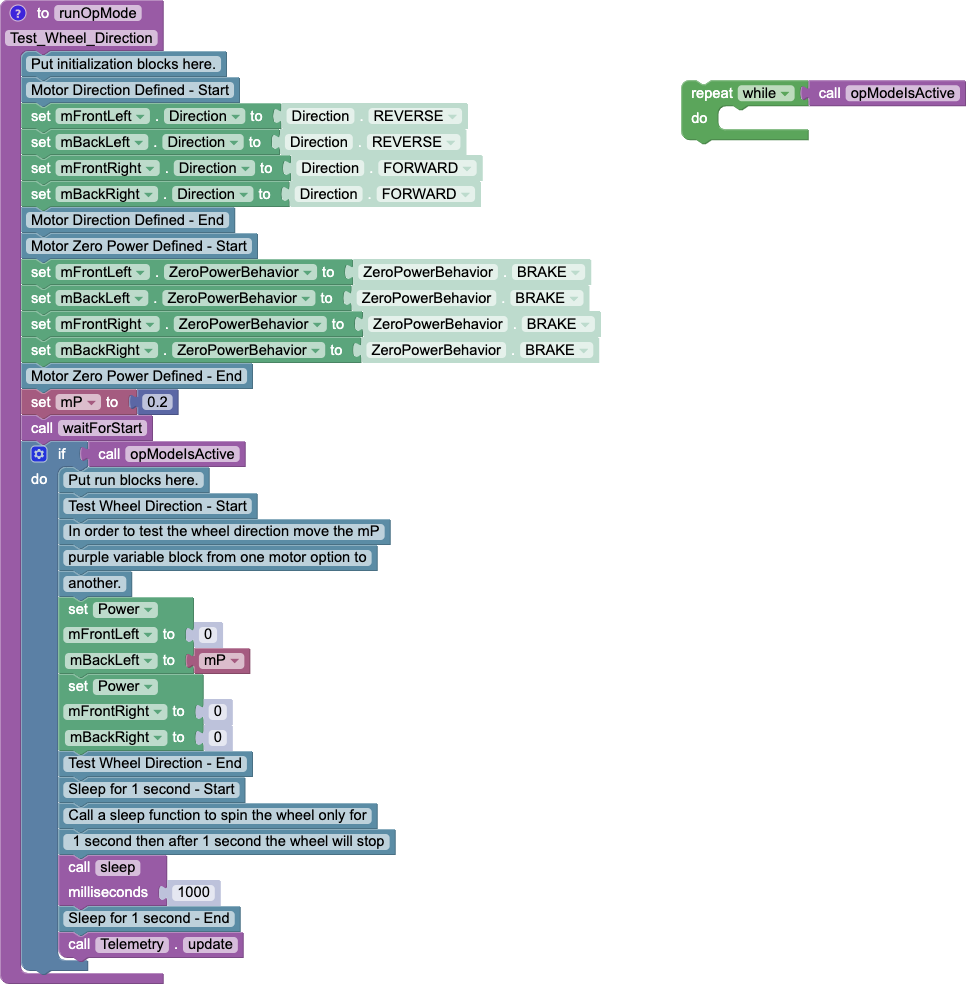
FTC/2022/Block/Auton/Diagnostic/Test_Wheel_Direction.png
