dkittell/robotics-code-library/FTC/2022/Block/Testing/HeadLightTest.png

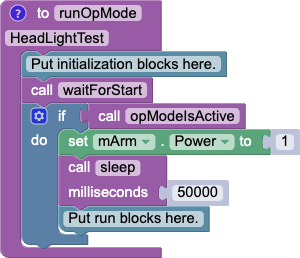
FTC/2022/Block/Testing/HeadLightTest.png
