dkittell/robotics-code-library/FTC/2022/Block/Testing/Vision_Joe.png

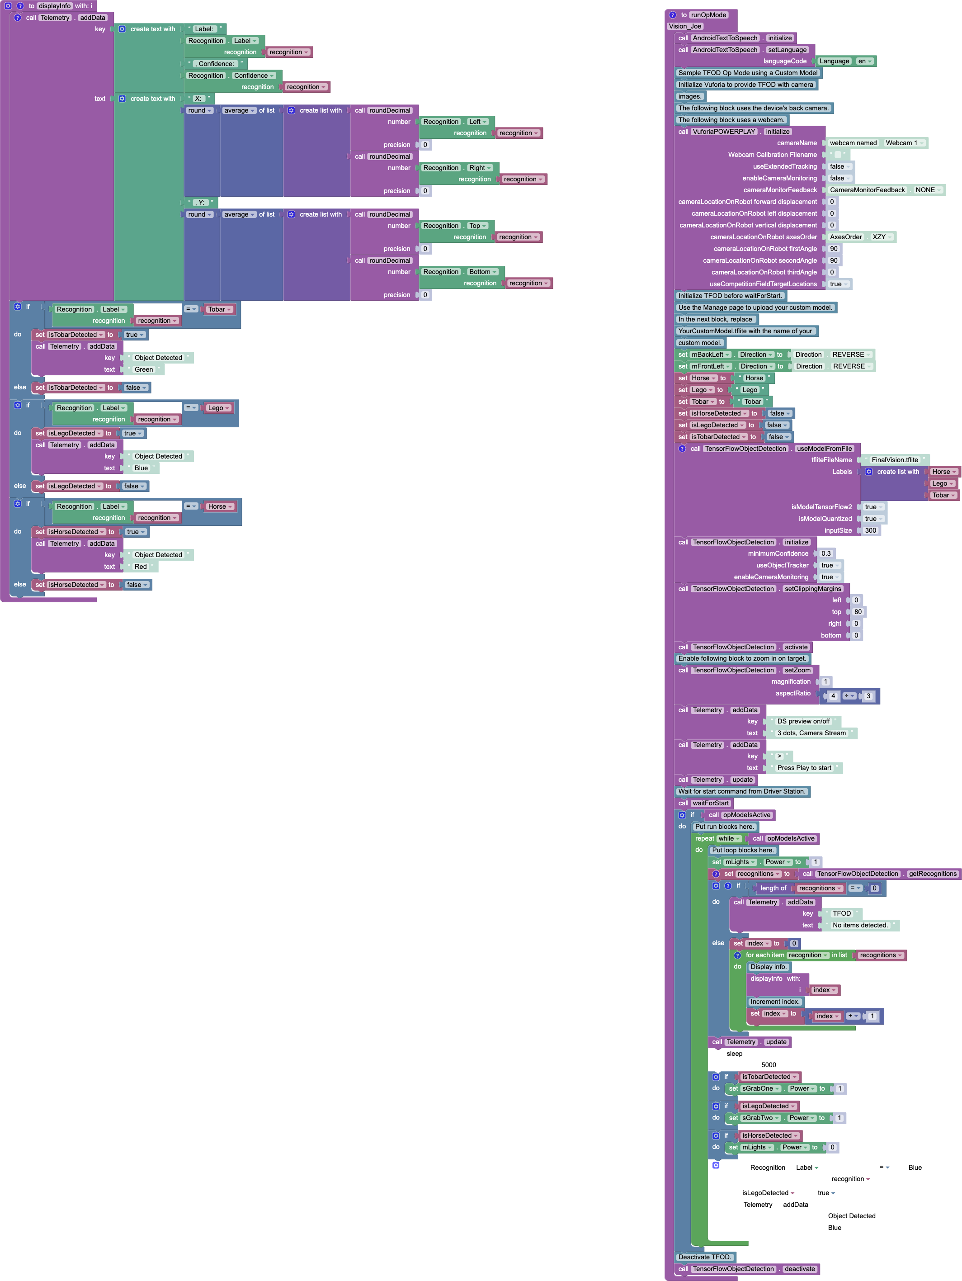
FTC/2022/Block/Testing/Vision_Joe.png
