dkittell/robotics-code-library/FTC/2023/7065/Block/Auton/Testing/Encoder Count Drive.png

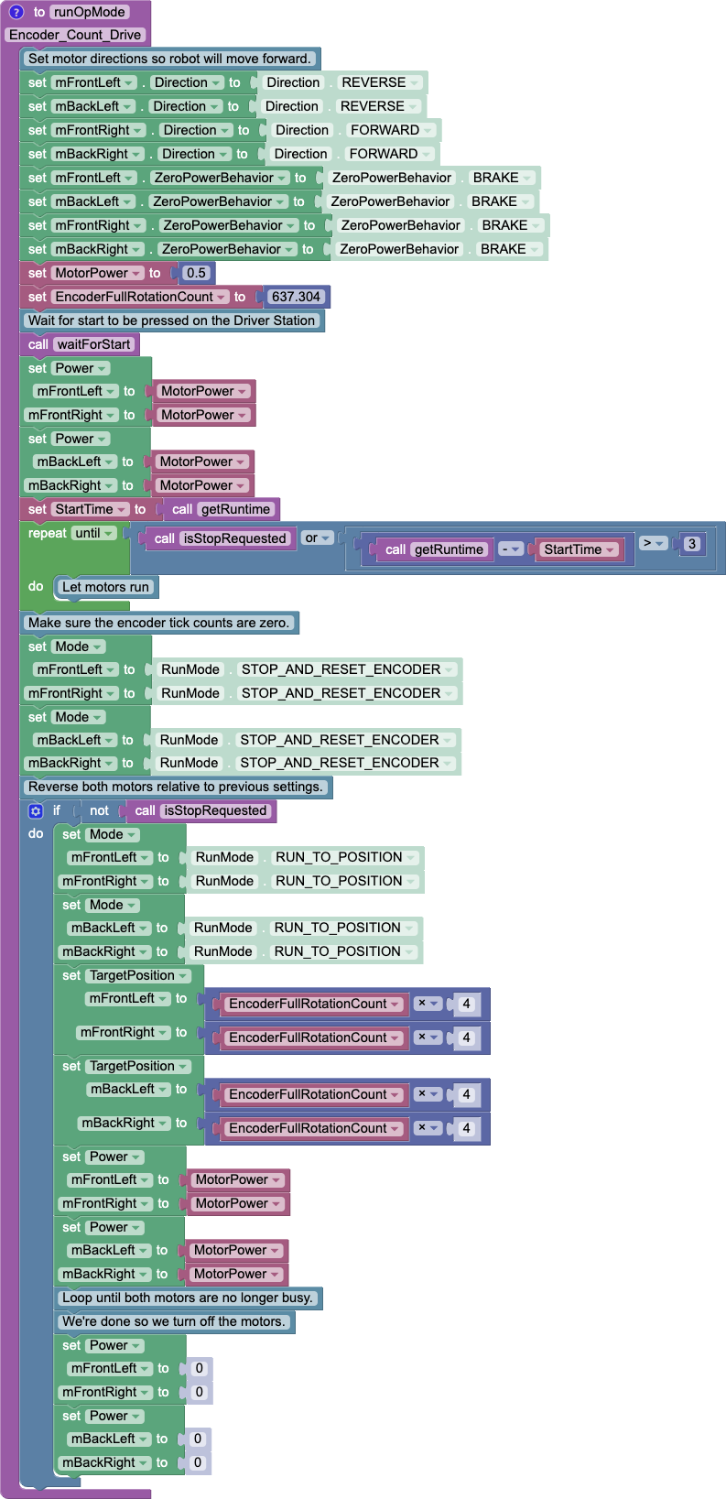
FTC/2023/7065/Block/Auton/Testing/Encoder Count Drive.png
