dkittell/robotics-code-library/FTC/2023/7065/Block/Diagnostic/armTest.png

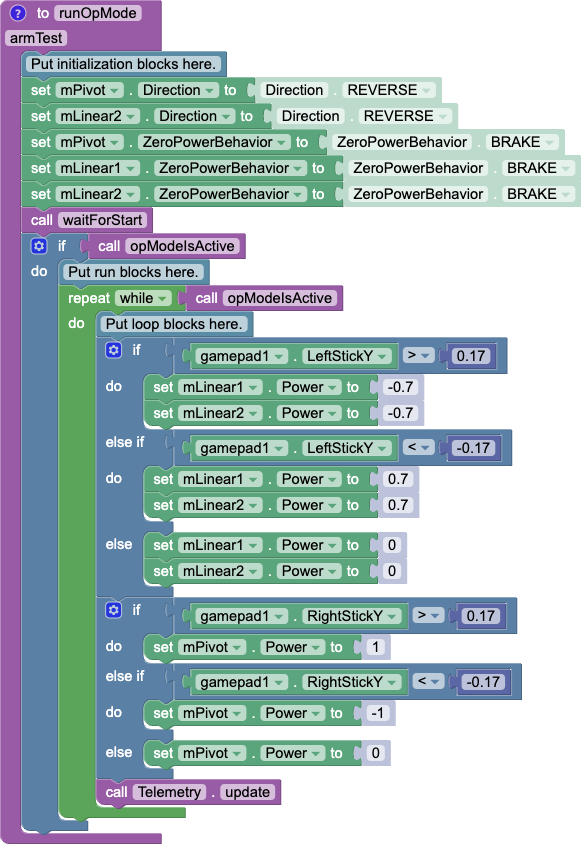
FTC/2023/7065/Block/Diagnostic/armTest.png
