dkittell/robotics-code-library/FTC/2023/7065/Block/Diagnostic/Tank/Test_Wheel_Direction_Teleop.png

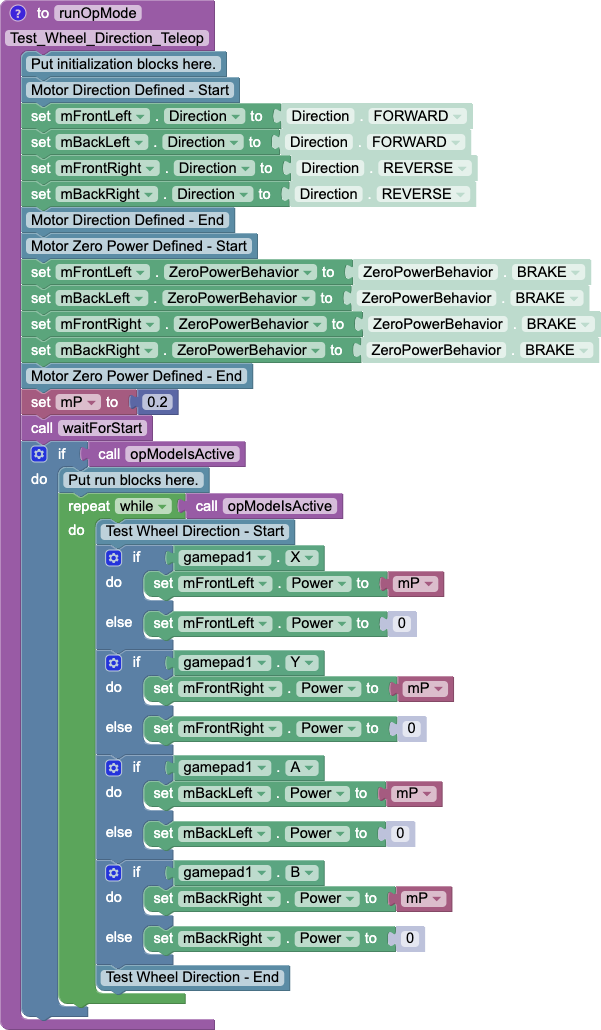
FTC/2023/7065/Block/Diagnostic/Tank/Test_Wheel_Direction_Teleop.png
