dkittell/robotics-code-library/FTC/2023/7065/Block/Diagnostic/Test_Servo_Direction.png

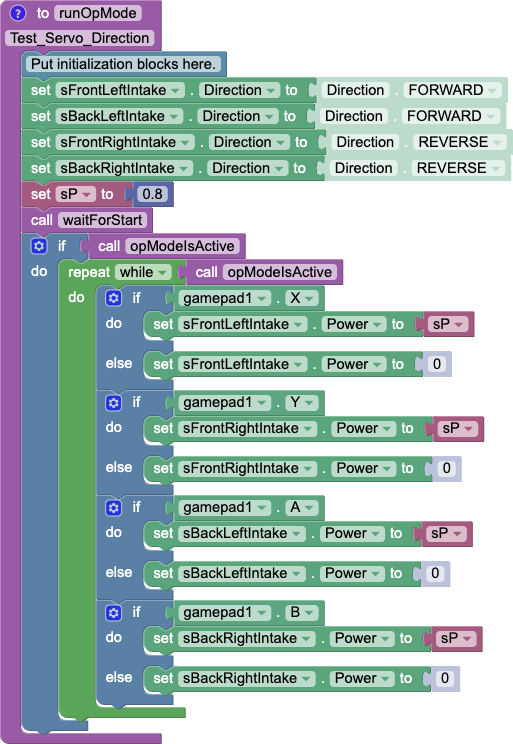
FTC/2023/7065/Block/Diagnostic/Test_Servo_Direction.png
