dkittell/robotics-code-library/FTC/2023/7065/Block/Diagnostic/touchSensorTest.png

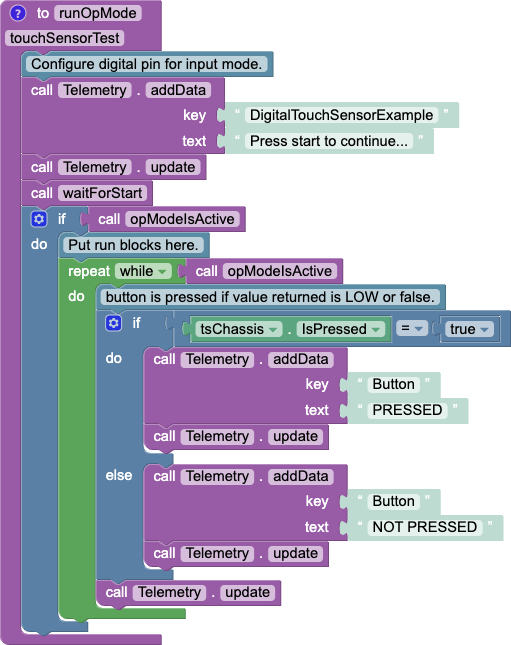
FTC/2023/7065/Block/Diagnostic/touchSensorTest.png
