dkittell/robotics-code-library/FTC/2023/7065/Block/Teleop/Tank/Servo_test.png

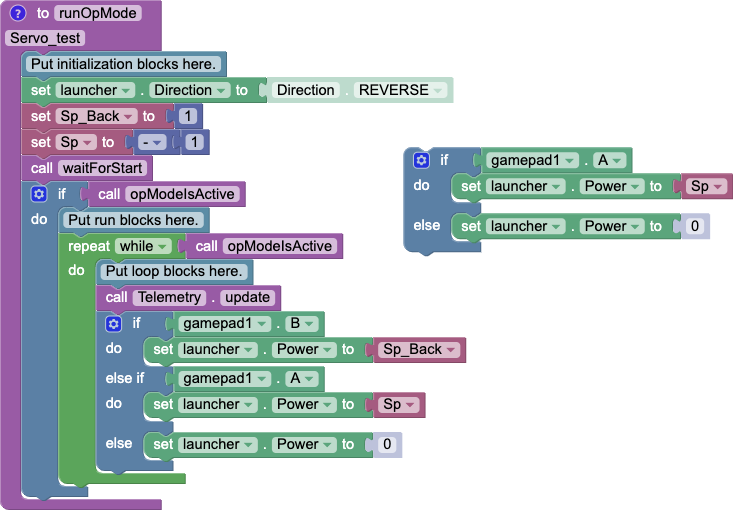
FTC/2023/7065/Block/Teleop/Tank/Servo_test.png
