dkittell/robotics-code-library/FTC/2023/19436/blocks/color sensor test.png

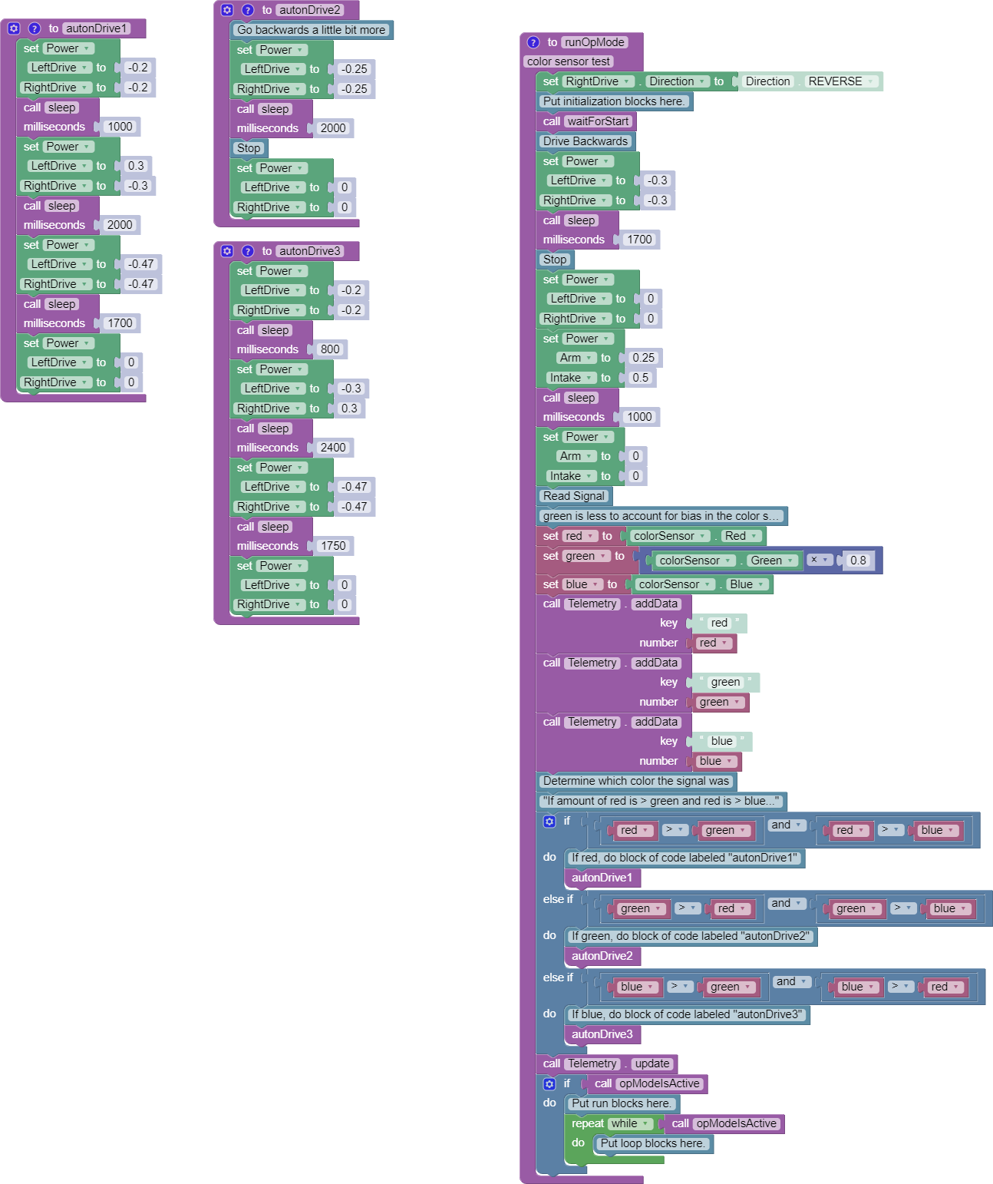
FTC/2023/19436/blocks/color sensor test.png
