dkittell/robotics-code-library/FTC/2023/22364/blocks/POVDrive Test.png

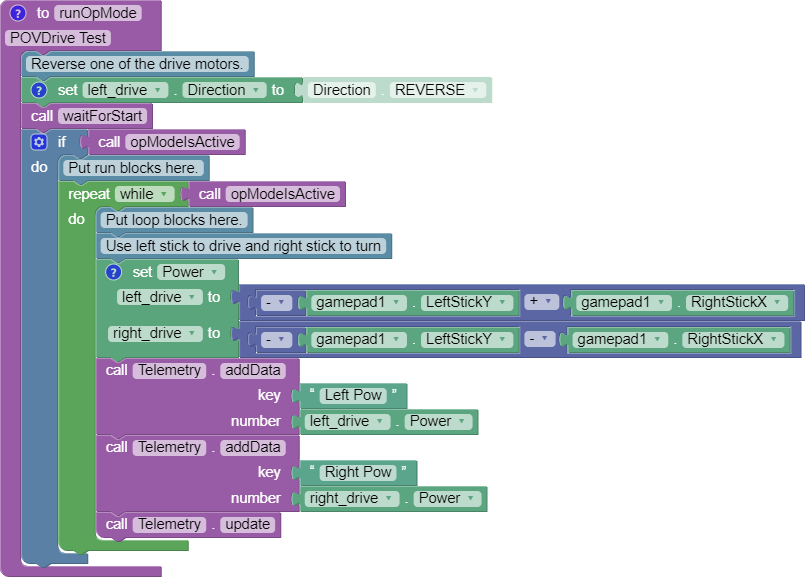
FTC/2023/22364/blocks/POVDrive Test.png
