dkittell/robotics-code-library/FTC/2024/Block/Phil-WheelTest.png

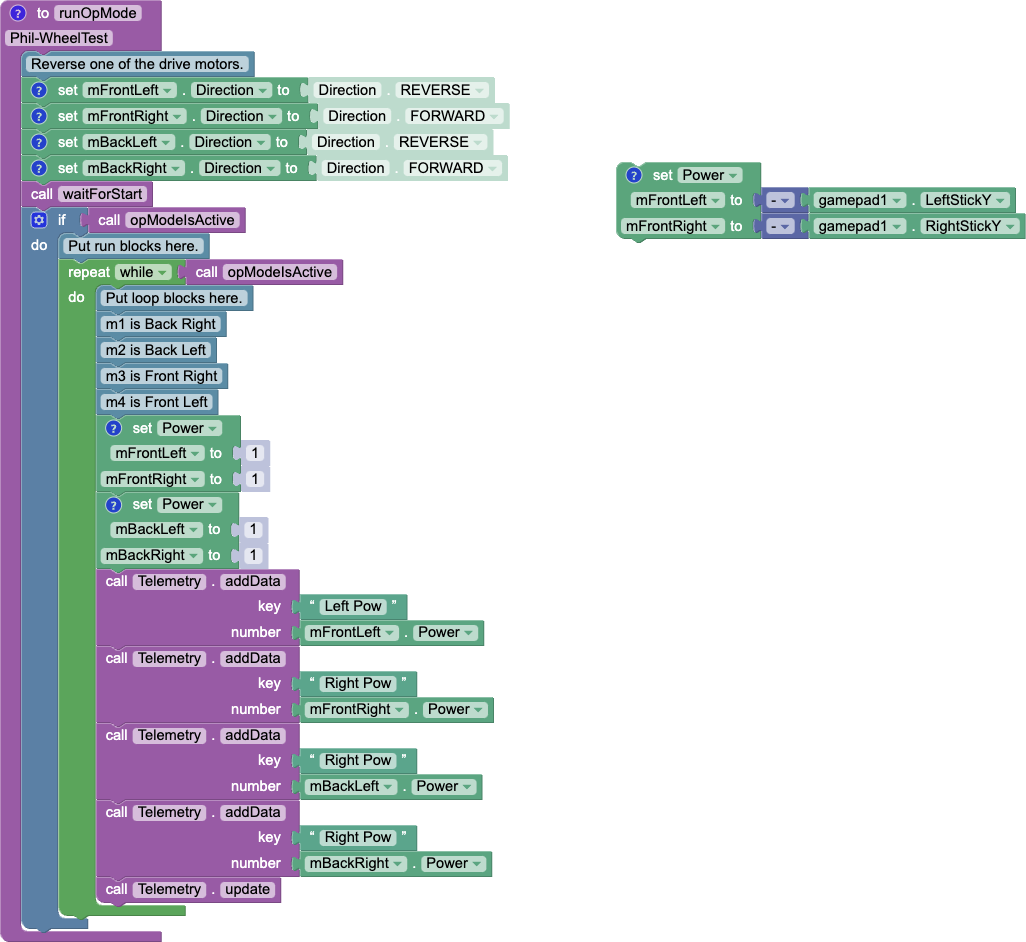
FTC/2024/Block/Phil-WheelTest.png
