dkittell/robotics-code-library/FTC/ColorTest.png

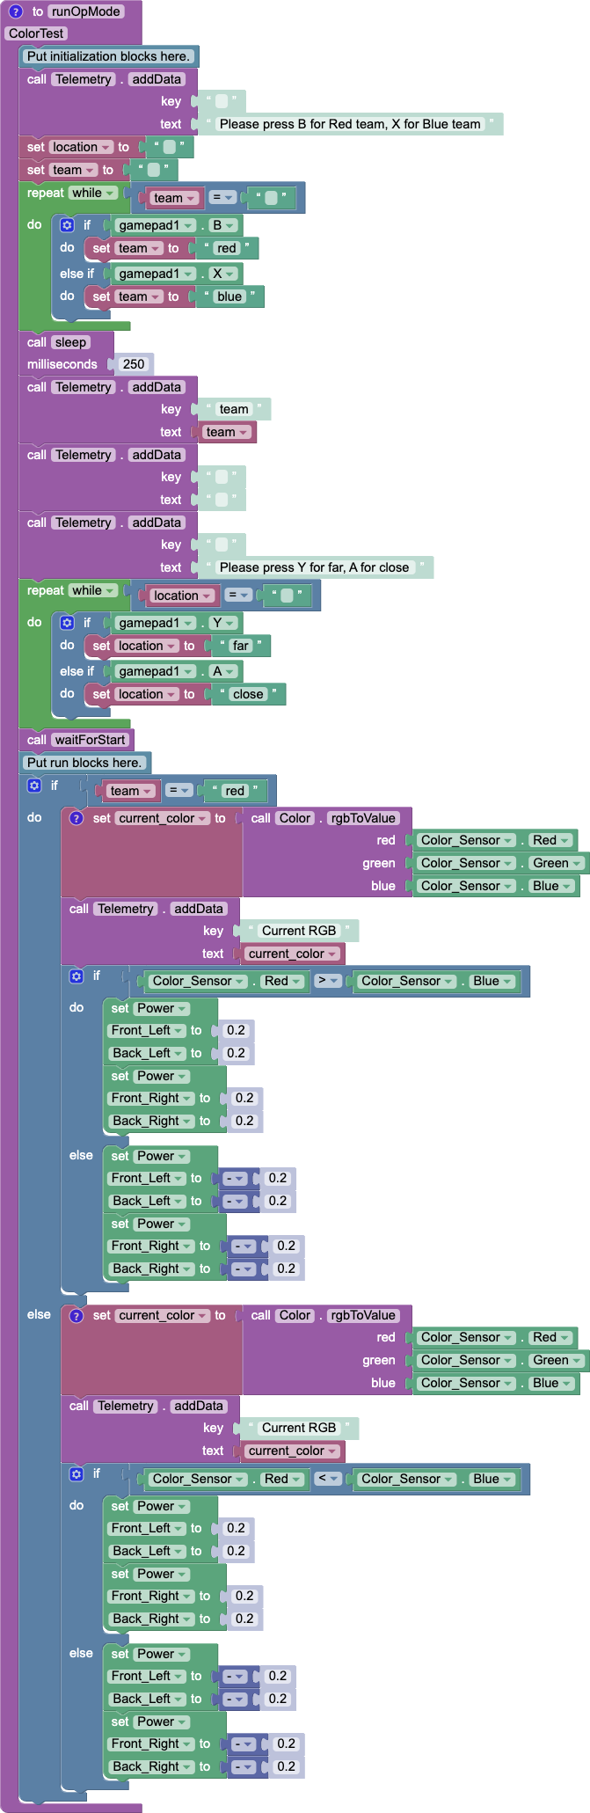
FTC/ColorTest.png
