dkittell/robotics-code-library/CAD/FRC/3DPrintedBracketforOpenMeshRadio.PDF

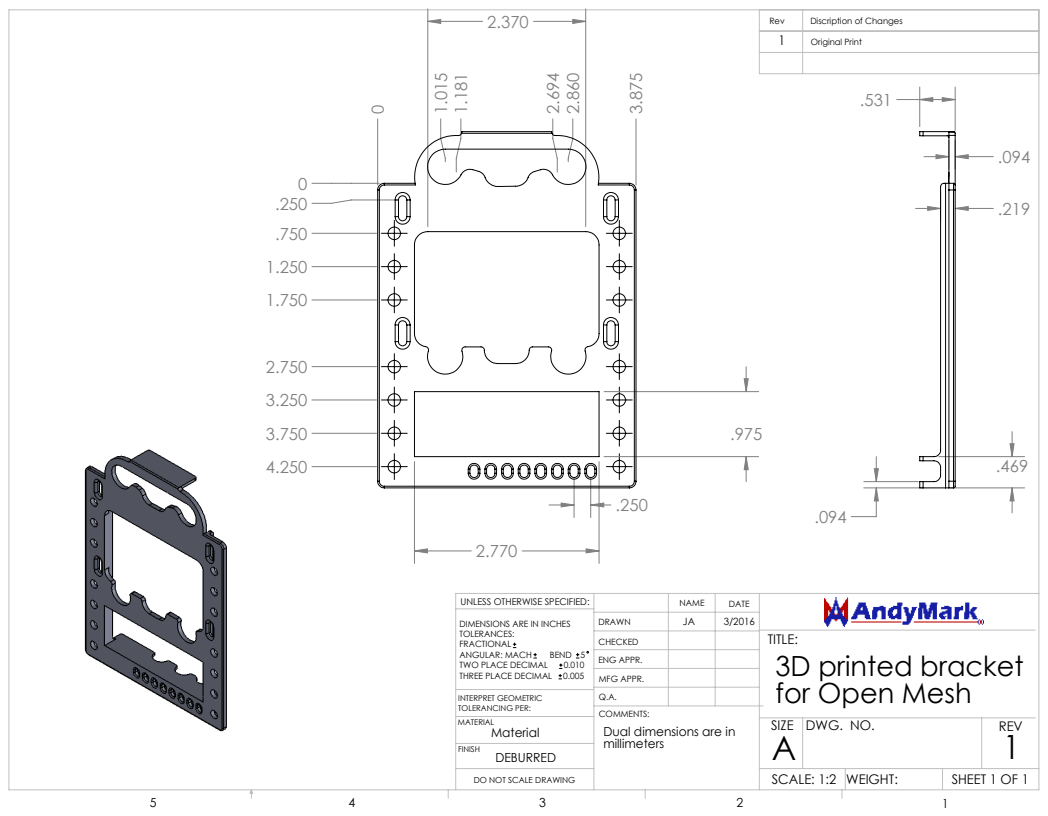
[picture p370: page 1]
3D printed bracket for Open Mesh; SHEET 1 OF 1; SCALE: 1:2 WEIGHT:; DWG. NO.; REV; INTERPRET GEOMETRIC TOLERANCING PER:; ANGULAR: MACH; BEND 5; TWO PLACE DECIMAL; Rev; Discription of Changes; Original Print

UNLESS OTHERWISE SPECIFIED:

DIMENSIONS ARE IN INCHES
TOLERANCES:
FRACTIONAL
THREE PLACE DECIMAL 0.005

DRAWN
CHECKED
ENG APPR.
MFG APPR.
COMMENTS:
Dual dimensions are in
millimeters

DO NOT SCALE DRAWING
