dkittell/robotics-code-library/FTC/2021/Images/firstforward-logos-public/Horizontal/PRINT CMYK/Full Color Reverse/FIRST_FORWARD_Logo_Horizontal_CMYK_FullColorReverse.pdf

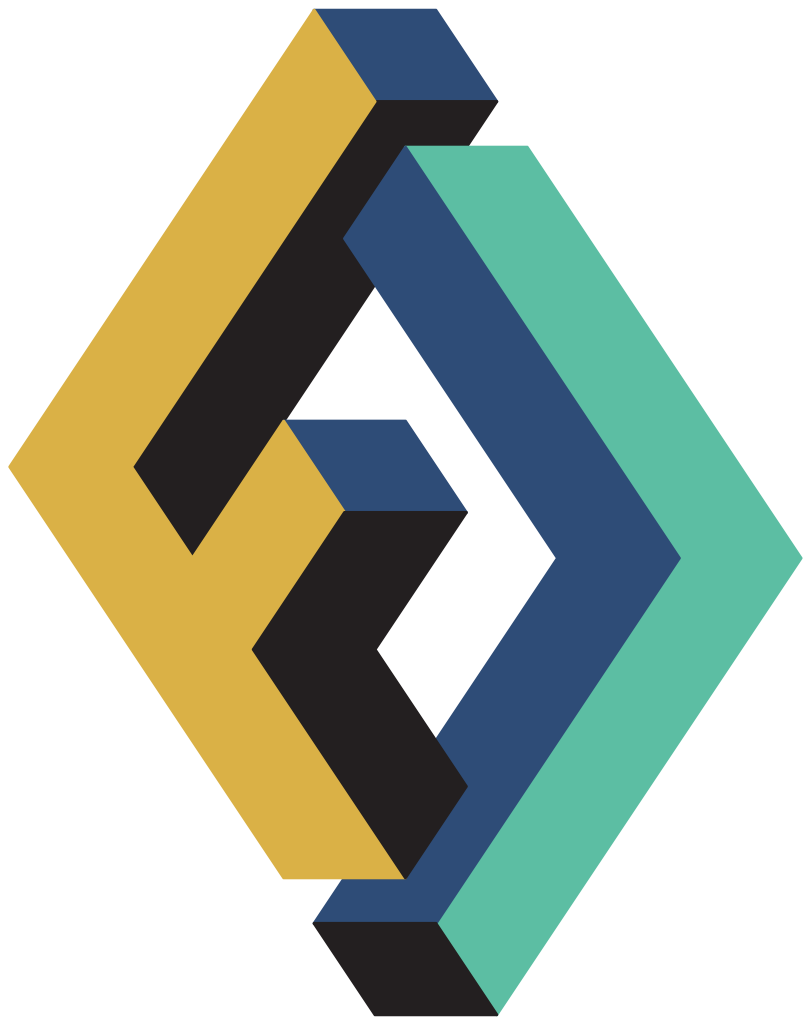
[picture p371: page 1]
