dkittell/robotics-code-library/FTC/2021/Images/firstforward-logos-public/Horizontal/PRINT CMYK/Full Color/FIRST_FORWARD_Logo_Horizontal_CMYK_FullColor.pdf

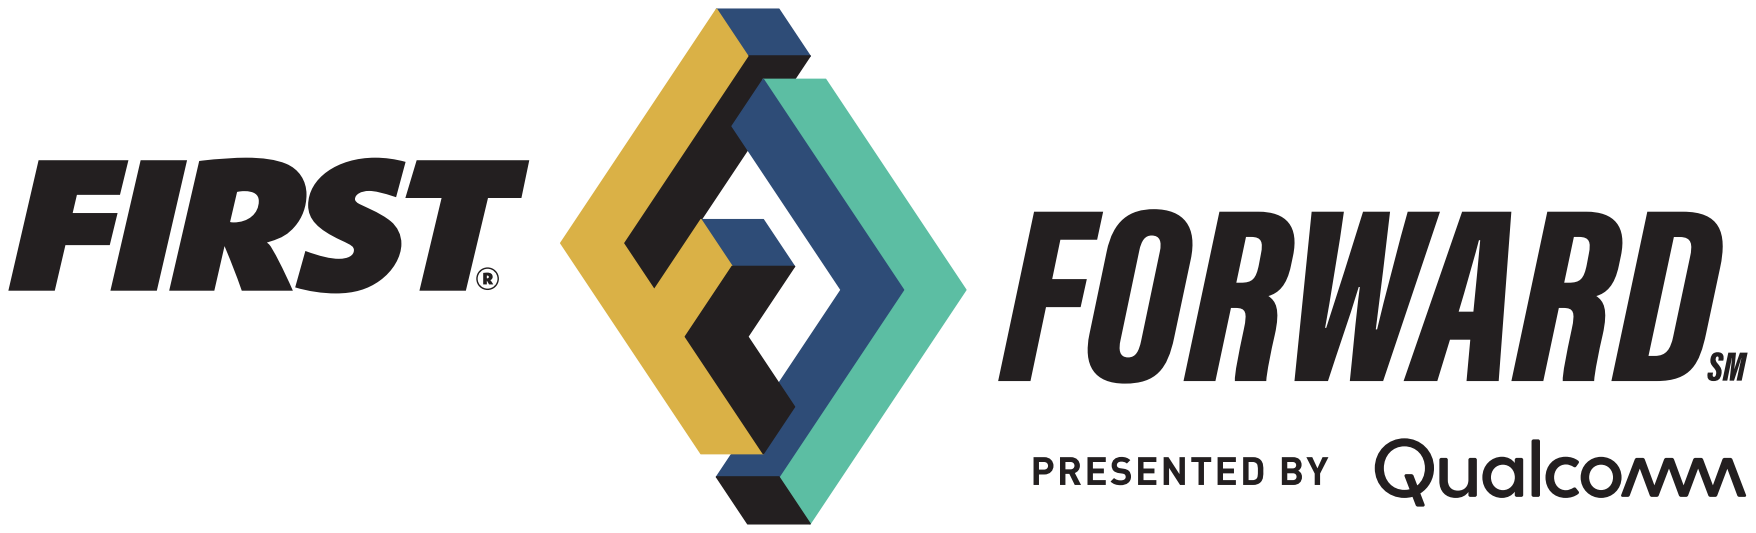
[picture p372: page 1]
