dkittell/robotics-code-library/FTC/2021/Images/firstforward-logos-public/Horizontal/PRINT CMYK/One Color/FIRST_FORWARD_Logo_Horizontal_CMYK_OneColor.pdf

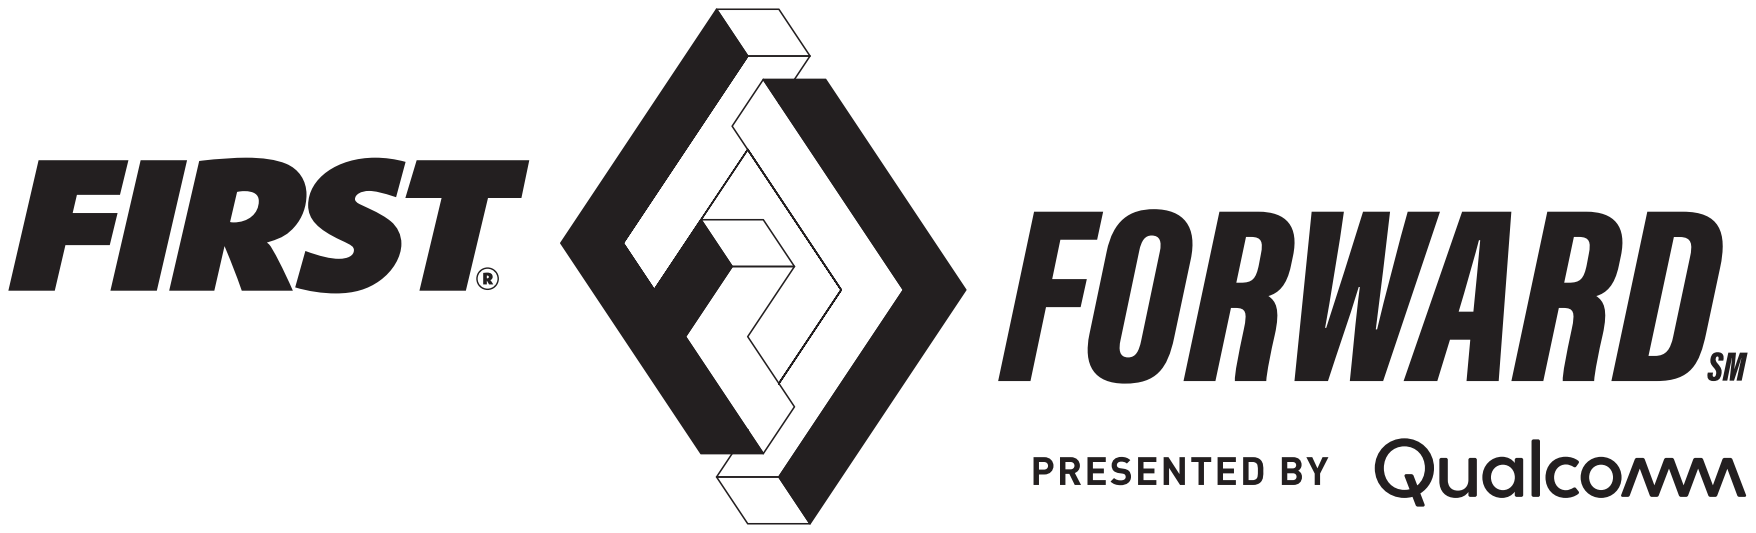
[picture p373: page 1]
