dkittell/robotics-code-library/FTC/2021/Images/firstforward-logos-public/Horizontal/PRINT PMS/Full Color Reverse/FIRST_FORWARD_Logo_Horizontal_PMS_FullColorReverse.pdf

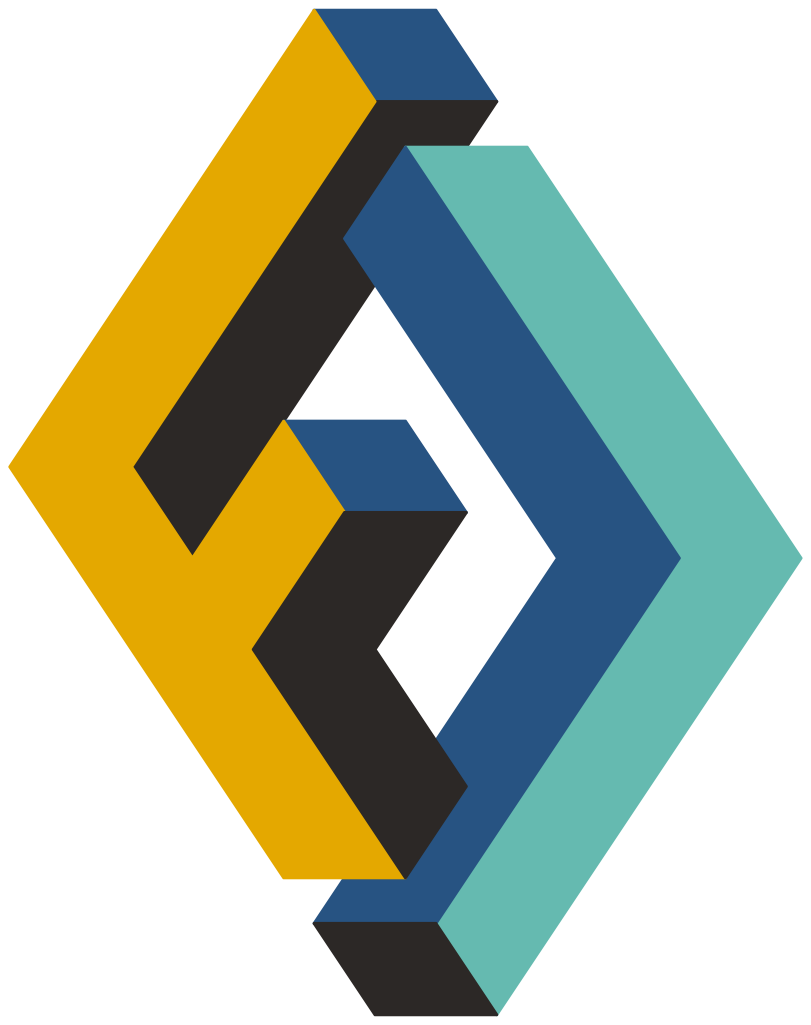
[picture p374: page 1]
