dkittell/robotics-code-library/FTC/2021/Images/firstforward-logos-public/Horizontal/PRINT PMS/Full Color/FIRST_FORWARD_Logo_Horizontal_PMS_FullColor.pdf

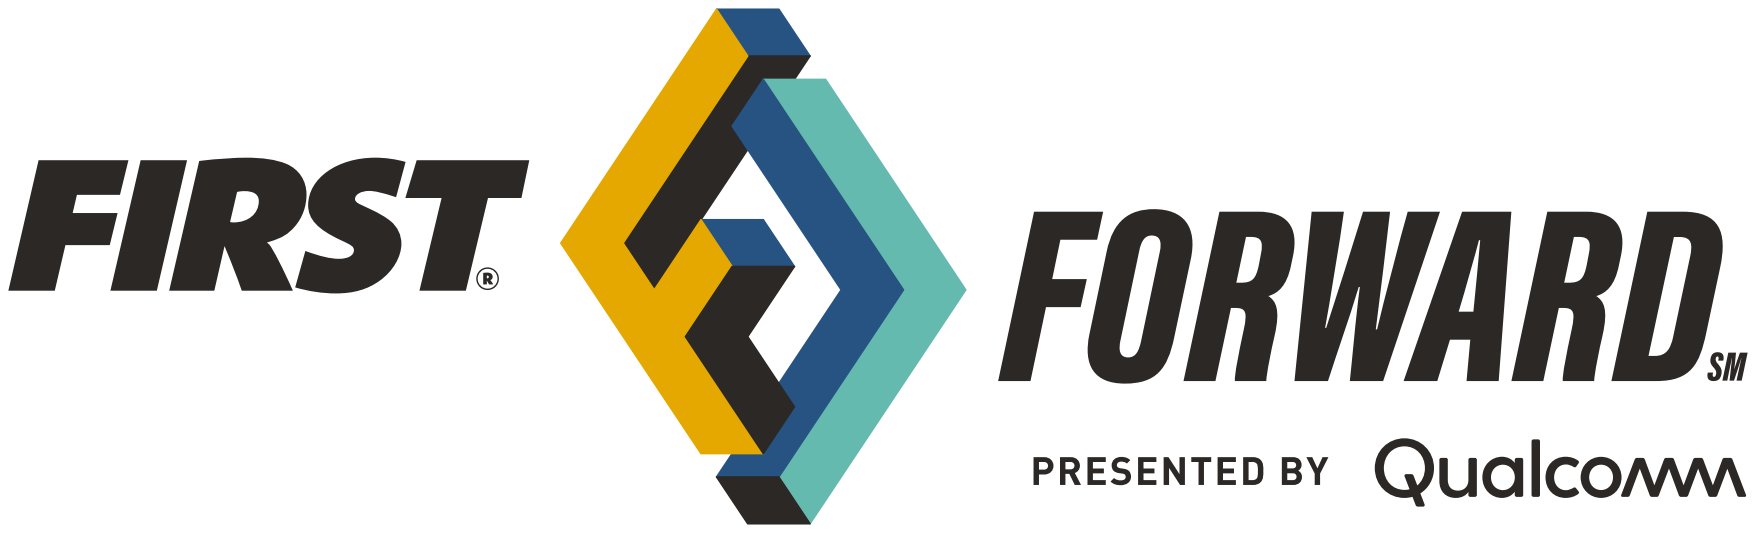
[picture p375: page 1]
