dkittell/robotics-code-library/FTC/2021/Images/firstforward-logos-public/Horizontal/PRINT PMS/One Color/FIRST_FORWARD_Logo_Horizontal_PMS_OneColor.pdf

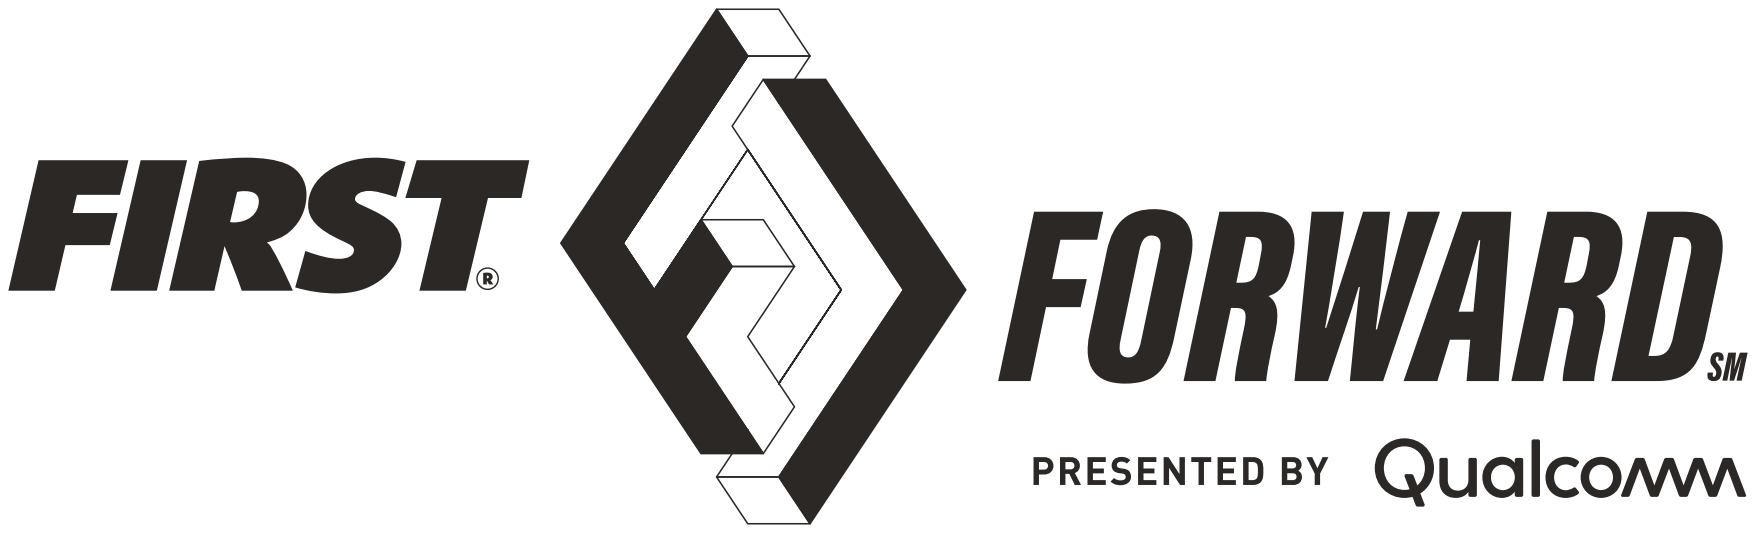
[picture p376: page 1]
