dkittell/robotics-code-library/FTC/2021/Images/firstforward-logos-public/Vertical/PRINT CMYK/Full Color Reverse/FIRST_FORWARD_Logo_Vertical_CMYK_FullColorReverse.pdf

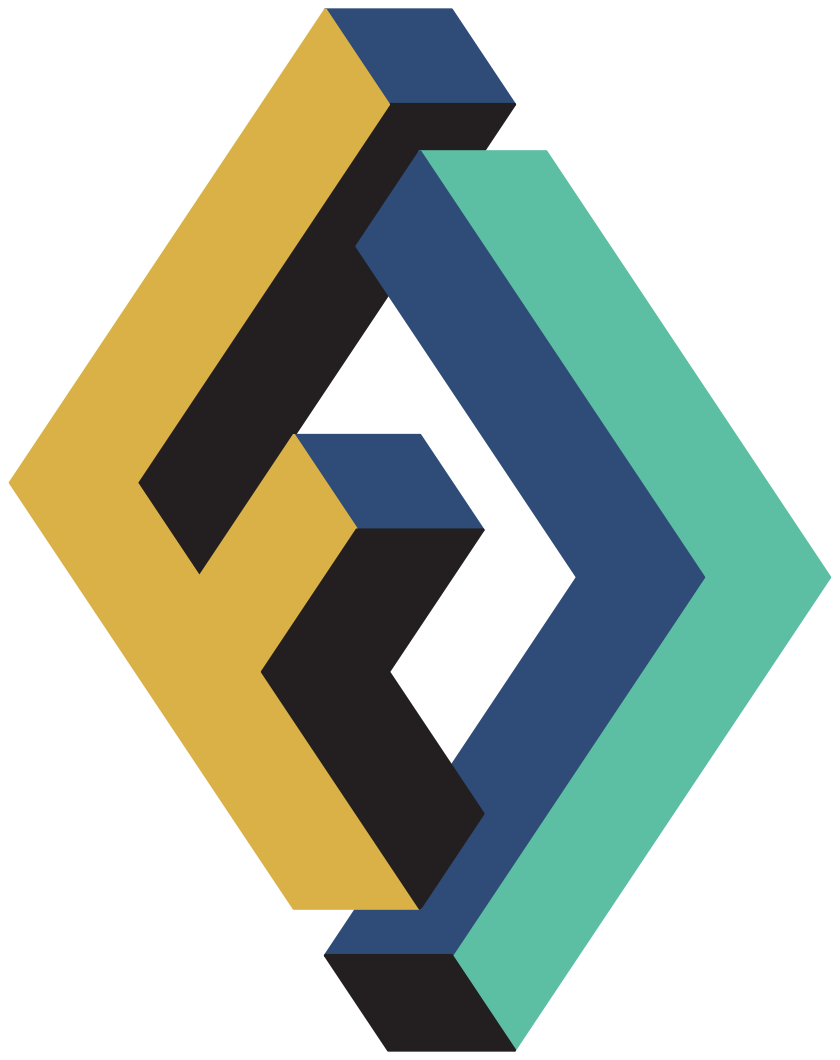
[picture p377: page 1]
