dkittell/robotics-code-library/FTC/2021/Images/firstforward-logos-public/Vertical/PRINT CMYK/Full Color/FIRST_FORWARD_Logo_Vertical_CMYK_FullColor.pdf

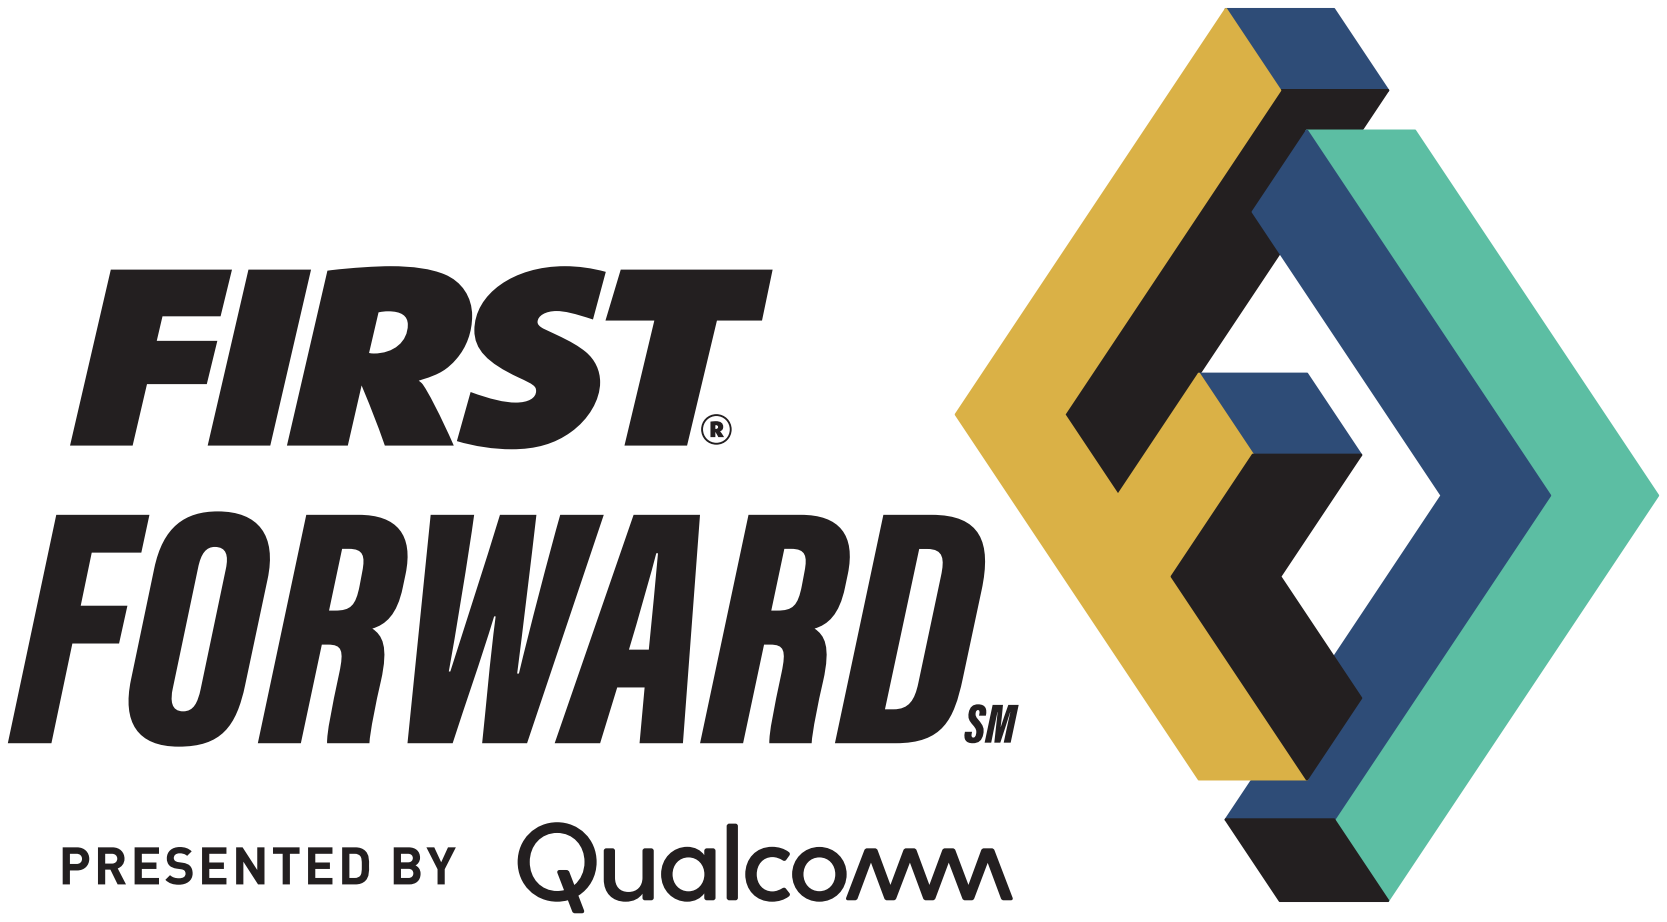
[picture p378: page 1]
