dkittell/robotics-code-library/FTC/2021/Images/firstforward-logos-public/Vertical/PRINT CMYK/One Color/FIRST_FORWARD_Logo_Vertical_CMYK_OneColor.pdf

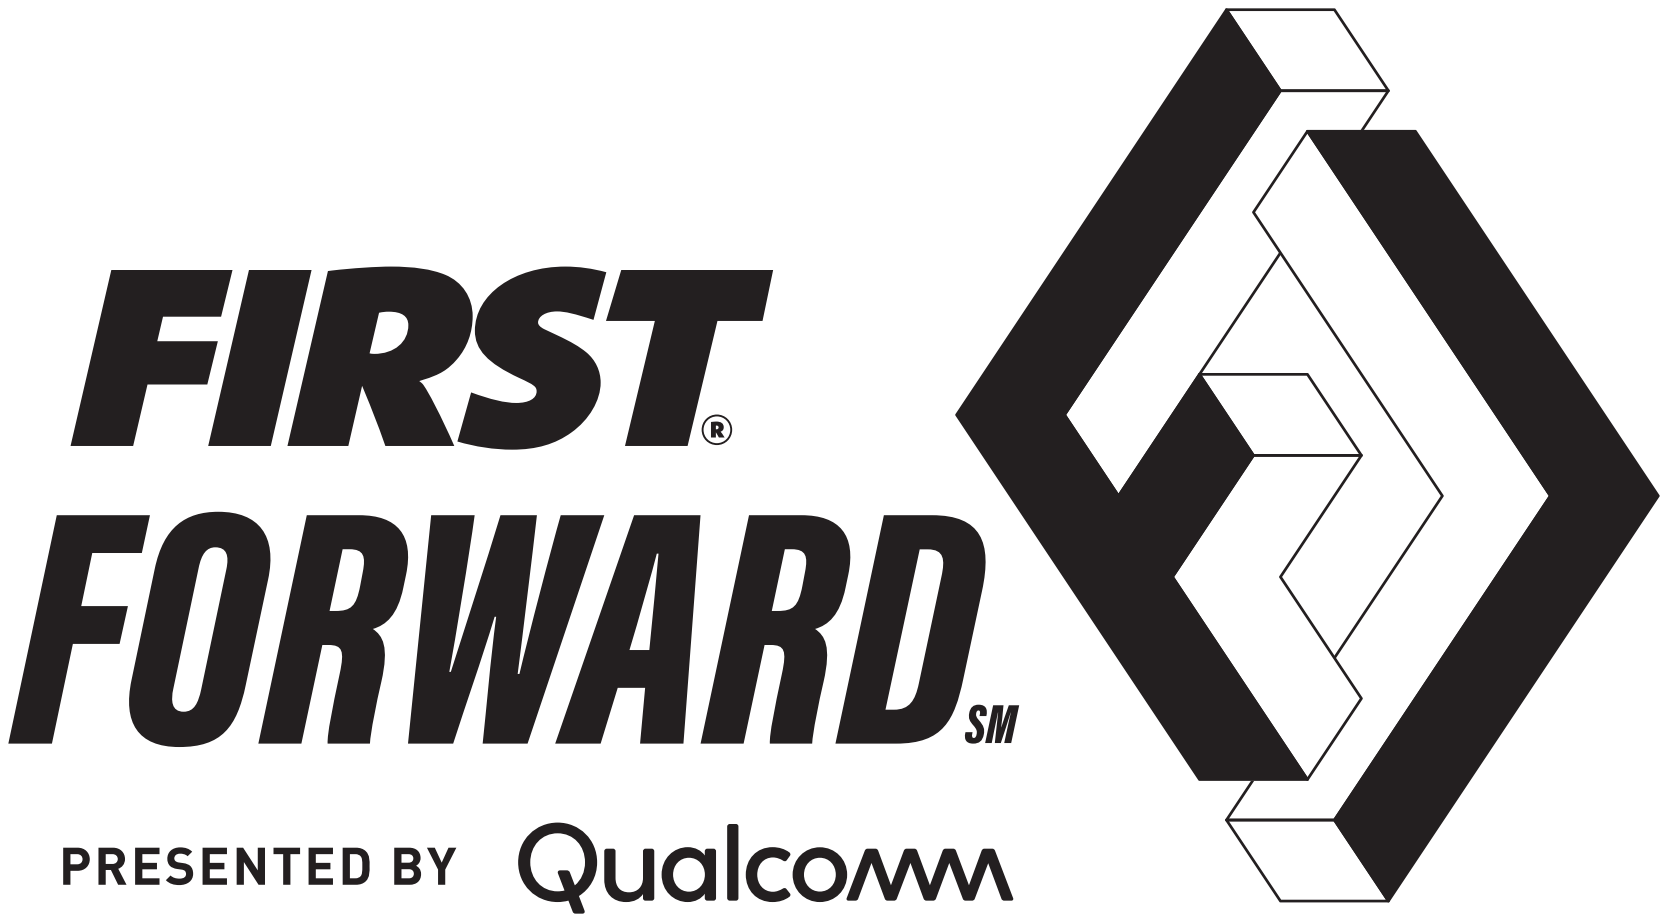
[picture p379: page 1]
