dkittell/robotics-code-library/FTC/2021/Images/firstforward-logos-public/Vertical/PRINT PMS/Full Color Reverse/FIRST_FORWARD_Logo_Vertical_PMS_FullColorReverse.pdf

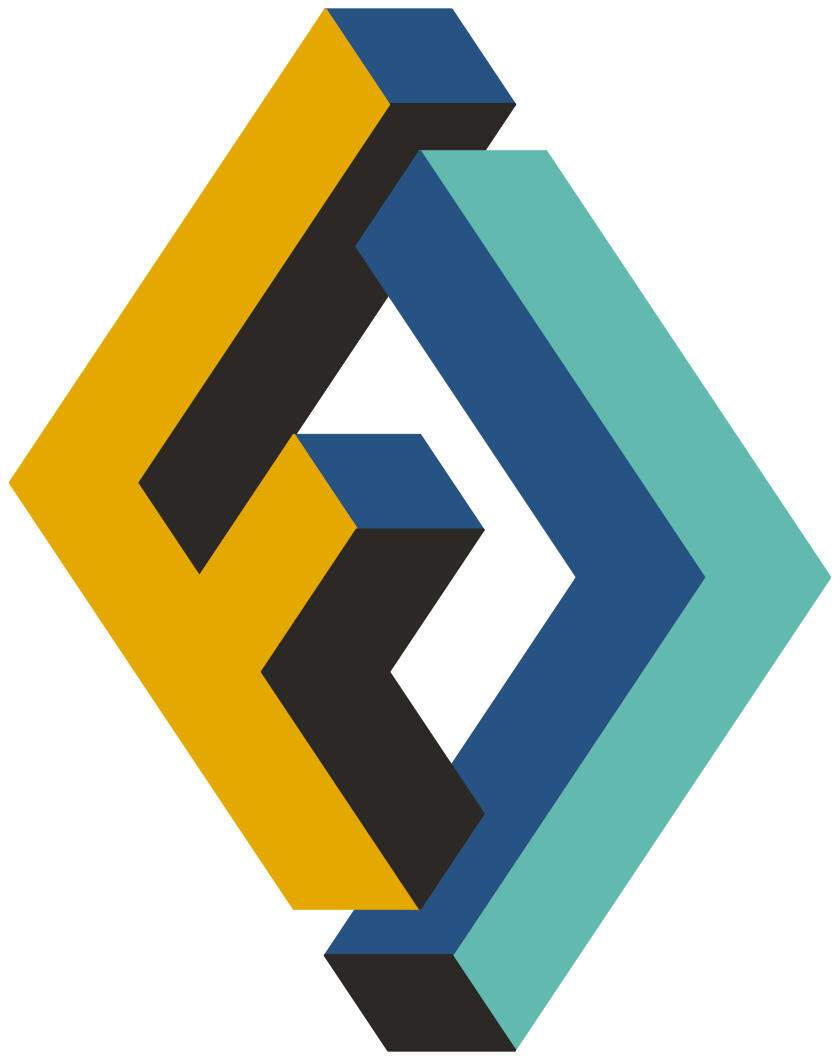
[picture p380: page 1]
