dkittell/robotics-code-library/FTC/2021/Images/firstforward-logos-public/Vertical/PRINT PMS/Full Color/FIRST_FORWARD_Logo_Vertical_PMS_FullColor.pdf

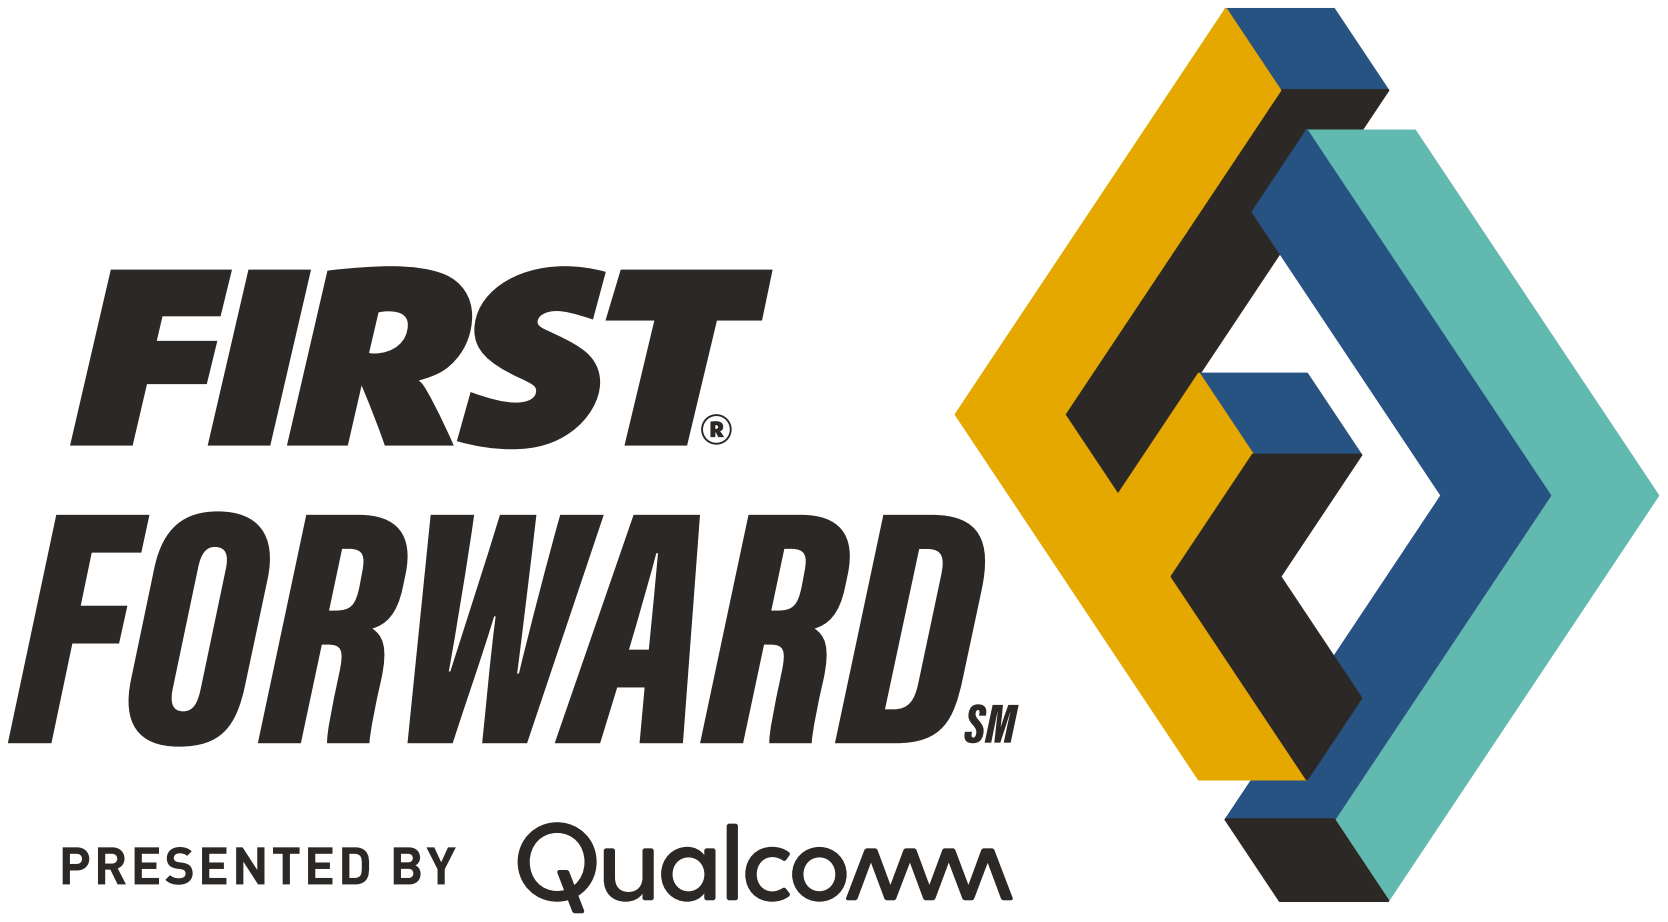
[picture p381: page 1]
