dkittell/robotics-code-library/FTC/2021/Images/firstforward-logos-public/Vertical/PRINT PMS/One Color/FIRST_FORWARD_Logo_Vertical_PMS_OneColor.pdf

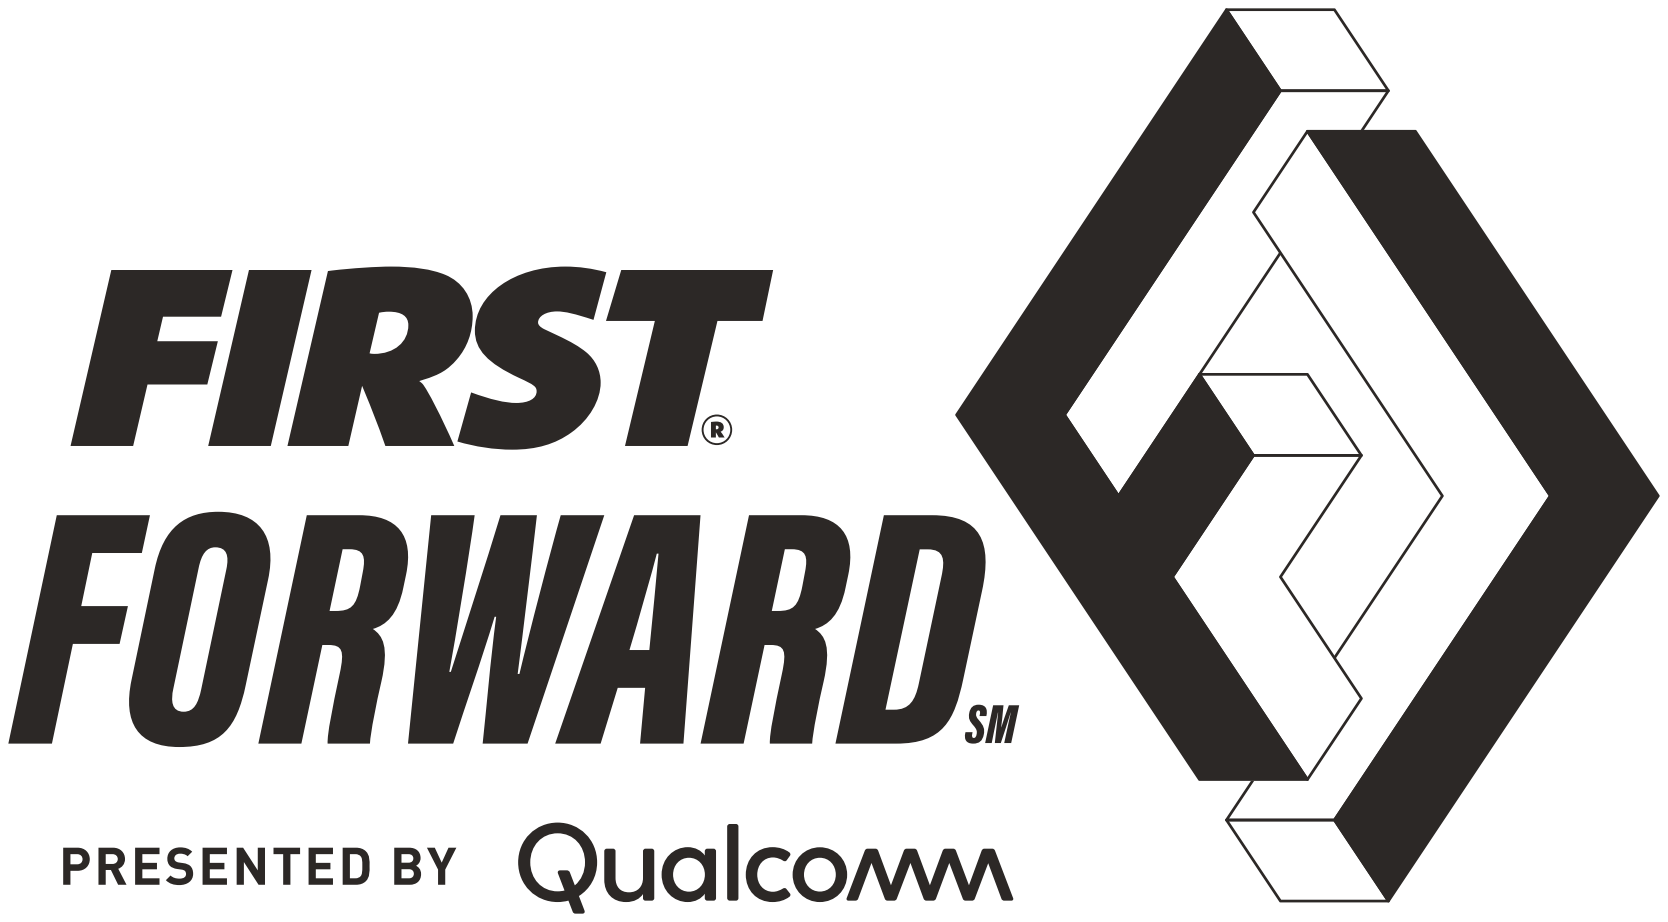
[picture p382: page 1]
