dkittell/robotics-code-library/CAD/FRC/RSL Bracket - 8711.pdf

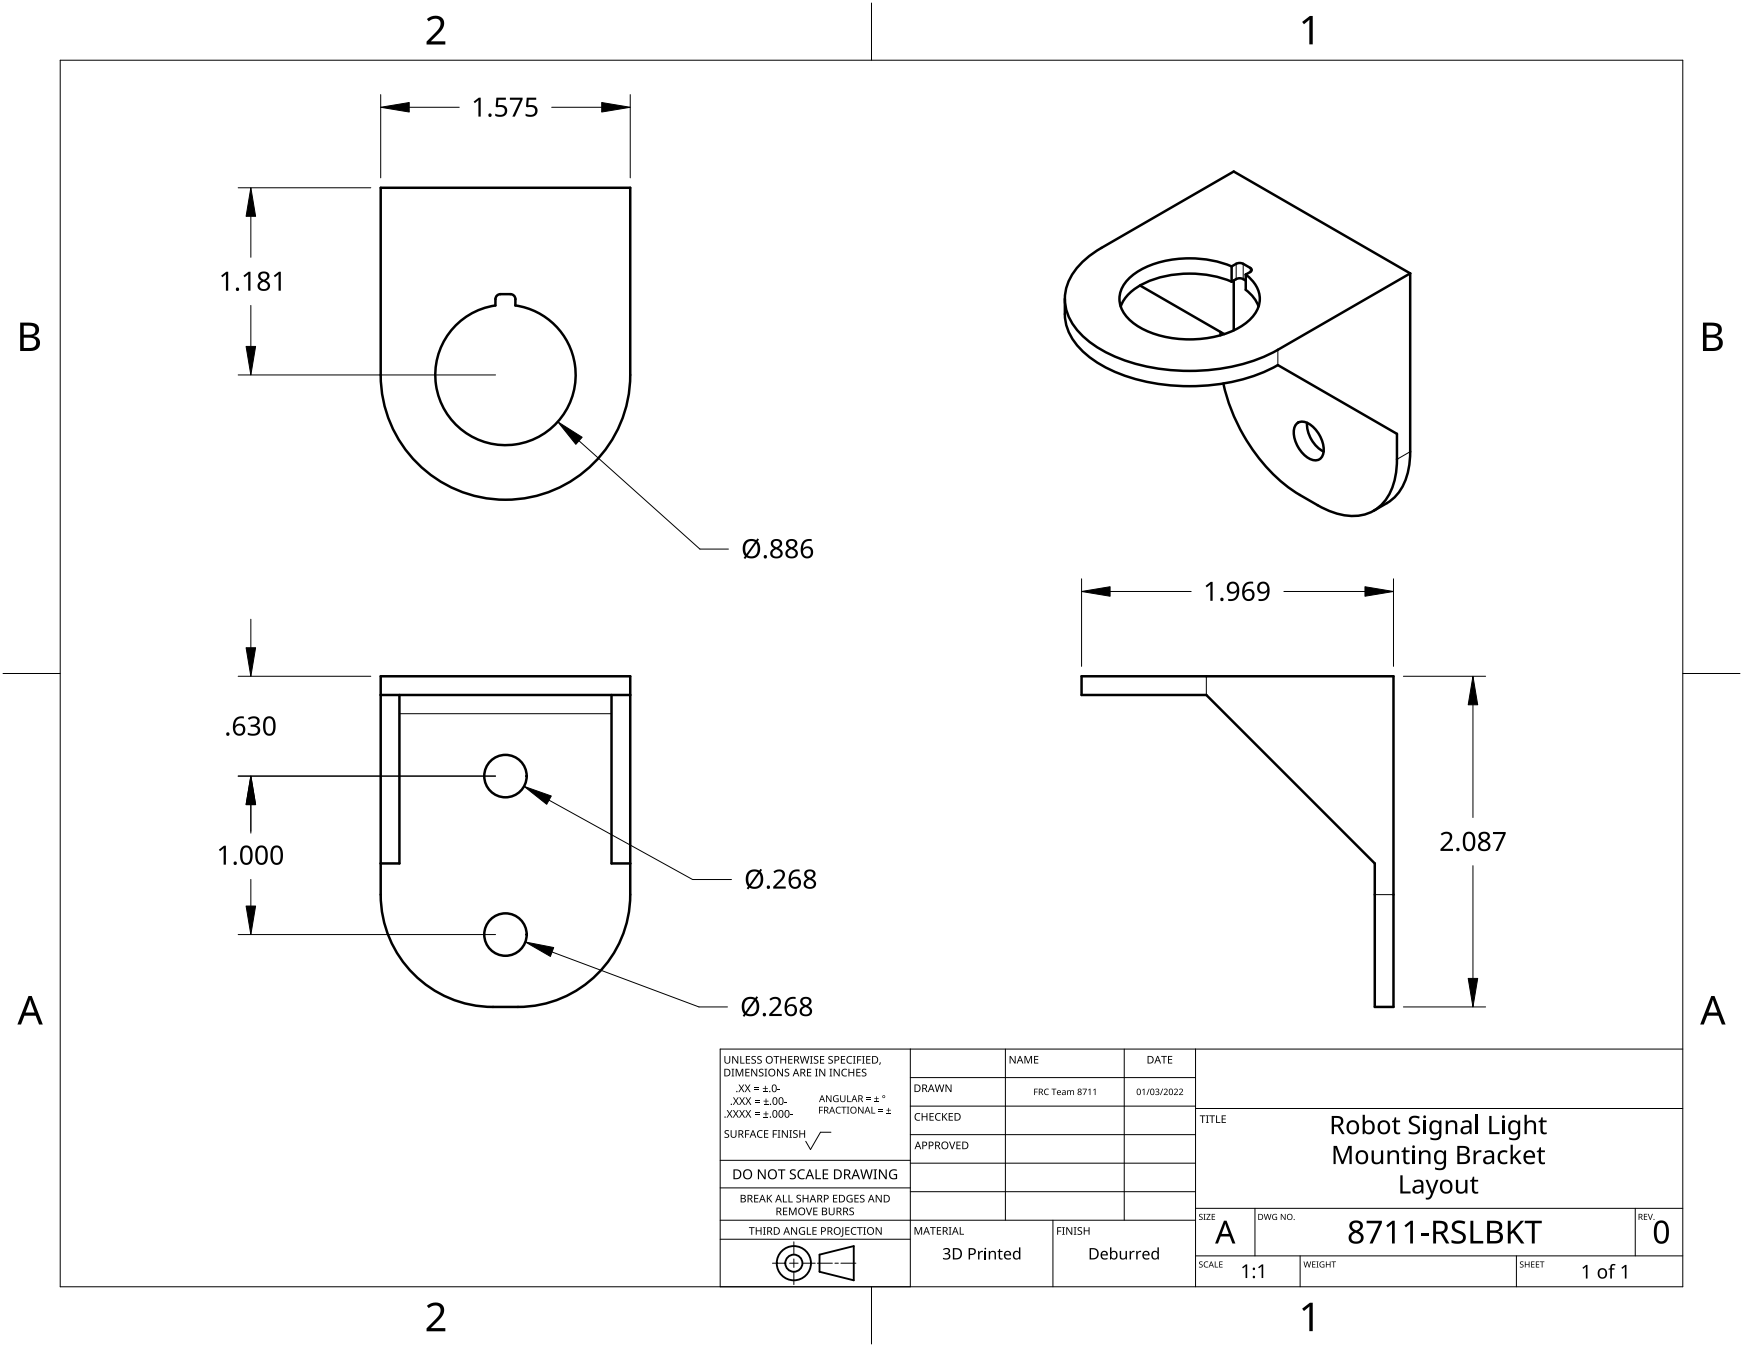
[picture p383: page 1]
