dkittell/robotics-code-library/OtherTeams/FRC3535/wip/Java/Color Sensor/src/main/java/frc/robot/Robot.java

/*----------------------------------------------------------------------------*/
/* Copyright (c) 2017-2018 FIRST. All Rights Reserved.                        */
/* Open Source Software - may be modified and shared by FRC teams. The code   */
/* must be accompanied by the FIRST BSD license file in the root directory of */
/* the project.                                                               */
/*----------------------------------------------------------------------------*/

package frc.robot;

import edu.wpi.first.wpilibj.TimedRobot;
import edu.wpi.first.wpilibj.shuffleboard.Shuffleboard;
import edu.wpi.first.wpilibj.smartdashboard.SendableChooser;
import edu.wpi.first.wpilibj.smartdashboard.SmartDashboard;
import edu.wpi.first.networktables.NetworkTableEntry;
import java.lang.Object;
// region Color Sensor
import edu.wpi.first.wpilibj.I2C;
import edu.wpi.first.wpilibj.util.Color;
import edu.wpi.first.wpilibj.util.WPILibVersion;

import com.revrobotics.ColorSensorV3;
import com.revrobotics.ColorMatchResult;
import com.revrobotics.ColorMatch;
// endregion Color Sensor

/**
 * The VM is configured to automatically run this class, and to call the
 * functions corresponding to each mode, as described in the TimedRobot
 * documentation. If you change the name of this class or the package after
 * creating this project, you must also update the build.gradle file in the
 * project.
 */
public class Robot extends TimedRobot {
  private static final String kDefaultAuto = "Default";
  private static final String kCustomAuto = "My Auto";
  private String m_autoSelected;
  private final SendableChooser<String> m_chooser = new SendableChooser<>();

  // region Color Sensor
  /**
   * Change the I2C port below to match the connection of your color sensor
   */
  private final I2C.Port i2cPort = I2C.Port.kOnboard;

  /**
   * A Rev Color Sensor V3 object is constructed with an I2C port as a parameter.
   * The device will be automatically initialized with default parameters.
   */
  private final ColorSensorV3 m_colorSensor = new ColorSensorV3(i2cPort);

  /**
   * A Rev Color Match object is used to register and detect known colors. This
   * can be calibrated ahead of time or during operation.
   * 
   * This object uses a simple euclidian distance to estimate the closest match
   * with given confidence range.
   */
  private final ColorMatch m_colorMatcher = new ColorMatch();

  /**
   * Note: Any example colors should be calibrated as the user needs, these are
   * here as a basic example.
   */
  private final Color kBlueTarget = ColorMatch.makeColor(0.143, 0.427, 0.429);
  private final Color kGreenTarget = ColorMatch.makeColor(0.197, 0.561, 0.240);
  private final Color kRedTarget = ColorMatch.makeColor(0.561, 0.232, 0.114);
  private final Color kYellowTarget = ColorMatch.makeColor(0.361, 0.524, 0.113);
  // endregion Color Sensor

  public static double h;
  public static double s;
  public static double v;

  public static double[] RGBtoHSV(double r, double g, double b) {

    double min, max, delta;

    min = Math.min(Math.min(r, g), b);
    max = Math.max(Math.max(r, g), b);

    // V
    v = max * 100;

    delta = max - min;

    // S
    if (max != 0)
      s = (delta / max) * 100;
    else {
      s = 0;
      h = -1;
      return new double[] { h, s, v };
    }

    // H
    if (r == max)
      h = (g - b) / delta; // between yellow & magenta
    else if (g == max)
      h = 2 + (b - r) / delta; // between cyan & yellow
    else
      h = 4 + (r - g) / delta; // between magenta & cyan

    h *= 60; // degrees

    if (h < 0)
      h += 360;

    return new double[] { h, s, v };
  }

  /**
   * This function is run when the robot is first started up and should be used
   * for any initialization code.
   */
  @Override
  public void robotInit() {
    m_chooser.setDefaultOption("Default Auto", kDefaultAuto);
    m_chooser.addOption("My Auto", kCustomAuto);
    SmartDashboard.putData("Auto choices", m_chooser);

    // region Color Sensor
    m_colorMatcher.addColorMatch(kBlueTarget);
    m_colorMatcher.addColorMatch(kGreenTarget);
    m_colorMatcher.addColorMatch(kRedTarget);
    m_colorMatcher.addColorMatch(kYellowTarget);
    // endregion Color Sensor
  }

  /**
   * This function is called every robot packet, no matter the mode. Use this for
   * items like diagnostics that you want ran during disabled, autonomous,
   * teleoperated and test.
   *
   * <p>
   * This runs after the mode specific periodic functions, but before LiveWindow
   * and SmartDashboard integrated updating.
   */
  @Override
  public void robotPeriodic() {

    // region Color Sensor
    /**
     * The method GetColor() returns a normalized color value from the sensor and
     * can be useful if outputting the color to an RGB LED or similar. To read the
     * raw color, use GetRawColor().
     * 
     * The color sensor works best when within a few inches from an object in well
     * lit conditions (the built in LED is a big help here!). The farther an object
     * is the more light from the surroundings will bleed into the measurements and
     * make it difficult to accurately determine its color.
     */
    Color detectedRGB = m_colorSensor.getColor();

    /**
     * Run the color match algorithm on our detected color
     */
    String colorString;
    ColorMatchResult matchRGB = m_colorMatcher.matchClosestColor(detectedRGB);

    if (matchRGB.color == kBlueTarget) {
      colorString = "Blue";
    } else if (matchRGB.color == kRedTarget) {
      colorString = "Red";
    } else if (matchRGB.color == kGreenTarget) {
      colorString = "Green";
    } else if (matchRGB.color == kYellowTarget) {
      colorString = "Yellow";
    } else {
      colorString = "Unknown";
    }

    RGBtoHSV(detectedRGB.red, detectedRGB.green, detectedRGB.blue);
    SmartDashboard.putNumber("Hue", h);
    SmartDashboard.putNumber("Saturation", s);
    SmartDashboard.putNumber("Brightness", v);

    /**
     * Open Smart Dashboard or Shuffleboard to see the color detected by the sensor.
     */
    SmartDashboard.putNumber("Red", detectedRGB.red * 255);
    SmartDashboard.putNumber("Green", detectedRGB.green * 255);
    SmartDashboard.putNumber("Blue", detectedRGB.blue * 255);
    SmartDashboard.putNumber("Confidence", matchRGB.confidence * 100);
    SmartDashboard.putString("Detected Color", colorString);

    

    // Shuffleboard.getTab("SmartDashboard")
    // .add("Detected Color", false)
    // .withWidget("Boolean Box")
    // .withProperties(Map.of("colorWhenTrue", "green", "colorWhenFalse", "maroon"))
    // .getEntry();

   

    // endregion Color Sensor
  }

  /**
   * This autonomous (along with the chooser code above) shows how to select
   * between different autonomous modes using the dashboard. The sendable chooser
   * code works with the Java SmartDashboard. If you prefer the LabVIEW Dashboard,
   * remove all of the chooser code and uncomment the getString line to get the
   * auto name from the text box below the Gyro
   *
   * <p>
   * You can add additional auto modes by adding additional comparisons to the
   * switch structure below with additional strings. If using the SendableChooser
   * make sure to add them to the chooser code above as well.
   */
  @Override
  public void autonomousInit() {
    m_autoSelected = m_chooser.getSelected();
    // m_autoSelected = SmartDashboard.getString("Auto Selector", kDefaultAuto);
    System.out.println("Auto selected: " + m_autoSelected);
  }

  /**
   * This function is called periodically during autonomous.
   */
  @Override
  public void autonomousPeriodic() {
    switch (m_autoSelected) {
    case kCustomAuto:
      // Put custom auto code here
      break;
    case kDefaultAuto:
    default:
      // Put default auto code here
      break;
    }
  }

  /**
   * This function is called periodically during operator control.
   */
  @Override
  public void teleopPeriodic() {
    Shuffleboard.startRecording();

  }

  /**
   * This function is called periodically during test mode.
   */
  @Override
  public void testPeriodic() {
  }

  @Override
  public void disabledInit() {
  }

  @Override
  public void disabledPeriodic() {
    Shuffleboard.stopRecording();
  }
}
