dkittell/robotics-code-library/OtherTeams/FRC3535/wip/Java/Pneumatics/src/main/java/frc/robot/Robot.java

/*----------------------------------------------------------------------------*/
/* Copyright (c) 2017-2019 FIRST. All Rights Reserved.                        */
/* Open Source Software - may be modified and shared by FRC teams. The code   */
/* must be accompanied by the FIRST BSD license file in the root directory of */
/* the project.                                                               */
/*----------------------------------------------------------------------------*/

package frc.robot;

import edu.wpi.first.wpilibj.Compressor;
import edu.wpi.first.wpilibj.DoubleSolenoid;
import edu.wpi.first.wpilibj.Joystick;
import edu.wpi.first.wpilibj.Solenoid;
import edu.wpi.first.wpilibj.TimedRobot;
import edu.wpi.first.wpilibj.smartdashboard.SmartDashboard;

/**
 * This is a sample program showing the use of the solenoid classes during
 * operator control. Three buttons from a joystick will be used to control two
 * solenoids: One button to control the position of a single solenoid and the
 * other two buttons to control a double solenoid. Single solenoids can either
 * be on or off, such that the air diverted through them goes through either one
 * channel or the other. Double solenoids have three states: Off, Forward, and
 * Reverse. Forward and Reverse divert the air through the two channels and
 * correspond to the on and off of a single solenoid, but a double solenoid can
 * also be "off", where the solenoid will remain in its default power off state.
 * Additionally, double solenoids take up two channels on your PCM whereas
 * single solenoids only take a single channel.
 */

public class Robot extends TimedRobot {
  private final Joystick m_stick = new Joystick(0);

  // // Solenoid corresponds to a single solenoid.
  // private final Solenoid m_solenoid = new Solenoid(0);

  // // DoubleSolenoid corresponds to a double solenoid.
  // private final DoubleSolenoid m_doubleSolenoid = new DoubleSolenoid(1, 2);

  private final Compressor compressor = new Compressor(0);
  // private static final int kSolenoidButton = 1;
  // private static final int kDoubleSolenoidForward = 2;
  // private static final int kDoubleSolenoidReverse = 3;

  @Override
  public void robotInit() {
    // TODO Auto-generated method stub
    super.robotInit();
    compressor.clearAllPCMStickyFaults();
    compressor.setClosedLoopControl(true);

  }
 @Override
  public void robotPeriodic() {
    // TODO Auto-generated method stub
    super.robotPeriodic();
     // Compressor Stats
     compressor.enabled();
     compressor.start();
     boolean pressureSwitch = compressor.getPressureSwitchValue();
     double CompressorCurrent = compressor.getCompressorCurrent();
     SmartDashboard.putNumber("Compressor Current", CompressorCurrent);
     SmartDashboard.putBoolean("Pressure Switch", pressureSwitch);
  
  }

  @Override
  public void teleopPeriodic() {
    /*
     * The output of GetRawButton is true/false depending on whether the button is
     * pressed; Set takes a boolean for whether to use the default (false) channel
     * or the other (true).
     */
    // m_solenoid.set(m_stick.getRawButton(kSolenoidButton));

    /*
     * In order to set the double solenoid, if just one button is pressed, set the
     * solenoid to correspond to that button. If both are pressed, set the solenoid
     * will be set to Forwards.
     */
    // if (m_stick.getRawButton(kDoubleSolenoidForward)) {
    //   m_doubleSolenoid.set(DoubleSolenoid.Value.kForward);
    // } else if (m_stick.getRawButton(kDoubleSolenoidReverse)) {
    //   m_doubleSolenoid.set(DoubleSolenoid.Value.kReverse);
    // }
  }
}
