dkittell/robotics-code-library/FRC/Robot/2023/Gyro_Mecanum/src/main/java/frc/robot/Robot.java

// Copyright (c) FIRST and other WPILib contributors.
// Open Source Software; you can modify and/or share it under the terms of
// the WPILib BSD license file in the root directory of this project.

package frc.robot;

import edu.wpi.first.wpilibj.AnalogGyro;
import edu.wpi.first.wpilibj.Joystick;
import edu.wpi.first.wpilibj.TimedRobot;
import edu.wpi.first.wpilibj.drive.MecanumDrive;
import edu.wpi.first.wpilibj.motorcontrol.PWMSparkMax;

/**
 * This is a sample program that uses mecanum drive with a gyro sensor to maintain rotation vectors
 * in relation to the starting orientation of the robot (field-oriented controls).
 */
public class Robot extends TimedRobot {
  // gyro calibration constant, may need to be adjusted;
  // gyro value of 360 is set to correspond to one full revolution
  private static final double kVoltsPerDegreePerSecond = 0.0128;

  private static final int kFrontLeftChannel = 0;
  private static final int kRearLeftChannel = 1;
  private static final int kFrontRightChannel = 2;
  private static final int kRearRightChannel = 3;
  private static final int kGyroPort = 0;
  private static final int kJoystickPort = 0;

  private MecanumDrive m_robotDrive;
  private final AnalogGyro m_gyro = new AnalogGyro(kGyroPort);
  private final Joystick m_joystick = new Joystick(kJoystickPort);

  @Override
  public void robotInit() {
    PWMSparkMax frontLeft = new PWMSparkMax(kFrontLeftChannel);
    PWMSparkMax rearLeft = new PWMSparkMax(kRearLeftChannel);
    PWMSparkMax frontRight = new PWMSparkMax(kFrontRightChannel);
    PWMSparkMax rearRight = new PWMSparkMax(kRearRightChannel);

    // Invert the right side motors.
    // You may need to change or remove this to match your robot.
    frontRight.setInverted(true);
    rearRight.setInverted(true);

    m_robotDrive = new MecanumDrive(frontLeft, rearLeft, frontRight, rearRight);

    m_gyro.setSensitivity(kVoltsPerDegreePerSecond);
  }

  /** Mecanum drive is used with the gyro angle as an input. */
  @Override
  public void teleopPeriodic() {
    m_robotDrive.driveCartesian(
        -m_joystick.getY(), -m_joystick.getX(), -m_joystick.getZ(), m_gyro.getRotation2d());
  }
}
