dkittell/robotics-code-library/FTC/2023/19436/java/src/org/firstinspires/ftc/teamcode/MerryGoRound10.java

package org.firstinspires.ftc.teamcode;

import com.qualcomm.robotcore.eventloop.opmode.LinearOpMode;
import com.qualcomm.robotcore.eventloop.opmode.TeleOp;
import com.qualcomm.robotcore.hardware.CRServo;
import com.qualcomm.robotcore.hardware.DcMotorSimple;

@TeleOp(name = "MerryGoRound10 (Blocks to Java)")
public class MerryGoRound10 extends LinearOpMode {

  private CRServo carousel_motor;

  /**
   * This function is executed when this Op Mode is selected from the Driver Station.
   */
  @Override
  public void runOpMode() {
    carousel_motor = hardwareMap.get(CRServo.class, "carousel_motor");

    // Put initialization blocks here.
    waitForStart();
    if (opModeIsActive()) {
      // Put run blocks here.
      while (opModeIsActive()) {
        while (gamepad1.dpad_right) {
          // Put loop blocks here.
          carousel_motor.setPower(2000);
          carousel_motor.setDirection(DcMotorSimple.Direction.FORWARD);
        }
        while (!gamepad1.dpad_left) {
          carousel_motor.setDirection(DcMotorSimple.Direction.REVERSE);
          carousel_motor.setPower(20);
        }
        telemetry.update();
      }
    }
  }
}
