dkittell/robotics-code-library/(commit log)

2025-03-22 initial add
    [2013 Code Parameters.csv, 2020_Adj._Slider_Body.stl, 2020_Adj._Slider_Cutter.stl, 2020_Adj._Slider_Inner.stl, 2020_Adj._Slider_Lid.stl, 2020_Adj_Slider2.skp, 2020_Robot.xml, 3DPrintedBracketforOpenMeshRadio.STEP]
2025-03-22 Ignoring .DS_Store Files
    [Battery_Holder.stl, Battery_Holder_Lid.stl, Battery_Holder_Side_Load.stl, Battery_Holder_Top_Load.stl, Batterypack.stl, assembled-do-not-print.stl, circle.stl, minn_Bill.stl]
2025-03-22 updated list
    [2024 robot idea 2.0.SLDPRT, 2024 robot idea.SLDPRT, 20T 20DP Steel - 1-2- Hex Bore Gear (REV-21-1921) (1).stl, 22x2x1 Beam.SLDPRT, 60T 20DP Steel - 1-2- Hex Bore Gear (REV-21-1941) (1).stl, Assem1.sparkbox-Part1-1.STL, Assem1.sparkbox-Part2-1.STL, BackV3.stl]
